zip1982b/my_home/img/2025-02-13_19-43-22.png

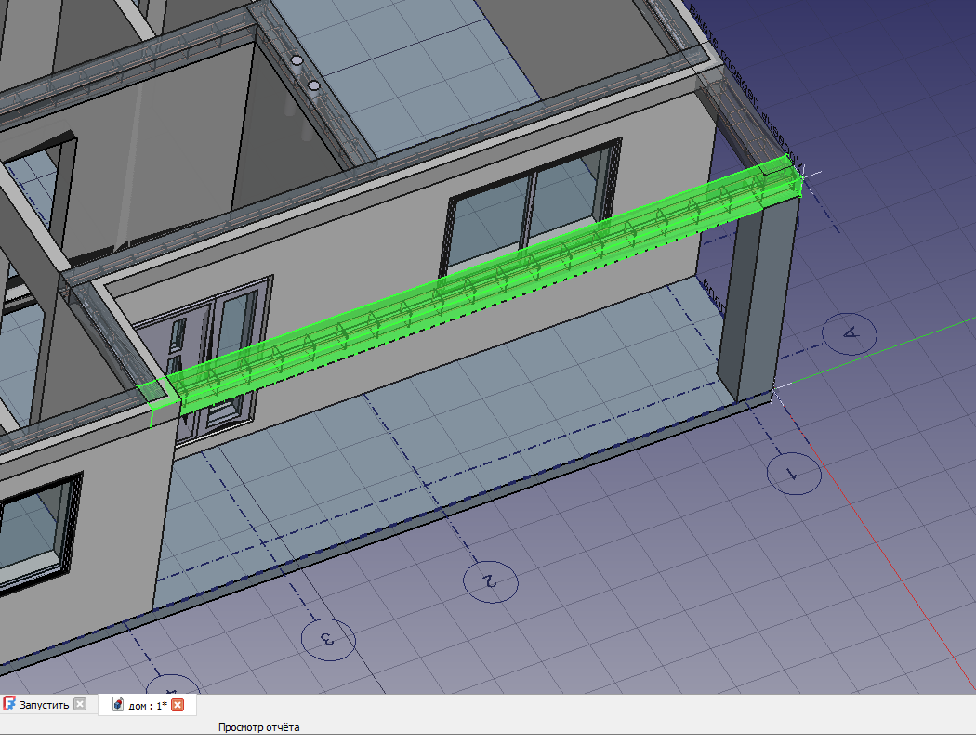
img/2025-02-13_19-43-22.png
