zip1982b/my_home/img/4-1000x1000.jpg

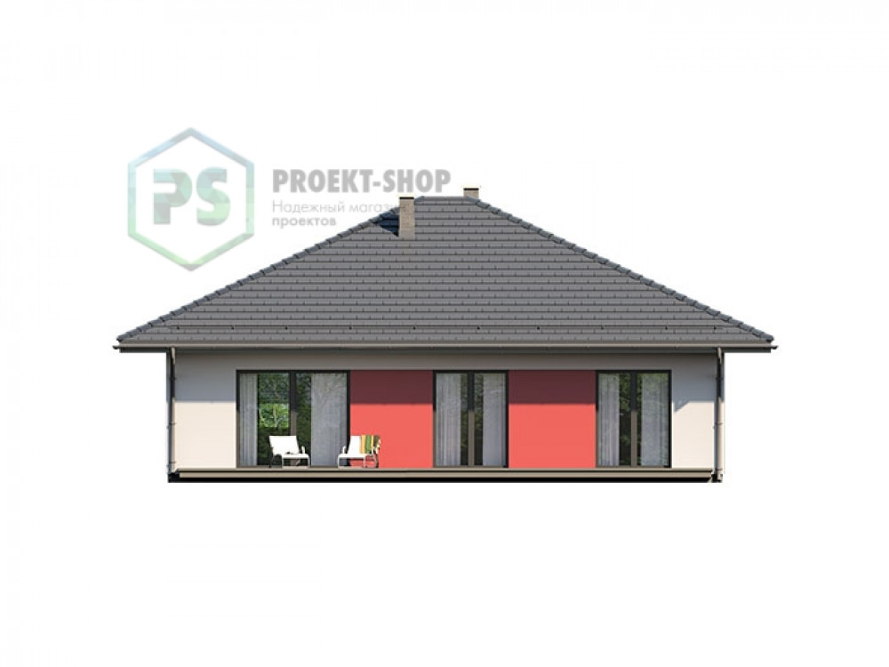
img/4-1000x1000.jpg
