zip1982b/my_home/отопление.docx

с чего начать проектирование системы отопления для одноэтажного дома площадью 139,2 м2 и газовым двухконтурным котлом мощностью 24 КВт? Планируется использовать батарейное отопление в количестве 9 шт по схеме лучевой и теплый пол. Так же в качестве труб для батарейного отопления планируется использовать металопластик. Для теплого пола турба PERT. Дом из газобетона D500 шириной 300 мм. Утеплён пеноплистеролом толщиной 100 мм по системе мокрый фасад.

Проектирование системы отопления всегда начинается с расчета теплопотерь дома. Без этого шага невозможно правильно подобрать длину петель теплого пола и количество секций (или размеры) радиаторов.

Ваш котел мощностью 24 кВт выбран с большим запасом (для дома 139,2 м² с хорошим утеплением обычно достаточно 12–14 кВт), но для двухконтурного котла это стандарт, так как избыточная мощность нужна для быстрого нагрева горячей воды (ГВС).

Ниже представлен пошаговый план, с чего начать и как правильно организовать проектирование.

1. Расчет теплопотерь здания

Хотя стены из газобетона D500 (300 мм) с утеплением пенополистиролом (100 мм) хорошо удерживают тепло, нужно посчитать точные потери через:

- Стены, окна и входные двери.
- Пол (фундамент) и потолок (чердачное перекрытие).
- Вентиляцию (инфильтрацию воздуха).

Результат шага: Вы узнаете, сколько Ватт тепла теряет каждая конкретная комната в самую холодную пятидневку зимы.

2. Проектирование теплого пола и радиаторов

Зная теплопотери каждой комнаты, распределяем нагрузку между теплым полом (ТП) и радиаторами:

- Теплый пол (труба PERT): Рассчитайте шаг укладки (обычно 150 мм, в рантовых зонах у окон — 100 мм). Учтите, что по санитарным нормам температура поверхности пола в жилых зонах не должна превышать 26–29°C. Если тепла от пола не хватает для покрытия теплопотерь комнаты, остаток «добирают» радиаторами.
- Радиаторы (9 шт, металлопластик): Подберите размер каждого радиатора так, чтобы он покрывал дефицит тепла в своей зоне. При лучевой схеме к каждой батарее идет своя независимая пара труб (подача и обратка).

3. Гидравлический расчет и подбор оборудования

Так как у вас комбинированная система (радиаторы + ТП), они работают на разных температурных режимах:

- Радиаторам нужно, например, 60–70°C.
- В теплый пол нельзя подавать больше 40–45°C.

Вам обязательно понадобятся:

- Коллекторный узел для радиаторов: Сюда сойдутся все 9 лучей из металлопластика.
- Коллекторный узел для теплого пола с насосно-смесительным узлом (трехходовым клапаном): Он будет подмешивать остывшую воду из обратки теплого пола в подачу, чтобы снизить температуру до безопасной для стяжки.
- Гидрострелка или балансировочный коллектор: Встроенный насос котла 24 кВт может не справиться с протоком и радиаторов, и контуров теплого пола одновременно. Смесительный узел ТП потребует своего отдельного насоса. Чтобы насосы не конфликтовали, их контуры разделяют.

4. Трассировка и создание схемы

- Нанесите на план дома места установки котла (котельной) и коллекторных шкафов (желательно расположить их по центру дома, чтобы длины лучей были примерно одинаковыми).
- Наметьте трассы раскладки труб ТП (длина одной петли PERT 16 мм не должна превышать 80–100 метров, иначе насосу будет тяжело продавить теплоноситель).
- Наметьте трассы металлопластиковых труб к 9 радиаторам (избегайте стыков в полу — лучевая схема хороша тем, что цельная труба идет от коллектора до самой батареи).

Если вы хотите углубиться в детали, подскажите:

- В каком регионе находится дом (чтобы учесть зимнюю температуру)?
- Какая планируется высота потолков и площадь остекления?
- Вы хотите, чтобы теплый пол был основным отоплением, а радиаторы включались только в сильные морозы, или они должны работать 50/50?

Дом находится в Калининградской области. Высота потолков составляет 275 см. Окон 10 шт. 9 окон 2 камерных. одно окно однокамерное в котельной. По площадям: 6 окон размерами 180см на 150см , 2 окна 90 см на 150 см, одно окно 235 см на 180 см, одно окно 235 на 20 см. Работа должна быть 50/50 теплый пол и радиаторы.

Отличные вводные данные, они позволяют сделать предварительный теплотехнический расчет. Для Калининградской области расчетная температура самой холодной пятидневки составляет всего -16°C (по СНиП «Строительная климатология»). Из-за мягкого морского климата теплопотери вашего дома будут сравнительно небольшими.

Ваш пирог стены (газобетон D500 300 мм + 100 мм ППС) имеет отличный коэффициент сопротивления теплопередаче (\(R \approx 3.7 \, м²\cdot°C/Вт\)), что существенно выше нормативного требования для Калининграда (\(\approx 2.4–2.6\)). Дом получится очень теплым.

1. Ориентировочный расчет теплопотерь

При высоте потолков 2,75 м объем воздуха в доме составляет порядка 383 м³. Суммарная площадь остекления внушительная — 23,6 м² (особенно выделяется панорамное окно \(235 \times 180\) см).

При температуре на улице -16°C и внутри +22°C (дельта 38°C) примерные теплопотери составят:

- Стены, кровля и пол: ~4.5–5 кВт.
- Окна (учитывая, что 9 из них двухкамерные): ~1.8–2 кВт.
- Вентиляция (инфильтрация воздуха): ~2 кВт.
- Итого максимальные теплопотери: около 8.5–9 кВт в самый пик морозов.

Вывод по котлу: Ваш котел на 24 кВт перекрывает пиковые теплопотери дома почти в 3 раза. На отопление он будет работать в режиме глубокой модуляции (на минимальной мощности), что для него абсолютно комфортно, а вся остальная мощность будет мгновенно уходить на приготовление горячей воды.

2. Распределение нагрузки 50 / 50

Так как общие потери составляют около 9 кВт, при схеме 50/50:

- Теплый пол должен отдавать около 4,5 кВт.
- Радиаторы (9 шт) должны суммарно отдавать около 4,5 кВт (в среднем по 500 Вт на один радиатор).

Для теплого пола площадью около 120 м² (за вычетом мебели и котельной) отдать 4,5 кВт — это легкая задача. Потребуется теплоотдача всего 37–40 Вт/м². При такой нагрузке пол никогда не будет «горячим», его температура составит комфортные 23–24°C, что идеально для здоровья и деревянных/ламинатных покрытий.

3. Технические рекомендации по вашей схеме

Радиаторы (9 шт, лучевая схема, металлопластик)

1. Диаметр труб: Для лучевой схемы от коллектора к каждому радиатору используйте металлопластиковую трубу диаметром 16 мм (стенка 2.0). Вести 20-ю трубу к отдельному радиатору мощностью 0.5–1.5 кВт нет никакого гидравлического смысла.
2. Коллектор: Вам нужен радиаторный коллектор на 9 выходов с евроконусами под 16-ю трубу. Выбирайте коллектор со встроенными регулировочными вентилями (чтобы можно было отбалансировать ветки по длине).
3. Подключение окон: Самое большое окно (\(235 \times 180\) см) обязательно потребует под собой мощный радиатор или внутрипольный конвектор, чтобы отсекать холодный фронт воздуха и предотвратить запотевание. Для узкого окна (\(235 \times 20\) см), если оно вертикальное, радиатор ставится рядом.

Теплый пол (труба PERT)

1. Контуры: Разбейте площадь дома на петли длиной не более 70–80 метров каждая (используя трубу PERT 16x2.0). При площади ~130 м² у вас получится ориентировочно 7–8 контуров.
2. Шаг укладки: Вдоль наружных стен и под большими окнами (рантовая зона шириной 1 метр) делайте шаг 100 мм. В основной зоне комнат — 150 мм. В санузлах можно сделать шаг 100 мм по всей площади, чтобы там было теплее (+24...25°C).

Сердце системы (Котельная)

Так как котел двухконтурный и настенный, в нем уже есть свой циркуляционный насос и расширительный бак. Но напрямую подключить к нему ТП и радиаторы нельзя.

- Насосно-смесительный узел (НСУ): Для теплого пола обязателен отдельный узел с трехходовым клапаном и своим насосом. Он будет снижать температуру воды с котловых 60°C до безопасных для пола 35–40°C.
- Гидравлический разделитель (гидрострелка): Настоятельно рекомендуется установить небольшую гидрострелку (или балансировочный коллектор). Насос котла будет качать воду в гидрострелку, а насос радиаторов и насос ТП будут забирать из нее столько тепла, сколько нужно. Без гидрострелки встроенный насос котла и насос смесительного узла ТП будут «давить» друг друга, из-за чего часть комнат может плохо прогреваться.

Чтобы завершить трассировку и составить точную спецификацию оборудования, скажите:

- Где территориально в плане дома будет находиться котельная (в углу дома или ближе к центру)?
- Какое финишное покрытие планируется на полу (плитка, ламинат или кварцвинил)? От этого зависит теплоотдача труб PERT.
- Требуется ли вам помощь в расчете количества секций радиаторов для конкретных комнат?

котельная будет на западной стороне дома, примерно посередине длины дома. В кухне-гостиной покрытие будет плитка керамогранитная скорее всего. В 3 спальнях кварцвинил. В коридоре и котельной тоже плитка. В кухне-гостиной 3 окна 180х150 и 1 окно 235х180. В 3 спальнях по одному окну 180х150. В санузле 1 окно 90х150. В котельной 1 окно 90х150 с одной камерой. рассчитай пожалуйста количество секций радиаторов.

Расположение котельной на западной стороне посередине дома — идеальный вариант. Это позволит разместить коллекторные шкафы централизованно, минимизировать длину транзитных труб и сделать контуры теплого пола примерно одинаковыми по длине.

Для расчета секций радиаторов мы принимаем стандартные биметаллические или алюминиевые секции с межосевым расстоянием 500 мм (высота радиатора ~56-57 см). При работе в комбинированной системе отопления 50/50 теплоноситель в радиаторы подается не в экстремальном режиме (например, 65°C на подаче), поэтому реальная теплоотдача одной секции составит порядка 110–120 Вт.

Ниже приведен расчет распределения 9 радиаторов по вашим помещениям с учетом финишного покрытия и площади окон.

Расчет секций радиаторов по комнатам

Помещение | Окна и особенности | Покрытие пола | Кол-во радиаторов | Секций на 1 радиатор | Всего секций на комнату
Кухня-гостиная | 3 окна 180×150 см 1 панорамное 235×180 см | Керамогранит (отличная теплоотдача ТП) | 4 шт | Под 180×150: 10 секций (3 шт) Под 235×180: 14 секций (1 шт) | 44 секции
Спальня 1 | 1 окно 180×150 см | Кварцвинил (теплоотдача ТП ниже) | 1 шт | 12 секций | 12 секций
Спальня 2 | 1 окно 180×150 см | Кварцвинил | 1 шт | 12 секций | 12 секций
Спальня 3 | 1 окно 180×150 см | Кварцвинил | 1 шт | 12 секций | 12 секций
Санузел | 1 окно 90×150 см | Керамогранит | 1 шт | 6 секций | 6 секций
Котельная | 1 окно 90×150 см (1-камерное) | Керамогранит | 1 шт | 8 секций | 8 секций
Итого по дому | 10 окон | | 9 шт | | 94 секции

Важные нюансы по комнатам:

1. Кухня-гостиная (44 секции): Керамогранит идеально прогревается теплым полом и будет отдавать максимум тепла. Однако суммарная площадь остекления в этой зоне огромная (12.3 м²). Под каждое стандартное окно ставим по 10 секций (длина радиатора ~80 см) для перекрытия холодного потока. Под панорамное окно ставим низкий, но длинный радиатор на 14 секций (или аналогичный по мощности стальной панельный радиатор 22 типа), чтобы окно не «плакало».
2. Спальни (по 12 секций): Кварцвинил обладает повышенным тепловым сопротивлением (пропускает тепло хуже плитки). Поэтому нагрузку на радиаторы в спальнях мы намеренно немного увеличили (12 секций вместо 10). Это гарантирует, что в спальнях будет тепло, а теплый пол можно будет держать в комфортном, слегка прогретом режиме.
3. Санузел (6 секций): Здесь радиатор на 6 секций выполняет вспомогательную роль. Основное тепло даст теплый пол (уложенный с шагом 100 мм) и полотенцесушитель.
4. Котельная (8 секций): Однокамерное окно будет давать повышенные теплопотери. Тёплый пол в котельной обычно укладывается скудно (из-за оборудования на полу). Поэтому радиатор на 8 секций обязателен для компенсации холода от окна.

Альтернатива: Стальные панельные радиаторы

Если вы еще не купили секционные батареи, рассмотрите стальные панельные радиаторы (Тип 22). Для лучевой схемы они подходят лучше секционных:

- Их подбирают точно по ширине оконного проема (для окна шириной 180 см идеально встает радиатор длиной 120–140 см). Они перекрывают не менее 70-75% ширины окна, что исключает появление сквозняков по бокам от подоконника.
- Под стандартные окна 180×150 см подойдут стальные радиаторы типа 22 высотой 500 мм и длиной 1200 мм.
- Под панорамное окно 235×180 см отлично подойдет низкий радиатор типа 22 или 33 высотой 300 мм и длиной 1600–1800 мм.

Подскажите, вы планируете покупать секционные радиаторы (алюминий/биметалл) или рассматриваете стальные панельные? Я могу помочь пересчитать этот же объем в точные типоразмеры стальных панелей, если необходимо.
