zip1982b/my_home/электрика.docx

### Выбор вводного автомата: 3P или 4P?

Для вашей схемы с трехфазным вводом (3 фазы, N, PE) и однофазными потребителями, я рекомендую установить в доме четырехполюсный (4P) вводной автомат на 25А.

Вот почему это важно:

- Безопасность при обслуживании: 4P автомат разрывает не только все три фазы, но и рабочий ноль (N). Это гарантирует, что при отключении вводного автомата для ремонта, вы полностью обесточиваете внутреннюю сеть дома. В вашей системе TN-C-S (с разделенными N и PE) это правильное и безопасное решение.
- Селективность: Так как в уличном щите у вас стоит автомат C25, в доме должен стоять точно такой же (или меньший номинал, но 25А — оптимально). Это обеспечит селективность: при перегрузке или КЗ в доме отключится сначала внутренний автомат, а уличный останется включенным, не обесточивая весь дом.

### ⚙️ Рекомендации по реле контроля напряжения (РКН)

Для каждой из трех фаз вам понадобится однофазное РКН, так как все потребители у вас однофазные. Оно будет контролировать напряжение на каждой фазе и при выходе за пределы нормы отключать именно эту фазу, не затрагивая другие.

Вот несколько надежных марок, которые можно рассмотреть:

- WELROK: Серия D6-x (например, D6-40) — популярное решение для частных домов, хорошо зарекомендовавшее себя на рынке.
- MEANDR (Меандр): Один из ведущих российских производителей. Модели РКН-1-x-15 — надежны и имеют все необходимые настройки.
- Novatek (Новатек): Еще один известный российский бренд, выпускающий широкий ассортимент модульной автоматики для дома.

Обратите внимание, что РКН обычно занимает 1 модуль на DIN-рейке и не требует дополнительного питания.

### 📐 Вариант компоновки щита (3 DIN-рейки)

Ниже представлена логическая схема размещения. Она предполагает, что слева на рейке у вас будет располагаться ввод, а все групповые автоматы — справа. Ширина одного модуля — 17.5 мм.

DIN-рейка | Позиция (слева направо) | Устройство | Кол-во модулей | Примечание
Верхняя | 1 | Вводной автомат 4P C25 | 4 | Самый левый, как главный выключатель
| 5 | Реле напряжения (РКН) на L1 | 1 | Контролирует 1 фазу.
| 6 | Реле напряжения (РКН) на L2 | 1 | Контролирует 2 фазу.
| 7 | Реле напряжения (РКН) на L3 | 1 | Контролирует 3 фазу.
Средняя
Нижняя
