zip1982b/my_home/двери окна.docx

Окна и двери.

Наименование | Высота (см.) | Ширина (см.) | Количество (шт.) | Примечание
Проём под окно | 150 | 180 | 6 | Окна двухкамерные, двухстворчатые, открывающиеся. Цвет с улицы: Антрацит или RAL7024(Графитовый серый).
Проём под входную дверь | 210 | 160 | 1 | Дверь левая, с боковым окном.
Проём для малых окон | 150 | 90 | 2 | Окна одностворчатые. Цвет с улицы: Антрацит или RAL7024.
| | | | Тех. помещение (для газовой службы – вышибное окно). | Ванная комната окно двухкамерное, открывающееся.
Проём для окна-двери на террасу. | 235 | 180 | 1 | Окно-дверь двухстворчатое, двухкамерное, откр. Цвет с улицы: Антрацит или RAL7024(Графитовый серый).
