zip1982b/my_home/pdf/теплотехнический расчёт утепления ппс-16ф 100мм.pdf

https://https://calcstroy.ru/teplotekhnika/teplotekhnicheskij-raschet

## РАСЧЕТ УТЕПЛЕНИЯ ПОМЕЩЕНИЙ

ИСХОДНЫЕ ДАННЫЕ

Страна | Россия
Область | Калининградск
ая область

Населенный
пункт

Калининград

Тип помещений | Жилые,
гостиницы и
общежития
Тип конструкции | Наружные
стены

Влажность
внутри, %

55

Температура
внутри, °С

20

КЛИМАТИЧЕСКИЕ ПАРАМЕТРЫ

Кол-во градусо-суток
отопительного
периода (ГСОП),
°С·сут

3515.6

Температура
холодной
пятидневки с
обеспеченностью
0.92

-18

Продолжительно
сть
отопительного
периода

188

Средняя
температура
воздуха
отопительного

1.3

Месяц | t, °C | E, (гПа)
Январь | -2.3 | 4.9
Февраль | -1.5 | 4.9
Март | 1.9 | 5.6
Апрель | 7 | 7.2
Май | 12.4 | 10.2
Июнь | 15.7 | 12.9
Июль | 17.9 | 15.4
Август | 17.4 | 15.1
Сентябрь | 13.1 | 12.2

периода

Относительная
влажность
воздуха
наиболее
холодного
месяца

86

a | 0.00035
b | 1.4
Коэффициент теплоотдачи наружной поверхности α(ext) | 23

Коэффициент
теплоотдачи
внутренней
поверхности
α(int)

8.7

Нормируемый
температурный
перепад -Δt(n)

4

Условия
эксплуатации
помещения

А

Октябрь | 8.3 | 9.4
Ноябрь | 3.6 | 7.1
Декабрь | -0.1 | 5.7
Год | 7.8 | 9.2

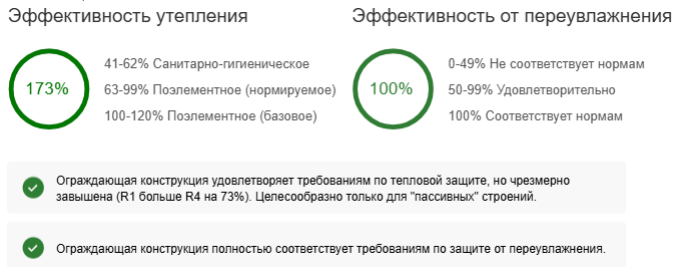
[picture p7: figure]

РЕЗУЛЬТАТ РАСЧЕТА

Термическое сопротивление | (м²•˚С)/Вт
Базовое значение поэлементных требований [R4] | 2.63
Сопротивление теплопередаче ограждающей конструкции [R1] | 5
Санитарно-гигиенические требования [R2] | 1.09
Нормируемое значение поэлементных требований [R3] | 1.66
Сопротивление паропроницанию | (м²*ч*Па)/мг
Сопротивление паропроницанию от внутренней поверхности конструкции до плоскости максимального увлажнения [Rп] | 3.8
Недопустимость влагонакопления в ограждающей конструкции за год эксплуатации [Rп1] | 0.06
Ограничение влаги в ограждающей конструкции за период с отрицательными среднемесячными температурами наружного воздуха [Rп2] | 0.98

888

Теплопотери | Вт•ч
Потери тепла через 1 м² за 1 час при температуре самой холодной пятидневки кВт/ч | 7.6
Потери тепла через 1 м² за отопительный сезон кВт/ч | 16874.88

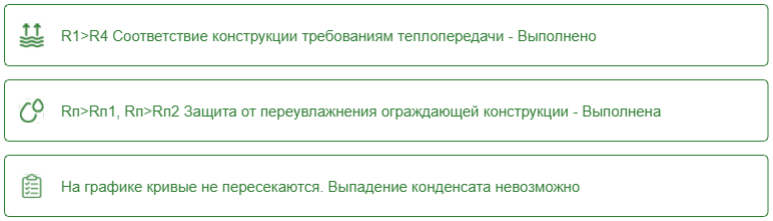
[picture p8: figure]

Powered by TCPDF (www.tcpdf.org)

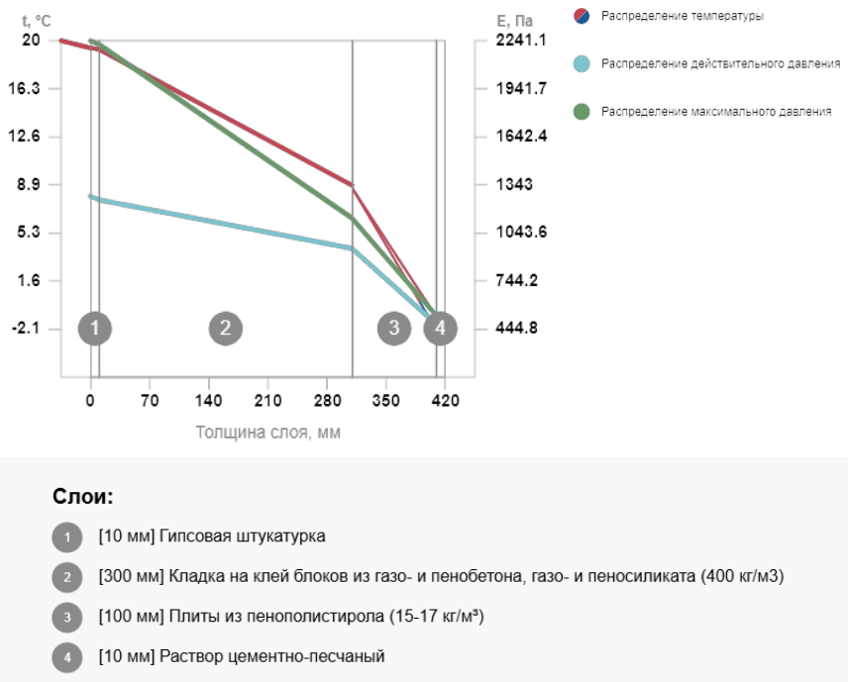
[picture p9: figure]
