zip1982b/my_home/img/2026-04-06_001.pdf

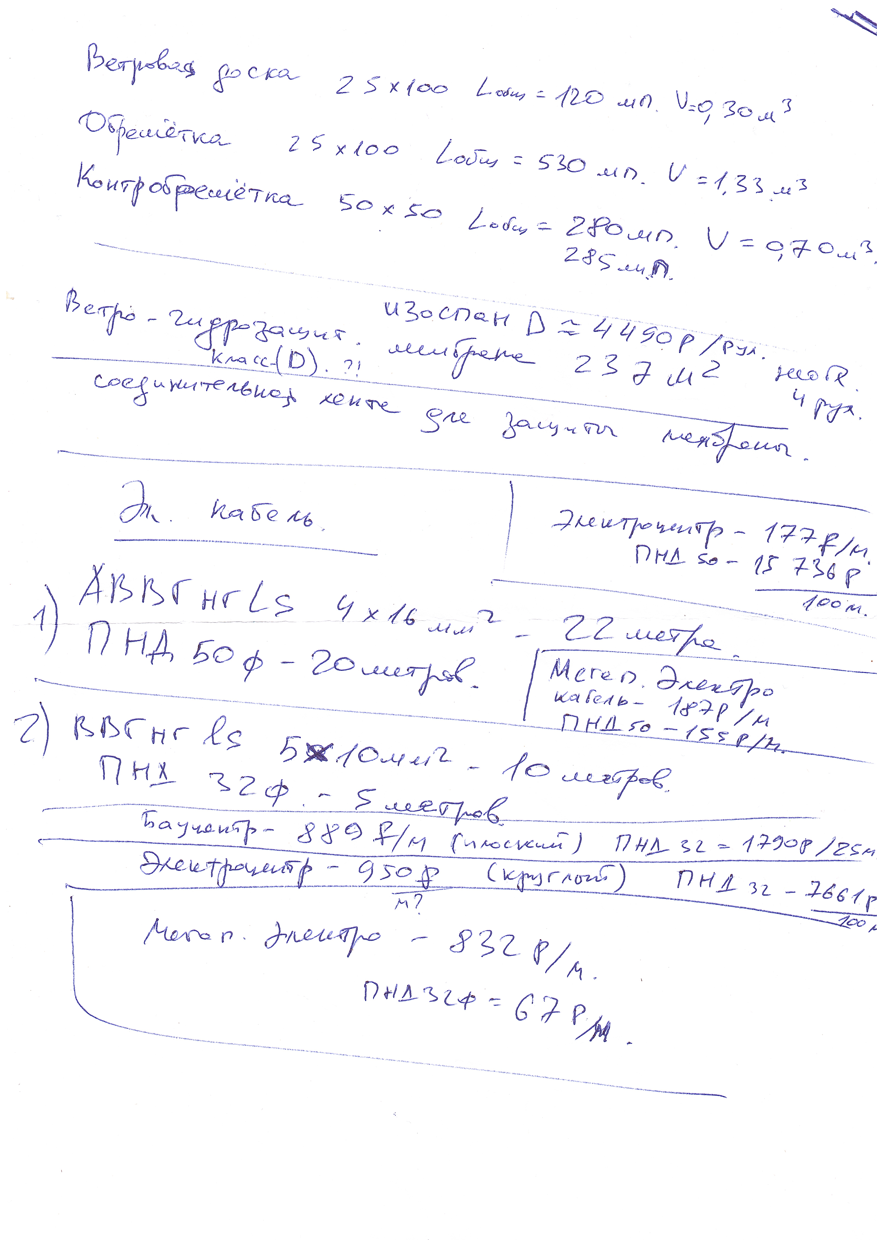
[picture p10: page 1]
