zip1982b/my_home/pdf/план свай и ямы.pdf

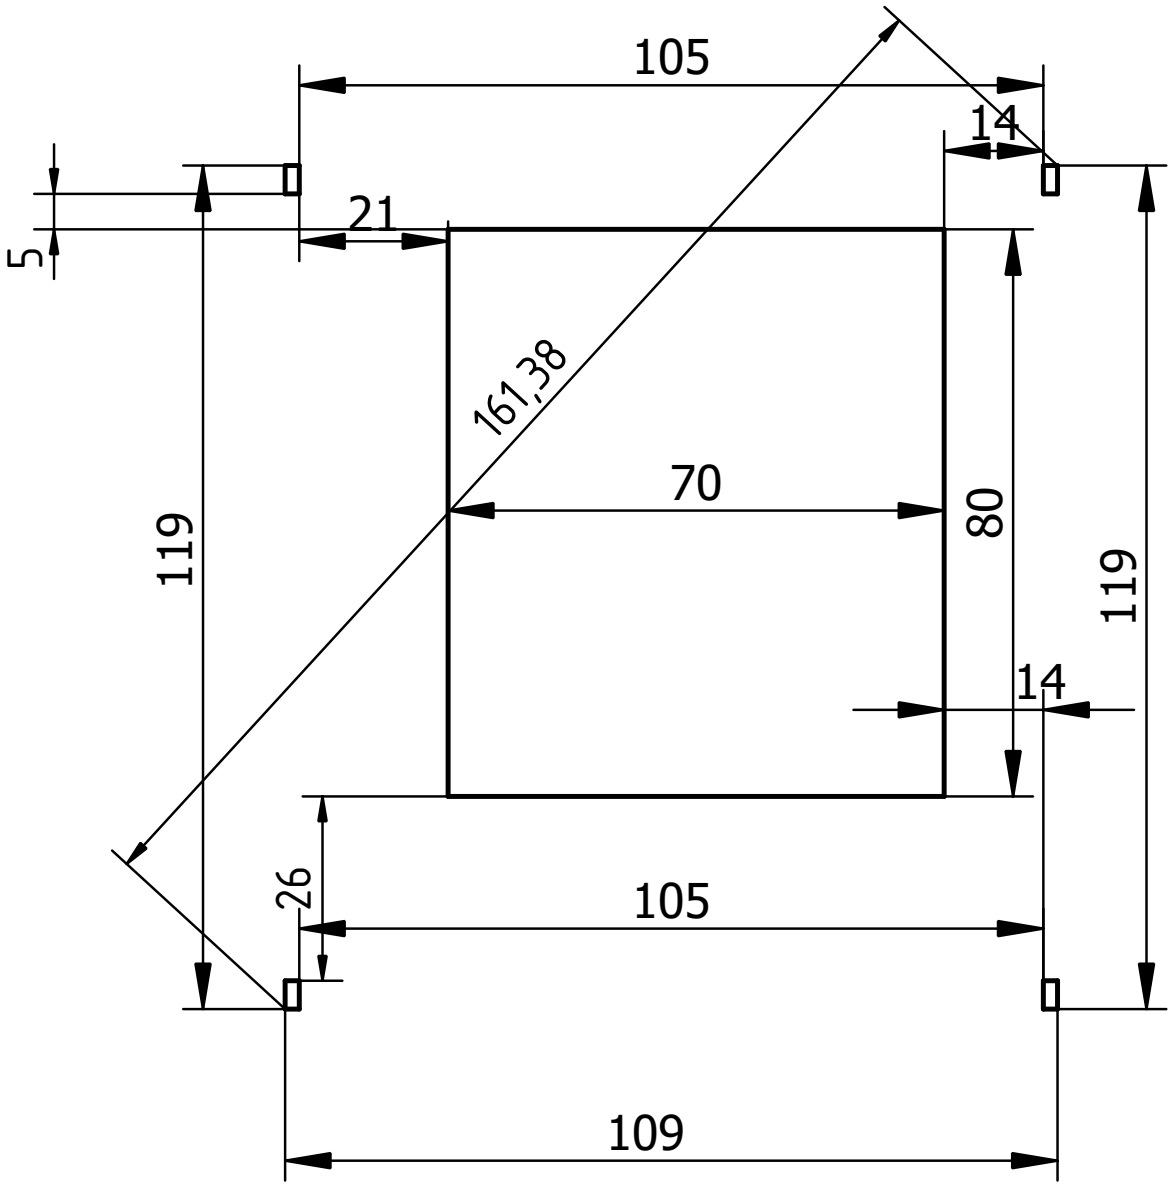
[picture p11: figure]
