zip1982b/my_home/pdf/План туалета.pdf

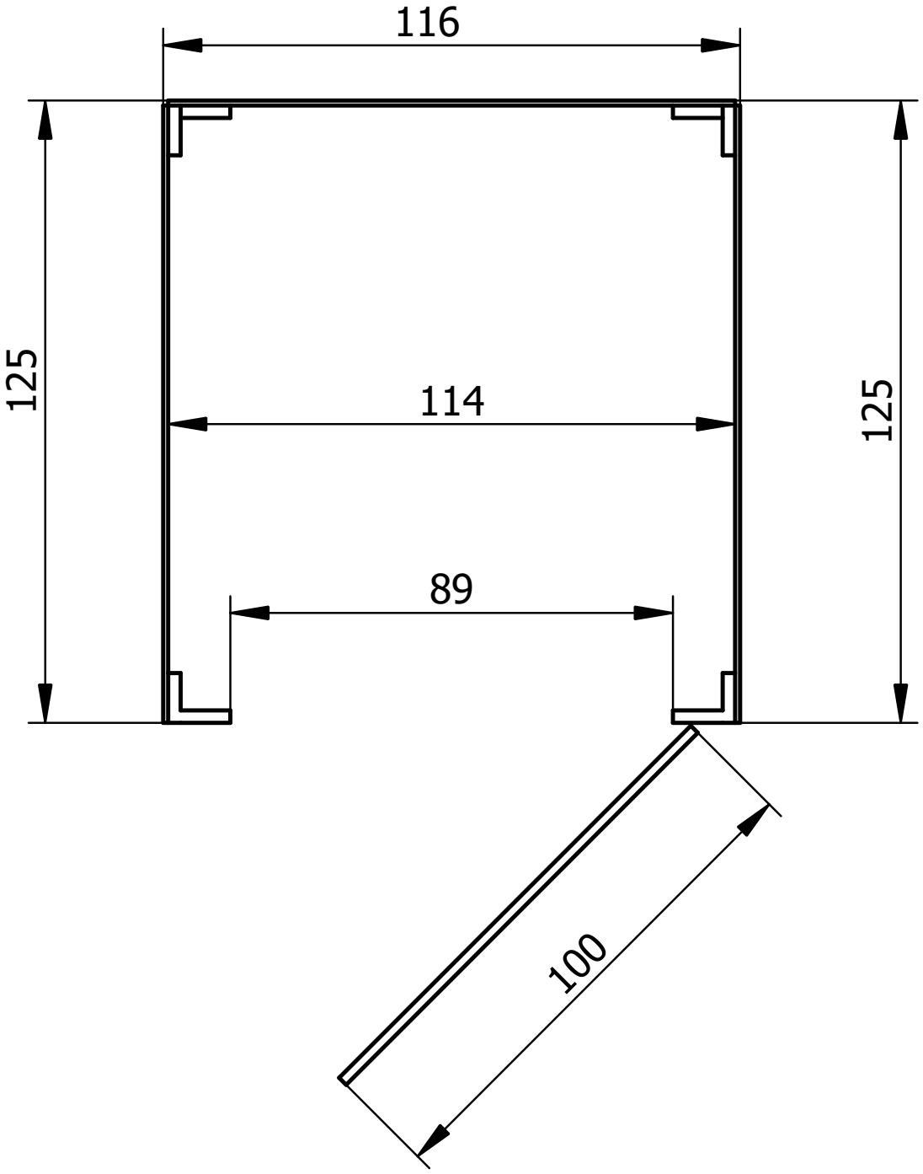
[picture p12: figure]
