zip1982b/my_home/img/1-1000x1000.jpg

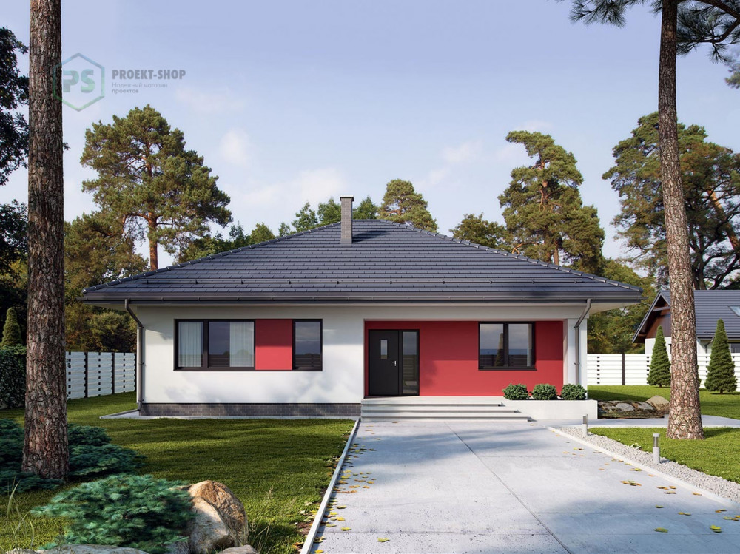
img/1-1000x1000.jpg
