zip1982b/my_home/img/3-1000x1000.jpg

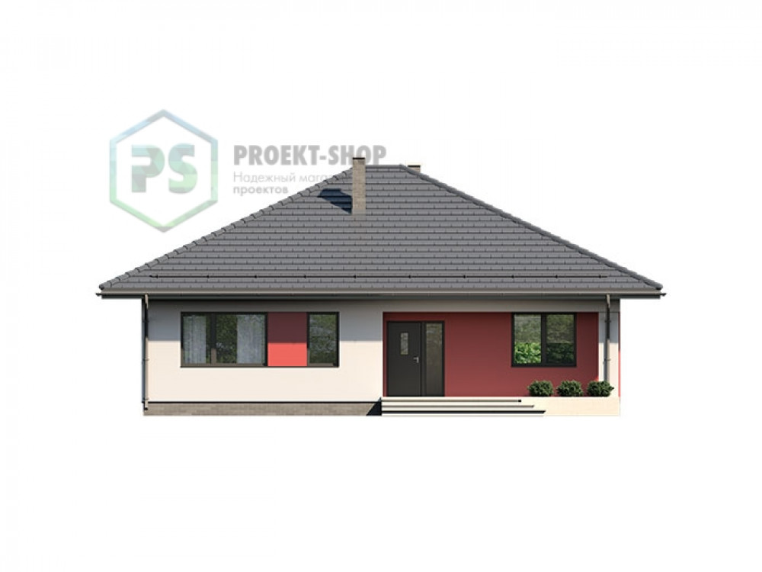
img/3-1000x1000.jpg
