zip1982b/my_home/img/6-1000x1000.jpg

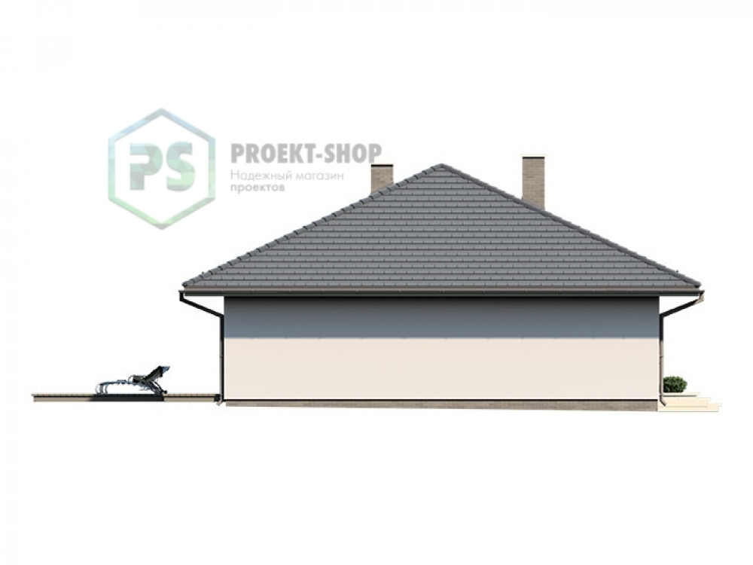
img/6-1000x1000.jpg
