zip1982b/my_home/img/2026-07-23_002.jpg

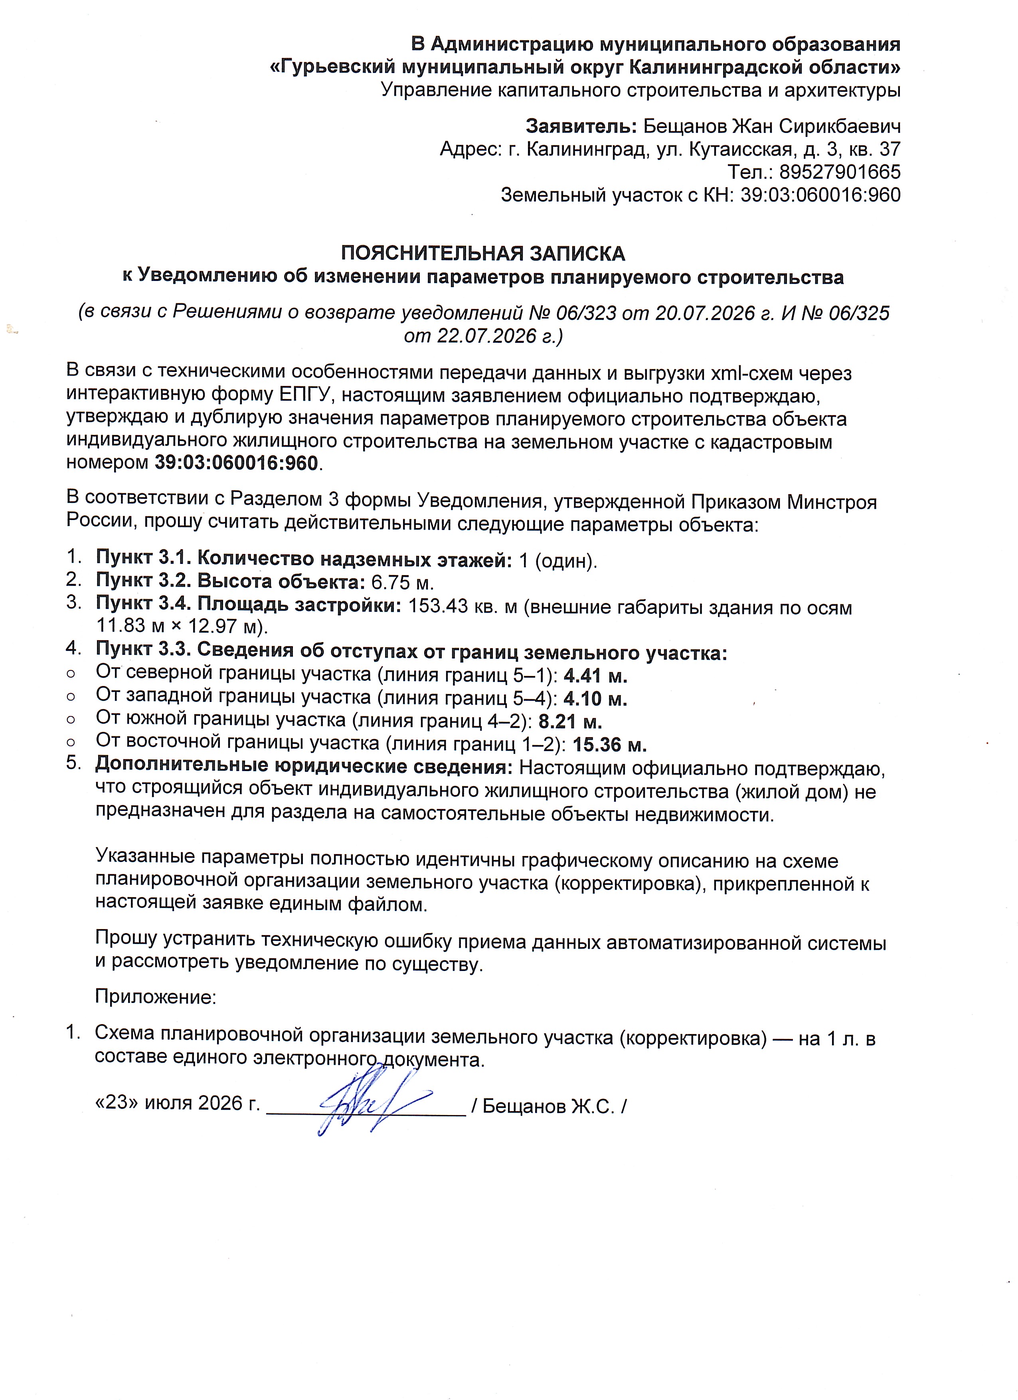
img/2026-07-23_002.jpg
