zip1982b/my_home/img/plan.jpg

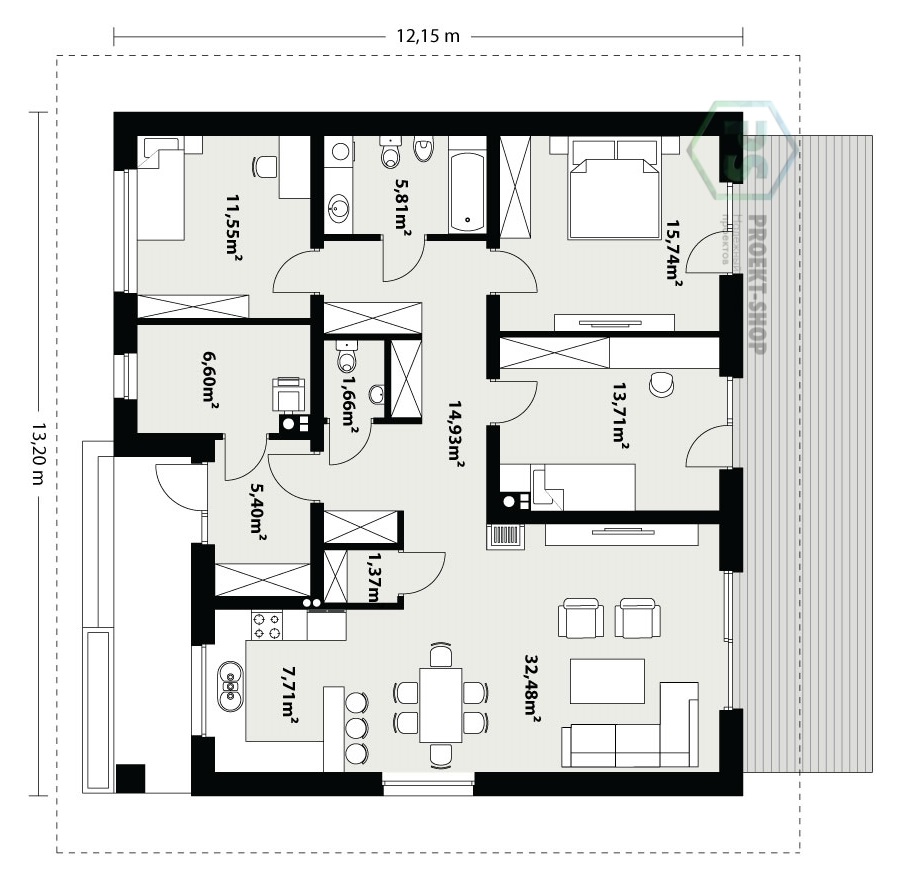
img/plan.jpg
