zip1982b/my_home/img/ВРУ улица.jpg

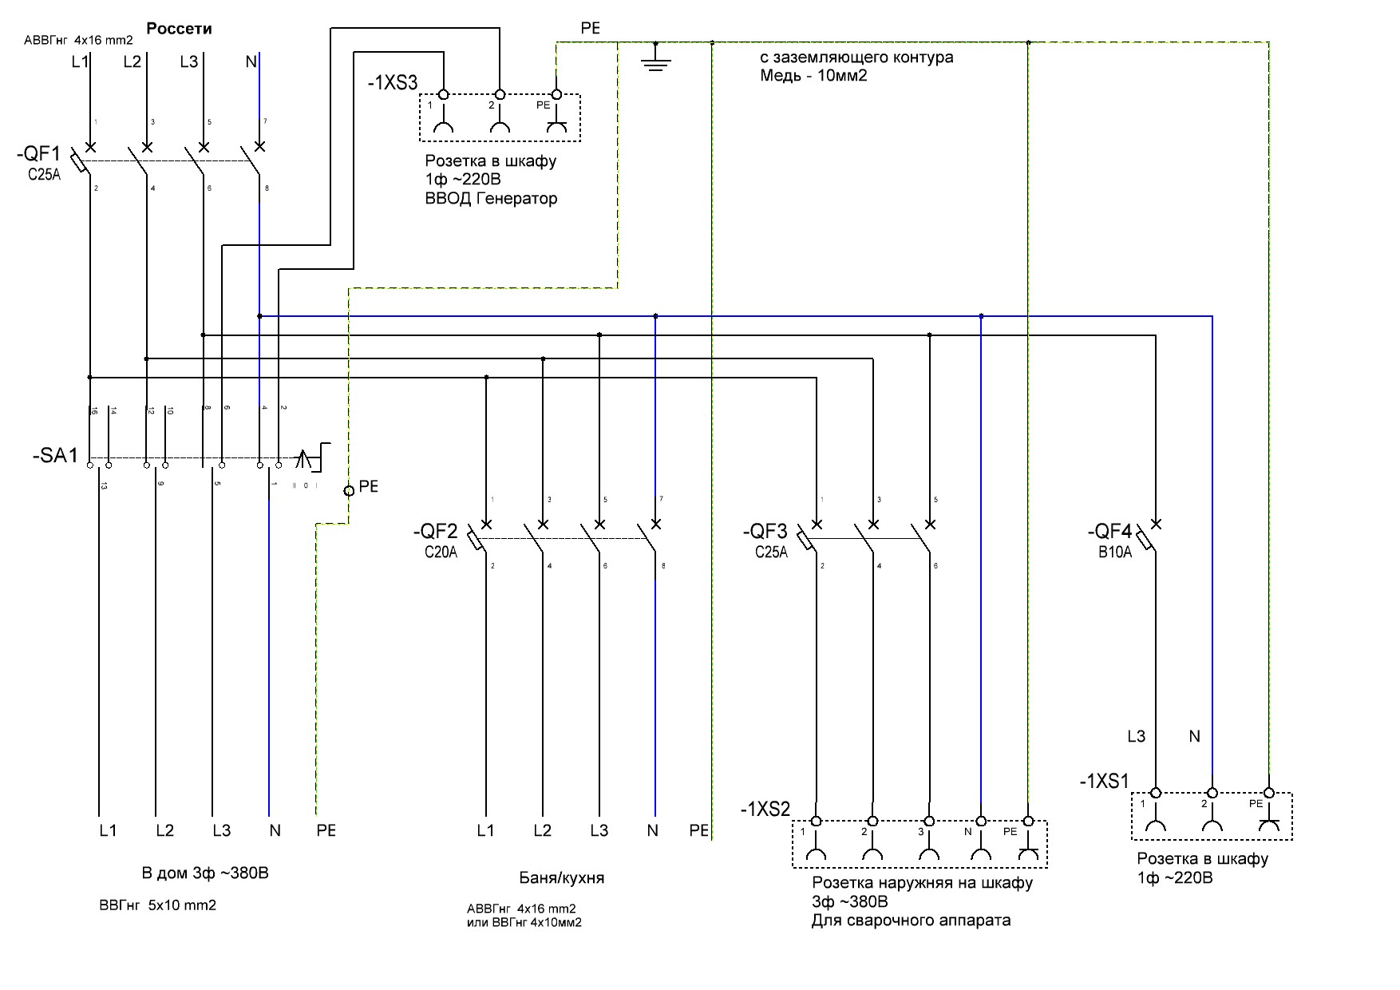
img/ВРУ улица.jpg
