zip1982b/my_home/img/высоты фундамента.jpg

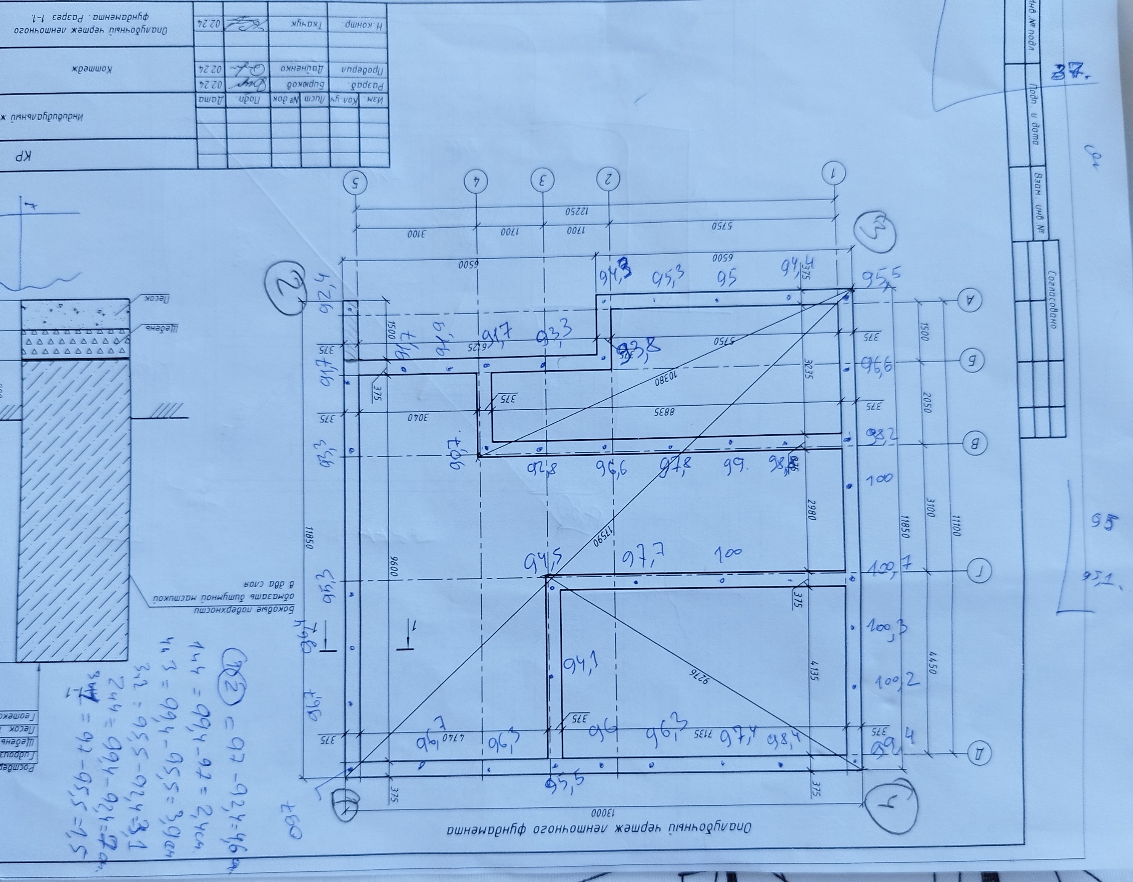
img/высоты фундамента.jpg
