zip1982b/my_home/img/высоты.jpg

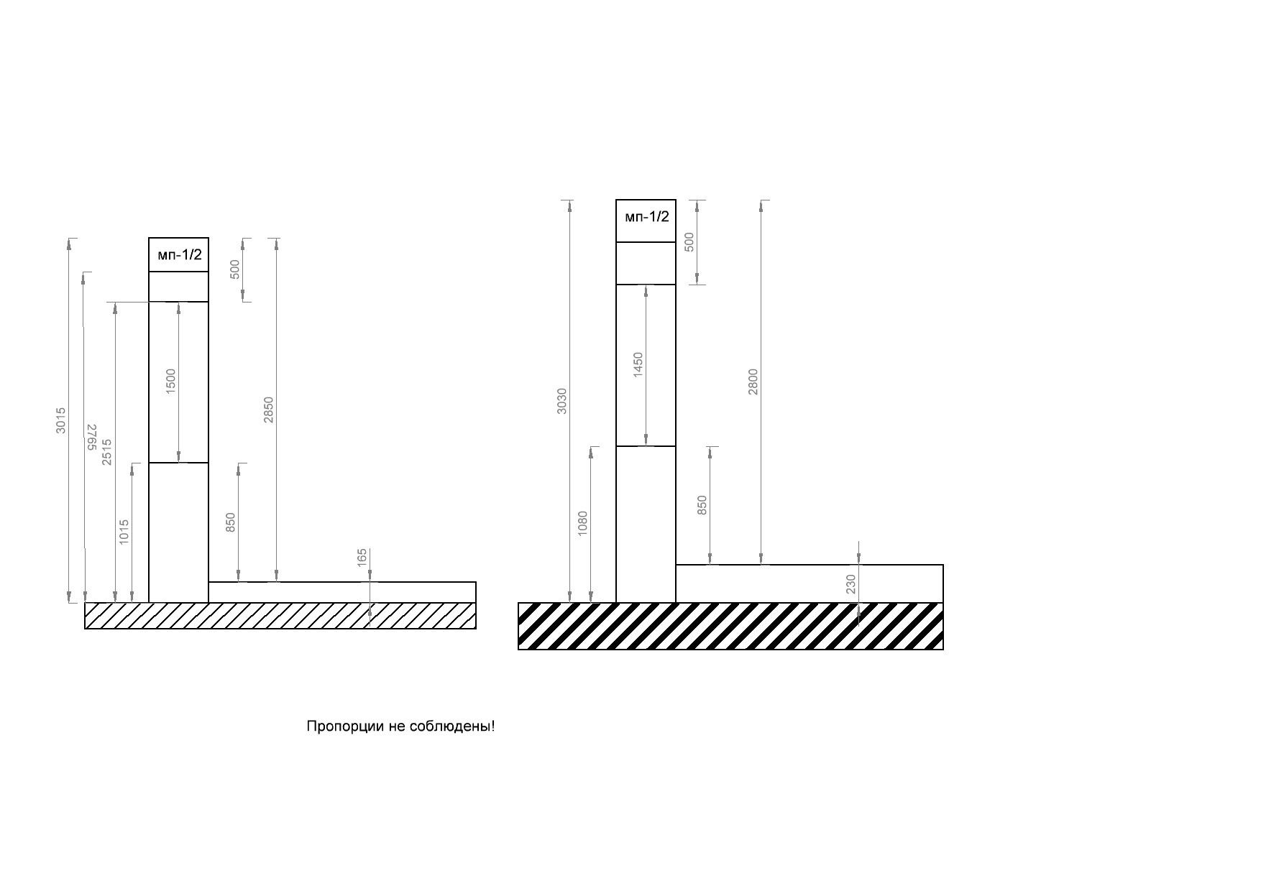
img/высоты.jpg
