zip1982b/my_home/img/окна и двери .jpg

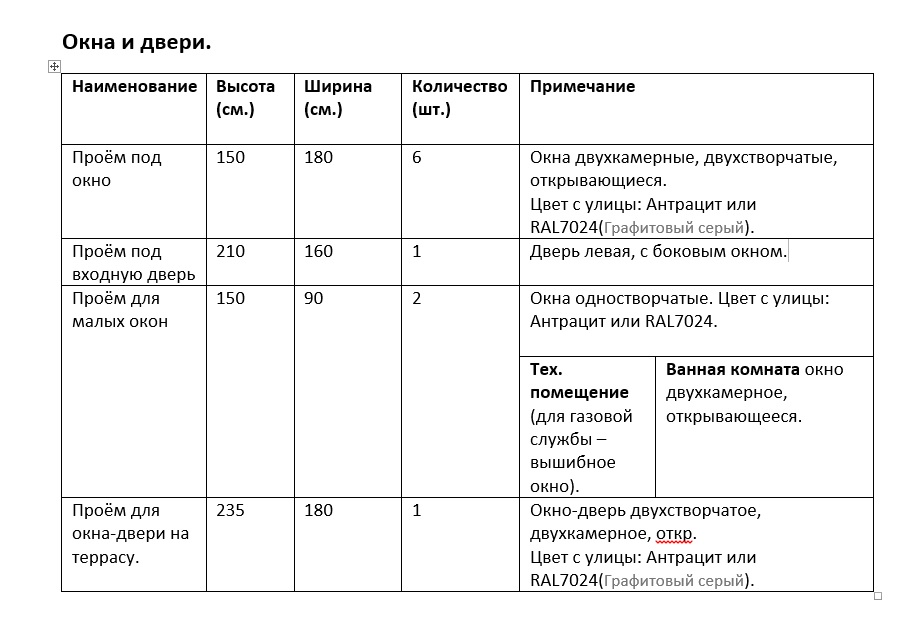
img/окна и двери .jpg
