zip1982b/my_home/img/электричество L1.jpg

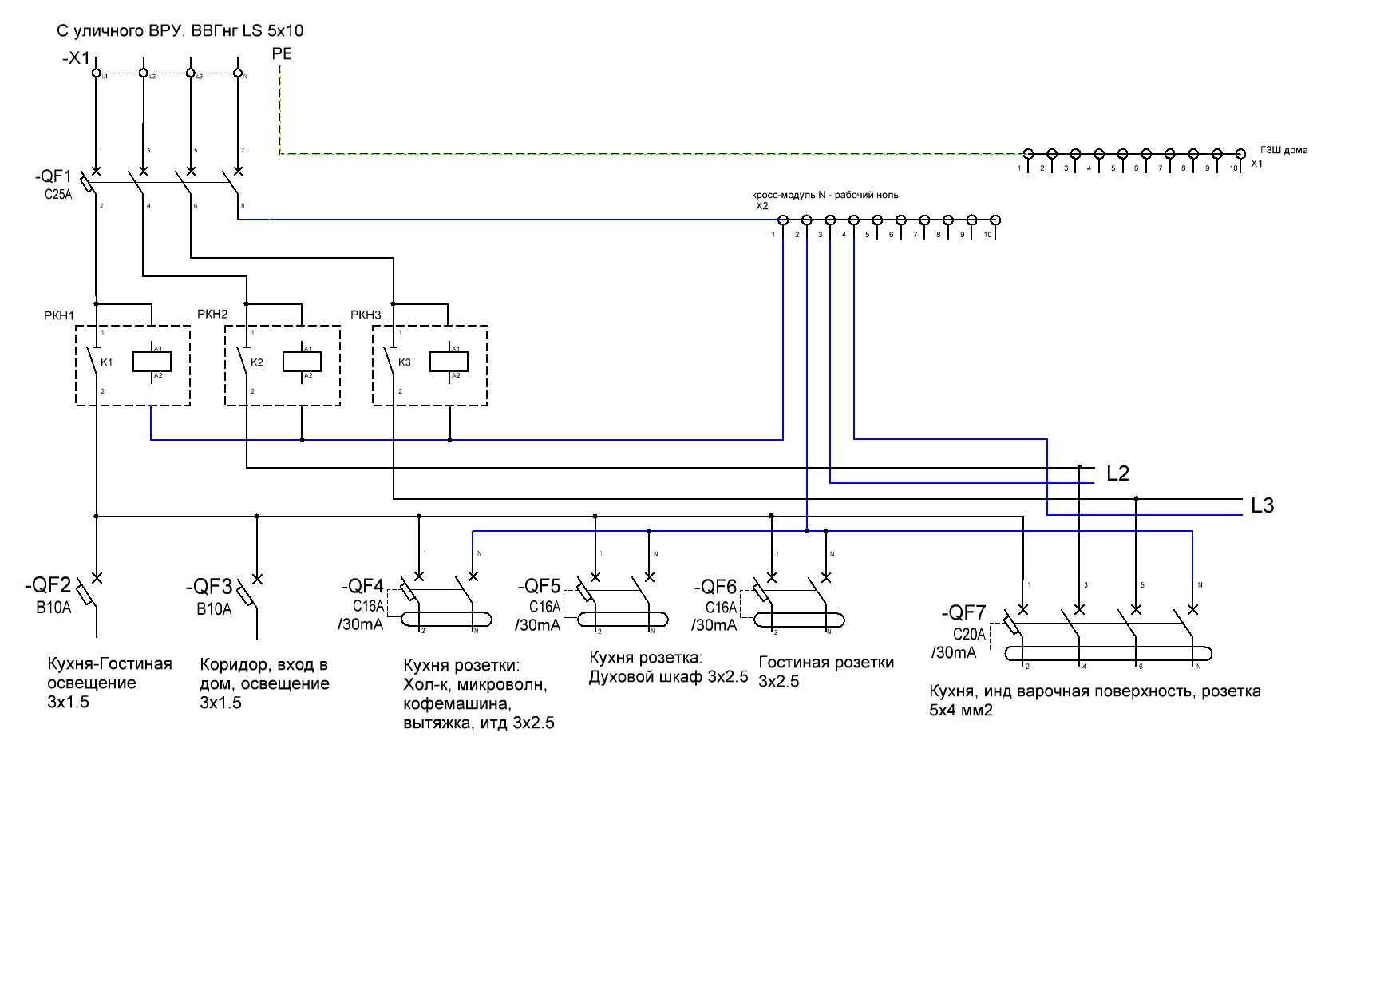
img/электричество L1.jpg
