zip1982b/my_home/img/электричество L2.jpg

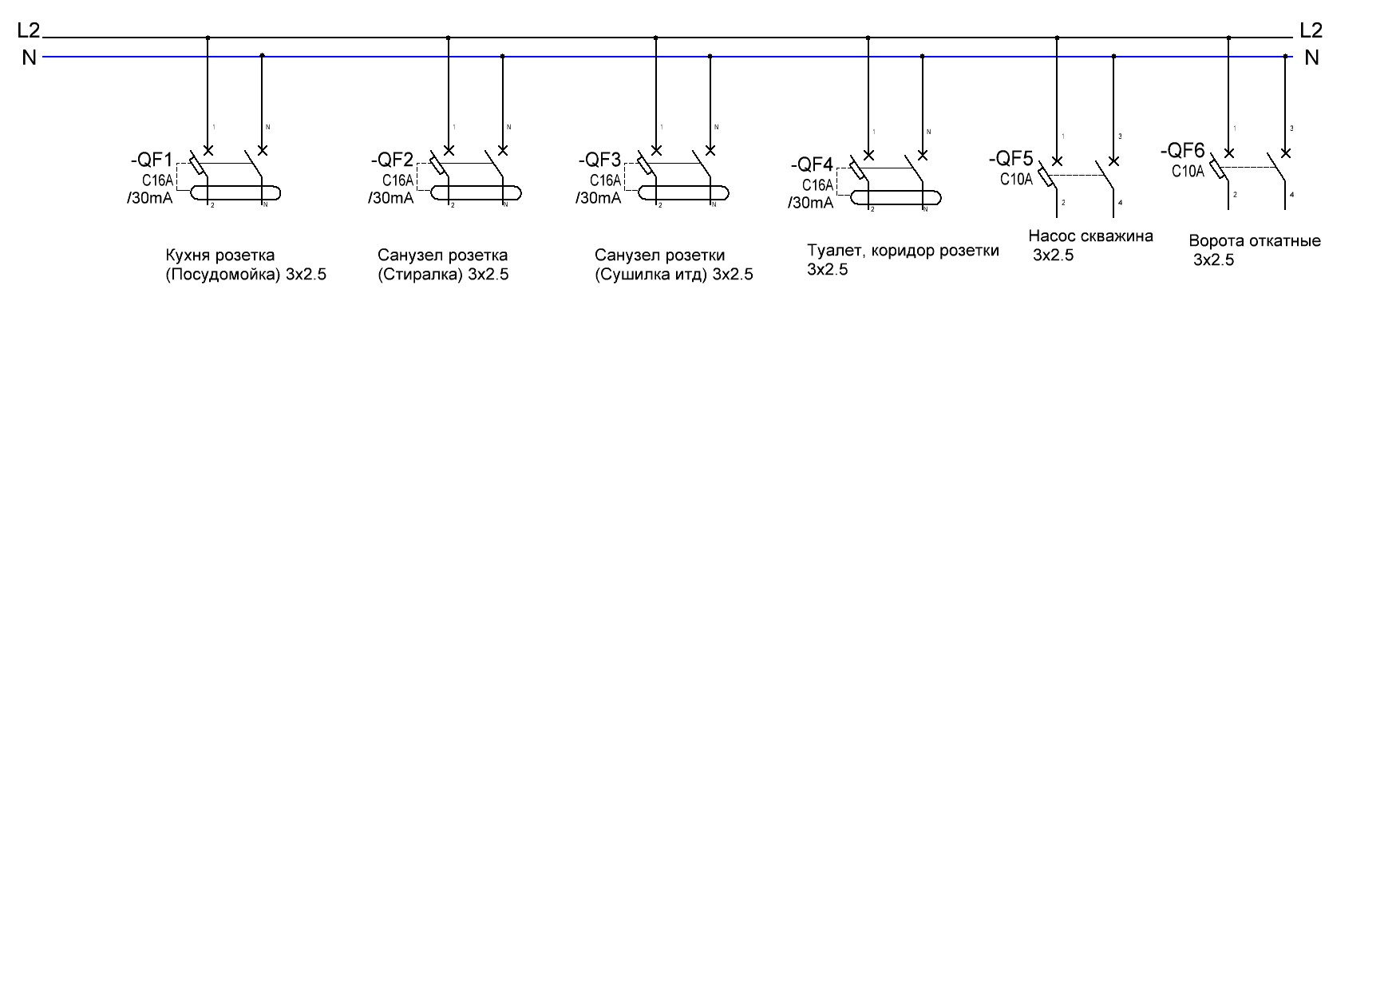
img/электричество L2.jpg
