zip1982b/my_home/img/электричество L3.jpg

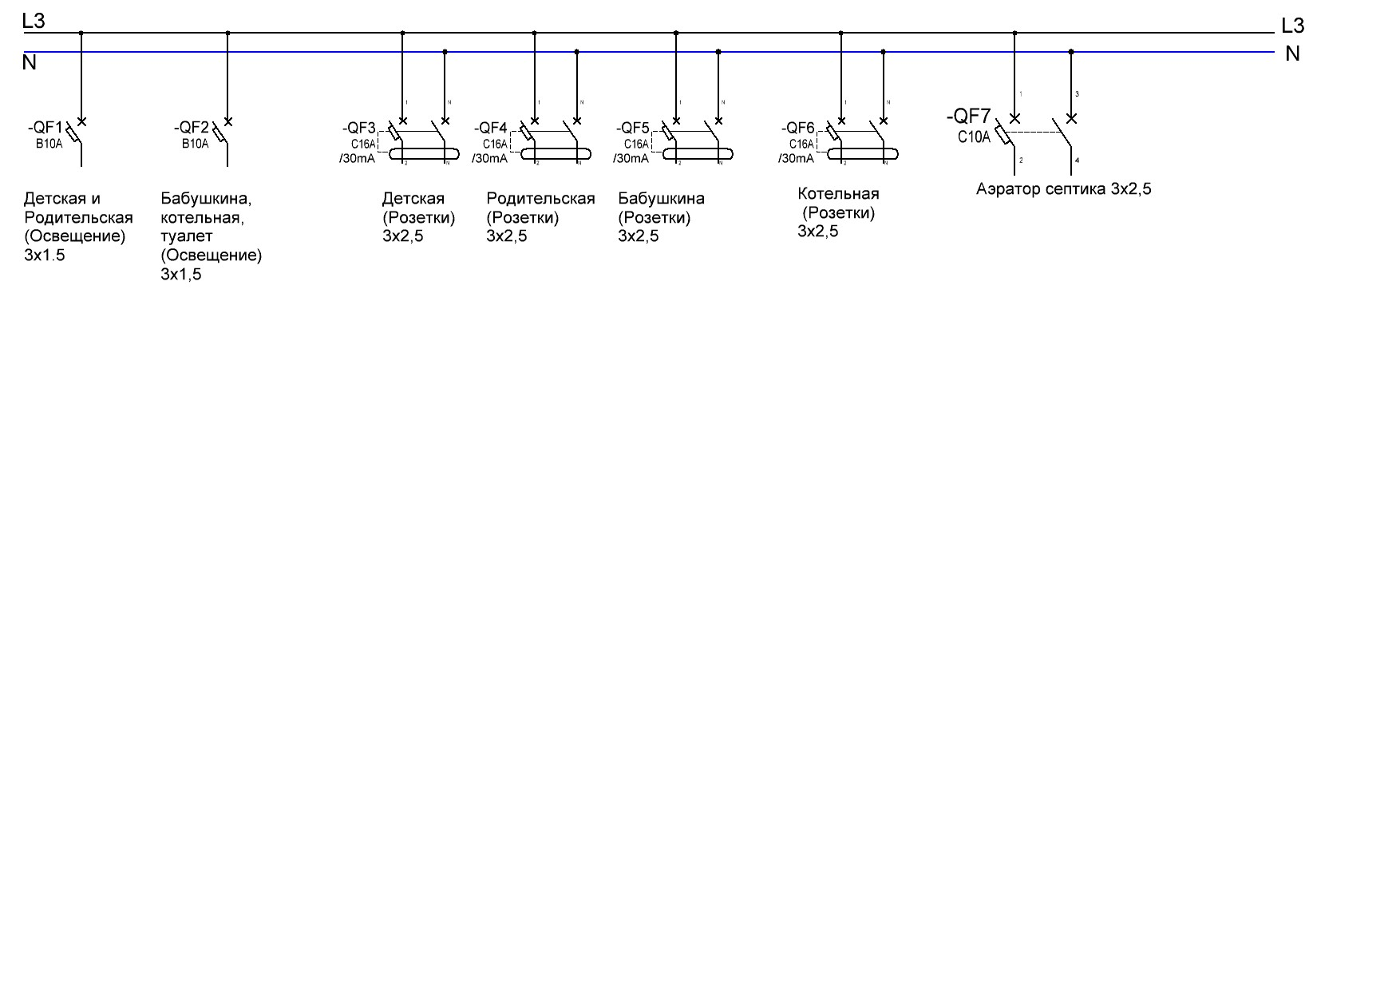
img/электричество L3.jpg
