zip1982b/my_home/pdf/участок-дом.jpg

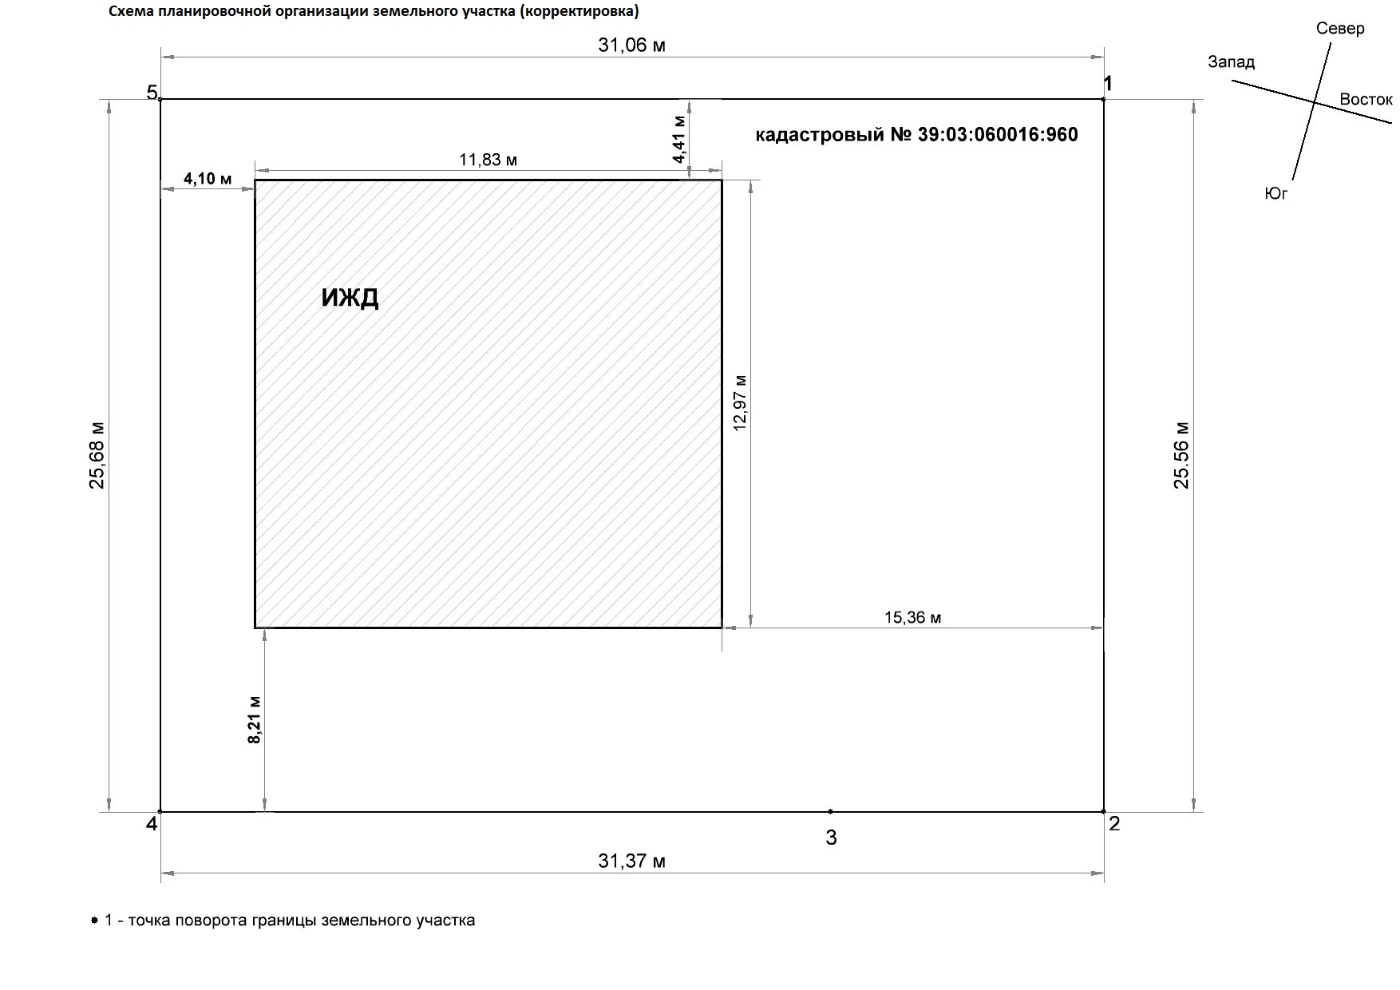
pdf/участок-дом.jpg
