zip1982b/my_home/6-131.xlsx

Sheet: Расчёт колличества бетона
 | Южная сторона (м) | Северная сторона (м) | Восточная сторона (м) | Западная сторона (м) | внутр. Западная (м) | внутр. Восточная (м) | Итого (м3)
длина | 11.85 | 11.85 | 13 | 14.5 | 11.6 | 11.9
ширина | 0.4 | 0.4 | 0.4 | 0.4 | 0.35 | 0.35
высота | 1.05 | 1.05 | 1.05 | 1.05 | 1.05 | 1.05
Объём (м3) | 4.977 | 4.977 | 5.46 | 6.09 | 4.263 | 4.37325 | 30.14025

Sheet: Покупки для дома
 | Стройка дома
№ п/п | Наименование | Цена (руб) | Примечание | дата
1 | Земельный участок | 1040000.00 р. | 8 соток | 2023-12-27
2 | Арматура 12 мм | 2000.00 р. | на колья разметки периметра земельного участка и петна застройки дома
3 | Вынос границ земельного участка | 4000.00 р. | есть акт проведённых работ
4 | Проект одноэтажного дома | 41000.00 р. | 6-131
5 | Грузовик песка | 10000.00 р. | 25-28 тонн
6 | оформление покупки земельного участка у нотариуса | 15000.00 р.
7 | Грабли | 300.00 р. | 1 шт
8 | Договор с Росссети Янтарь на технологическое подключение | 139448.70 р. | ДОГОВОР № 1740/02/24
9 | Невилир с треногой и линейкой | 12000.00 р. | б/у на Авито
10 | Лазерный невилир | 3348.00 р. | АлиЭкспресс
11 | Арматура стеклопластиковая 8 мм - 3 шт | 216.96 р. | Для кольев (разметка фумента) | 2024-03-10
12 | Фиксатор арматуры | 1112.52 р. | Звёздочка 35 мм (6 упаковок - 300 шт) | 2024-03-10
13 | шнур полиамидный кручённый | 280.58 р. | 100 метров - для разметки фундамента | 2024-03-10
14 | Перчатки рабочие | 155.98 р. | 10 пар | 2024-03-10
15 | Ёмкость ПЭТ 215 литров - 1 шт | 250.00 р. | бочка пластиковая, выписал на работе. | 2024-03-15
16 | Трубы прямоугольного сечения - 8 шт | 2000.00 р. | купил на 3 площадке | 2024-03-15
17 | Лазерный дальномер | 978.00 р. | Лазерный дальномер MILESEEY, S2, 60 м | 2024-03-23
18 | Песок | 7500.00 р. | 10 тонн | 2024-04-06
19 | Гравий 20/40 | 18500.00 р. | 10 тонн | 2024-04-06
20 | Бочка пластиковая 200 литров | 500.00 р. | выписал на работе | 2024-04-04
21 | труба металическая 40х40 мм | 1620.00 р. | 1,5м - 6 штук | 2024-04-02
22 | Геотекстиль 200г/м² 3х10 м | 1866.00 р. | 1 шт. Бауентр | 2024-04-07
23 | Геотекстиль 200г/м² 3х20 м | 3741.00 р. | 1 шт. Бауентр | 2024-04-07
24 | Доска 25х100х6000 - 24 500 р/м3 | 49245.00 р. |  | 2024-04-13
25 | Гвозди строительные 3х80 - 1 кг - 145 р | 290.00 р. | 2 кг | 2024-04-12
26 | Гвозди строительные 4х100 - 1 кг - 117 р | 234.00 р. | 2 кг | 2024-04-12
27 | шурупы 3,5х41 | 178.75 р. |  | 2024-04-12
28 | шурупы 3,5х41 | 148.00 р. |  | 2024-04-12
29 | шурупы 4,2х65 | 415.91 р. | вес | 2024-04-12
30 | ведро, шурупы, плёнка | 680.00 р. | 2 шт | 2024-04-12
31 | доставка досок | 2500.00 р. | грузовое авто | 2024-04-13
32 | Гвозди 4 кг + 2 сверла | 820.00 р. | Строитель | 2024-04-15
33 | ОСБ 12 мм и 9 мм + доставка | 21380.00 р. | 9мм - 690 р, 12мм - 940 р доставка 1500р с Поддубного | 2024-04-18
34 | садовая тачка + геотекстиль | 3600.00 р. |  | 2024-04-19
35 | петли для ворот + замок накидной | 675.00 р. |  | 2024-04-20
36 | арматура 12мм + 8 мм | 69505.00 р. | 51 шт + 31 шт (12 метров) Гленар | 2024-04-23
37 | Фиксаторы арматуры + проволока | 4070.00 р. | Гленар | 2024-04-23
38 | услуги резки арматуры газом | 450.00 р. | Гленар | 2024-04-23
39 | доставка арматуры | 2501.00 р. | Алексей | 2024-04-24
40 | набор косаря | 1390.00 р. | мерлен | 2024-04-30
41 | веник | 371.00 р. | мерлен | 2024-04-30
42 | петли | 120.00 р. | 2 шт | 2024-04-30
43 | крюк для завязки арматуры | 260.00 р. | 1 шт - Бауцентр | 2024-04-30
44 | диски для болгарки | 273.00 р. | 7 шт (бауцентр) - 39р/шт | 2024-04-30
45 | гвозди | 959.90 р. | 5 кг - 3.0х80мм | 2024-05-02
47 | саморез по дереву | 1059.00 р. | 2 пачки по 500 шт / 529.90 р/пачка (тд строитель) | 2024-05-02
48 | рукомойник | 399.90 р. | (тд строитель) | 2024-05-02
49 | Доска 25х100х6000 - 24 500 р/м3 | 61740.00 р. | 2,52 м3 (ИП Лыков) | 2024-05-06
50 | брус 50х150х6000 - 24500 р/м3 | 13230.00 р. | 0,54 м3 (ИП Лыков) | 2024-05-06
51 | доставка досок | 2500.00 р. | Александр от Алексея | 2024-05-06
52 | бензин Аи95 | 500.00 р. | 10 литров (Сургут) - для безогенератора | 2024-05-06
53 | ОСБ 9 мм + доставка (12 шт) | 9030.00 р. | 670 р/1 осб, 1000 р доставка (Авито - Поддубное) | 2024-05-08
54 | шурупы 3,5х41 (1,74 кг) | 316.39 р. | 181 р/кг (Мерлен) | 2024-05-08
55 | Перчатки ХБ 10 пар | 196.00 р. | Мерлен | 2024-05-08
56 | Доска 25х100х6000 - 23 500 р/м3 | 23617.50 р. | 1 куб (67 шт) ИП Лыков | 2024-05-11
57 | саморез по дереву 4,2х65 мм | 729.00 р. | 3 кг (ок 990 шт) - Бауцентр | 2024-05-11
58 | Гвозди оцинк. 4х120 мм | 567.00 р. | 3 кг (3 упаковки) - Бауцентр | 2024-05-11
59 | доставка досок | 2500.00 р. | Александр от Алексея | 2024-05-11
60 | закладные металлические гильзы в ленточный фундамент | 3940.00 р. | п. Люблино труба d=160 мм - 2 метра и труба 50х50 | 2024-05-16
61 | Шуруповёрт ОАЗИС | 5600.00 р. | Мерлен | 2024-05-23
62 | угольник алюминевый | 328.00 р. | Мерлен | 2024-05-23
63 | лом-гвоздедёр | 480.00 р. | Мерлен | 2024-05-23
64 | шнур разметочный -100 м | 225.00 р. | Мерлен | 2024-05-23
65 | маркеры -2 шт | 157.00 р. | Мерлен | 2024-05-23
66 | Гвозди |  | Строитель
67 | скобы для сеплера | 892.00 р. | бауцентр | 2024-05-27
68 | скобы для сеплера | 531.00 р. | бауцентр | 2024-05-26
69 | скотч | 43.80 р. | бауцентр | 2024-06-01
70 | плёнка полиэтиленовая тип150 (3х10) | 279.00 р. | бауцентр | 2024-06-01
71 | плёнка полиэтиленовая тип150 (2х20) | 266.52 р. | бауцентр | 2024-06-01
72 | лезвия для ножа концелярского - 18мм 10 шт | 21.53 р. | бауцентр | 2024-06-01
73 | Бензиновый генератор 3 квт + масло моторное 1 литр | 20419.00 р. | бауцентр | 2024-06-02
74 | труба канализационная 110 - 1000 мм -1 шт | 259.00 р. | бауцентр (закладные в ленточный фундамент) | 2024-06-08
75 | труба канализационная 110 - 500 мм -1 шт | 103.00 р. | бауцентр (закладные в ленточный фундамент) | 2024-06-08
76 | заглушка канализационная 110 - 2 шт (1 шт - 66 р) | 132.00 р. | бауцентр (закладные в ленточный фундамент) | 2024-06-08
77 | Шпильки 8 + гайки + шайбы | 2363.00 р. | Мерлен (13 шт 2 метра шпильки, 65 шайб, 65 гаек) | 2024-06-09
78 | заглушка канализационная 110 - 2 шт (1 шт - 30,83 р) | 61.66 р. | Бауцентр | 2024-06-16
79 | муфта канализационная 110 | 48.35 р. | Бауцентр | 2024-06-16
80 | Щиток защитный лицевой | 279.57 р. | Бауцентр, маска для работы с болгаркой | 2024-06-16
81 | диск отрезной 115х1 мм (27,33 р /шт) - 2 шт | 54.66 р. | Бауцентр | 2024-06-16
82 | труба канализационная 110х500 мм 2 шт | 144.34 р. | Бауцентр, закладные в ленточный фундамент | 2024-06-16
83 | Шпилька м8 х 1000 мм (55.36 р/шт) - 6 шт | 332.12 р. | Бауцентр, крепление опалубки | 2024-06-16
84 | удлининтель на катушке 50 м 3500Вт | 3977.00 р. | Бауцентр | 2024-06-21
85 | аренда вибратора для бетона | 800.00 р. | Бауцентр | 2024-06-21
86 | Шпилька м8 х 1000 мм (55.32 р/шт) - 3 шт | 165.90 р. | Бауцентр | 2024-06-19
87 | Саморез по дереву 3,5х41 мм (200шт - упаковка) | 139.35 р. | Бауцентр | 2024-06-19
88 | Плёнка полиэтиленовая тип 150 (2х20м) | 251.38 р. | Бауцентр | 2024-06-19
89 | Гайка м8 (10 шт) | 55.32 р. | Бауцентр | 2024-06-19
90 | Песок 10 т - 3 машины | 24000.00 р. | Евгений | 2024-06-19
91 | Уголок монтажный 90х90х40х1.8 мм | 22.45 р. | Бауцентр | 2024-06-24
92 | пластина анкерная 180х65х1,8 мм | 34.37 р. | Бауцентр | 2024-06-24
93 | Шпилька м8х1000 мм | 55.41 р. | Бауцентр | 2024-06-24
94 | аренда вибратора для бетона | 1000.00 р. | Бауцентр 25.06 вечер - 26.06 обед | 2024-06-26
95 | удлинитель 50 метров | 3977.00 р. | Бауцентр | 2024-06-21
96 | Бетон м300w6f100 | 252000.00 р. | ВИК Бетон - доставка 2 миксера + насос с миксером | 2024-06-26
97 | Дима | 5000.00 р. | Помощь в заливке бетона | 2024-06-26
98 | Ондулин лист красный 1,95х0,76м 14 шт. x 727.00 | 10178.00 р. | Мерлен | 2024-07-03
99 | Труба наружная SN4 110х3000 мм 3 шт. x 948.00 | 2844.00 р. | Мерлен | 2024-07-03
100 | Труба ПНД 32х2 мм (25 метров бухта) 1 шт. x 2413.00 | 2413.00 р. | Мерлен | 2024-07-03
101 | Труба наружная SN4 110х2000 мм 2 шт. x 626.00 | 1252.00 р. | Мерлен | 2024-07-03
102 | Труба наружная SN4 110х1000 мм 3 шт. x 368.00 | 1104.00 р. | Мерлен | 2024-07-03
103 | Отвод наружный 45град 110мм 7 шт. x 72.00 | 504.00 р. | Мерлен | 2024-07-03
104 | Тройник наружный 45град 110х110мм 2 шт. x 154.00 | 308.00 р. | Мерлен | 2024-07-03
105 | Гвозди Ондулин 75 мм Коричневые 1 шт. x 308.00 | 308.00 р. | 100 шт Мерлен | 2024-07-03
106 | Заглушка d110 5 шт. x 42.00 | 210.00 р. | Мерлен | 2024-07-03
107 | ХОМУТ ПП D110ММ 5 шт. x 34.00 | 170.00 р. | Мерлен | 2024-07-03
108 | Доставка транспортной компанией | 455.00 р. | Мерлен | 2024-07-03
109 | Труба гладкая ПНД 50с (2.9) 100м промрукав | 3875.00 р. | Мегаполис | 2024-07-04
110 | Доставка промрукава ПНД 50с из мегаполиса | 800.00 р. | Мегаполис | 2024-07-04
111 | Ондулин лист красный 1,95х0,76м 3 шт. x 727.00 | 2181.00 р. | Мерлен | 2024-07-07
112 | Гвозди Ондулин 75 мм Коричневые 1 шт. x 308.00 | 308.00 р. | 100 шт Мерлен | 2024-07-07
113 | Держатель для бит Декстер 54 мм | 135.00 р. | Мерлен | 2024-07-07
114 | Биты PZ2 2 шт | 55.00 р. | Мерлен | 2024-07-07
115 | Биты PH2 2 шт | 50.00 р. | Мерлен | 2024-07-07
116 | кирпич М250 керамин 2400 шт (8 паллет) + доставка манипулятором | 92000.00 р. | авито | 2024-07-26
117 | Бетоносмеситель Kronwerk 120 л 500 Вт (https://service.leroymerlin.ru/ru/go2_link_tracker?uid=NDgwNjQyMQ~~&ucs=c5d8bd1db3da790fa3adb41e3628e8d1) | 12211.00 р. | Мерлен | 2024-07-23
118 | 2 ведра мастики Гидроизоляция полимерная Боларс HydroFlex 6 кг | 4042.00 р. | Мерлен | 2024-07-23
119 | 20 мешков цемента м500 (1 меш\25 кг) | 8400.00 р. | Мерлен | 2024-07-23
120 | Сетка кладочная Штрек 15x1.25x0.4x90 мм 20 м (https://service.leroymerlin.ru/ru/go2_link_tracker?uid=NDgwNjQyMQ~~&ucs=958ddce0e82982951dafeb5fa6a5d099) | 1090.00 р. | Мерлен | 2024-07-23
121 | Геотекстиль иглопробивной Axton 1x50 м 150 г/м² (https://service.leroymerlin.ru/ru/go2_link_tracker?uid=NDgwNjQyMQ~~&ucs=4026f772799a55da24015fb4f546aa8a) | 8388.00 р. | Мерлен | 2024-07-23
122 | Шпилька м8х1000 мм 72*4шт | 288.00 р. | Мерлен | 2024-08-02
123 | Фибра в бетон и раствор 150 гр 176*2шт | 352.00 р. | Мерлен | 2024-08-02
124 | кладочная сетка 15х1,25х0,4х300 | 1541.00 р. | Мерлен | 2024-08-02
125 | кельма трапеция 180мм | 318.00 р. | Мерлен | 2024-08-02
126 | гравий 3-20 5 тонн | 15000.00 р. | Про карьер | 2024-08-05
127 | битум 21 кг(ведро) | 2300.00 р. | Озон | 2024-08-14
128 | Цемент I 42,5 H М500 Д0 25 кг (http://baucenter.ru/product/tsement-i-42-5-h-m500-d0-25-kg-ctg-29116-29171-29172-511001507/) | 5256.20 р. | 10 шт * 529 Бауцентр | 2024-08-20
129 | Отсечная гидроизоляция 0,4х20 м (http://baucenter.ru/product/otsechnaya-gidroizolyatsiya-0-4kh20-m-ctg-29116-30768-30780-528000348/) | 5957.68 р. | 4 шт * 499 Технониколь Бауцентр | 2024-08-20
130 | Труба Вест Пласт ПНД d32х2 мм 25 м (http://baucenter.ru/product/truba-vest-plast-pnd-d32kh2-mm-25-m-ctg-29189-30544-30556-440000544/) | 1778.56 р. | 1 бухта Бауцентр | 2024-08-20
131 | Макловица Korvus 150х70 мм (http://baucenter.ru/product/maklovitsa-korvus-150kh70-mm-ctg-29290-30646-30652-700000213/) | 68.56 р. | бауцентр | 2024-08-20
132 | доставка с бауцентра | 590.00 р. | бауцентр | 2024-08-20
133 | Известь сухогашённая (1.5 кг) 89р х 5 шт | 445.00 р. | бауцентр | 2024-08-25
134 | Диск алмазный 125 мм кронс | 259.00 р. | бауцентр | 2024-08-25
135 | перчатки рабочие хб | 159.00 р. | бауцентр | 2024-08-25
136 | карта бонусная на блистере | 100.00 р. | бауцентр | 2024-08-25
137 | Цемент м500 10 мешков + доставка | 5580.00 р. | бауцентр | 2024-09-11
138 | тройники, уголки, трубы канализационные 110 50 мм, крепления, скотч | 2110.00 р. | бауцентр | 2024-09-21
139 | песок 4 камаза по 14-15 тонн | 54000.00 р. | Евгений песок | 2024-09-21
140 | аренда трактора (2500 р доставка, 2500/час) | 15000.00 р. | Герман | 2024-09-28
141 | аренда трамбовки вибро на день 90 кг + доставка | 1900.00 р. | михаил | 2024-09-28
142 | песок 4 камаза по 14-15 тонн | 54000.00 р. | Евгений песок | 2024-10-01
143 | аренда трактора (2500 р доставка, 2500/час) | 10000.00 р. | Герман | 2024-10-05
144 | аренда трамбовки вибро на день 90 кг + доставка | 1900.00 р. | михаил | 2024-10-06
145 | плёнка 2 рулона | 3900.00 р. | Бауцентр | 2024-10-08
146 | арматура | 106400.00 р. |  | 2024-10-08
147 | доставка манипулятором | 13000.00 р. |  | 2024-10-08
148 | Плёнка полиэтиленовая тип 150 (2х50м) - 2 рулона | 1723.22 р. | Бауцентр | 2024-10-17
149 | Изоляция для труб - 1шт | 267.39 р. | Бауцентр. d114.9 2 метра | 2024-10-17
150 | перчатки рабочие хб | 152.00 р. | Бауцентр. 10 пар | 2024-10-17
151 | Бетон для плиты + доставка + насос | 254000.00 р. | ВИК Бетон - М300f100w4 - 25 м3 | 2024-10-19
152 | Мастика + кисточка + 2 валика | 2900.00 р. | Бауцентр - 4 ведра + 2 валика + кисточка | 2024-10-19
153 | Мастика | 2396.00 р. | Бауцентр - 4 ведра | 2024-11-03
154 | Газобетонные блоки 240 мм и 300 мм | 482016.00 р. | Аэроблок | 2024-12-26
155 | Киянка 910г, Мягкий ПВХ боек не оставляет следов, фиберглассовая рукоя | 564.75 р. | Бауцентр | 2025-01-18
156 | Кельма-ковш для газобетона 300мм СИБИН | 1216.25 р. | Бауцентр | 2025-01-18
157 | Лента геодезическая стальная, 3х скорость смотки, 30мх13мм Armero | 1890.00 р. | Бауцентр | 2025-01-05
158 | Ножовка по газобетону | 1098.00 р. |  | 2025-01-10
159 | Тёрка для газобетона | 1075.00 р. |  | 2025-01-10
160 | Газобетонные блоки 150 мм и 100 мм | 146000.00 р. | 2 палетты 100, 5 палет 150 блок (Аэроблок) | 2025-02-08
161 | Металлические трубы 40х20х1.5 - 6 метров + 30 р один рез | 900.00 р. | Промметал () | 2025-03-08
162 | пилка электролобзика по дереву 135 мм dorn - 2шт | 109.00 р. | Бауцентр | 2025-03-09
163 | сверло по металлу удлинёное 8 - 165 мм - 1 шт | 279.00 р. | Бауцентр | 2025-03-09
164 | мастика каучукобитумная 10 л | 599.00 р. | Бауцентр | 2025-03-09
165 | канистра 10 л для гсм | 599.00 р. | Бауцентр | 2025-03-09
166 | Уголок монтажный усиленный 70х70х55x1,8мм | 112.00 р. | 4 шт - Бауцентр | 2025-03-15
167 | Петля накладная 40х110 цинк | 98.00 р. | 2 шт - Бауцентр | 2025-03-15
168 | Масло для 4Т двигателей (полусинтет.) SAE 10W-40 API SJ/CF 1л DORN | 499.00 р. | Бауцентр | 2025-03-15
169 | Ондулин - 1 лист | 889.00 р. | Бауцентр | 2025-03-16
170 | Петля накладная 45х200 | 109.00 р. | Бауцентр | 2025-03-16
171 | Замок | 169.00 р. | Бауцентр | 2025-03-16
172 | Перчатки ХБ 10 пар | 159.00 р. | Бауцентр | 2025-03-16
173 | Ручка скоба | 69.00 р. | Бауцентр | 2025-03-16
174 | Крючок накидной | 59.00 р. | Бауцентр | 2025-03-16
175 | Проушина угловая 2 шт | 69.00 р. | Бауцентр | 2025-03-16
176 | Песок 0-4 | 12000.00 р. | Бауцентр | 2025-03-22
177 | Клей для блока Kleister ZM-22 | 3791.30 р. | 10 мешков 25 кг. Бауцентр | 2025-03-22
178 | Шланг для полива 1/2 | 3445.74 р. | 50 метров. Бауцентр | 2025-03-22
179 | Отсечная гидроизоляция 0,4х20 м Технониколь | 5919.96 р. | 4 рулона. Бауцентр | 2025-03-22
180 | Доставка с бауцентра | 690.00 р. | Бауцентр | 2025-03-22
181 | Сетка оцинкованная 2х2 мм (2м х 50 см) | 600.00 р. | Озон | 2025-03-23
182 | Уровень 80см магнитный с ручками, точность 0,5мм/м, 3 глазка, DORN PRO | 1055.44 р. | Бауцентр | 2025-03-28
183 | Шнур для разметки 50м на катушке Dorn - 2 шт | 246.55 р. | Бауцентр | 2025-03-28
184 | Мастика каучукобитумная 10л | 599.00 р. | Бауцентр | 2025-03-29
185 | Кельма плиточника треугольная 200мм BIHUI | 482.14 р. | Бауцентр | 2025-03-30
186 | Ковш штукатурный, круглое дно, Сибин | 299.86 р. | Бауцентр | 2025-03-30
187 | Цемент 25 кг - 15 мешков м500 + доставка до Солнечного | 9475.00 р. | Леманапро | 2025-04-04
188 | арматура диаметр = 12 мм 10 шт х 6 м | 3000.00 р. | У узбеков | 2025-04-05
189 | Шпатель зубчатый 250мм 8х8 нержавеющая сталь, Дельта | 98.97 р. | Бауцентр | 2025-04-05
190 | Шнур полипропиленовый для запуска двигателя 2,7 мм х 2 м | 44.49 р. | Бауцентр | 2025-04-05
191 | Угольник Свенсона | 1000.00 р. | ОЗОН | 2025-03-30
192 | Ткань наждачная лист 280*230 P40 DORN | 57.54 р. | Бауцентр | 2025-04-22
193 | Муфта канализационная соединительная d110мм РТП | 67.29 р. | Бауцентр | 2025-04-22
194 | Перчатки нейлон с нитриловым обливом, 9/L, сер, Экстра | 67.29 р. | Бауцентр | 2025-04-22
195 | Колено канализационное d110мм угол 45° | 86.79 р. | Бауцентр | 2025-04-22
196 | Колено канализационное d110мм угол 67° РТП | 193.10 р. | 2 шт - Бауцентр | 2025-04-22
197 | Колесо для тачки + перфолента | 1064.00 р. | Бауцентр | 2025-04-26
198 | Наколенники | 445.00 р. | Мерлен | 2025-05-02
199 | Рубанок для газобетона 400х110мм СИБИН | 1590.00 р. | Бауцентр | 2025-05-02
200 | Проволока вязальная ф 1.2 мм 5 кг | 1078.00 р. | Леманапро | 2025-05-05
201 | карандаш строительный - 30 р.шт - 3 шт | 90.00 р. | Леманапро | 2025-05-05
202 | 16 мешков клея для газобетона kleister + доставка | 6941.00 р. | Бауцентр | 2025-05-11
203 | Доставка гоазоблоков 300 - 8 паллет | 7300.00 р. | Аэроблок | 2025-05-14
204 | Пила циркулярная дисковая Makita 5008mg | 20000.00 р. | Леманапро | 2025-05-19
205 | Триммер аккумуляторный greenworks 40в g409ltk2 | 14154.00 р. | Леманапро | 2025-05-31
206 | Шпатель малярный Сибртех 60 мм нержавеющая сталь | 57.20 р. | Бауцентр | 2025-06-15
207 | Рулетка с автостопом DORN 3 м х 16 мм нейлоновое покрытие | 222.02 р. | Бауцентр | 2025-06-15
208 | Отрезной диск по металлу ШУМ 125x1,2x22,2 мм | 78.54 р. | 3 шт Бауцентр | 2025-06-15
209 | Кепка рабочая зеленая | 377.14 р. | Бауцентр | 2025-06-15
210 | Топорище 41 см | 192.93 р. | Бауцентр | 2025-06-15
211 | 10 мешков клея для газобетона kleister zm22 + доставка | 4551.00 р. | Бауцентр | 2025-06-21
212 | Шпилька рез. М8х1000мм. | 49.77 р. | Бауцентр | 2025-06-28
213 | Гайка DIN934 шестигранная оцинк. М8 Кл. проч.8.0 20шт | 55.88 р. | Бауцентр | 2025-06-28
214 | Петля карточная 110х40мм цинк 2 шт | 103.04 р. | Бауцентр | 2025-06-28
215 | Шайба DIN9021 кузовная оцинк. М8 20шт | 64.61 р. | Бауцентр | 2025-06-28
216 | Карандаш каменщика 250мм, Dorn - 3 шт | 132.73 р. | Бауцентр | 2025-06-28
217 | Ткань наждачная лист 280*230 P40 DORN | 51.52 р. | Бауцентр | 2025-06-28
218 | Рукоятка буковая для молотка 1кг, 36см Сибртех | 130.10 р. | Бауцентр | 2025-06-28
219 | помост малярный ПМ-200 + доставка | 15789.00 р. | Бауцентр | 2025-06-29
220 | Бейсболка (тёмно-синяя) | 389.00 р. | Бауцентр | 2025-07-10
221 | Ткань наждачная лист 280*230 P40 DORN | 59.00 р. | Бауцентр | 2025-07-10
222 | Полукомбинезон рабочий, 245 г/м2, серый, р-р 104-108/176-182, Basic Se | 2590.00 р. | Бауцентр | 2025-07-10
223 | Куртка рабочая, 245 г/м2, серый, 104-108/176-182, Basic Series NEO [ | 2590.00 р. | Бауцентр | 2025-07-10
224 | Полуботинки 4216Т МП, кожа, иск. кожа, ПУ/ПУ, МБС, черный (42) [М] | 1490.00 р. | Бауцентр | 2025-07-10
225 | Доставка блоков | 8000.00 р. | Аэроблок | 2025-07-11
226 | Доставка блоков | 7000.00 р. | Аэроблок | 2025-07-14
227 | Электричество + вода | 500.00 р. | Соседи | 2025-07-06
228 | Цемент ЦЕМ I 42,5Н Цемрос 50кг | 6675.00 р. | 8 мешков Бауцентр
229 | ведро оцинк - 2 шт | 605.00 р. | Бауцентр
230 | Пенополистирол экструдированный ПЕНОПЛЭКС Комфорт 1185х585х20мм | 1148.00 р. | Бауцентр
231 | Перчатки х/б с ПВХ точкой, к.в.7, Эконом - 10 пар | 153.61 р. | Бауцентр
232 | Канал круглый 100 мм х 1 м 10ВП1 ERA | 373.45 р. | Бауцентр
233 | Коронка по бетону SDS-Plus 100мм с хвостовиком DORN | 1143.00 р. | Бауцентр
234 | Клей для блока Klester ZM 22 (25кг) | 1843.00 р. | Бауцентр
235 | Услуга доставки товара из интернет магазина | 1140.00 р. | Бауцентр
236 | Рубанок металлический классик №3 210x55мм (лезвие 50мм), ЗУБР | 2089.80 р. | Бауцентр | 2025-08-11
237 | Маркер разметочный 3мм синий | 37.22 р. | Бауцентр | 2025-08-11
238 | Маркер-краска MunHwa белая, 2мм | 208.98 р. | Бауцентр | 2025-08-11
239 | Бур по бетону SDS-plus 12x350 Quatro Dorn | 289.00 р. | Бауцентр | 2025-08-13
240 | Перчатки х/б с ПВХ точкой, 10пар в уп., к.в.7,5, Эконом | 169.00 р. | Бауцентр | 2025-08-13
241 | Электроды сварочные 2,0 мм 1,0 кг OK 46.00 ESAB | 849.00 р. | Бауцентр | 2025-08-13
242 | Саморез д/г/пл. по дер. 3,5/3,8х45мм 500шт FIXBERG | 339.00 р. | Бауцентр | 2025-08-13
243 | пескобетон м300 25 кг | 881.91 р. | Бауцентр - 3 мешка | 2025-08-10
244 | Химический анкер Tech-KREP EASF EPOXY | 1464.94 р. | Бауцентр | 2025-08-10
245 | Клей цемент технониколь | 785.56 р. | 1 тюбик - 700 мл Бауцентр | 2025-08-10
246 | Профиль стоечный 100х50х3000 0.4 мм | 1451.16 р. | 2 профиля Бауцентр | 2025-08-10
247 | Саморез д/г/пл. по дер. 4,2x65мм 250шт FIXBERG | 515.94 р. | 2 коробки Бауцентр | 2025-08-17
248 | Гвозди оцинк. 3,0х80мм 1кг | 197.58 р. | Бауцентр | 2025-08-17
249 | Саморез д/г/пл. по дер. 3,5/3,8х45мм 500шт FIXBERG | 292.48 р. | Бауцентр | 2025-08-17
250 | Бетон м300 5м3 + доставка+ насос | 58000.00 р. | Вик бетон | 2025-09-13
251 | Брус 100х200х6000 (септир) кол-во = 7,08 м3 | 194700.00 р. | ИП Лыков | 2025-09-15
252 | Доставка бруса 100-200-6000 мм до пос Солнечное манипулятор | 7000.00 р. | ИП Лыков | 2025-09-15
253 | Гвозди строительные 6х200мм 5кг | 829.00 р. | Бауцентр | 2025-09-16
254 | Диск отрезной 115x1,0 мм диск по металлу Dorn | 117.00 р. | Бауцентр | 2025-09-16
255 | Гвозди строительные 5,0x150мм 1кг | 179.00 р. | Бауцентр | 2025-09-16
256 | Перчатки х/б с ПВХ точкой, 10пар в уп., к.в.7,5, Эконом | 169.00 р. | Бауцентр | 2025-09-16
257 | Рубероид РКП 350 15м2 ГОСТ (1,6 кг/м2) | 1269.00 р. | Бауцентр | 2025-09-16
258 | Грунт котлованный 4 машины | 4000.00 р. | база сыпучих материалов. Солнечное | 2025-09-16
259 | Масло для смазки цепи 0,95л SAE 30 OASIS | 262.34 р. |  | 2025-09-17
260 | Саморез с п/шайбой со сверлом 4,2х25мм 25 шт. Bullit | 56.15 р. |  | 2025-09-17
261 | Опора бруса раскрытая OBR R 100х140х1,8мм 5 шт | 697.50 р. | 139,50 р шт | 2025-09-17
262 | Трактор jcb 2500р - доставка, 2700р час. | 13300.00 р. | василий, выравниване грунта - глина. 4 часа работы | 2025-09-17
263 | Масло для смазки цепи 0,95л SAE 30 OASIS | 299.00 р. | Бауцентр | 2025-09-19
264 | Скобы оцинкованные тип 53, 6мм, 1000шт, РемоКолор | 124.00 р. | 2 упак Бауцентр | 2025-09-19
265 | Карандаш каменщика 250мм, Dorn | 59.00 р. | Бауцентр | 2025-09-19
266 | Карандаш столяра 250мм, Dorn | 32.00 р. | Бауцентр | 2025-09-19
267 | Маркер перманентный Luxor черный, 3мм | 69.00 р. | Бауцентр | 2025-09-19
268 | Шуруп с шестигранной головкой 10х180мм DIN571 | 195.00 р. | 5шт х 39р Бауцентр | 2025-09-19
269 | Шайба DIN9021 кузовная оцинк. М16 6шт | 99.84 р. | Бауцентр | 2025-09-20
270 | Чашка алмазная зачистная 125 мм Turbo MATRIX | 585.32 р. | Бауцентр | 2025-09-20
271 | Сверло по металлу удлиненное 5,0 х 132мм HSS-G DORN | 99.84 р. | Бауцентр | 2025-09-20
272 | Гвозди строительные 6х200мм 5кг | 829.00 р. | Бауцентр | 2025-09-21
273 | Гвозди строительные 6х200мм 5кг | 829.00 р. | Бауцентр | 2025-09-21
274 | Гвозди строительные 6х200мм 5кг | 731.00 р. | Бауцентр | 2025-09-23
275 | Рубероид РКП 350 15м2 ГОСТ (1,6 кг/м2) | 1269.00 р. | Бауцентр | 2025-09-29
276 | Клей для блока Klester ZM 22 (25кг) | 375.00 р. | Бауцентр | 2025-09-29
277 | Клей для блока Klester ZM 22 (25кг) | 375.00 р. | Бауцентр | 2025-10-03
278 | Арматура 12 мм (по 6 метров). 26 штук | 11300.00 р. | Марк Авито - Доставка 3000р | 2025-10-16
279 | Шпилька усиленная м16х2000 13 шт - 594рх13 = 7722 | 7722.00 р. | Лемана про | 2025-10-17
280 | Гайка шестигранная м16 (84р упак4шт) 84х21 пачку = 1764 | 1764.00 р. | Лемана про | 2025-10-17
281 | перчатки облив латекс 68рх2шт | 136.00 р. | Лемана про | 2025-10-17
282 | Проволока вязальная ф 1.2 мм 5 кг | 717.00 р. | Лемана про | 2025-10-17
283 | гайка м16 2 упак по 26 шт | 716.00 р. | Бауцентр | 2025-10-19
284 | Шайбы М16 2 упак по 20 шт | 604.00 р. | Бауцентр | 2025-10-19
285 | Перчатки х/б с ПВХ точкой, 10пар в уп., к.в.7,5, Эконом | 139.35 р. | Бауцентр | 2025-10-22
286 | Лента упаковочная 48мм х 120м прозрачная | 131.11 р. | Бауцентр | 2025-10-22
287 | Саморез д/г.пл. по дер. 3,5х41мм 200шт FIXBERG | 246.54 р. | Бауцентр | 2025-10-22
288 | ОСБ 15 мм - 25 шт | 44500.00 р. | 1700р.шт + 2000р доставка - АВИТО - Камская | 2025-10-23
289 | Бетон м300 - 3.5м3 | 44050.00 р. | 8300р/м3 + 15000р доставка ВИК бетон | 2025-10-24
290 | Аренда вибратора для бетона | 500.00 р. | Авито дмитрий снт | 2025-10-24
291 | брус 150х150 (не септир) - 9 шт, брус 100х200(септ) - 7шт, 50х200(септ) - 54шт. | 136080.00 р. | ИП Лыков | 2025-11-07
292 | Доставка манипулятором 7000р + подъём 100х200 14 шт и 150х150 9шт. 1500р | 8500.00 р. | ИП Лыков | 2025-11-07
293 | Септик для дерева 5 л не смываемый | 3290.00 р. | Бауцентр | 2025-11-06
294 | Рубероид РКП 350 15м2 ГОСТ (1,6 кг/м2) -2рул, 3 диска отрезных для болгарки, рулетка на 5 м, кисточка для покраски | 2893.00 р. | Бауцентр | 2025-11-11
295 | сверло по дереву 20 мм | 569.90 р. | ТД Строитель | 2025-11-13
296 | Стамеска, прорезиненная ручка, металический боек, CRV сталь, 40мм, DORN | 265.61 р. | Бауцентр | 2025-11-18
297 | Перчатки утепленные, х/б с латексным обливом, 10/XL, корич, GRIZZLY Bradas | 76.39 р. | Бауцентр | 2025-11-18
298 | Шайба DIN9021 кузовная оцинк. М16 12шт | 153.00 р. | Бауцентр | 2025-11-23
299 | гвозди строительные 3.5х90мм 1 кг | 154.12 р. | Бауцентр | 2025-12-04
300 | гвозди строительные 4х100мм 1 кг | 154.12 р. | Бауцентр | 2025-12-04
301 | Уголок монтажный усиленный 90х90х65x1,8мм - 4 шт | 168.76 р. | Бауцентр | 2025-12-04
302 | Перчатки х/б с латексным обливом, 9/L, сер, к.в.10, PRIMO Bradas | 59.00 р. | Бауцентр | 2025-12-10
303 | Сверло по дереву 14 мм хвостовик Hex-E 1/4 DORN | 209.00 р. | Бауцентр | 2025-12-10
304 | Сверло по металлу 18мм HSS-G DORN | 989.00 р. | Бауцентр | 2025-12-10
305 | Шуруп с шестигранной головкой 10х140мм DIN571 8 шт | 256.00 р. | Бауцентр | 2025-12-10
306 | Диск отрезной 125x1,0x22,2мм по металлу и нержавеющей стали ШУМ 2 шт | 50.00 р. | Бауцентр | 2025-12-10
307 | Шайба DIN9021 кузовная оцинк. М10 10шт | 69.00 р. | Бауцентр | 2025-12-10
308 | Полоса 40х4х6000 мм | 2100.00 р. | 3 шт ООО КСМ | 2025-12-10
309 | Полоса 20х4х6000 мм | 380.00 р. | 1 шт ООО КСМ | 2025-12-10
310 | Резка полос | 220.00 р. | ООО КСМ | 2025-12-10
311 | Саморез с п/шайбой по дереву 3,8х45мм 50шт. | 158.31 р. | Бауцентр | 2025-12-23
312 | Уголок монтажный усиленный 90х90х65х1,8мм | 367.20 р. | Бауцентр | 2025-12-23
313 | Гвозди строительные 4,0x100мм 1кг | 167.68 р. | Бауцентр | 2025-12-23
314 | Шуруп конструкционный, для дерева, потай, TORX 30 6,0x200мм. | 550.81 р. | 12 шт Бауцентр | 2025-12-23
315 | шина нулевая "стойка" 6x9 мм 12 групп на din рейку ekf - 1шт. | 125.00 р. | Бауцентр | 2026-02-20
316 | шина нулевая 6x9 мм 14 групп на din рейку ekf - 1шт. | 209.00 р. | Бауцентр | 2026-02-20
317 | din рейка 30 см оцинкованная 2 шт | 138.00 р. | Бауцентр | 2026-02-20
318 | шина соединительная 3 полюса 63А 12 мод ekf - 1шт | 539.00 р. | Бауцентр | 2026-02-20
319 | держатель для коронок bi-metal 32-152мм dorn pro | 479.00 р. | Бауцентр | 2026-02-22
320 | коронка bi-metal 8% по металлу/дереву 73мм dorn pro | 839.00 р. | Бауцентр | 2026-02-22
321 | вибратор для бетона deko 1500 Вт с булавой 1.5 м | 2471.00 р. | wildberries | 2026-02-18
322 | Электрон 34 ящик ЩМП 05 ip54 металлический | 3700.00 р. | wildberries | 2026-02-18
323 | Розетка EKF трёхфазная пятипроводная 32A 380В | 473.00 р. | wildberries | 2026-02-18
324 | автоматический выключатель dekraft c20a 4 полюсный | 2040.00 р. | wildberries | 2026-02-17
325 | Розетка на din рейку iek 16A 250В | 348.00 р. | wildberries | 2026-02-17
326 | Фен строительный DEKO 2000 Вт | 988.00 р. | wildberries | 2026-03-03
327 | Доставка блоков 150 аэроблок - 5 паллет | 8000.00 р. | Аэроблок | 2026-03-17
328 | Кримпер для обжима наконечников | 1215.00 р. | wildberries | 2026-03-04
329 | Выключатель нагрузки IEK | 3275.00 р. | wildberries | 2026-03-04
330 | автоматический выключатель IEK c25 3 полюсный | 677.00 р. | wildberries | 2026-02-27
331 | автоматический выключатель 4 полюса 25а | 1123.00 р. | wildberries | 2026-02-26
332 | Кабель твёрдый круглый негорючий низкотоксичный ВВГ-нг LSLTx 3x2,5 ГОС - 1 метр | 127.78 р. | Бауцентр | 2026-03-18
333 | Уголок монтажный усиленный 90х90х65х1,8мм - 10 шт (1 шт - 45р) | 450.00 р. | Бауцентр | 2026-03-18
334 | Перчатки полиэстер с полиуретановым обливом, 10/XL, черн, Sado Plus - 2 пары | 182.00 р. | Бауцентр | 2026-03-18
335 | Гвозди оцинк. 4,0х120мм 1кг | 228.89 р. | Бауцентр | 2026-03-18
336 | Гвозди оцинк. 5,0х150мм 1кг | 228.89 р. | Бауцентр | 2026-03-18
337 | Шпилька рез. М8х1000мм. - 2 шт | 102.00 р. | Бауцентр | 2026-03-20
338 | Шайба DIN9021 кузовная оцинк. М12 10шт | 116.15 р. | Бауцентр | 2026-03-20
339 | Сверло по дереву балочное 8х460, 6-гранный хвостовик | 224.20 р. | Бауцентр | 2026-03-20
340 | 40х20х1.5х6000 мм труб прямоуг + резка | 845.00 р. | ООО СИТ - покупка метал труб прямоуг сечения | 2026-03-24
341 | уголки+шурупы | 898.00 р. | бауцентр | 2026-03-24
342 | уголки + шурупы | 444.00 р. | Бауцентр | 2026-03-25
343 | саморез с шайбой по дереву 3,8х45мм 50 шт | 179.00 р. | Бауцентр | 2026-03-26
344 | уголок монтажный усиленный 90х90х65х1.8 мм 2 шт | 98.00 р. | Бауцентр | 2026-03-26
345 | уголок монтажный усиленный 60х60х45х1.8 мм 17 шт | 374.00 р. | Бауцентр | 2026-03-26
346 | шпилька м8 1 метр + конструк саморезы 140 мм | 271.00 р. | Бауцентр | 2026-03-29
347 | шпилька м8 1000мм 1 шт | 57.00 р. | Бауцентр | 2026-04-01
348 | уголок монтажный усиленный 60х60х45х1.8 мм 50 шт | 1100.00 р. | Бауцентр | 2026-04-01
349 | гвозди строительные 4х120 мм 4 кг | 756.00 р. | Бауцентр | 2026-04-01
350 | саморез с пресшайбой по дереву 3.8 х 45 50 шт 2 упак | 358.00 р. | Бауцентр | 2026-04-01
351 | Гайка м8 (10 шт) | 79.00 р. | Бауцентр | 2026-04-01
352 | Вынос границ земельного участка | 4000.00 р. | ООО «Региональная кадастровая компания» +7 963 350-70-61 info@rkk39.ru www.rkk39.ru 236022, г. Калининград, ул. Г. Димитрова, д. 3, пом. 2 | 2026-04-01
353 | Кабель круглый бронированный АПвБШп 4х16 - 22 м x 279 ₽ | 6138.00 р. | База стройматериалов «БСМ» -бауцентр | 2026-04-07
354 | Кабель круглый негорючий малодымный ВВГнг(А)-LS 5х10 ГОСТ - 10 м x 889 ₽ | 8890.00 р. | База стройматериалов «БСМ» -бауцентр | 2026-04-07
355 | Пленка паро-гидроизоляционная Изоспан D усиленная 90 г/м2 70 м2 - 4 рул x 4 490 ₽ | 17960.00 р. | База стройматериалов «БСМ» -бауцентр | 2026-04-07
356 | Цемент ЦЕМ II/В-Ш 42,5Н Heidelberg 25 кг - 1 шт x 529 ₽ | 529.00 р. | База стройматериалов «БСМ» -бауцентр | 2026-04-07
357 | трубка термоусадочная клеевая сттк 55\16 1м-546,11р 2 шт | 1092.22 р. | Мегаполис-балтика | 2026-04-11
358 | трубка термоусадочная тту 10\5 1м 16,49р | 16.49 р. | Мегаполис-балтика | 2026-04-11
359 | труба гофрированная двухслойная электрокор флекс 61 х 3м | 183.00 р. | Мегаполис-балтика | 2026-04-11
360 | электрический провод ПуГВнг(а)-LS 1x10 на отрез 246х3м | 792.00 р. | Лемана про | 2026-04-12
361 | наконечник гильза ншви2 6-14 | 136.00 р. | Лемана про | 2026-04-12
362 | шпагат пп 100м | 101.00 р. | Лемана про | 2026-04-12
363 | респиратор ffp1 форм с клапаном юлия | 72.00 р. | Лемана про | 2026-04-12
364 | ншви2 10мм2 | 164.00 р. | Лемана про | 2026-04-15
365 | сигнальная лента | 162.00 р. | Лемана про | 2026-04-15
366 | доска 25х100х6000 - 109 шт - 26000 р\м3 | 42510.00 р. | ИП Лыков | 2026-04-20
367 | доска 50х200х6000 - 25 шт - 26000 р\м3 | 39000.00 р. | ИП Лыков | 2026-04-20
368 | доска 50х150х6000 - 3 шт - 26000 р\м3 | 3510.00 р. | ИП Лыков | 2026-04-20
369 | брус 50х50х3000 - 104 шт - 26000 р\м3 | 20280.00 р. | ИП Лыков | 2026-04-20
370 | доставка досок манипулятором jac n90 | 6000.00 р. | Сергей с авито | 2026-04-20
371 | ПНД 32 гладкая 64.99 р х 4 метра | 259.96 р. | Мегаполис | 2026-04-26
372 | труба 50 гофрированная двухслойная электрокор флекс 61 х 3м | 183.00 р. | Мегаполис | 2026-04-26
373 | лента прямая (стальная перфорированная) lp 20x0,70-0,80мм 5 метров | 251.23 р. | Мегаполис | 2026-04-26
374 | труба термоусаживаемая клеевая сттк (3-4:1) 55\16мм 1м -546,11р 2 метра | 1092.22 р. | Мегаполис | 2026-04-26
375 | Перчатки полиэстер с полиуретановым обливом, 10/XL, черн, Sado Plus - 2 пары | 182.22 р. | Бауцентр | 2026-04-26
376 | Диск отрезной 125x1,0x22,2мм по металлу и нержавеющей стали ШУМ 2 шт | 46.02 р. | Бауцентр | 2026-04-26
377 | диск отрезной 125х1,6мм диск по металлу DORN 2 шт | 108.60 р. | Бауцентр | 2026-04-26
378 | уголок монтажный усиленный 60х60х45х1.8мм - 16 шт | 323.96 р. | Бауцентр | 2026-04-26
379 | провод ПуГВнг(А)LS 1x10 чёрный 1 метр | 175.00 р. | Электроцентр, ИП Савельев | 2026-04-27
380 | провод ПуГВнг(А)LS 1x6 красный 1 метр | 109.00 р. | Электроцентр, ИП Савельев | 2026-04-27
381 | наконечник НШВИ 10-12 (20шт\упак) IEK | 171.00 р. | Электроцентр, ИП Савельев | 2026-04-27
382 | наконечник НШВИ 6-12 (20шт\упак) IEK | 196.00 р. | Электроцентр, ИП Савельев | 2026-04-27
383 | Гвозди оцинк 3х80 1кг 2 упак х 240р | 480.80 р. | Бауцентр | 2026-05-02
384 | гвозди строительные 4х120 мм 1 кг | 182.47 р. | Бауцентр | 2026-05-02
385 | Гвозди строительные 3,5х90мм 1 кг, 3 упак х 182.47р | 547.41 р. | Бауцентр | 2026-05-02
386 | доска 50х200х6000 - 19 шт - 26000 р\м3 | 29640.00 р. | объём - 1,14 м3 ИП Лыков | 2026-05-05
387 | 40х50х6000 - 5 шт - 26000р\м3 | 1560.00 р. | объём - 0,06 м3 ИП Лыков | 2026-05-05
388 | доставка досок | 3000.00 р. | Александр от Алексея | 2026-05-05
389 | уголок монтажный 60х80х80х2.5мм | 57.94 р. | Бауцентр | 2026-05-07
390 | Опора бруса раскрытая OBR R 51х105х1,8мм 1 шт | 98.67 р. | Бауцентр | 2026-05-07
391 | Шуруп конструкционный, для дерева, полусфера, TORX 30 6,0x100мм. 4 шт | 152.08 р. | Бауцентр | 2026-05-07
392 | Гвозди оцинк 4х100 1кг 1 упак х 207.31р | 207.31 р. | Бауцентр | 2026-05-07
393 | Гидроизоляция отсечная ТЕХНОНИКОЛЬ 0,2х20м | 899.00 р. | Бауцентр | 2026-05-22
394 | Пескобетон М 300 (25кг) 4 мешка | 1196.00 р. | Бауцентр | 2026-05-22
395 | Уголок монтажный 90х90х40х1,8мм 7х34р | 238.00 р. | Бауцентр | 2026-05-22
396 | Блок вентиляционный керамзитобетонный VB 20х20х40 U 2 CAN - 33 шт | 9164.33 р. | Бауцентр | 2026-05-22
397 | Блок вентиляционный керамзитобетонный VB 20х30х20 1 CAN | 8507.39 р. | Бауцентр | 2026-05-22
398 | Скобы каленые тип 53, 10мм, 1000шт, Miles 5х178.17 | 890.85 р. | Бауцентр | 2026-05-22
399 | Гвозди строительные 4х120мм 5кг 2 X 785.34 | 1570.68 р. | Бауцентр | 2026-05-22
400 | Клей для блока Klester ZM 22 (25кг) 7 мешков | 2780.06 р. | Бауцентр | 2026-05-22
401 | Гвозди строительные 4х100мм 5кг х2 | 1570.70 р. | Бауцентр | 2026-05-22
402 | Услуга доставки товара из интернет магазина | 2030.00 р. | Бауцентр | 2026-05-22
403 | 5 литров антисептик для обработки древесины | 1900.00 р. | Мурат | 2026-05-22
404 | Перчатки полиэстер с полиуретановым обливом, 10/XL, черн, Sado Plus 4x69р | 277.24 р. | Бауцентр | 2026-05-23
405 | Перчатки нейлон с нитриловым обливом, 10/XL, сер, Sado Plus 2пары | 110.62 р. | Бауцентр | 2026-05-23
406 | Брусок нестроганый 50x50x3000 мм хвоя ФГИС ЛК 22 шт х 377р | 7414.00 р. | ЛеманаПРО | 2026-05-23
407 | Шпатель зубчатый Интек 10108-150-010 150 мм, нержавеющая сталь, зуб 10x10 мм | 81.00 р. | ЛеманаПРО | 2026-05-23
408 | Доставка транспортной компанией | 670.00 р. | ЛеманаПРО | 2026-05-23
409 | Зонт для дымохода из нерж стали 0.6мм d=80 | 548.05 р. | Мегаполис | 2026-05-23
410 | сборник конденсата для дымохода из нерж стали d=80 | 703.25 р. | Мегаполис | 2026-05-23
411 | тройник для дымохода из нерж стали d=80мм | 960.30 р. | Мегаполис | 2026-05-23
412 | герметик для каминов силикатный titan professional черный 280мл | 348.23 р. | Мегаполис | 2026-05-23
413 | труба для дымохода из нерж стали 0.6мм d=80 L=1m 960,30р х 4шт | 3841.20 р. | Мегаполис | 2026-05-23
414 | хомут метал 75 (21/2*) с шурупом 96.03р х 2шт | 192.06 р. | Мегаполис | 2026-05-23
415 | уголок монтажный 90х90х40х1,8мм 43х27.99р | 1203.43 р. | Бауцентр | 2026-05-26
416 | Гвозди строительные 4х120мм 5 кг | 649.45 р. | Бауцентр | 2026-05-26
417 | саморез по дереву 4,2х65мм 250 шт | 246.12 р. | Бауцентр | 2026-05-26
418 | клей для блока KLESTER zm22 25 кг | 384.89 р. | Бауцентр | 2026-05-27
419 | ЦПС м150 25 кг | 257.56 р. | Бауцентр | 2026-05-27
420 | Канал круглый 100 мм х 1,5 м 10ВП1,5 ERA | 622.18 р. | Бауцентр | 2026-05-27
421 | Заглушка D100 PDP пластик ERA | 120.58 р. | Бауцентр | 2026-05-27
422 | соединитель круглых каналов D100vv 10СКП ERA 96,47x2шт | 192.94 р. | Бауцентр | 2026-05-27
423 | тройник D100мм 10 тп ERA | 336.65 р. | Бауцентр | 2026-05-27
424 | канал круглый 0.5м 100мм 188,10х2 | 376.20 р. | Бауцентр | 2026-05-27
425 | Герметик нейтральный силиконовый | 399.00 р. | Мегаполис | 2026-05-28
426 | вычистка для дымохода из нерж стали с заглушкой 0.6 D=80мм | 1250.00 р. | Мегаполис | 2026-05-28
427 | труба для дымохода из нерж стали 0.6мм d=80 L=0.25m | 500.00 р. | Мегаполис | 2026-05-28
428 | Пескобетон М 300 (25кг) 4 мешка | 1161.60 р. | Бауцентр | 2026-05-31
429 | Винт-шуруп (шпилька сантехническая) TORX 20 M10х100мм 4 шт | 112.68 р. | Бауцентр | 2026-05-31
430 | Хомут с рез. упл. 100мм 4шт | 423.48 р. | Бауцентр | 2026-05-31
431 | Саморез д/г/пл. по дер. 4,2x65мм 250шт FIXBERG | 290.40 р. | Бауцентр | 2026-05-31
432 | Уголок монтажный 40х80х80x1,8мм | 1083.76 р. | Бауцентр | 2026-05-31
433 | Счет на оплату № УТ-223 от 27 мая 2026 г. - металлочерепица и комплектующие Эбис | 441993.20 р. | ИП Лукьянов Никита Антонович, ИНН 391201802940, 238563, Калининградская область, г.о. Светлогорский, г Светлогорск, ул Яблоневая, Дом 3, кв. 3 | 2026-05-27
434 | Счет на оплату № УТ-678 от 27 мая 2026 г. Эбис | 47851.75 р. | Общество с ограниченной ответственностью "ЭБИС", ИНН 3905601123, КПП 390601001, 236010, Калининградская обл, Калининград г, Кутузова ул, дом 37, квартира 3, тел.: +7(4012) 99-40-4 | 2026-05-27
435 | Мурат строитель | 400000.00 р. | сборка крыши - плёнка, обрешётка, контр обрешётка, металлочерепица, вентгрибок, ливнестоки | 2026-05-31
436 | Доставка манипулятором металочерепицы и комплектующие | 6000.00 р. | Алексей грузоперевозки | 2026-06-01
437 | Перчатки полиэстер с полиуретановым обливом 10\xl черн. | 88.82 р. | Бауцентр | 2026-06-03
438 | клей для блока KLESTER zm22 25 кг - 2 мешка | 715.94 р. | Бауцентр | 2026-06-03
439 | пескобетон м300 25 кг | 268.25 р. | Бауцентр | 2026-06-03
440 | соединитель круглых каналов D100vv 10СКП ERA 2 шт | 191.02 р. | Бауцентр | 2026-06-03
441 | канал круглый 100мм 1 метр, 2 шт | 723.98 р. | Бауцентр | 2026-06-03
442 | Гвозди ершёные оцинков. 4,2х40мм. 0,25кг | 640.29 р. | Бауцентр | 2026-06-04
443 | Саморез с п/шайбой по дереву 3,8х45мм 50шт. 4 упак | 696.72 р. | Бауцентр | 2026-06-04
444 | Замена коротких крюков на длинные (водосточная система) | 6592.40 р. | ИП Лукьянов Никита Антонович, ИНН 391201802940, 238563, Калининградская область, г.о. Светлогорский, г Светлогорск, ул Яблоневая, Дом 3, кв. 3
445 | труба для дымохода из нерж. Стали 0.6мм d80 L=0.25м | 500.00 р. | ООО "Мегаполис-Балтика" | 2026-06-05
446 | вентиляционный выход ventos x metal f22 d=150mm | 6630.00 р. | Общество с ограниченной ответственностью "ЭБИС", ИНН 3905601123, КПП 390601001, 236010, Калининградская обл, Калининград г, Кутузова ул, дом 37, квартира 3, тел.: +7(4012) 99-40-4 | 2026-06-08
447 | Эмаль-спрей акриловая color art 520ml ral7024 | 279.00 р. | Бауцентр | 2026-06-09
448 | Рулетка 5м х 19мм, Бауцентр | 179.00 р. | Бауцентр | 2026-06-16
449 | Саморезы кровельные, графитово серые, RAL7024 4,8х35мм. 60шт. | 199.00 р. | Бауцентр | 2026-06-16
450 | Саморезы кровельные, графитово серые, RAL7024 4,8х19мм. 70шт. | 199.00 р. | Бауцентр | 2026-06-16
451 | Маркер разметочный 3мм синий | 39.00 р. | Бауцентр | 2026-06-16
452 | Маркер-краска MunHwa белая, 2мм | 219.00 р. | Бауцентр | 2026-06-16
453 | Ткань наждачная лист 280*230 P40 DORN | 59.00 р. | Бауцентр | 2026-06-16
454 | планка снегозадержания 250 мм Satin matt grand line 7024 - 3 шт | 2511.00 р. | ИП Лукьянов Никита Антонович, ИНН 391201802940, 238563, Калининградская область, г.о. Светлогорский, г Светлогорск, ул Яблоневая, Дом 3, кв. 3 | 2026-06-16
455 | Плита ОСП-3 Муром 12 мм 2500x1250 мм 3.125 м2 - 45 шт | 51210.00 р. | ЛеманаПРО | 2026-06-21
456 | Уголок металлический 50x50x5.0 мм 3м - 5шт | 5390.00 р. | ЛеманаПРО | 2026-06-21
457 | Доставка транспортной компанией | 2030.00 р. | ЛеманаПРО | 2026-06-21
458 | Дюбель нейлоновый D12x100mm 2 шт | 43.65 р. | Бауцентр | 2026-06-24
459 | комплект дюбель d12x60mm шуруп с шестигр головкой d8x60mm 3 шт | 65.92 р. | Бауцентр | 2026-06-24
460 | гвозди для пневмостеплера 1.4x30 mm 1000 шт | 257.43 р. | Бауцентр | 2026-06-24
461 | шурупы универсальные 4.5х35мм желт 200шт | 174.00 р. | Бауцентр | 2026-06-25
462 | трубка термоусаживаемая тут 6/3 набор (21шт 100 мм) | 45.00 р. | Бауцентр | 2026-07-05
463 | шурупы универсальные 4.5х30мм желт 260шт fixberg | 229.00 р. | Бауцентр | 2026-07-05
464 | шурупы универсальные 4х35 мм желт 230 шт | 209.00 р. | Бауцентр | 2026-07-05
465 | Саморез по дереву 3,5х35 мм (200шт - упаковка) | 249.00 р. | Бауцентр | 2026-07-05
466 | комплект дюбель d12x60mm шуруп с шестигр головкой d8x60mm 3 шт | 74.00 р. | Бауцентр | 2026-07-05
467 | анкер втулочный с болтом d12x70mm fsl fischer 2 шт | 180.00 р. | Бауцентр | 2026-07-05
468 | Шурупы универс. 3,5х40мм желт. 250шт FIXBERG | 218.52 р. | Бауцентр | 2026-07-07
469 | Гвозди строительные 4,0x120мм 1кг | 174.62 р. | Бауцентр | 2026-07-07
470 | Саморез д/г/пл.по мет. 4,8х100мм 30шт FIXBERG | 125.85 р. | Бауцентр | 2026-07-07
471 | Пластина анкерная 140x55х2,5мм 2 шт | 85.85 р. | Бауцентр | 2026-07-07
472 | Круги шлифовальные с отверстиями Р40,125мм, 5шт/уп., DORN | 106.33 р. | Бауцентр | 2026-07-07
473 | Круг лепестковый торцевой 125 Х 22 мм цирконий Р 80 плоский Dorn PRO | 174.62 р. | Бауцентр | 2026-07-07
474 | Ручка-скоба РС-120мм цинк | 77.07 р. | Бауцентр | 2026-07-07
475 | Задвижка плоская ЗД 100мм цинк | 291.69 р. | Бауцентр | 2026-07-07
476 | Петля накладная ПН1-110мм цинк левая | 377.55 р. | Бауцентр | 2026-07-07
477 | Сверло по металлу 3,5мм HSS-Co 5% DORN PRO | 135.60 р. | Бауцентр | 2026-07-07
478 | Сверло по металлу 3,5мм HSS-TiN DORN | 67.31 р. | Бауцентр | 2026-07-07
479 | Заказ №0050 от 23.06.2026 г. Окна в дом | 319865.36 р. | Индивидуальный предприниматель Плотников Игорь Владимирович Адрес: г. Калининград, Советскийпроспект, 286, с. 5.10 Телефон: 89937314527 | 2026-06-23
480 | Прожектор Диодный 70Вт 6000к онлайт | 298.48 р. | Бауцентр | 2026-07-11
481 | провод гибкий круглый пвс 3х1.5 10 м | 791.13 р. | Бауцентр | 2026-07-11
482 | Замок навесной чугунный вс14-060 extra 60х45мм алюр | 462.70 р. | Бауцентр | 2026-07-11
483 | ввилка с заземл угловая в16-002 | 76.31 р. | Бауцентр | 2026-07-11
484 | клема 3х проводная wago 3шт | 211.55 р. | Бауцентр | 2026-07-11
485 | вилка с заземл белая иэк | 91.77 р. | Бауцентр | 2026-07-11
486 | термоусадочная трубка набор №5 rexant | 100.46 р. | Бауцентр | 2026-07-11
487 | трубка термоусаживаемая тут 4/2 набор (21шт 100 мм) | 39.60 р. | Бауцентр | 2026-07-11 | ВНЕШНЕЕ УТЕПЛЕНИЕ ДОМА | 526302.87 р.
488 | Пенополистирол экструдированный ТЕХНОПЛЕКС 1180х580х50 мм - 48 шт для цоколя | 16176.00 р. | Бауцентр | 2026-07-14 | СТОИМОСТЬ РАБОТ | 210000.00 р.
489 | Клей для пенополистирола ZM 01 KLESTER (25кг) 5 мешков для цоколя | 2200.00 р. | Бауцентр | 2026-07-14 | СТОИМОСТЬ МАТЕРИАЛА | 316302.87 р.
490 | Клей для пенополистирола и сетки ZM 02 KLESTER (25кг) - 5 мешков для цоколя | 3050.00 р. | Бауцентр | 2026-07-14 | РАБОТЫ ОТ ВСЕЙ СТОИМОСТИ | 39.90097945%
491 | Сетка фасадная Крепикс 1800 1х50м (160г/м2) BauTex для цоколя | 2990.00 р. | Бауцентр | 2026-07-14
492 | Дюбель с термоголовкой д/пустотелых материалов D10x140мм 50 шт Koelner - 2 упак для цоколя | 1980.00 р. | Бауцентр | 2026-07-14
493 | Услуга доставки товара из интернет магазина | 1100.00 р. | Бауцентр | 2026-07-14
494 | кадастровые и геодезические работы - Регистрация дома | 17000.00 р. | ООО "Региональная кадастровая компания" | 2026-07-14
495 | утепление цоколя - работы | 25000.00 р. | Зафарбек | 2026-07-17
496 | Саморез д/г/пл.по дер.3,5х25мм 250шт FIXBERG | 249.00 р. | Бауцентр | 2026-07-18
497 | Воздуховод круглый пластиковый 125 мм х 0,5 м 12,5ВП ERA | 259.00 р. | Бауцентр | 2026-07-18
498 | Редуктор эксцентриковый D100/D150 мм 1015РЭП ERA | 205.00 р. | Бауцентр | 2026-07-18
499 | Пена для полистерола + эппс | 5000.00 р. | Зафарбек | 2026-07-16
500 | Дюбель с пластиковым стержнем D10х140мм 50 шт Koelner x 2 | 448.86 р. | Бауцентр | 2026-07-19
501 | Ручка-скоба РС-100-3 цинк | 48.33 р. | Бауцентр | 2026-07-19
502 | Клей для пенополистирола и сетки ZM 02 KLESTER (25кг) | 427.22 р. | Бауцентр | 2026-07-19
503 | Сетка фасадная Крепикс 1500 1х10м (145г/м2) BauTex | 573.60 р. | Бауцентр | 2026-07-19
504 | утепление цоколя - работы | 26000.00 р. | Зафарбек | 2026-07-19
505 | строительный пылесос ПС-1400-15 | 4833.00 р. | wildberries | 2026-07-22
506 | гидравлический ручной пресс для обжима наконечников кабеля | 1814.00 р. | wildberries | 2026-07-23
507 | комплект заземления grountok 3 метра | 3678.00 р. | wildberries | 2026-07-25
508 | паста кварцевазелиновая пкв защитная 20 мл | 216.00 р. | Озон | 2026-07-25
509 | Пароизоляционная пленка ТехноНИКОЛЬ МАСТЕР БАРЬЕР 4.0 = 2рулона | 16666.00 р. | Озон | 2026-08-09
510 | штыревые наконечники для СИП16 = 8 шт | 343.00 р. | Озон | 2026-07-22
511 | Шина для PE, алмазный диск-коронка, ручка-скоба рс-100-3 цинк | 1367.00 р. | Бауцентр | 2026-07-25
512 | Грунтовка для стен, наконечники НШАМ 16 | 608.00 р. | Бауцентр | 2026-07-27
513 | провод пугв PE 1х10 -4 метра, провод ПУгВ черный 1х10 -5метров | 1755.00 р. | Электроцентр, ИП Савельев | 2026-07-27
514 | Грунт котлованный 4 машины | 12000.00 р. | Данил | 2026-07-27
515 | Плита пеноп.ППС-16Ф (100мм) - 16.2 м3 | 74439.00 р. | Гурьевский пенополистерол | 2026-07-27
516 | Плита пеноп.ППС-25 (50мм) - 14,7 м3 | 117306.00 р. | Гурьевский пенополистерол | 2026-07-27
517 | Транспортные услуги | 2700.00 р. | Гурьевский пенополистерол | 2026-07-27
518 | Клей для пенополистирола ZM 01 KLESTER (25кг) - 30 мешков | 12814.61 р. | ООО "БАУЦЕНТР РУС" | 2026-07-31
519 | Клей для пенополистирола и сетки ZM 02 KLESTER (25кг) - 30 мешков | 17765.71 р. | ООО "БАУЦЕНТР РУС" | 2026-07-31
520 | Дюбель с пластиковым стержнем D10х180мм 50 шт Koelner - 18 | 6972.30 р. | ООО "БАУЦЕНТР РУС" | 2026-07-31
521 | Дюбель с пластиковым стержнем D10х180мм 50 шт Koelner - 2 | 774.72 р. | ООО "БАУЦЕНТР РУС" | 2026-07-31
522 | Сетка фасадная Крепикс 1800 1х50м (160г/м2) BauTex - 4 рулона | 11610.81 р. | ООО "БАУЦЕНТР РУС" | 2026-07-31
523 | Уголок штукатурный ПВХ с пластиковой сеткой Крепикс 1300 100х150х2500 BauTex - 5 рулонов | 451.40 р. | ООО "БАУЦЕНТР РУС" | 2026-07-31
524 | Клей-пена монтажная профессиональная 500 Professional 1000мл Технониколь - 2 | 1648.44 р. | ООО "БАУЦЕНТР РУС" | 2026-07-31
525 | Услуга доставки товара из интернет магазина | 2510.00 р. | ООО "БАУЦЕНТР РУС" | 2026-07-31
526 | плёнка защитная с лентой, для вн работ 1.1х33м x-glass - 2 рулона | 502.70 р. | ООО "БАУЦЕНТР РУС" | 2026-08-03
527 | лента малярная 48мм х 25м для наружных работ (синяя) Фрегат - 9шт | 1568.97 р. | ООО "БАУЦЕНТР РУС" | 2026-08-03
528 | наконечник штыревой втулочный изолированный 10 50шт ekf | 118.32 р. | ООО "БАУЦЕНТР РУС" | 2026-08-03
529 | Труба гофрированная ПВХ "легкая" 16мм с/з 10м Эра | 153.30 р. | ООО "БАУЦЕНТР РУС" | 2026-08-05
530 | Клеммный зажим на DIN-рейку ЗНИ-10 синий - 4шт | 221.20 р. | ООО "БАУЦЕНТР РУС" | 2026-08-05
531 | Профиль примыкающий оконный ПВХ с сеткой 9мм 2,4 м БауТекс - 20 шт | 2957.40 р. | ООО "БАУЦЕНТР РУС" | 2026-08-06
532 | Уголок штукатурный ПВХ с пластиковой сеткой Крепикс 1300 100х150х2500 BauTex - 24 шт | 1746.24 р. | ООО "БАУЦЕНТР РУС" | 2026-08-06
533 | Клей-пена монтажная профессиональная 500 Professional 1000мл Технониколь - 2шт | 1328.46 р. | ООО "БАУЦЕНТР РУС" | 2026-08-06
534 | ДОСТ-ИМ18 Услуга доставки товара из интернет магазина | 900.00 р. | ООО "БАУЦЕНТР РУС" | 2026-08-06
535 | Выключатель автоматический 2п 4,5кА 16А С EKF | 319.00 р. | ООО "БАУЦЕНТР РУС" | 2026-08-08
536 | Пенополистирол ППС 16Ф 1000x500x100мм - 8шт | 1984.00 р. | ООО "БАУЦЕНТР РУС" | 2026-08-08
537 | Провод гибкий круглый ПВС 3х2,5 5м ГОСТ | 809.00 р. | ООО "БАУЦЕНТР РУС" | 2026-08-08
538 | Щиток электрический встраиваемый ЩРВ-П-54 TEKFOR,54 модуля | 5352.00 р. | wildberries | 2026-08-01
539 | aideLife насадка штроборез | 1704.00 р. | wildberries | 2026-08-01
540 | соединительная одностороняя лента Технониколь альфабэнд 60 - 8шт | 10671.00 р. | ОЗОН | 2026-07-25
541 | Колцо гидрозатвора на вентиляцию 4 шт | 3380.00 р. | ОЗОН | 2026-07-25
542 | Бутил-каучуковая лента двухстороняя - 10 рулонов | 6080.00 р. | wildberries | 2026-08-09
543 | Заглушка из пенополистирола для фасадных дюбелей (упак. 500 шт.) - 2 упак | 3159.50 р. | ООО "БАУЦЕНТР РУС" | 2026-08-09
544 | Уголок штукатурный ПВХ с пластиковой сеткой Крепикс 1300 100х150х2500 - 37 штук | 3216.41 р. | ООО "БАУЦЕНТР РУС" | 2026-08-09
545 | 17 ведёр силиконовой фасадной штукатурки (барашек) 1.5 мм фракция. 2 ведра грунта. Доставка 4000р | 80160.00 р. | Тепло Авангард +7905 246 7672. +7962 253 26 41 Игорь Сергеевич П - Сбер | 2026-08-10
546 | утепление фасада | 120000.00 р. | Зафарбек | 2026-08-10
547 | саморез по дер 3,5х25мм 500 шт | 498.00 р. | ООО "БАУЦЕНТР РУС" | 2026-08-12
548 | Клей-пена DONEWELL Мощная хватка | 425.00 р. | ВИПЛАСТ Московский проспект 184 | 2026-08-12
549 | Водоотлив антрацит (0.5) 6 шт 181 см х 17,5 см, 91 см х 17,5 см -2 шт | 4678.92 р. | ВИПЛАСТ Московский проспект 184 | 2026-08-12
550 | Кисть для красок 50мм, Акор - 2 шт | 158.00 р. | ООО "БАУЦЕНТР РУС" | 2026-08-13
551 | Перчатки полиэстер с полиуретановым обливом, чер, 9/L, DORN - 5 пар | 395.00 р. | ООО "БАУЦЕНТР РУС" | 2026-08-13
552 | утепление фасада | 90000.00 р. | Зафарбек | 2026-08-21
553 | оплата по договору ТП-КЛГ-389.26-ДГ | 54019.55 р. | АО "Газпром Газораспределение" | 2026-09-02
554 | клей-пена монтажная профессиональная 500 1000 мл Технониколь | 796.68 р. | ООО "БАУЦЕНТР РУС" | 2026-09-02
 | паста герметизирующая технониколь альфа пэйст 1,34 кг | 1304.33 р. | ООО "БАУЦЕНТР РУС" | 2026-09-02
 | степлер тип 140 скобы 6-14мм miles | 1304.33 р. | ООО "БАУЦЕНТР РУС" | 2026-09-02
 | лента одностороняя ondutiss fix tape 50 мм 50 м | 1116.66 р. | ООО "БАУЦЕНТР РУС" | 2026-09-02
 | Кабель ВВГ-пнг(А)-LS 3*1,5 100 метров | 7290.00 р. | ИП Савельев Электроцентр | 2026-09-07
 | Кабель ВВГ-пнг(А)-LS 3*2,5 100 метров | 11190.00 р. | ИП Савельев Электроцентр | 2026-09-07
 | площадка под стяжку усиленная для прямого монтажа черная 50 шт, промрукав | 237.65 р. | ИП Савельев Электроцентр | 2026-09-07
 | коробка распред 85\85\42 серая 5 шт | 785.70 р. | ИП Савельев Электроцентр | 2026-09-07
 | коробка распред 80\80\40 черн 5 шт | 669.30 р. | ИП Савельев Электроцентр | 2026-09-07
 | хомут 4,0 * 150 черн нейлон морозостойкое упак 100шт | 110.58 р. | ИП Савельев Электроцентр | 2026-09-07
 | труба гофр ПВХ 20 мм серая с зондом IEK 100 метров | 2786.00 р. | ИП Савельев Электроцентр | 2026-09-09
 | труба металопластиковая pex-al-pex 16x2.0 valtec 200 метров -бухта | 25800.00 р. | ООО "БАУЦЕНТР РУС" | 2026-09-09
 | колодка клеммная 12 пар (2,5-6,0 мм2) 10А черная iek | 75.00 р. | ООО "БАУЦЕНТР РУС" | 2026-09-09
 | крепление для ппр труб 16 (10шт упак) 2 упак | 78.00 р. | ООО "БАУЦЕНТР РУС" | 2026-09-09
 | Регулятор напряжения и мощности, диммер 220V 4000 Вт (4 кВт) | 280.00 р. | ОЗОН | 2026-09-10
 | очиститель незатвердевшей монтажной пены 500 мл Технониколь | 160.42 р. | ООО "БАУЦЕНТР РУС" | 2026-09-17
 | клей пена монтажная профессионал 500 - 1000 мл Технониколь | 594.73 р. | ООО "БАУЦЕНТР РУС" | 2026-09-17
 | стажка кабельная 2,5 х 169мм черная 100 шт safeline | 105.08 р. | ООО "БАУЦЕНТР РУС" | 2026-09-17
 | дюбель хомут 10/5 плоский черный 50 шт ekf | 58.14 р. | ООО "БАУЦЕНТР РУС" | 2026-09-17
 | площадка под стяжку компакт 16х23 белая 100шт / упак dynel | 139.40 р. | ООО "БАУЦЕНТР РУС" | 2026-09-17
 | дюбель хомут 14/6 плоский черный 50 шт ekf | 72.85 р. | ООО "БАУЦЕНТР РУС" | 2026-09-17
 | скобы тип 140 12мм 1000шт dorn | 104.38 р. | ООО "БАУЦЕНТР РУС" | 2026-09-17
 | клей пена монтажная профессионал 500 - 1000 мл Технониколь | 594.49 р. | ООО "БАУЦЕНТР РУС" | 2026-09-22
 | Коронка по бетону SDS-Plus 80мм с хвостовиком DORN (для коробок расключения ) | 664.51 р. | ООО "БАУЦЕНТР РУС" | 2026-09-22
 | дюбель хомут; стяжки | 494.00 р. | ИП Зверев Электроцентр | 2026-09-22
 | кабель ввгп-нг ls 3x2,5 мм2 - 50 метров; гофра труба пвх 100 метров; | 12764.02 р. | ИП Савельев Электроцентр | 2026-09-22
 | Труба гофрированная ПВХ 25мм с/з 15м IEK | 669.30 р. | ИП Савельев Электроцентр | 2026-09-23
 | кабель ВВГ нг(А) ls 5x4 mm2 круглый 8 метров | 3492.00 р. | ИП Савельев Электроцентр | 2026-09-23
 | кабель ВВГ-пнг-ls 3х2,5 мм2 50 метров | 5995.00 р. | ИП Савельев Электроцентр | 2026-09-23
 | щётка смётка econova | 136.42 р. | ООО "БАУЦЕНТР РУС" | 2026-09-29
 | совок пластиковый | 54.02 р. | ООО "БАУЦЕНТР РУС" | 2026-09-29
 | кабель твёрдый плоский ввгп-нг-ls 3x2,5 мм2 50 метров ПРОМЭКО | 5392.60 р. | ООО "БАУЦЕНТР РУС" | 2026-09-29
 | Маркер разметочный 3мм чёрный 2 шт | 53.10 р. | ООО "БАУЦЕНТР РУС" | 2026-09-29
 | лезвия для ножа концелярского - 18мм 10 шт | 46.86 р. | ООО "БАУЦЕНТР РУС" | 2026-09-29
 | полумаска изолирующая исток -300/400 с фильтрами А1Р1 | 452.07 р. | ООО "БАУЦЕНТР РУС" | 2026-10-01
 | фильтр комбинированный к полумаске исток 300/400 а1р1 2 шт в упак | 363.43 р. | ООО "БАУЦЕНТР РУС" | 2026-10-01
 | кабель твёрдый плоский ввгп-нг-ls 3x2,5 мм2 20 метров ПРОМЭКО | 2550.87 р. | ООО "БАУЦЕНТР РУС" | 2026-10-01
 | Труба гофрированная ПВХ "легкая" 20мм с/з 25м Эра | 609.65 р. | ООО "БАУЦЕНТР РУС" | 2026-10-01
 | угловая шлифмашинка 150мм 1500 Вт регул оборотов HAG15150EC hanskonner | 10823.00 р. | ООО "БАУЦЕНТР РУС" | 2026-10-01
 | стальной лист 0.2х125х250 см + 2 полосы п 6 м. | 5665.00 р. | КСМ39, ООО СИТ лист ГК 2х1250х2500 мм - 4100Р; полоса 25х4х6000мм 2шт - 1040р | 2026-10-03
 | Воздуховод круглый пластиковый 100 мм х 1 м 10ВП1 ERA | 507.98 р. | ООО "БАУЦЕНТР РУС" | 2026-10-09
 | Воздуховод круглый пластиковый 100 мм х 1,5 м 10ВП1,5 ERA | 536.25 р. | ООО "БАУЦЕНТР РУС" | 2026-10-09
 | соединитель фасонных элементов (отрезок канала) fc d100 пластик ЭРА | 84.82 р. | ООО "БАУЦЕНТР РУС" | 2026-10-09
 | гильза медная лужённая гмл 6-4 10 шт | 206.40 р. | ООО "БАУЦЕНТР РУС" | 2026-10-09
 | гильза медная лужённая гмл 10-5 10 шт | 300.64 р. | ООО "БАУЦЕНТР РУС" | 2026-10-09
 | труба металопластиковая pex-al-pex 20x2.0 valtec 50 метров | 8057.91 р. | ООО "БАУЦЕНТР РУС" | 2026-10-09
 | котёл газовый двухконтурный Haier TechLine S 2.24 TW 3,4-23,9 кВт (закрытая камера сгорания) | 78142.00 р. | ООО "Контур Лидер" контуртерм | 2026-10-11
 | рулетка 5м х 25 мм Dorn + пружина для металлопласт 16 и 20 мм | 1039.00 р. | ООО "БАУЦЕНТР РУС" | 2026-10-12
 | вывоз мусора | 10000.00 р. | Авито Семён | 2026-10-12
 | прокат - аренда пресс клещей Valtec | 400.00 р. | ООО "БАУЦЕНТР РУС" | 2026-10-13
 | тройник-пресс D20 sempiter icma 5 шт | 3945.00 р. | ООО "БАУЦЕНТР РУС" | 2026-10-13
 | тройник канализационный D50/50 mm угол 45 ртп | 75.00 р. | ООО "БАУЦЕНТР РУС" | 2026-10-13
 | гильза медная лужённая гмл 10-5 10 шт.\упак DORI | 319.00 р. | ООО "БАУЦЕНТР РУС" | 2026-10-13
 | Колено канализационное d50мм угол 45° РТП | 44.00 р. | ООО "БАУЦЕНТР РУС" | 2026-10-13
 | труба канализационная 50 х 250 х 1,8 мм РТП | 69.00 р. | ООО "БАУЦЕНТР РУС" | 2026-10-13
 | крестовина канализационная одноплоскостная D110/50/50 mm угол 90, РТП | 419.00 р. | ООО "БАУЦЕНТР РУС" | 2026-10-13
 | труба канализационная 50х500х1,8 мм ртп | 186.00 р. | ООО "БАУЦЕНТР РУС" | 2026-10-13
 | труба металлопластиковая pex-al-pex 20x2 valtec 24 метра | 3869.52 р. | ООО "БАУЦЕНТР РУС" | 2026-10-16
 | калибр для металлопластиковой трубы 16-20-26 с ножами для снятия фаски Valtec | 205.54 р. | ООО "БАУЦЕНТР РУС" | 2026-10-16
 | Эмаль-спрей акриловая color art 520ml ral7024 - 2 шт | 510.46 р. | ООО "БАУЦЕНТР РУС" | 2026-10-19
 | шайба оцинк м8 - 20шт | 65.87 р. | ООО "БАУЦЕНТР РУС" | 2026-10-19
 | комплект дюбель d12x60mm шуруп с шестигр головкой d8x60mm 3 шт | 72.27 р. | ООО "БАУЦЕНТР РУС" | 2026-10-19
 | болт с шестигран головкой оцинк м8х50мм 8шт | 104.30 р. | ООО "БАУЦЕНТР РУС" | 2026-10-19
 | коронка bi-metal 8% по металлу/дереву 102мм dorn pro | 997.12 р. | ООО "БАУЦЕНТР РУС" | 2026-10-19
 | Гайка DIN934 шестигранная оцинк. М8 Кл. проч.8.0 80шт | 222.96 р. | ООО "БАУЦЕНТР РУС" | 2026-10-20
 | Анкер хим. д/средних нагрузок, полиэстер, 300мл TYTAN | 805.00 р. | ООО "БАУЦЕНТР РУС" | 2026-10-20
 | Шпилька рез. М8х1000мм. | 51.04 р. | ООО "БАУЦЕНТР РУС" | 2026-10-20
 | выравнивание участака - аренда трактора jcb | 16000.00 р. | Павел Бойнарович +7981 459 42 80 | 2026-10-20
 | диск отрезной по металлу и нержавеющей стали 3 шт | 267.00 р. | ООО "Мегаполис-Балтика" | 2026-10-23
 | труба для дымохода из нержавеющей стали 0,6мм D80 L=50 см | 590.00 р. | ООО "Мегаполис-Балтика" | 2026-10-23
 | труба канализационная D50 1m 3шт | 417.00 р. | ООО "БАУЦЕНТР РУС" | 2026-10-23
 | Колено канализационное d50мм угол 45° РТП - 8шт | 352.00 р. | ООО "БАУЦЕНТР РУС" | 2026-10-23
 | Муфта канализационная соединительная d110мм РТП - 2 шт | 258.00 р. | ООО "БАУЦЕНТР РУС" | 2026-10-23
 | пакет бауцентр большой | 9.00 р. | ООО "БАУЦЕНТР РУС" | 2026-10-23
 | редукция канализационная 110/50 низкая РТП - 2 шт | 198.00 р. | ООО "БАУЦЕНТР РУС" | 2026-10-23
 |  | 6593194.64 р.

Sheet: расчёт труб отопления
 |  |  |  |  |  | Бауцентр
Наименование | длинна (см) | длинна с обратным трубопроводом (см) | примечание |  | № | наименование | количество | цена
труба отоп_под_детская | 1160.52 | 2321.04 |  |  | 1 | Труба металлопластиковая VALTEC PEX-AL-PEX 16х2,0 мм | 200 м | 25800.00 ₽
труба_отоп_под_бабуш | 680 | 1360 |  |  | 2 | Кабель ВВГп-нг(A)-LS 3х1,5 мм2 100 м твердый плоский Конкорд | 100 м | 9490.00 ₽
труба_отоп_под_родит | 1187.5 | 2375 |  |  | 3 | Кабель ВВГп-нг(A)-LS 3х2,5 мм2 100 м твердый плоский Конкорд | 100 м | 13990.00 ₽
труба_отоп_под_сануз | 721.65 | 1443.3 |  |  | итого: |  |  | 49280.00 ₽
труба_отоп_под_тех | 383.66 | 767.32
труба_отоп_под_дверь_терр | 1368.97 | 2737.94 |  |  |  | Электроцентр
труба_отоп_под_кух_зап | 1311.86 | 2623.72 |  |  | № | наименование | количество | цена
труба_отоп_под_кух_юг | 1116.87 | 2233.74 |  |  | 1 | Кабель ВВГ-пнг(A)-LS 3* 1,5 (ГОСТ) (плоский) ноунейм | 100 м | 7290.00 ₽
труба_отоп_под_гост_юг | 1477.63 | 2955.26 |  |  |  | Кабель ВВГ-пнг(A)-LS 3* 1,5 (ГОСТ) (плоский) | 100 м | 7590.00 ₽
ИТОГО: |  | 18817.32 | в метрах -> | 188.1732 |  | Кабель ВВГ-пнг(A)-LS 3*2,5 (ГОСТ) (плоский) | 100 м | 11190.00 ₽
 |  |  |  |  |  | Кабель ВВГ-пнг(A)-LS 3*2,5 (ГОСТ) (плоский) (бухтами по 100м) -0,66 зелёный | 100 м | 11590.00 ₽
 |  |  |  |  |  | Лемана про
 |  |  |  |  | № | наименование | количество | цена
 |  |  |  |  |  | Кабель Партнер-Электро ВВГпнг(A)-LS 3x2.5 100 м ГОСТ цвет черный | 100 м | 11248.00 ₽
 |  |  |  |  |  | Кабель Партнер-Электро ВВГпнг(A)-LS 3x1.5 100 м ГОСТ цвет черный | 100 м | 7626.00 ₽

Sheet: расчёт площади утепления дома
сторона дома | ширина (м) | высота (м) | площадь проёмов (м2) | площадь утепления (м2) | примечание | высота окна (м) | ширина окна (м) | площадь (м2)
восток | 13 | 3.47 | 9.72 | 35.39 | из общей площади - площадь проёмов = площадь утепления | 1.51 | 1.8 | 2.718
запад | 13 | 3.47 | 10.155 | 34.955
север | 11.85 | 3.47 | 1.359 | 39.7605 | проём один - окно из с\у
юг | 11.85 | 3.47 | 5.436 | 35.6835 | два проёма | высота окна двери на терасу (м) | ширина (м) | площадь (м2)
Итого: |  |  |  | 145.789 | общая площадь утепления (с запасом думаю = 160м2 пенопласта) | 2.38 | 1.8 | 4.284
 |  |  |  |  |  | высота малого окна (м) | ширина окна (м) | площадь (м2)
 |  |  |  |  |  | 1.51 | 0.9 | 1.359
 |  |  |  |  |  | высота двери входной (м) | ширина (м) | площадь (м2)
 |  |  |  |  |  | 2.1 | 1.6 | 3.36

Sheet: расчёт объёма бетона для мп1
Наименование | м3
БМ1-1 | 0.47
БМ1-2 | 0.12
МП2 запад1 | 0.54
МП2 запад2 | 0.13
МП-2 Восток 1 | 0.45
МП-2 Восток 2 | 0.26
МП-1-1 | 0.57
МП-1-2 | 0.45
МП-1-3 | 0.3
МП-1-4 | 0.07
МП-1-5 | 0.27
МП-1-6 | 0.51
Итого: | 4.14 | м3
 | 5

Sheet: Расчёт балок перекрытия
Балки перекрытия | 200 х 100 х 6000 | мм |  | 11 |  | 120000000 | мм3 | 0.12 | м3
 |  |  |  | 12
 |  |  |  | 12
 |  |  |  | 9
 |  |  |  | 3
 |  |  |  | 4
 |  |  |  | 3
 |  |  | Итого | 54
 |  |  |  | 55 | 6.6 | м3
 |  |  |  | шт

Sheet: Материалы
 | Стоимость материалов (предварительная) на 26 февраля 2024 года.
№ п/п | Тип | Количество (М3/шт) | Цена (м3 или штук) | Сумма | Примечание
1 | Газобетонный блок 375 мм | 45 | 7000.00 ₽ | 315000.00 ₽ | Наружные стены. Данные взяты из проекта и сайта поставщика AeroBlock стеновой D500, 375х250х600
2 | Газобетонный блок 250 мм | 15.3 | 7000.00 ₽ | 107100.00 ₽ | Внутренние стены. AeroBlock стеновой D500, 240х250х600
3 | Газобетонный блок 150 мм | 8 | 8000.00 ₽ | 64000.00 ₽ | AeroBlock перегородочный D500, 150х250х600
4 | U - блоки 375 мм | 137 | 680.00 ₽ | 93160.00 ₽ | 137 штук.
5 | U - блоки 250 мм | 12 | 435.00 ₽ | 5220.00 ₽ | 12 штук. U-блок 240x250x600
6 | ЭППС 100мм | 5.4 |  | 0.00 ₽ | м3 в проекте. Пока не пойму где используется. Бауцентр - 966 р/шт. Леруа - 880 р/шт.
7 | Арматура 12-А 500 С |  |  | 0.00 ₽ | https://www.glenar.ru/page/stoimost-i-sposoby-dostavki
8 | Бетонная смесь В20-В25 |  |  | 0.00 ₽
9 | Брус 100х200 |  |  | 0.00 ₽
10 | Брус 150х150 |  |  | 0.00 ₽
11 | Доска 50х200 |  |  | 0.00 ₽
12 | Брус 50х150 |  |  | 0.00 ₽
13 | Брус 50х30 |  |  | 0.00 ₽
14 | Брус 50х50 |  |  | 0.00 ₽
15 | Доска 25х100 |  |  | 0.00 ₽
16 | Утеплитель 200 мм (перекрытие) - 27 м3 | 27 |  | 0.00 ₽
17 | Утеплитель 100 мм (стены) - 12.6 м3 | 12.6 |  | 0.00 ₽
18 | Металочерепица |  |  | 0.00 ₽
19 | Арматура 10 мм |  |  | 0.00 ₽
20 | Фиксатор арматуры |  |  | 0.00 ₽
21 | Геотекстиль |  |  | 0.00 ₽
 |  |  |  | 0.00 ₽
 |  |  |  | 0.00 ₽
Итого: |  |  |  | 584480.00 ₽

Sheet: Расчёт арматуры
Расчёт арматуры
Наименование | 8 мм | 12 мм
МП-3 (метры) | 138 | 194
МП-1 БМ (метры) | 133 | 226
МП-2 (метры) | 65 | 92
Армирование несущих стен (внеш) | 132
Армирование несущих стен (внутр) | 60
Сумма (метры) | 528 | 512
штук (делю на 6) | 88 | 85.33333333

Sheet: Оси
Наш проект |  |  | Покупной проект
 | Оси вертикальные |  |  | Оси вертикальные
Название оси | Расстояние (мм) | комментарии | Название оси | Расстояние (мм) | комментарии
Контур дома, стена | 300 | так как планируется использовать 300 мм газобетонный блок | Контур дома, стена | 375 | так как планируется использовать 375 мм газобетонный блок
A - B | 1500 | так как глубина крыльца такая же как и в покупном проекте | A - Б | 1500
B - C | 2125 | так как необходимо было оставить несущую стену (запад) на том же расстоянии. | Б - В | 2050
C - D | 3100 | расстояние между несущими стенами та же. | В - Г | 3100
D - E | 4525 | так как блок стал 300 мм, комнаты увеличились. 4450 + 75 = 4525 мм | Г - Д | 4450
Контур дома, стена | 300 |  | Контур дома стена | 375
Длина стены Север (Юг) | 11850 |  | Длина стены Север (Юг) | 11850
 |  | Блоки для внутренних несущих стен 240 мм |  |  | Блоки для внутренних несущих стен 250 мм
 | Оси горизонтальные |  |  | Оси горизонтальные
Название оси | Расстояние (мм) | комментарии | Название оси | Расстояние (мм) | комментарии
Контур дома, стена | 300 | так как планируется использовать 300 мм газобетонный блок | Контур дома, стена | 375 | так как планируется использовать 375 мм газобетонный блок
1 -2 | 3175 | 3100 + 75. Стена стала тоньше на 75 мм. | 5 -4 | 3100
2 - 3 | 1700 |  | 4 - 3 | 1700
3 - 4 | 1625 | 1700-75. Так как блок 300 мм. | 3 - 2 | 1700
4 - 5 | 5900 | 5750+75+75. Так как блоки уменьшились с двух сторон, на 75 мм. | 2 - 1 | 5750
Контур дома, стена | 300 | так как планируется использовать 300 мм газобетонный блок | Контур дома стена | 375
Длина стены Север (Юг) | 13000 |  | Длина стены Север (Юг) | 13000
 |  | Для лучшего понимания смотреть кладочный план покупного проекта!!!

Sheet: Высоты
 | Высоты
Мой проект |  |  |  | Проект покупной
Наименование | высота (мм) | примечание |  | Наименование | высота (мм) | примечание
ЖБ плита | 160 | 0 - отметка. Верхний уровень жб плиты | низ | ЖБ плита | 300
Утеплитель (пенопласт) | 100 | 100 мм (50 + 50 мм) |  | Утеплитель (пенопласт) | 150
арм. Цем песч стяжка | 65 | 50 мм |  | арм. Цем песч стяжка | 60
покрытие пола | 20 | клей + плитка |  | покрытие пола | 20 | 0 - отметка. Верхний уровень чистового пола
нижний край проёма окна | 1015 | от плиты до последнего ряда газобетона |  | Полная высота стены (газобетон) | 2780 | от плиты до последнего ряда газобетона (от проектного нуля 2550)
Стена + мп1/мп2 (от плиты до мп1/мп2) | 3020 |  |  | Стена + мп1/мп2 (от плиты до мп1/мп2) | 3030 | 2780+250 толщина мп1/мп2 (от проектного нуля 2550+250=2800)
 |  | высота от плиты до нижнего края проёма 101,5 см = 1015 мм |  | высота нижнего края проема окна от плиты | 1080 | 850+230=1080мм

Sheet: Розетки и освещение
Кухня и гостинная - 3, 4 (2 группы на освещение)
назначение | количество розеток (шт) | примечание
варочная поверхность | 1 | скорее всего 3 фазная розетка, сечение провода -
духовой шкаф | 1
Холодильник | 1
посудомоечная машина | 1
микроволновая печь/кофемашина | 2
электрочайник/миксер/мясорубка | 2
вытяжка | 1
телевизор и комуникационное оборудование | 3
робот пылесос | 1
диван | 3
ИТОГО: | 16
Детская комната - 5 (одна группа освещения)
назначение | количество (шт) | примечание
компьютер + принтер | 4 | сечение провода -
телевизор и комуникационное оборудование | 3
настольные светильники + зараядки | 2
ИТОГО: | 9
Родительская комната - 6 (одна группа освещения)
назначение | количество (шт) | примечание
компьютер + принтер | 4 | сечение провода -
телевизор и комуникационное оборудование | 3
настольные светильники + зараядки | 2
ИТОГО: | 9
Бабушкина комната - 9 (одна группа освещения)
назначение | количество (шт) | примечание
компьютер + принтер | 4 | сечение провода -
телевизор и комуникационное оборудование | 3
настольные светильники + зараядки | 2
ИТОГО: | 9
санузел - 7 (одна группа освещения)
назначение | количество (шт) | примечание
стиральная машина, сушильная машина | 2 | сечение провода - , влагозащищёное исполнение, УЗО.
бойлер | 1 | влагозащищёное исполнение, УЗО.
зеркало (подсветка), фен, электробритва. | 2 | влагозащищёное исполнение, УЗО.
ИТОГО: | 5
туалет - 8 (одна группа освещения)
назначение | количество (шт) | примечание
зеркало | 1 | сечение провода - , влагозащищёное исполнение, УЗО.
фен | 1 | влагозащищёное исполнение, УЗО.
ИТОГО: | 2
Техническое помещение - 10 (одна группа освещения)
назначение | количество (шт) | примечание
настенный газовый котёл | 2 | сечение провода -
циркуляционные насосы | 2
отчистка воды | 1
погружной насос для скважины | 1 | автоматический выключатель -вывод на восточную сторону
аэрационный насос для септика | 1 | автоматический выключатель -вывод на южную сторону
питание для кухни |  | автоматический выключатель (возможно буду подключать с уличного щитка)
 |  | автоматический выключатель - освещение чердачного помещения
холл - 2 (одна группа освещения)
назначение | количество (шт) | примечание
розетка 1 | 1 | сечение провода -
розетка 2 | 1
ИТОГО: | 2
Группа освещения улица ЮГ.
Группа освещения улица север.
Группа освещения улица восток.
Группа освещения улица запад.

Sheet: сравнение цен на 13_02_26
Бауцентр |  | Лемана ПРО
Комплектующие\Магазины | Цена в Бауцентр (руб) | Комплектующие\Магазины | Legrand | Dekraft | EKF | TDM electric | IEK | Спец 800вт | Столбец1
4-полюсный автомат С25А | 2790.00 р. | 4-полюсный автомат С25А | 2150.00 р. | 1780.00 р. | 1140.00 р. | 1213.00 р.
4 - полюсный автомат С20А | 2890.00 р. | 4 - полюсный автомат С20А |  | 1743.00 р. | 882.00 р.
3-полюсный автомат С16А | 1390.00 р. | 3-полюсный автомат С16А |  | 1338.00 р. |  |  | 706.00 р.
1-полюсный автомат С10А | 339.00 р. | 1-полюсный автомат С10А
Ящик электрический уличный | 5190.00 р. | Ящик электрический уличный
Розетка однофазная в шкаф на din рейку | 329.00 р. | Розетка однофазная в шкаф на din рейку |  | 357.00 р.
шинка РЕ |  | шинка РЕ
шинка N | 125.00 р. | шинка N
Розетка на 3 ф | 299.00 р. | Розетка на 3 ф
вибратор для бетона | 3190.00 р. | вибратор для бетона |  |  |  |  |  | 2472.00 р.
гибкий вал | 1790.00 р. | гибкий вал |  |  |  |  |  | 2063.00 р.
ламели для кровати (1шт) | 109.00 р. | ламели для кровати (1шт) |  |  |  |  |  |  | 181.00 р.
 |  | Электроцентр
 |  | Комплектующие\Магазины | Legrand | Dekraft | EKF | TDM electric | IEK | Спец 800вт | Etimat
 |  | 4-полюсный автомат С25А |  |  |  |  |  |  | 2524.00 р.
 |  | 4 - полюсный автомат С20А |  |  |  |  |  |  | 2524.00 р.
 |  | 3-полюсный автомат С16А |  |  |  |  | 840.00 р.
 |  | 1-полюсный автомат С10А
 |  | Ящик электрический уличный |  |  |  |  | 6256.00 р.
 |  | Розетка однофазная в шкаф на din рейку |  |  |  |  | 262.00 р.
 |  | шинка РЕ
 |  | шинка N |  |  |  |  | 263.00 р.
 |  | Розетка на 3 ф |  |  |  |  | 647.00 р.
 |  | вибратор для бетона |  |  |  |  | 5838.00 р.
 |  | гибкий вал
 |  | ламели для кровати (1шт)

Sheet: котельная и вентиляция
Для котла Fondital Victoria Compact CTFS 24 AF при объеме котельной 18 м³ рекомендуемый внутренний диаметр вентканала составляет 150 мм (или прямоугольное сечение эквивалентной площади 177 см²). | Для раздельной системы дымоудаления (раздельного дымохода) газового котла Fondital Victoria Compact CTFS 24 AF требуются две трубы диаметром 80 мм каждая — одна для дымоудаления, другая для забора воздуха. Это стандартное решение для турбированных моделей, обеспечивающее эффективный отвод продуктов сгорания.
 | www.allb.ru +1
Поскольку модель CTFS (аббревиатура Camera Turbo Forzata Stagna) оснащена закрытой камерой сгорания и принудительным дымоудалением, расчет вентиляции упрощается: вам не нужно закладывать дополнительный приток воздуха на горение газа в саму трубу вытяжки, так как котел берет его с улицы через коаксиальный дымоход. | Ключевые особенности:
 | Диаметр труб: 80/80 мм.
Обоснование расчета | Тип системы: Раздельная (воздуховод и дымоход идут отдельно).
Согласно нормативам (СП 402.1325800.2018), для газовых котельных обязателен трехкратный воздухообмен в час. | Тип котла: Закрытая камера сгорания (CTFS), турбированный.
АО «Газпром газораспределение Петрозаводск +1 | ТеплоВсем +2
Необходимый объем вытяжки: 18 м³ × 3 = 54 м³/час. | Использование труб диаметром 80 мм позволяет оптимизировать работу системы дымоудаления и обеспечить безопасную эксплуатацию котла.
Скорость воздуха: При естественной вентиляции расчетная скорость составляет ~1 м/с.
Требуемая площадь сечения: Для пропуска 54 м³/ч при такой скорости необходимо сечение около 150 см².
Подбор диаметра:
Труба Ø125 мм имеет площадь ~122 см² (этого может быть недостаточно при низком атмосферном давлении или малой высоте трубы).
Труба Ø150 мм имеет площадь ~176 см², что полностью перекрывает норматив и является стандартом для таких помещений.
xn--11-6kca3c6bt.xn--p1ai +1
Требования к исполнению
1. Материал: Канал должен быть выполнен из негорючих материалов (оцинкованная сталь, нержавейка). Использование пластика (ПВХ) запрещено.
2. Расположение: Вытяжное отверстие должно находиться в верхней зоне помещения (не ниже 30 см от потолка).
3. Приток: Для работы вытяжки необходим приток воздуха (например, подрез в нижней части двери площадью не менее 0,02 м² или приточный клапан).

Sheet: дерево заказ на 18 апр 2026
Сечение (мм) | количество (шт - м.п) | примечание
50х200х6000 | 25 | стропило не достающее
50х150х6000 | 3 | перемычки
50х50 | 310 м.п | контробрешётка 310/3 = 104 щт
25х100 | 530 м.п | обрешётка 530/6 = 89 шт
25х100 | 120 м.п | ветровая доска - 120/6 = 20 шт
размеры | количество | цена на м3 | объём | сумма (руб)
25х100х6000 | 109 | 26000 | 1.635 | 42510
50х200х6000 | 25 | 26000 | 1.5 | 39000
50х150х6000 | 3 | 26000 | 0.135 | 3510
50х50х3000 | 104 | 26000 | 0.78 | 20280
Итого: |  |  | 4.05 | 105300

Sheet: расчёт кол-ва профилей оконных
 | окно |  |  |  |  |  |  | см |  |  | м
 |  |  | длинна (см) | количество | см |  |  | 1185 | 20 | 1205
150 | 150 | 180 | 480 | 6 | 2880 |  |  | 1300 | 20 | 1320
 |  |  |  |  |  |  |  |  |  | 2525 | 25.25 | 10.1
 | окно малое
150 | 150 | 90 | 390 | 2 | 780
 | дверь-окно на террасу
235 | 235 | 180 | 650 | 1 | 650
 |  |  |  | ИТОГО: | 4310 | 43.1 | 17.95833333
310
