zip1982b/my_home/dxf/floor_plan.dxf

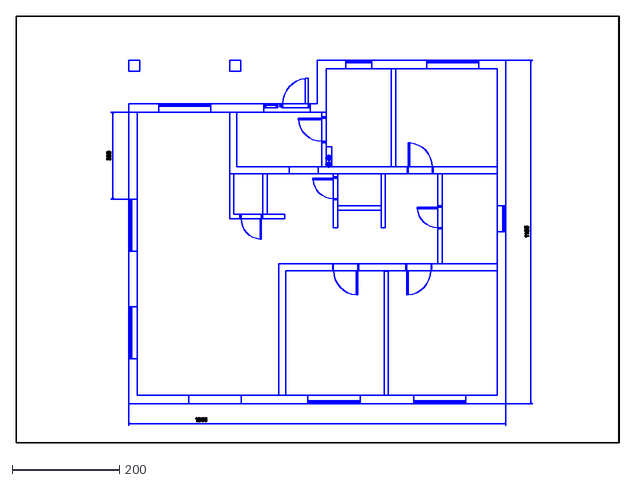
[picture p26: CAD file, 2026-09-24]
dxf/floor_plan.dxf
1122.5 x 793.7
