zip1982b/my_home/профиль.FCStd

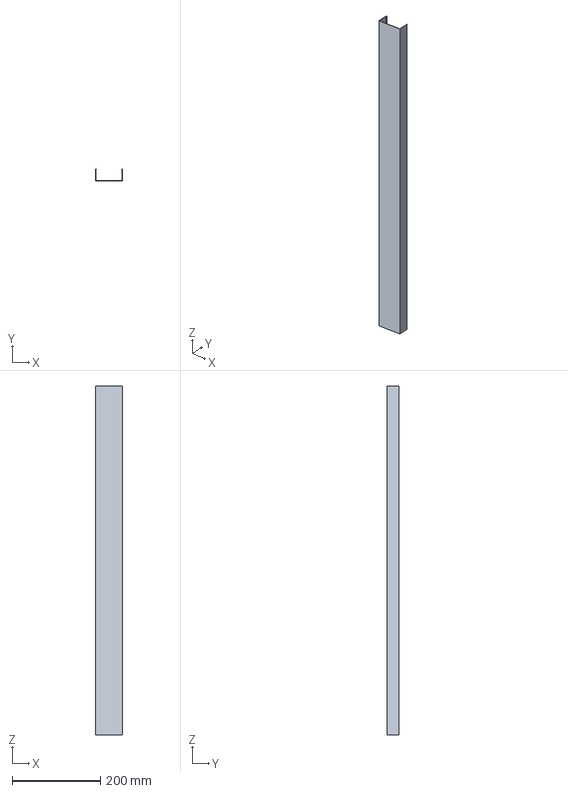
[picture p27: CAD file, 2026-10-23]
профиль.FCStd
60.0 x 27.0 x 790.0 mm
