zip1982b/my_home/дымник для тубы.FCStd

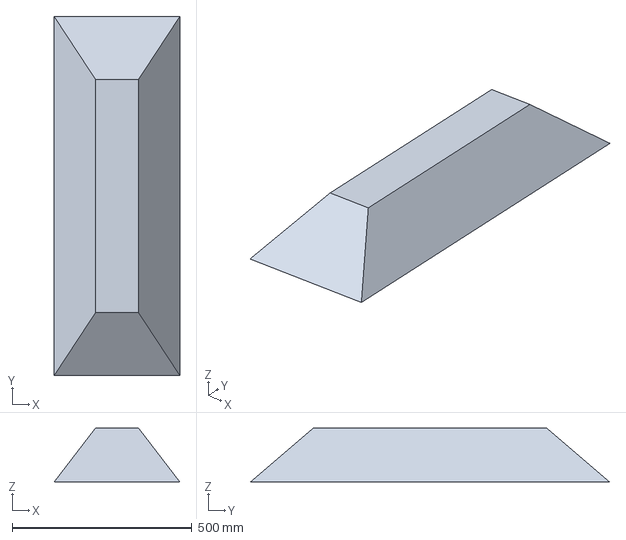
[picture p28: CAD file, 2026-10-17]
дымник для тубы.FCStd
350.0 x 1000.0 x 150.0 mm
