zip1982b/my_home/план2D_вариант вынны 3.FCStd

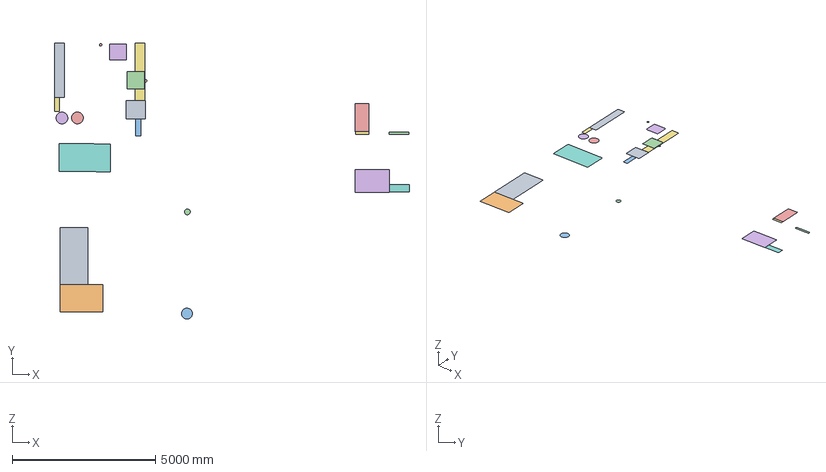
[picture p29: CAD file, 2026-10-13]
план2D_вариант вынны 3.FCStd
12399.4 x 9647.2 x 0 mm
холодильник
вытяжка
духовка
варочная поверхность
стул001
стул
верхние шкафы 35 см
стол 150*100
диван 200см
угол дивана или кресло
дерево
труба от печки
кран
посудомойка
полки для кружек
шкаф-полка для шампуней
подвесные полки
слив на кухне
шкаф под стеклом
Rectangle062
Rectangle063
Rectangle064
Rectangle065
