zip1982b/my_home/план2D_вариант кухни.FCStd

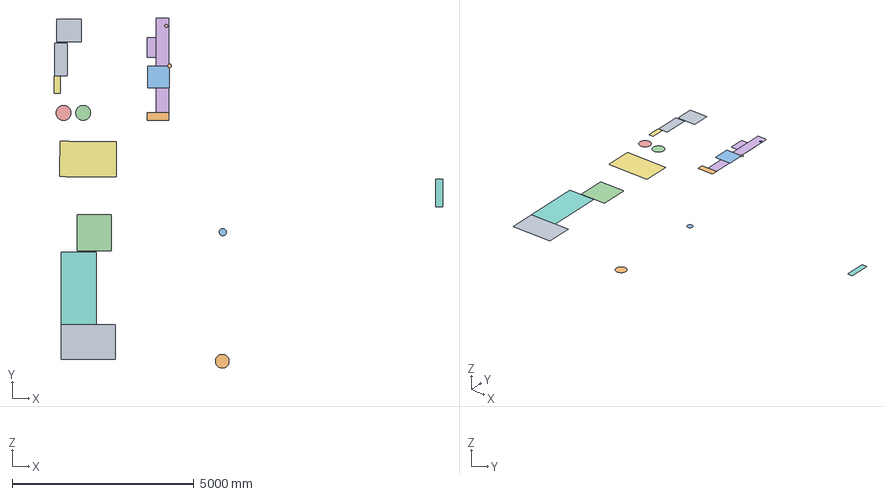
[picture p30: CAD file, 2026-10-11]
план2D_вариант кухни.FCStd
10703.0 x 9641.9 x 0 mm
холодильник
вытяжка
варочная поверхность
стул001
стул
верхние шкафы 35 см
стол 150*100
диван 200см
угол дивана или кресло
дерево
труба от печки
кресло
кран
посудомойка
полки для кружек
шкаф-полка для шампуней
подвесные полки
прозрачный шкаф для посуды
