zip1982b/my_home/план2D.FCStd

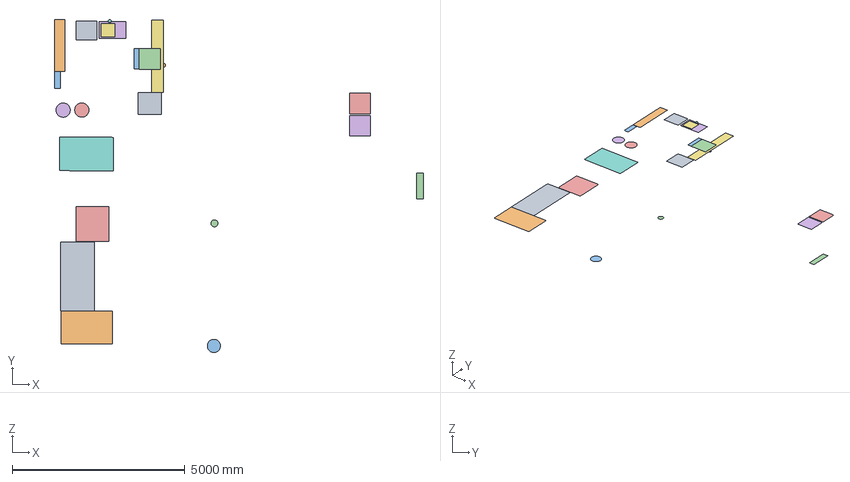
[picture p31: CAD file, 2026-10-11]
план2D.FCStd
10691.5 x 9651.1 x 0 mm
холодильник
вытяжка
духовка
варочная поверхность
стул001
стул
верхние шкафы 35 см
стол 150*100
диван 200см
угол дивана или кресло
дерево
труба от печки
кресло
раковина001
углубление в раковине
кран
посудомойка
шкафы 30см
полки для кружек
шкаф-полка для шампуней
стиралка001
сушилка001
