zip1982b/my_home/дом_стропильная_система.FCStd

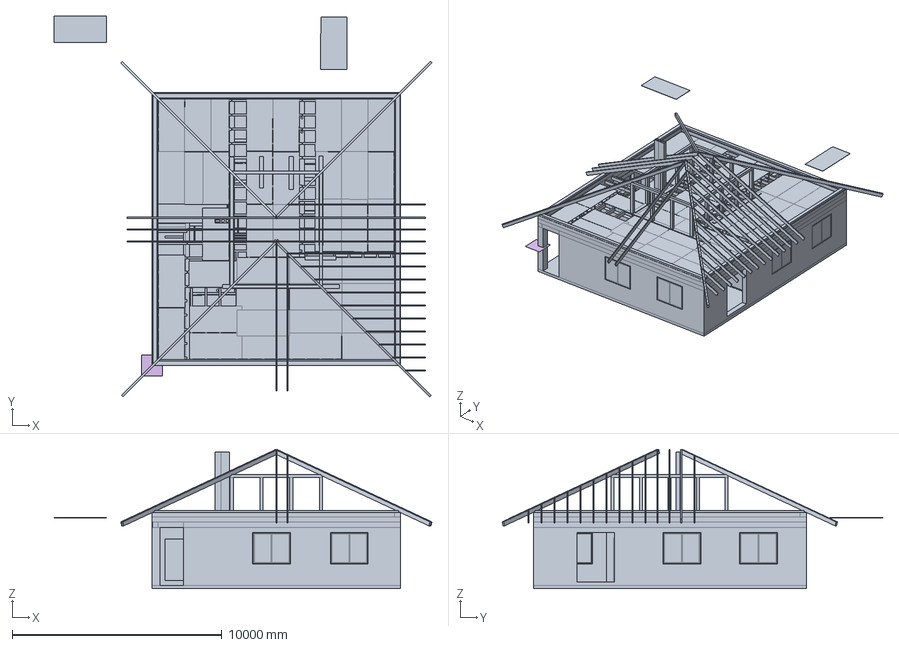
[picture p32: CAD file, 2026-10-09]
дом_стропильная_система.FCStd
18001.4 x 18131.9 x 6642.9 mm
Дом
BottomRebar
Stirrup001
TopRebar
StraightRebar
StraightRebar001
Stirrup002
StraightRebar002
StraightRebar003
Stirrup003
StraightRebar004
StraightRebar005
Stirrup004
StraightRebar006
StraightRebar007
Stirrup005
StraightRebar008
StraightRebar009
Stirrup006
StraightRebar010
StraightRebar011
Stirrup007
StraightRebar012
StraightRebar013
Stirrup008
StraightRebar014
StraightRebar015
Stirrup009
StraightRebar016
StraightRebar017
Stirrup010
StraightRebar018
StraightRebar019
Stirrup011
StraightRebar020
StraightRebar021
Stirrup
Разрез (Сечение)
левый L уголок
