zip1982b/my_home/каркас.FCStd

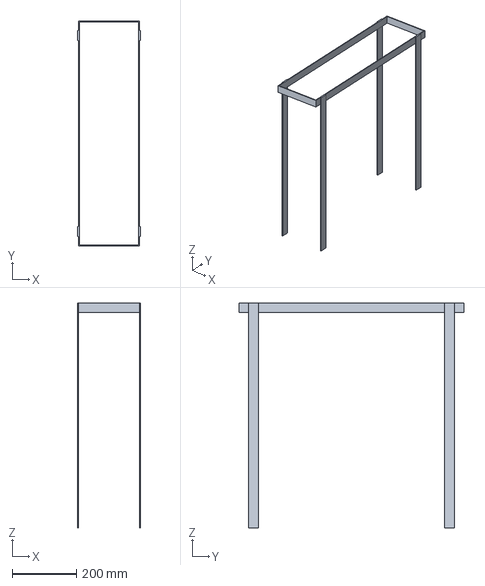
[picture p33: CAD file, 2026-10-03]
каркас.FCStd
196.0 x 700.0 x 700.0 mm
