zip1982b/my_home/труба_вентиляция.FCStd

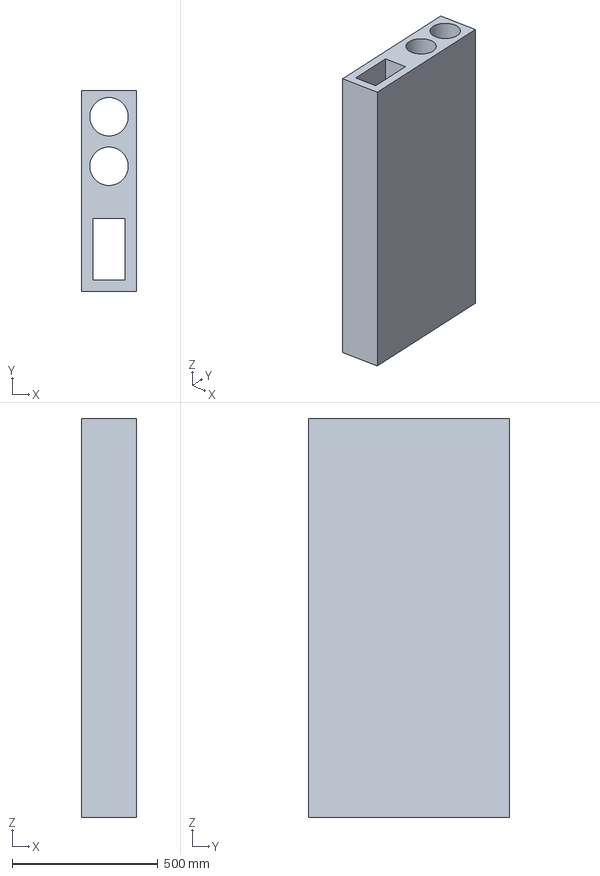
[picture p34: CAD file, 2026-09-02]
труба_вентиляция.FCStd
190.0 x 690.0 x 1370.0 mm
