zip1982b/my_home/утеплитель Технониколь Роклайт 50.FCStd

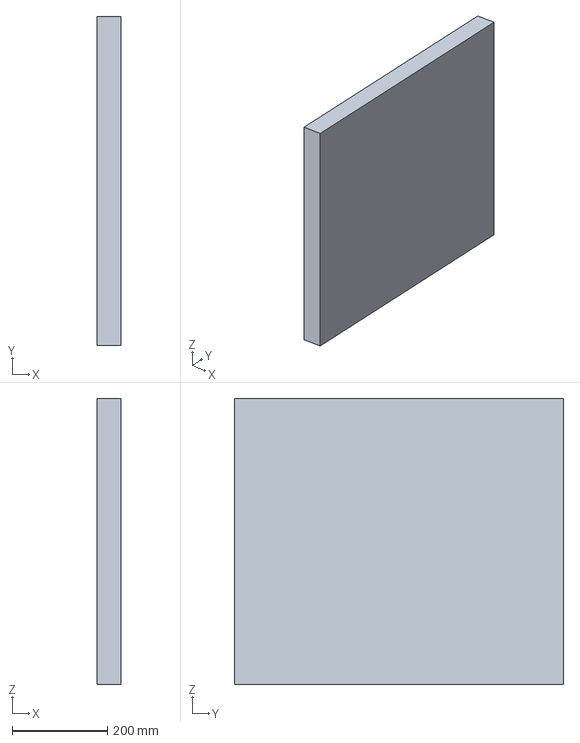
[picture p35: CAD file, 2026-09-02]
утеплитель Технониколь Роклайт 50.FCStd
50.0 x 690.0 x 600.0 mm
