zip1982b/my_home/Гильза Нерж.FCStd

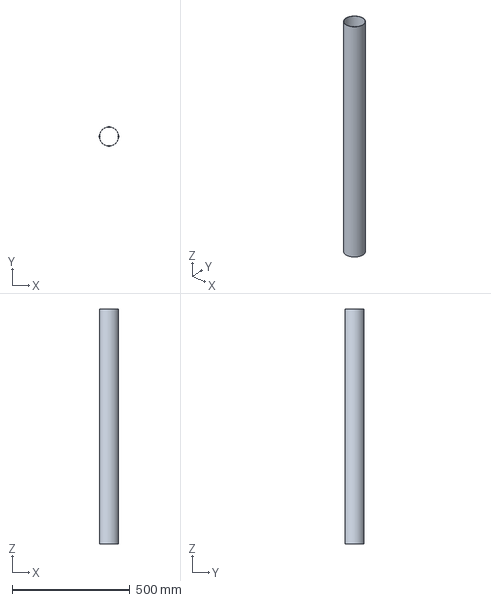
[picture p36: CAD file, 2026-09-02]
Гильза Нерж.FCStd
81.9 x 82.0 x 1000.0 mm
