zip1982b/my_home/утеплитель Технониколь Роклайт 50 фронтальная часть.FCStd

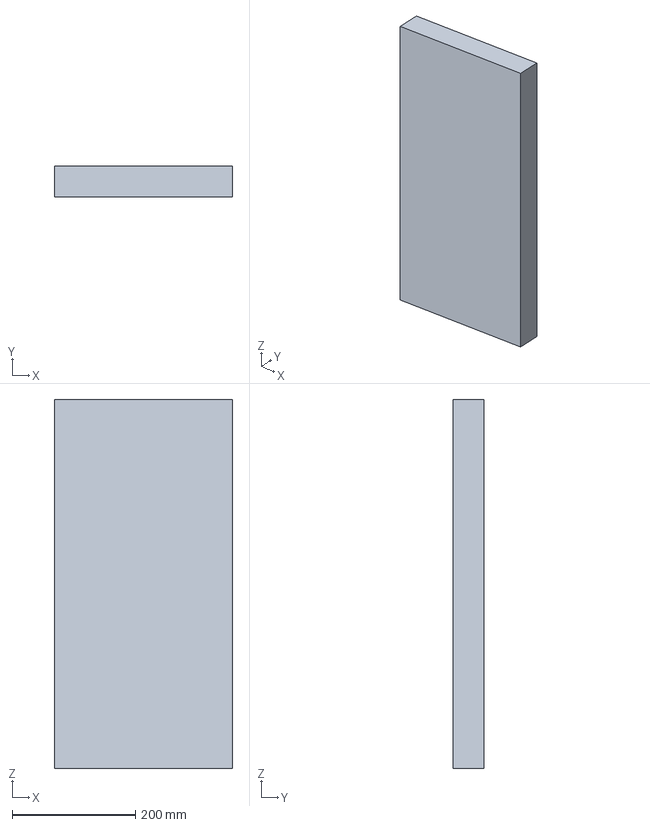
[picture p37: CAD file, 2026-09-02]
утеплитель Технониколь Роклайт 50 фронтальная часть.FCStd
290.0 x 50.0 x 600.0 mm
