zip1982b/my_home/утеплитель Технониколь Роклайт 50 фронтальная часть добор.FCStd

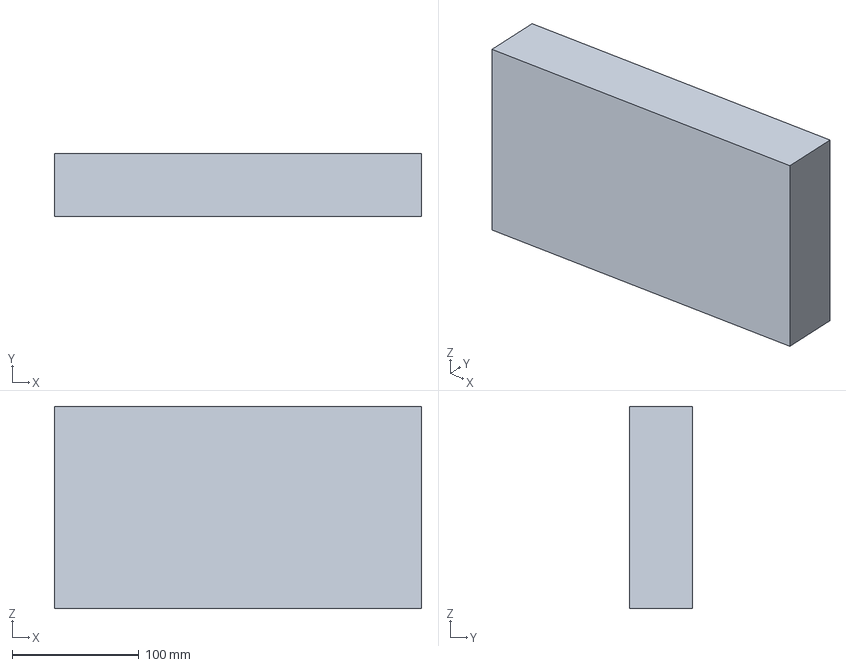
[picture p38: CAD file, 2026-09-02]
утеплитель Технониколь Роклайт 50 фронтальная часть добор.FCStd
290.0 x 50.0 x 160.0 mm
