zip1982b/my_home/утеплитель Технониколь Роклайт 50 боковая часть добор.FCStd

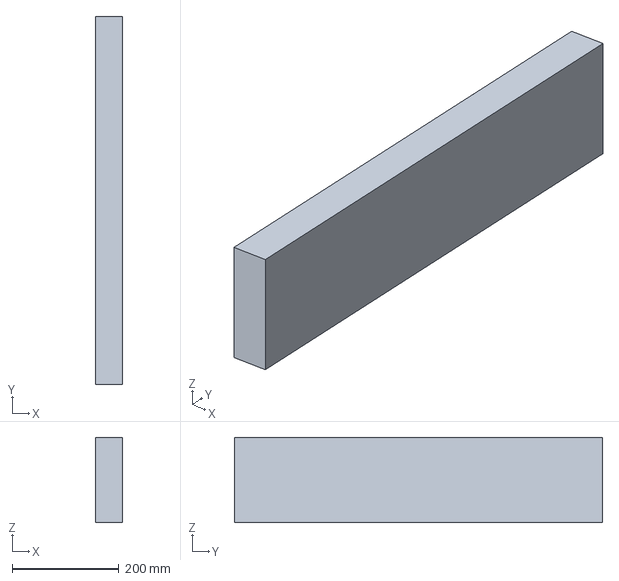
[picture p39: CAD file, 2026-09-02]
утеплитель Технониколь Роклайт 50 боковая часть добор.FCStd
50.0 x 690.0 x 160.0 mm
