zip1982b/my_home/стройка для дымника.FCStd

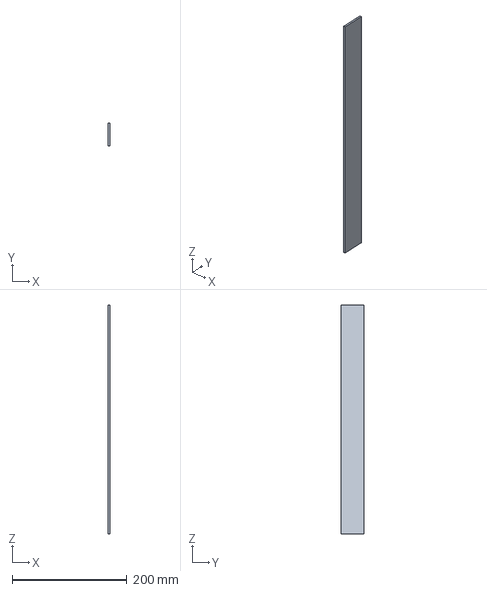
[picture p40: CAD file, 2026-09-02]
стройка для дымника.FCStd
3.00 x 40.0 x 400.0 mm
