zip1982b/my_home/car_port.FCStd

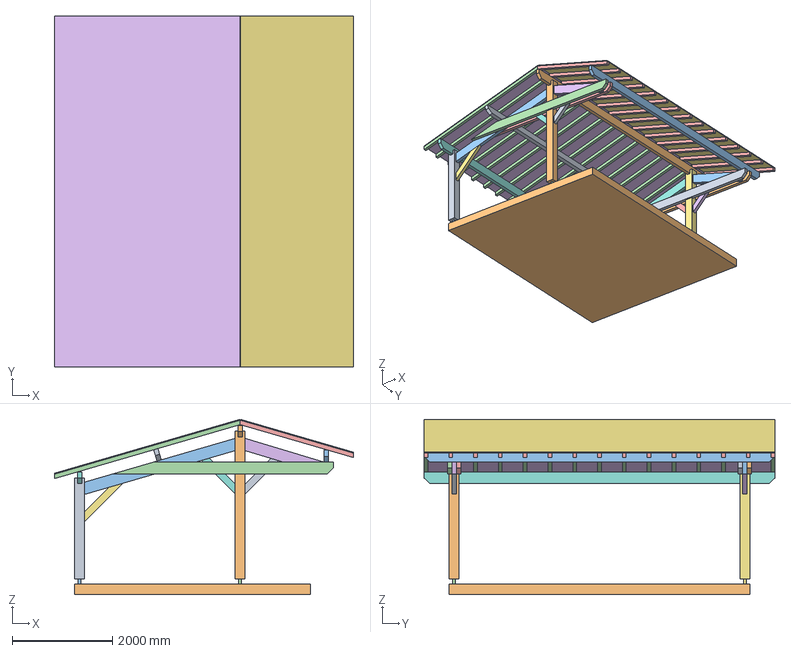
[picture p41: CAD file, 2026-02-21]
car_port.FCStd
5966.9 x 7000.0 x 3496.4 mm
Задняя_стойка
Передняя_стойка
Задняя_стропильная_балка
Правая_поперечная_балка
Левая_поперечная_балка
Передняя_стропильная_балка
Задняя_распорка
Средняя_распорка
Передняя_распорка
Плита
Задняя_стойка1
Передняя_стойка1
Балка_1
Балка_2
Балка_3
Балка_4
кровельные_обрешётки_задние
кровельные_обрешётки_передние
OSB_back
OSB_front
