zip1982b/my_home/дом.FCStd

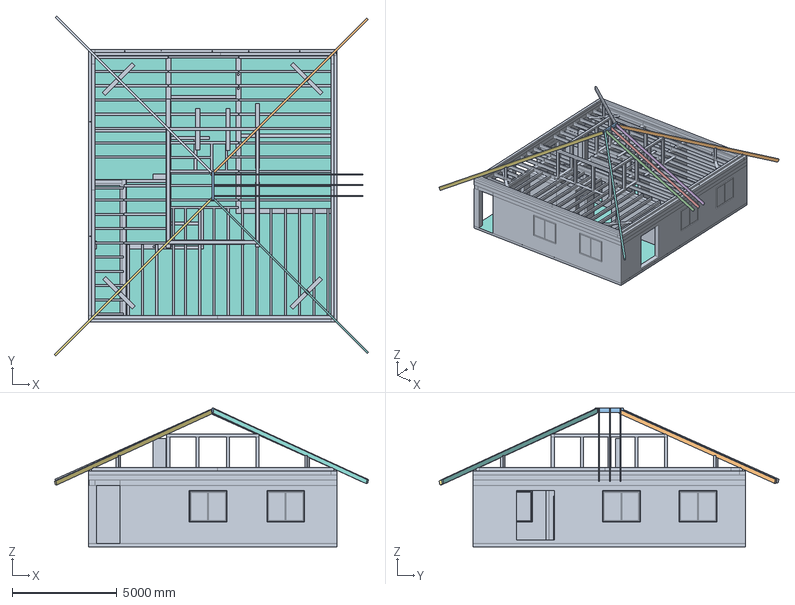
[picture p42: CAD file, 2025-10-12]
дом.FCStd
14976.4 x 16210.5 x 6610.0 mm
Дом
BottomRebar
Stirrup001
TopRebar
StraightRebar
StraightRebar001
Stirrup002
StraightRebar004
StraightRebar005
Stirrup004
StraightRebar006
StraightRebar007
Stirrup005
StraightRebar008
StraightRebar009
Stirrup006
StraightRebar010
StraightRebar011
Stirrup007
StraightRebar012
StraightRebar013
Stirrup008
StraightRebar014
StraightRebar015
Stirrup009
StraightRebar016
StraightRebar017
Stirrup010
StraightRebar018
StraightRebar019
Stirrup011
StraightRebar020
StraightRebar021
Stirrup
StraightRebar022
StraightRebar023
Stirrup012
StraightRebar024
StraightRebar025
Stirrup013
StraightRebar026
StraightRebar027
Stirrup014
StraightRebar028
StraightRebar029
Stirrup015
Диагональная нога 1
Диагональная нога 2
Диагональная нога 3
Диагональная нога 4
конёк
стропильная нога1
стропильная нога2
стропильная нога3
