zip1982b/my_home/шагающие леса.FCStd

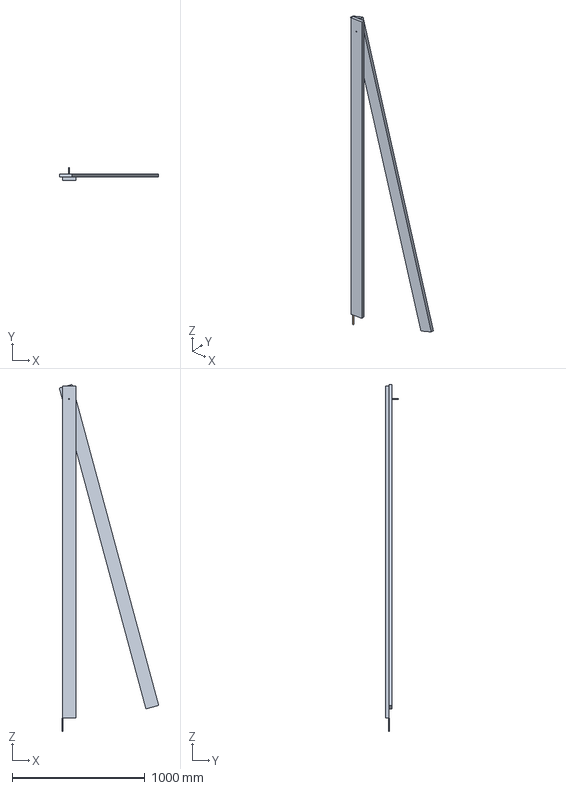
[picture p43: CAD file, 2025-06-22]
шагающие леса.FCStd
748.2 x 100.0 x 2609.6 mm
Тело x 3
M8x100-Шпилька x 2
