zip1982b/my_home/участок - забор.FCStd

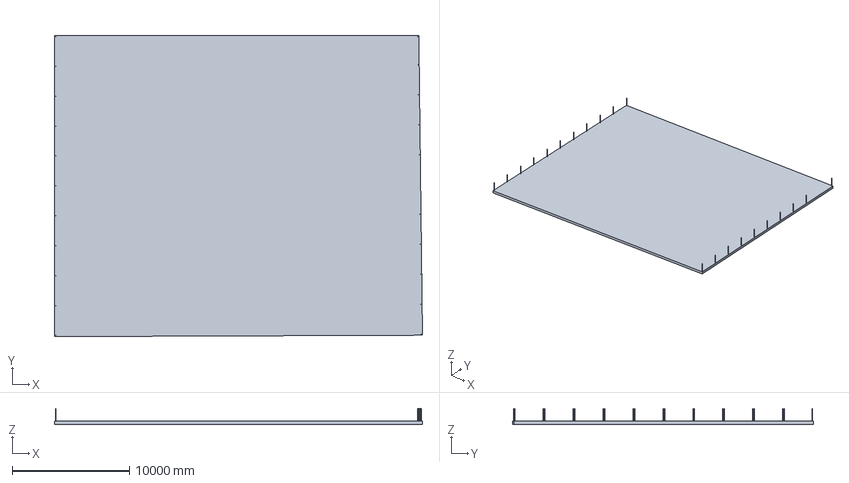
[picture p44: CAD file, 2025-03-14]
участок - забор.FCStd
31370.0 x 25680.0 x 1370.0 mm
участок
угловые столбы
