zip1982b/my_home/Туалет.FCStd

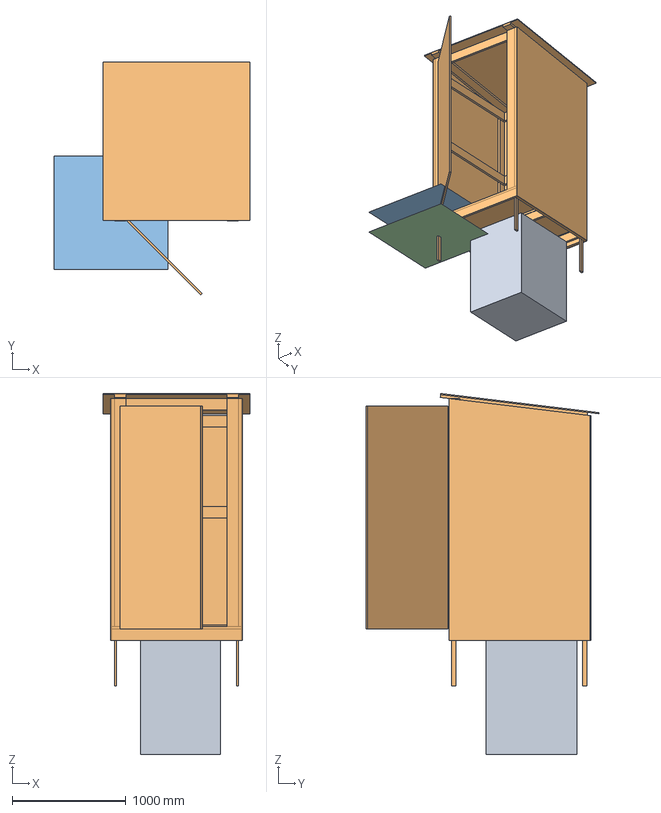
[picture p45: CAD file, 2025-03-10]
Туалет.FCStd
1720.0 x 2045.9 x 3168.8 mm
Уровень ямы
Уровень пола
Разрез (Сечение)
Разрез (Сечение)001
