zip1982b/my_home/вент блок.FCStd

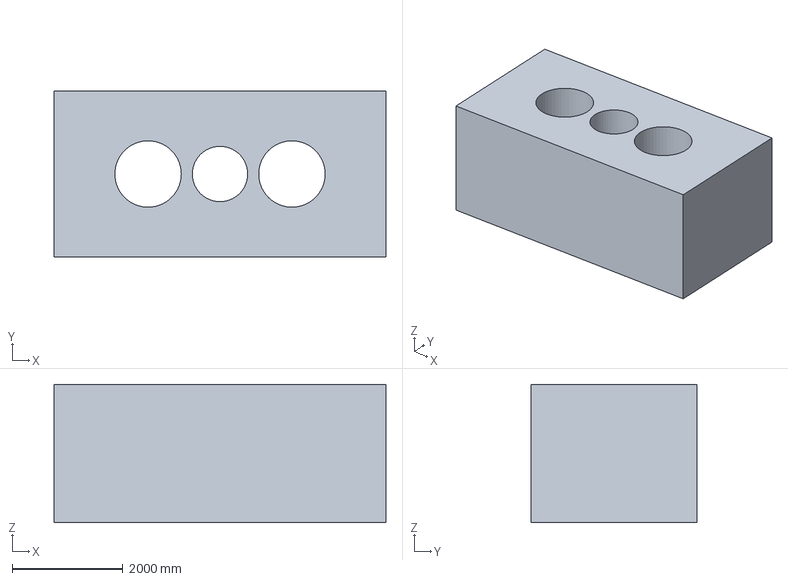
[picture p46: CAD file, 2025-02-02]
вент блок.FCStd
6000.0 x 3000.0 x 2500.0 mm
