zip1982b/my_home/плита.FCStd

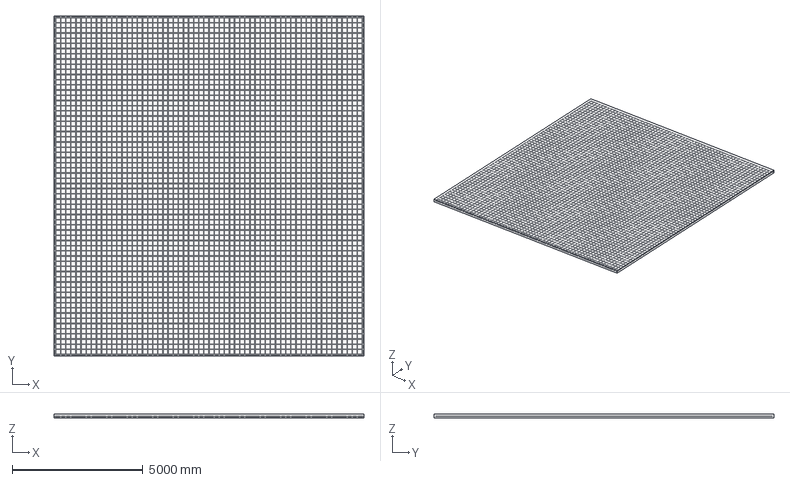
[picture p47: CAD file, 2024-10-17]
плита.FCStd
11850.0 x 13000.0 x 150.0 mm
StraightRebar
StraightRebar001
