zip1982b/my_home/арматура.FCStd

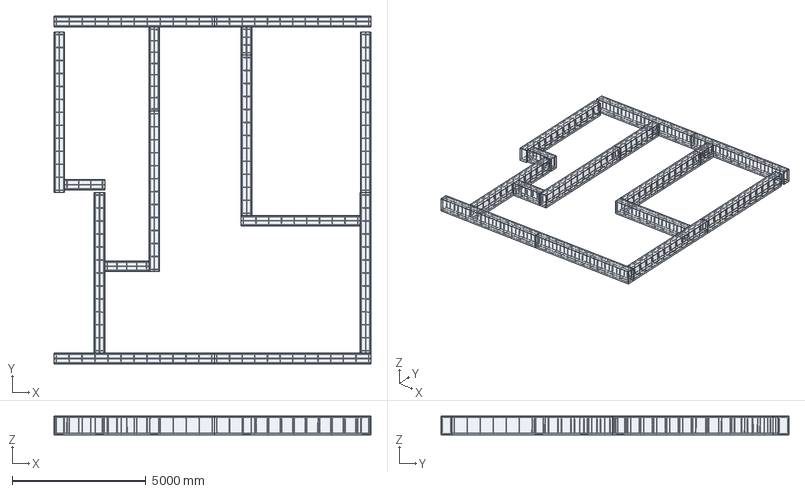
[picture p48: CAD file, 2024-04-22]
арматура.FCStd
11851.0 x 13000.0 x 700.0 mm
Структура
Нижняя_рабочая
Верхняя_рабочая
Хомуты
Структура001
Нижняя_рабочая001
Верхняя_рабочая001
Хомуты001
Структура003
Нижняя_рабочая003
Верхняя_рабочая003
Хомуты003
Структура004
Нижняя_рабочая004
Верхняя_рабочая004
Хомуты004
Структура005
Нижняя_рабочая005
Верхняя_рабочая005
Хомуты005
Структура006
Нижняя_рабочая006
Верхняя_рабочая006
Хомуты006
Структура007
Нижняя_рабочая007
Верхняя_рабочая007
Хомуты007
Структура008
Нижняя_рабочая008
Верхняя_рабочая008
Хомуты008
Структура009
Нижняя_рабочая009
Верхняя_рабочая009
Хомуты009
Структура010
Нижняя_рабочая010
Верхняя_рабочая010
Хомуты010
Структура011
Нижняя_рабочая011
Верхняя_рабочая011
Хомуты011
Структура012
Нижняя_рабочая012
Верхняя_рабочая012
Хомуты012
Структура013
Нижняя_рабочая013
Верхняя_рабочая013
Хомуты013
Структура014
Нижняя_рабочая014
Верхняя_рабочая014
Хомуты014
Структура015
Нижняя_рабочая015
Верхняя_рабочая015
Хомуты015
