zip1982b/my_home/(list of files, cad)

Other CAD files:
Утепление трубы дома.FCStd
план2D_вариант кухни2.FCStd
Безымянный.FCStd
