zip1982b/my_home/pdf/каркас_стойка для дымника вид сверху__.pdf

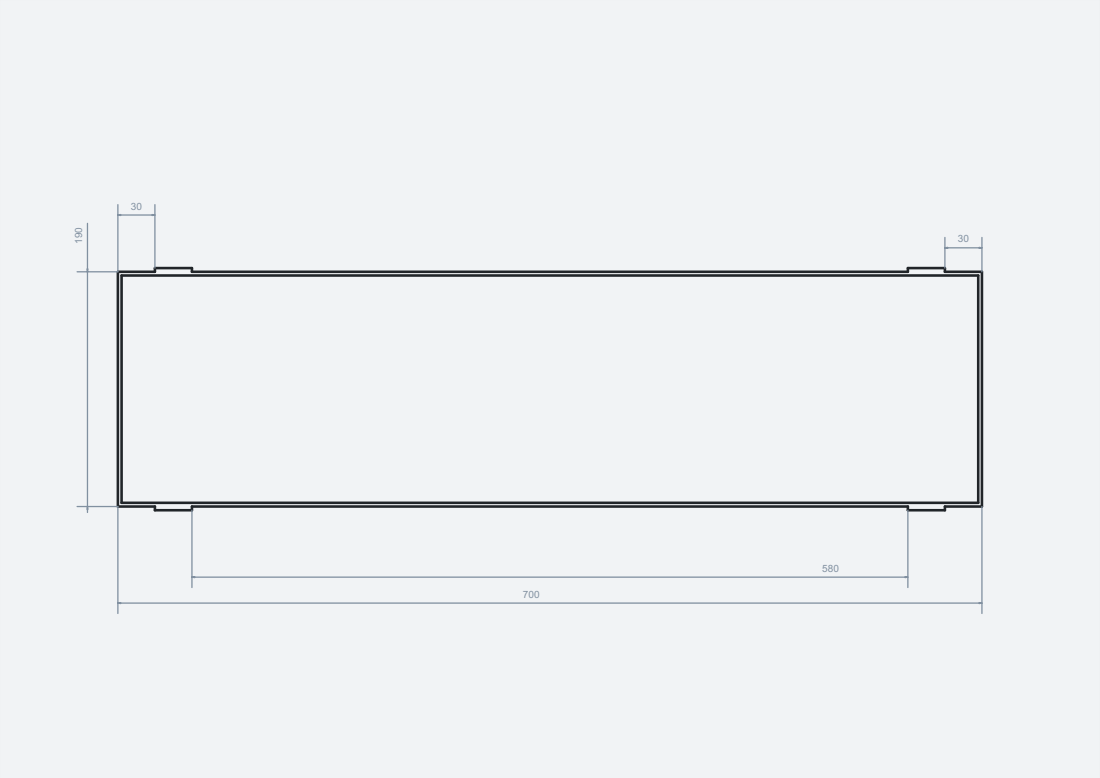
[picture p49: page 1]
