zip1982b/my_home/pdf/стойка для дымника.pdf

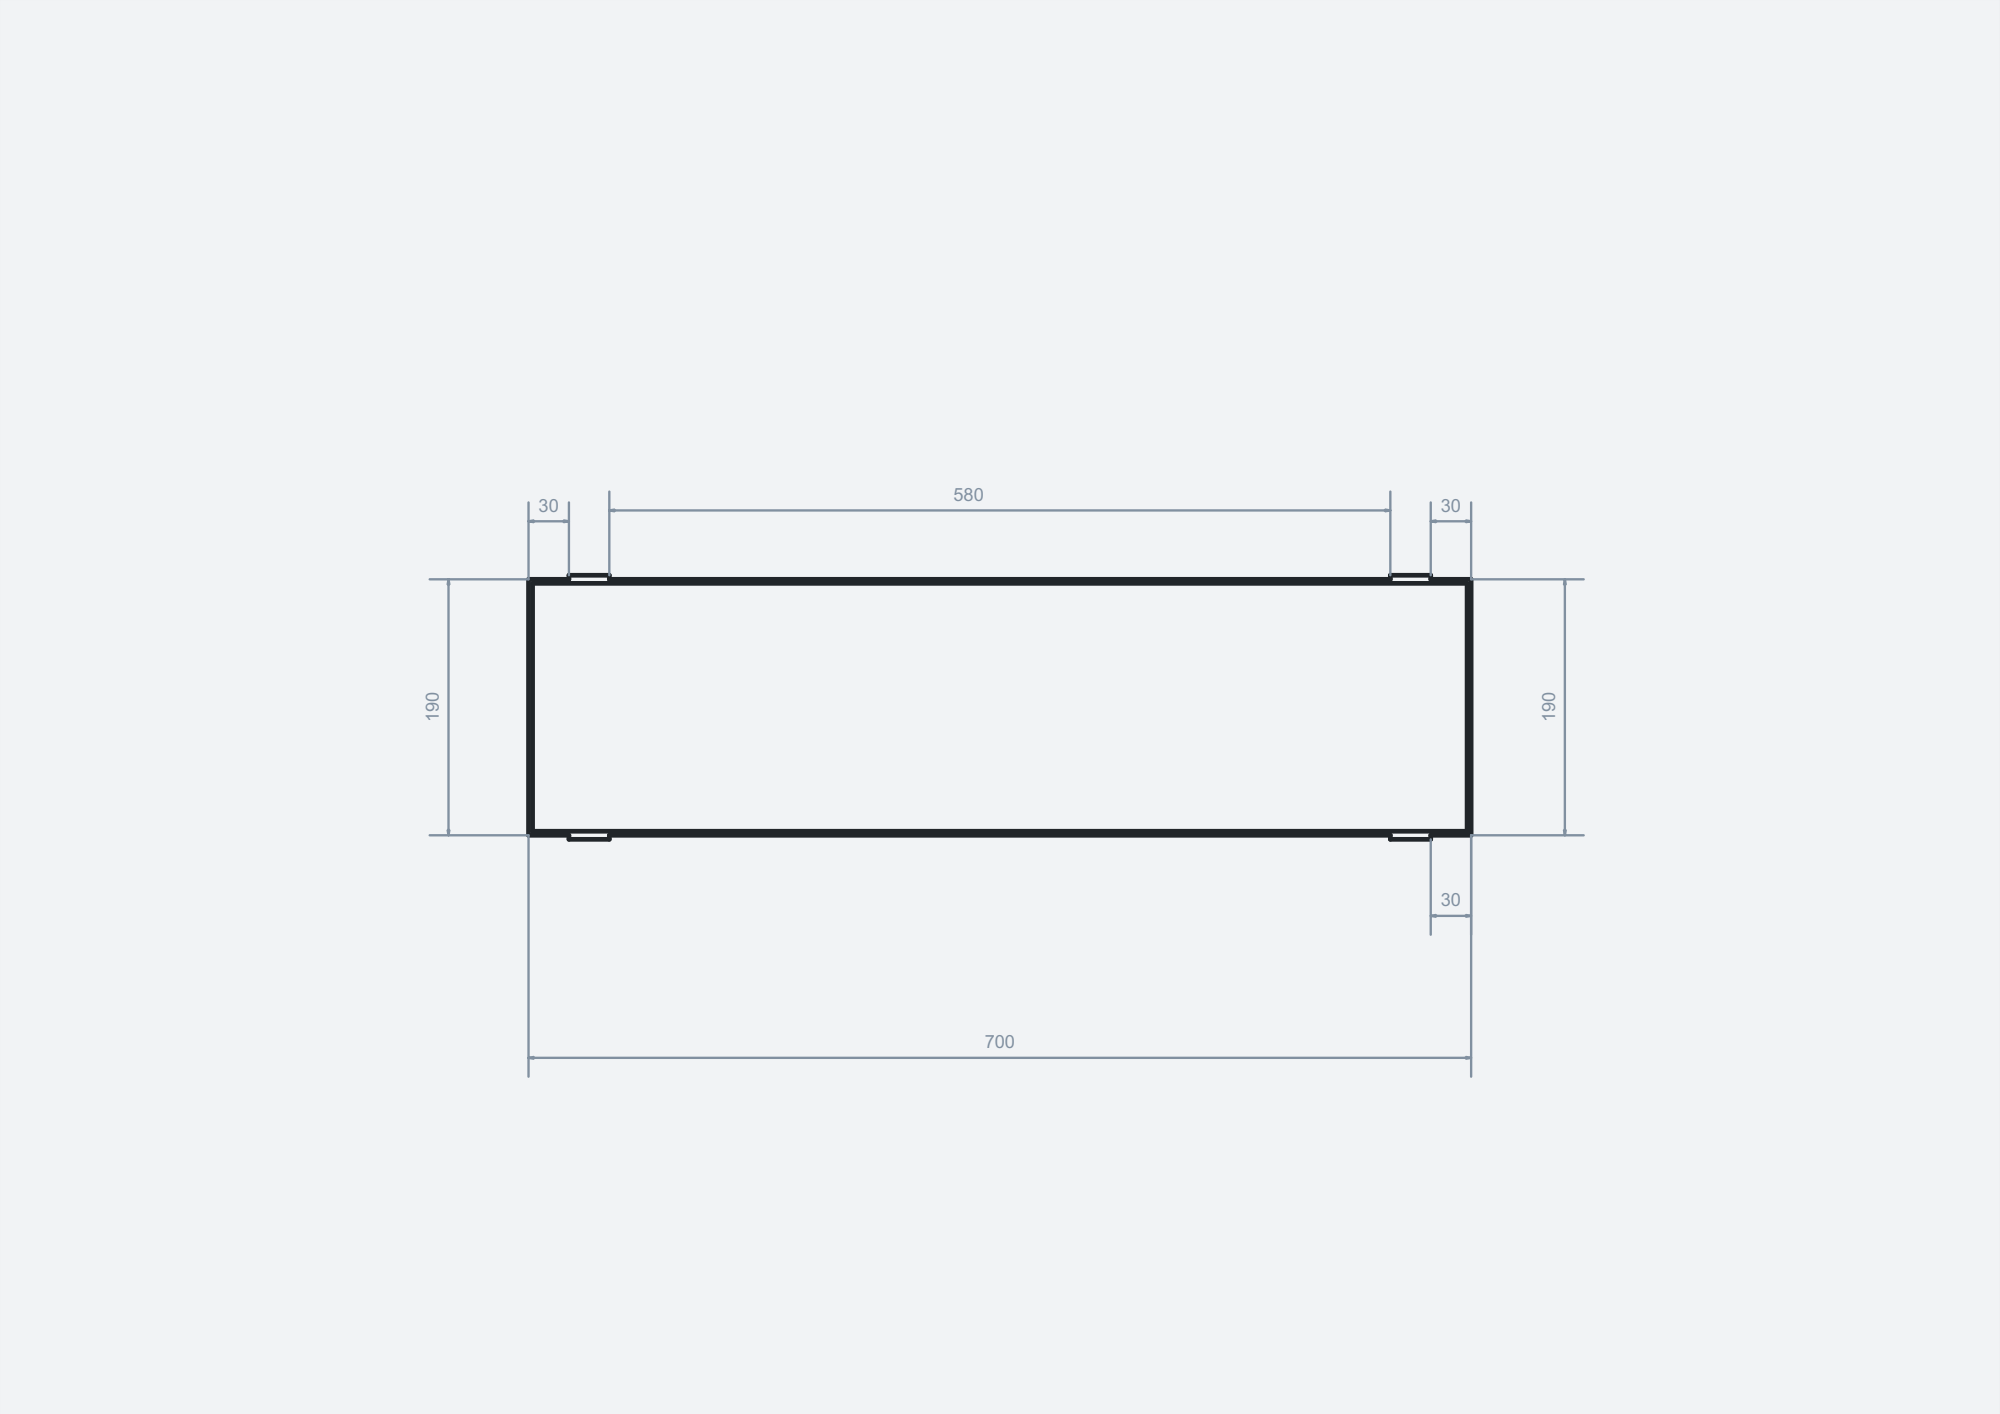
[picture p50: page 1]
