zip1982b/my_home/pdf/floor_plan.pdf

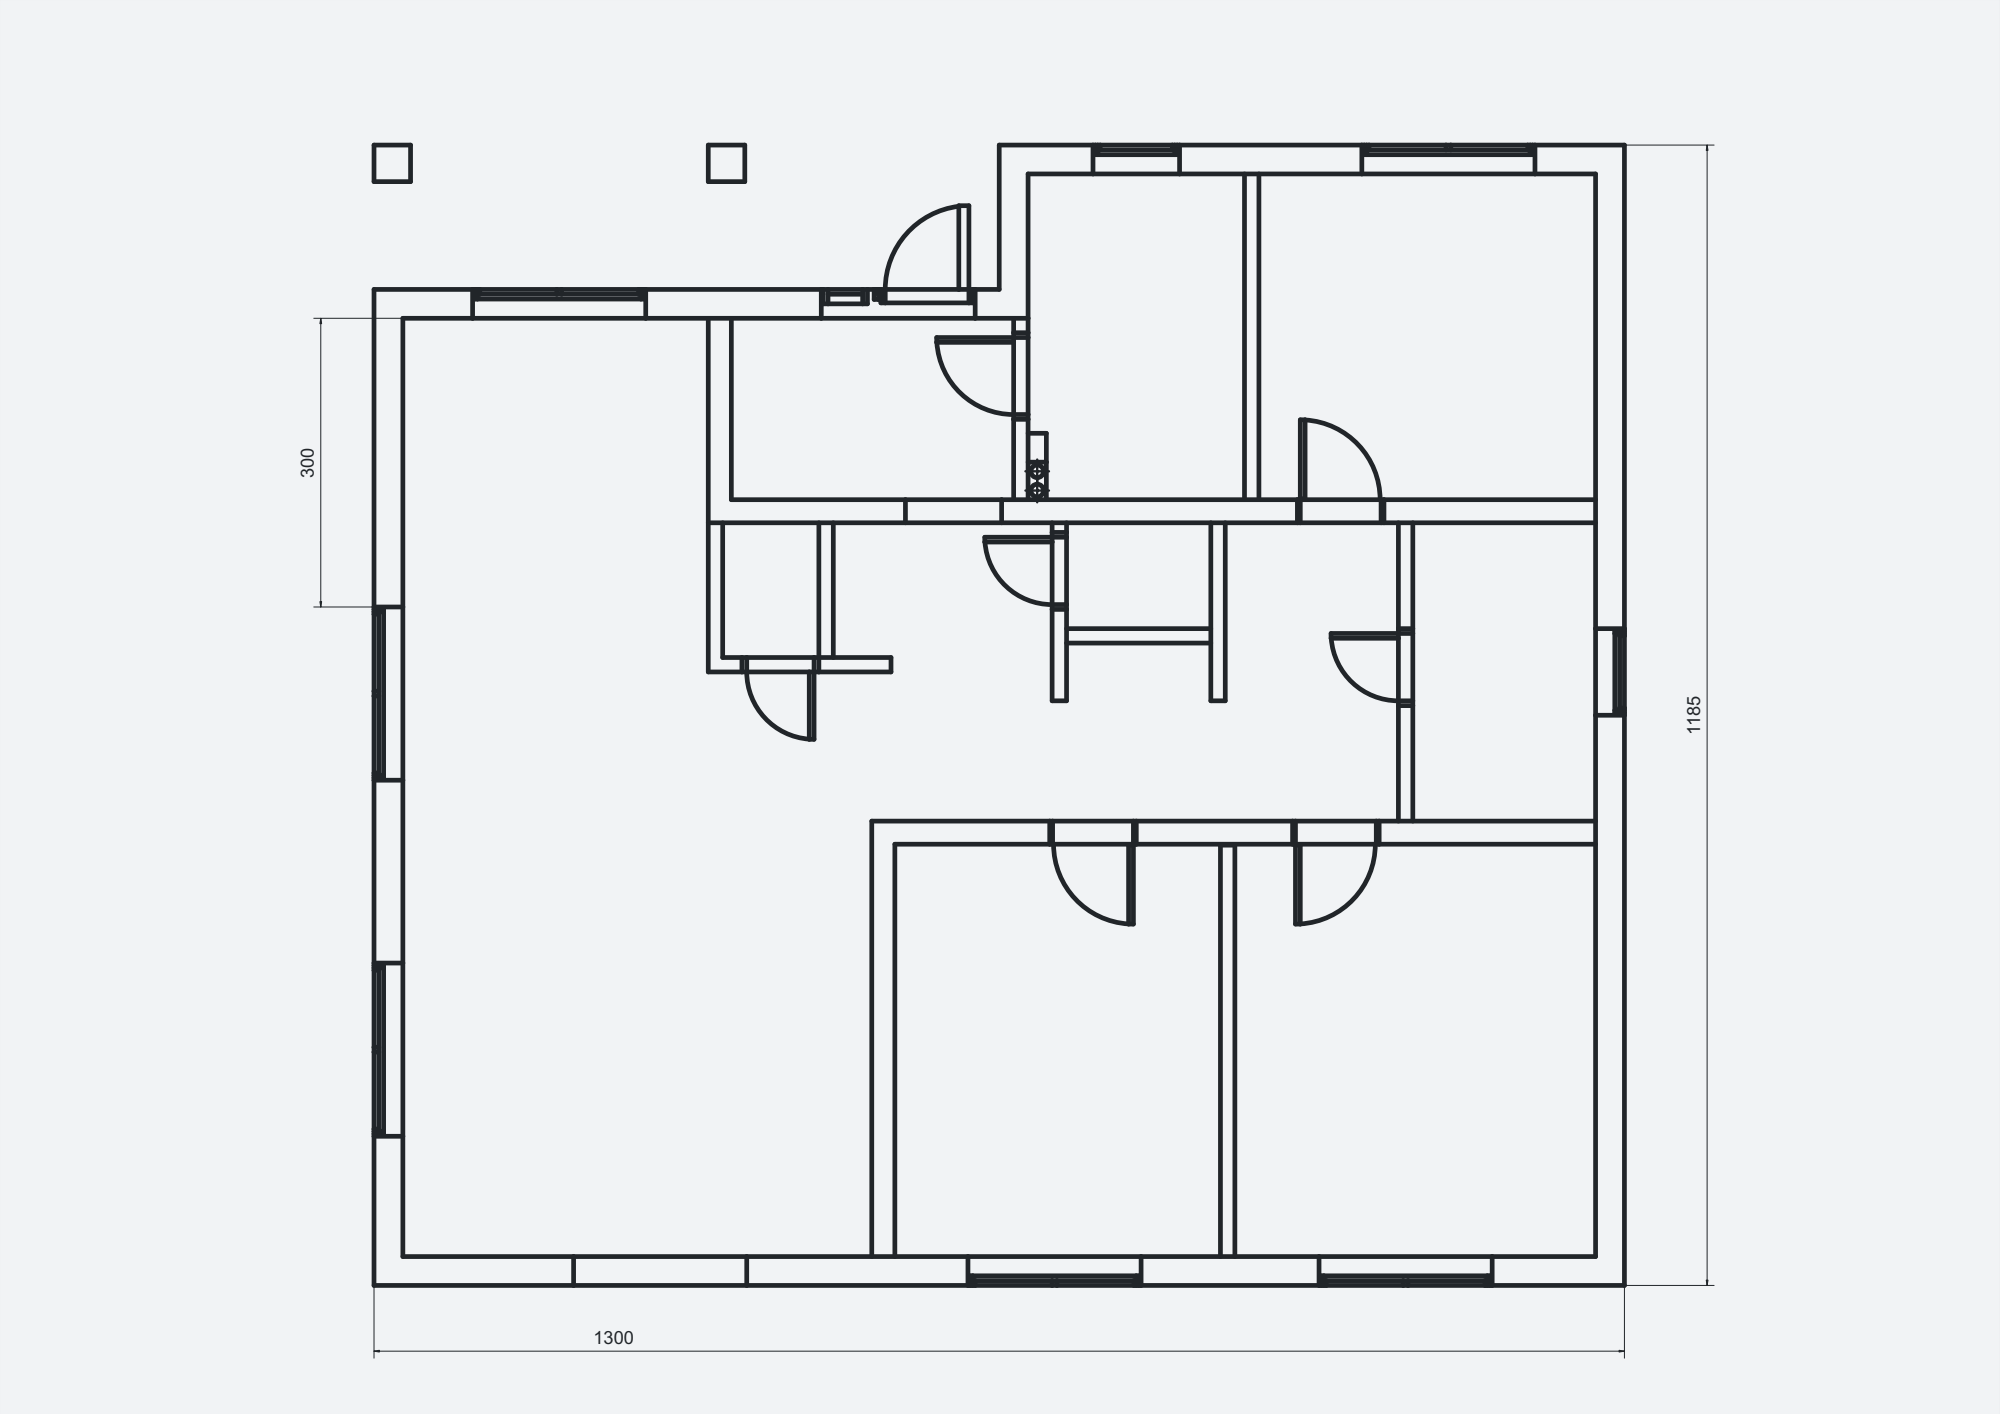
[picture p51: page 1]
