zip1982b/my_home/pdf/дом_стропильная_система_план этажа_внутрен_размеры.pdf

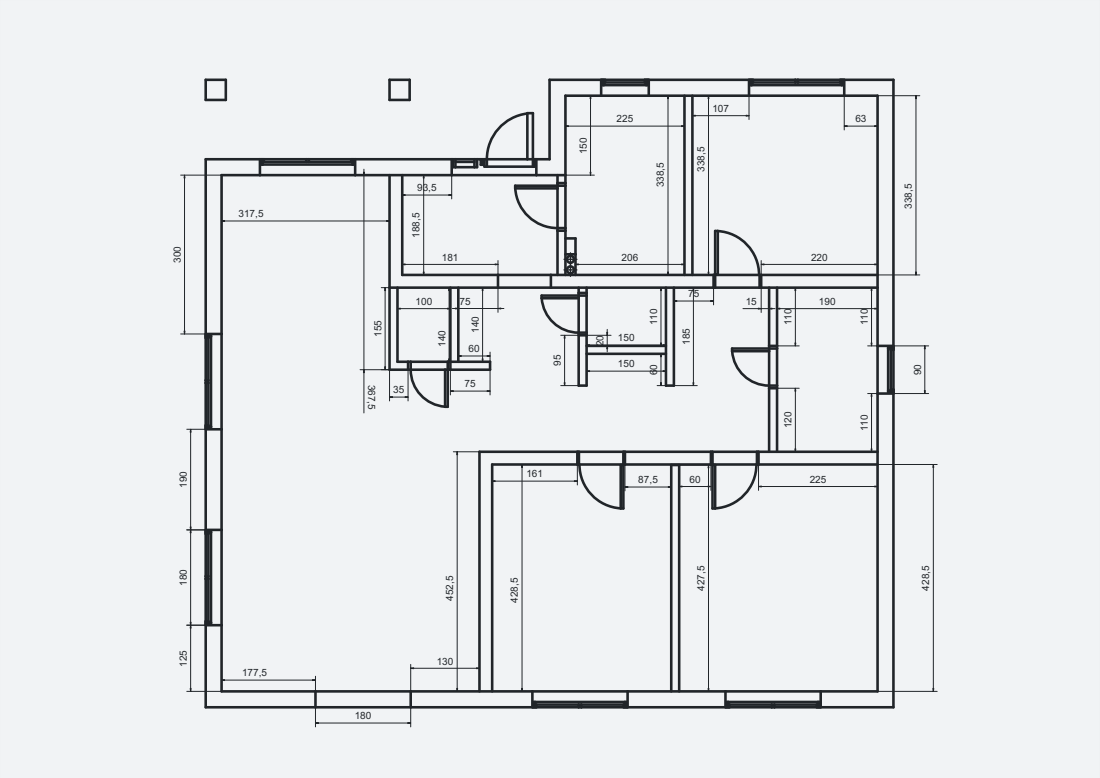
[picture p52: page 1]
