zip1982b/my_home/pdf/дом_стропильная_система_План_этажа__кухня.pdf

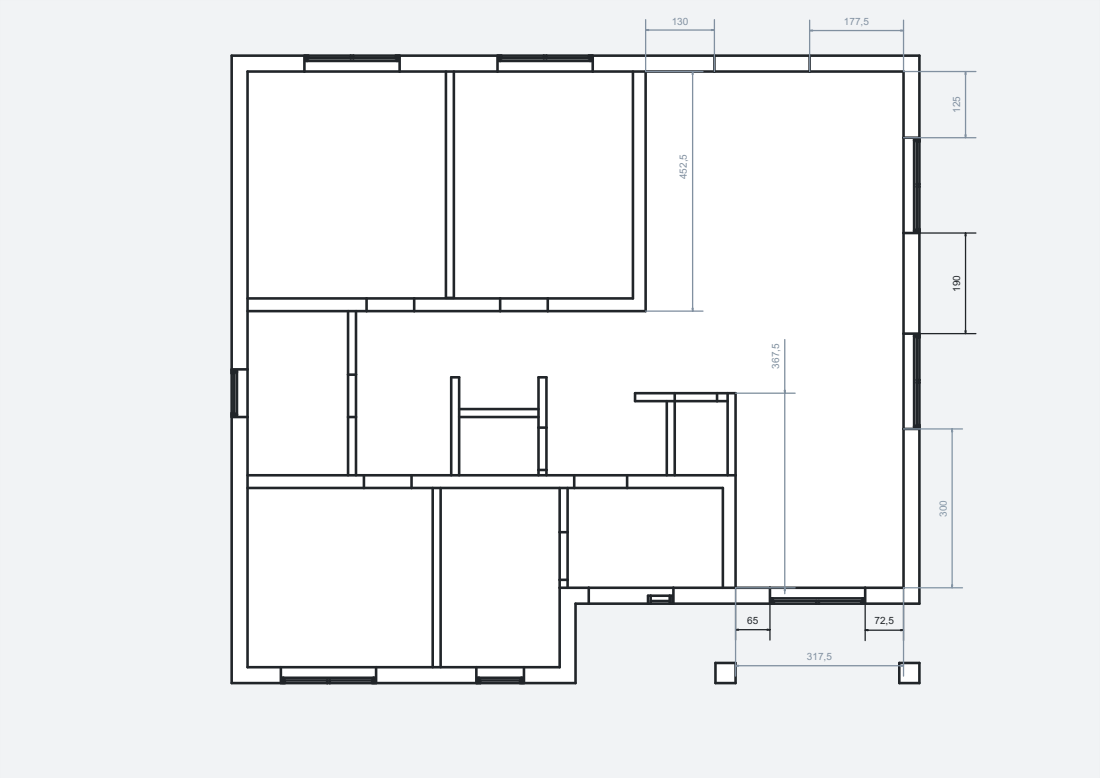
[picture p53: page 1]
