zip1982b/my_home/pdf/дом_стропильная_система_План_этажа__1.pdf

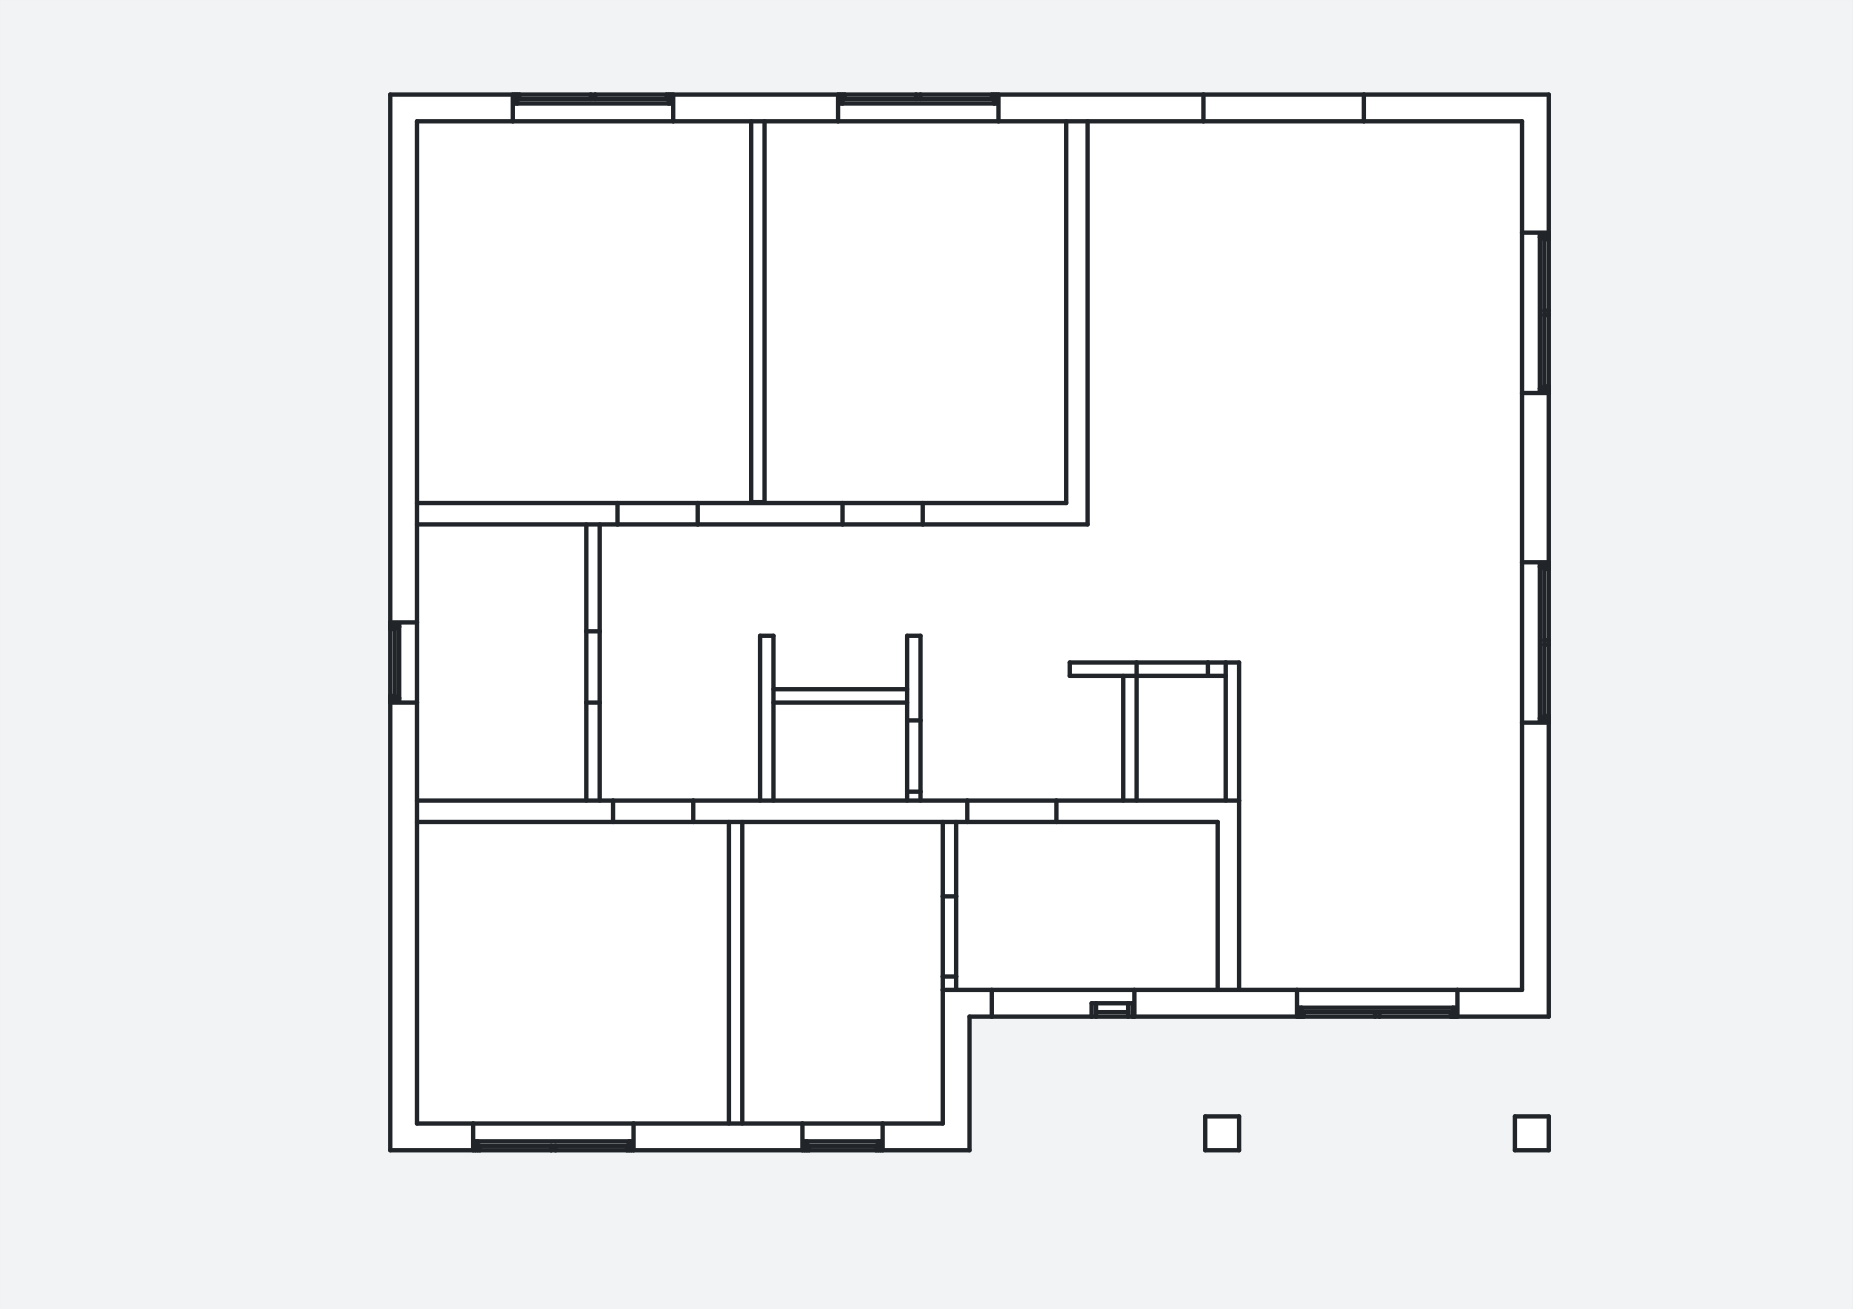
[picture p54: page 1]
