zip1982b/my_home/pdf/дом_стропильная_система_План_этажа__.pdf

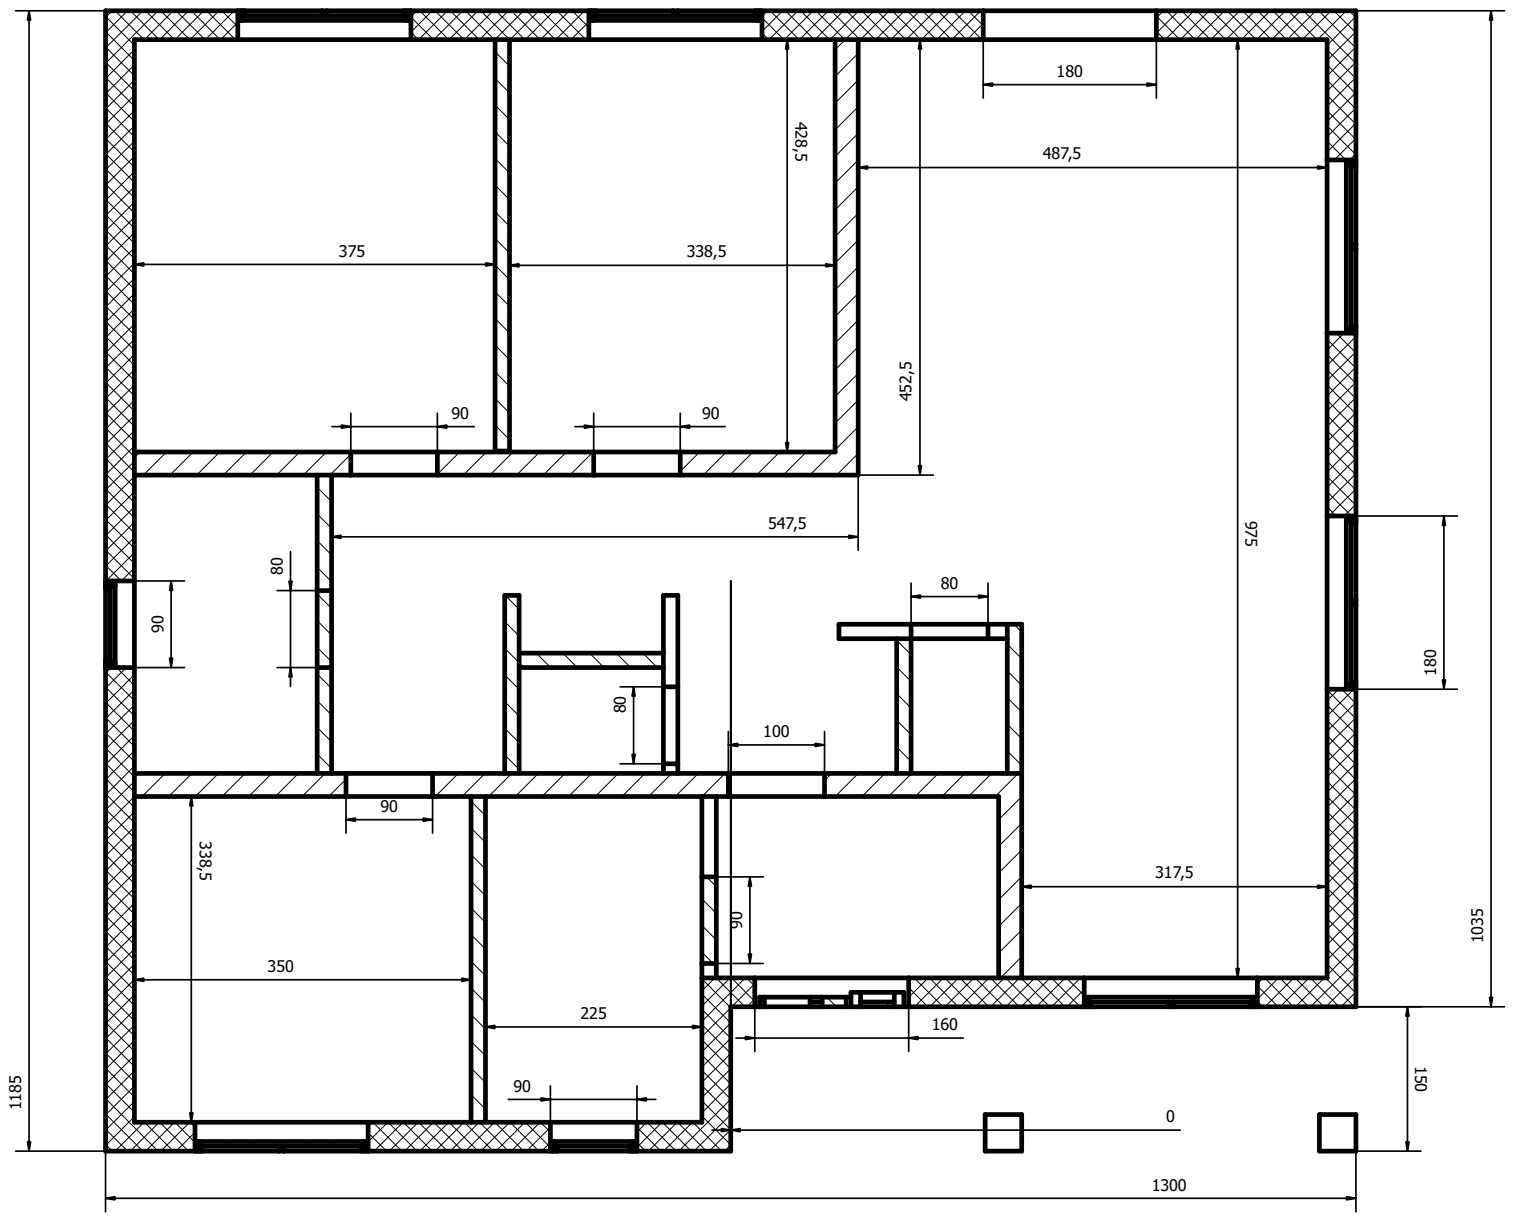
[picture p55: page 1]
