zip1982b/my_home/pdf/дом_стропильная_система_План_этажа__перегородки.pdf

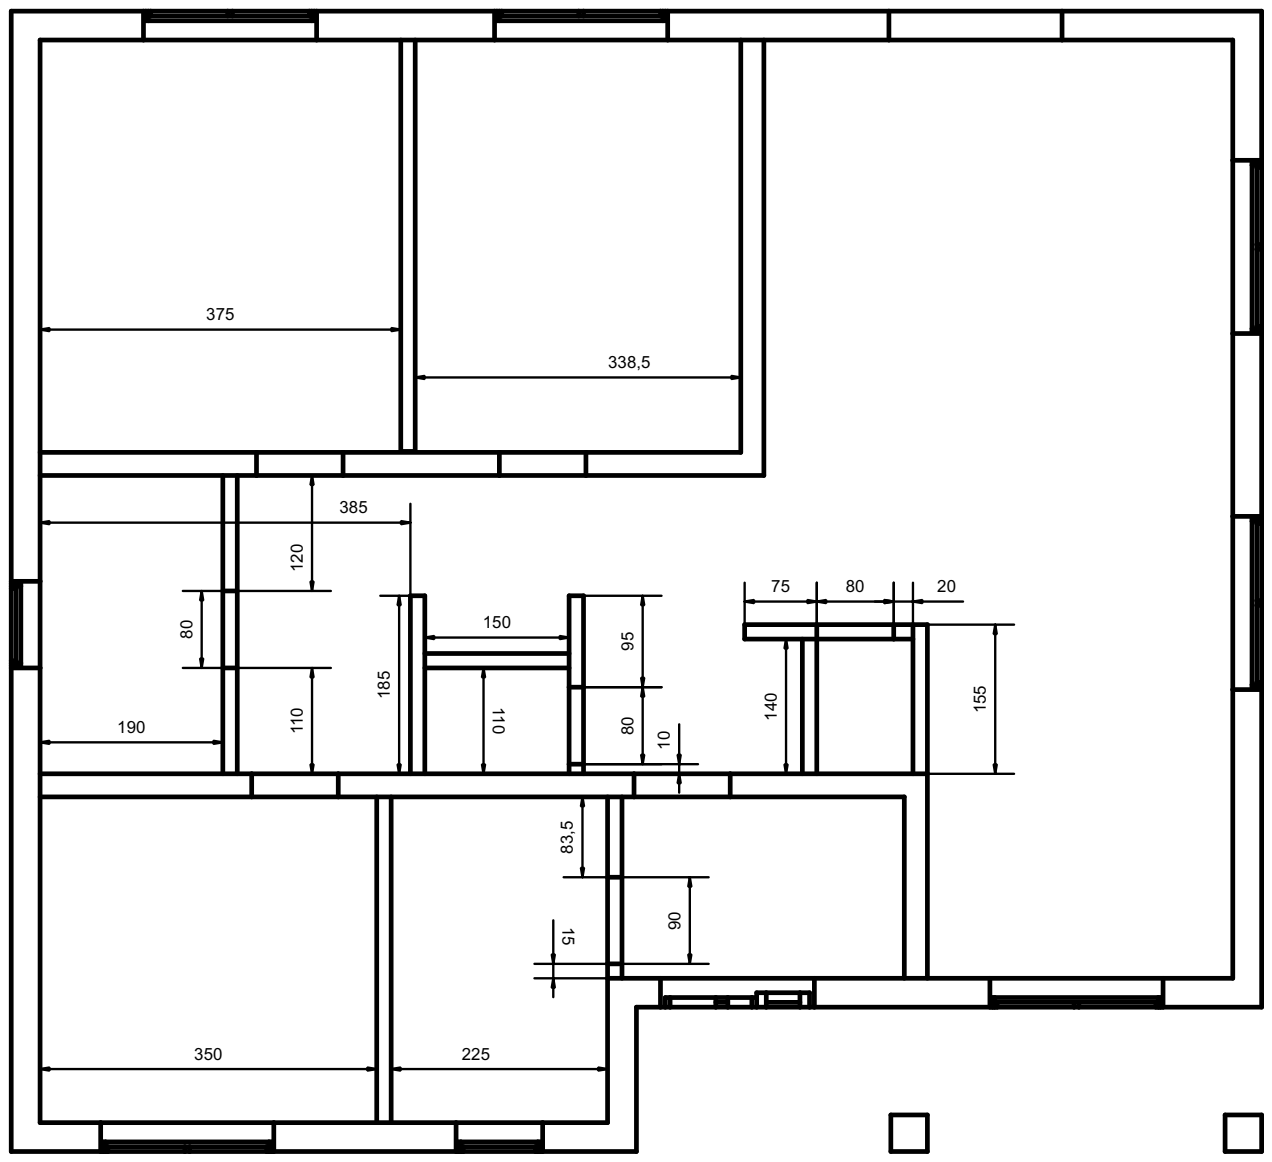
[picture p56: page 1]
