zip1982b/my_home/pdf/вид сверху стропила.pdf

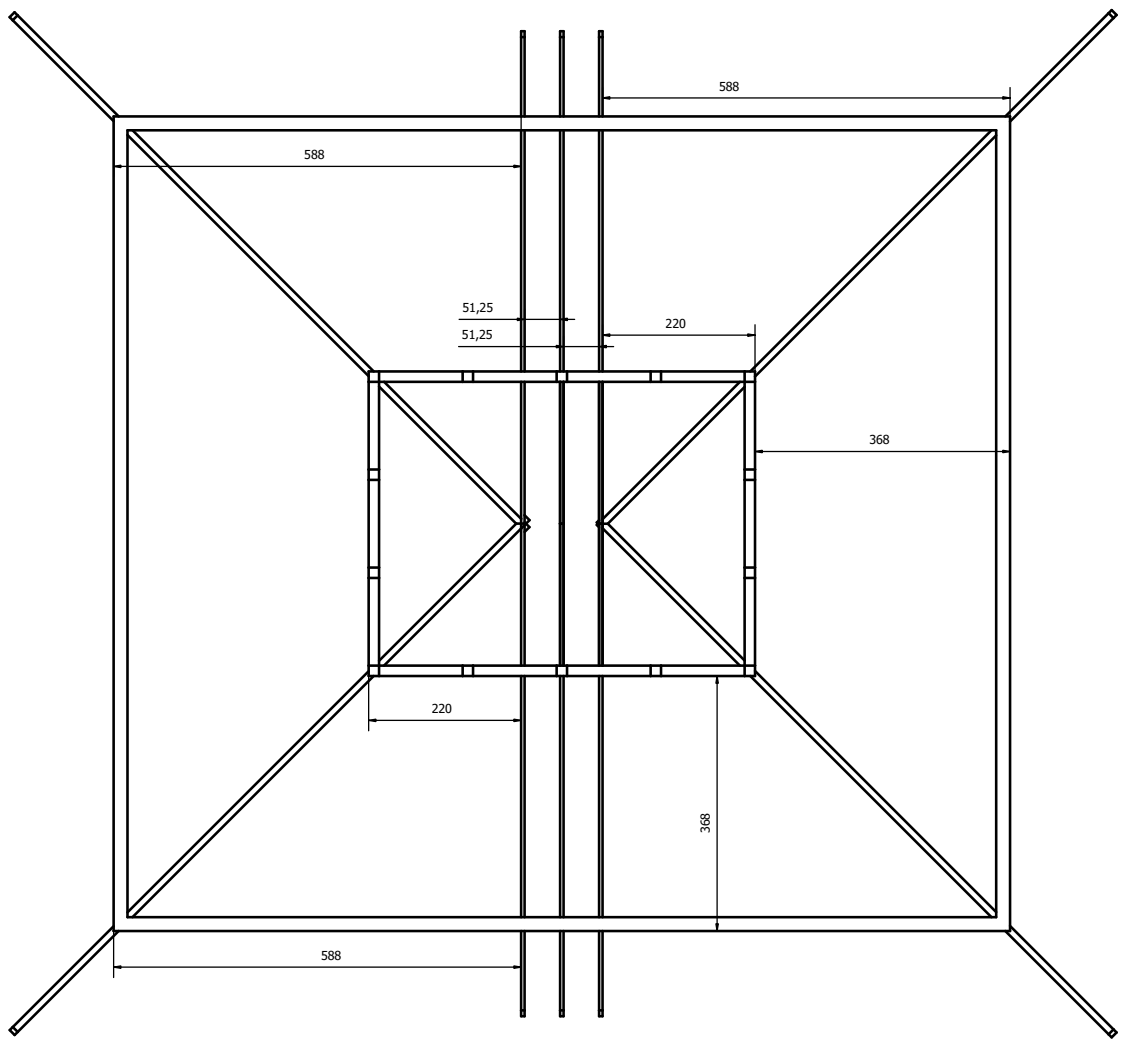
[picture p57: page 1]
