zip1982b/my_home/pdf/вид сверху без стропил.pdf

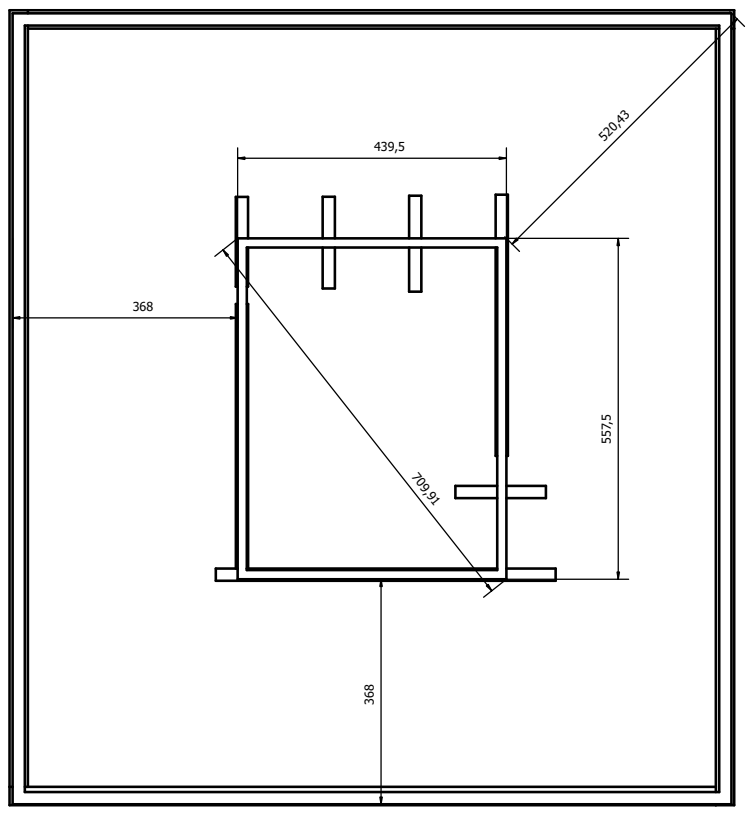
[picture p58: page 1]
