zip1982b/my_home/pdf/вид Восток.pdf

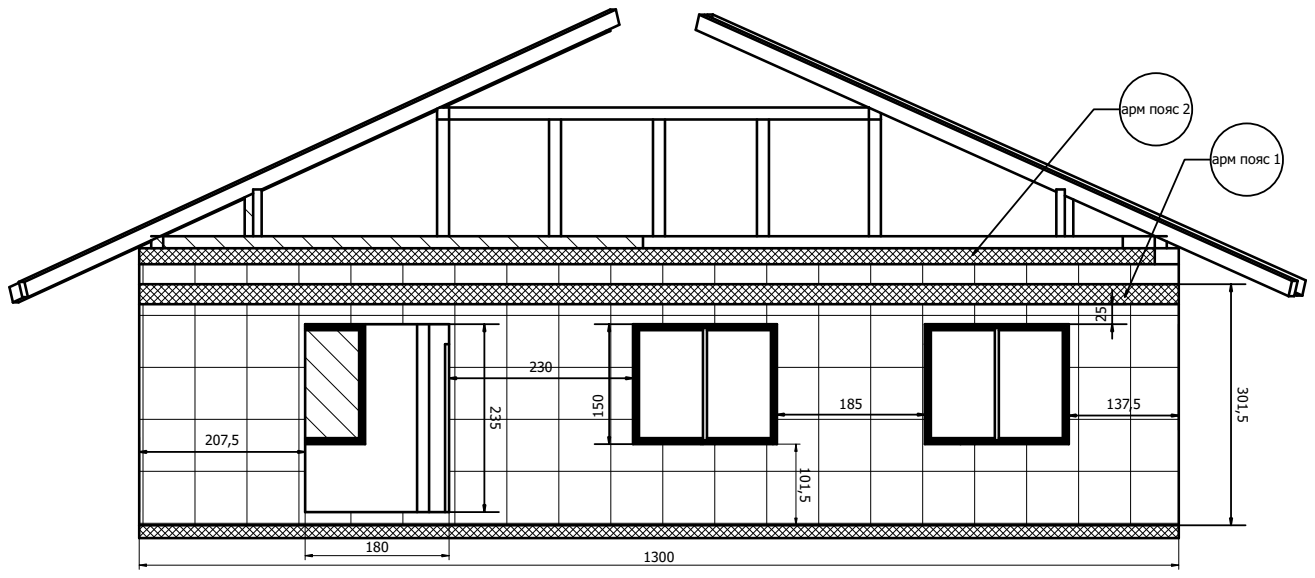
[picture p59: page 1]
