zip1982b/my_home/pdf/вид Запад.pdf

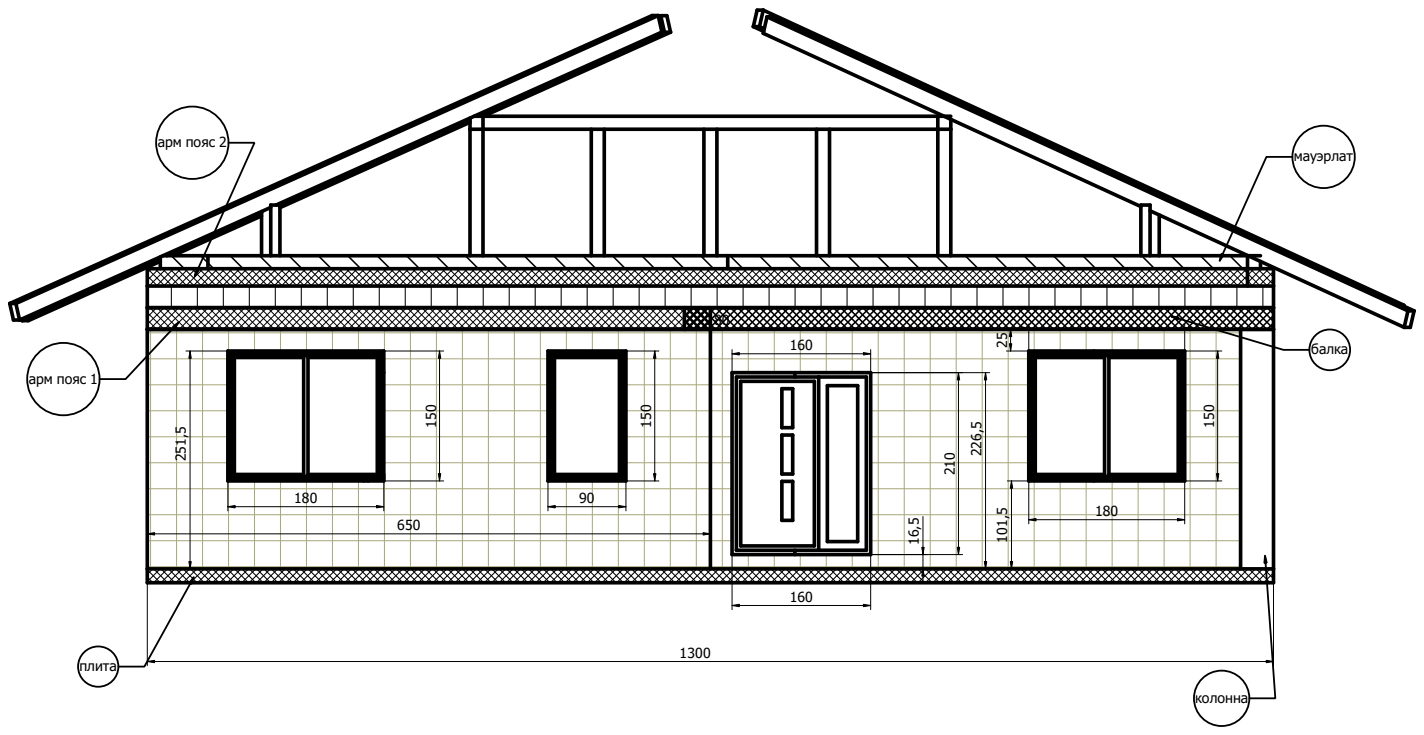
[picture p60: page 1]
