zip1982b/my_home/pdf/вид Север.pdf

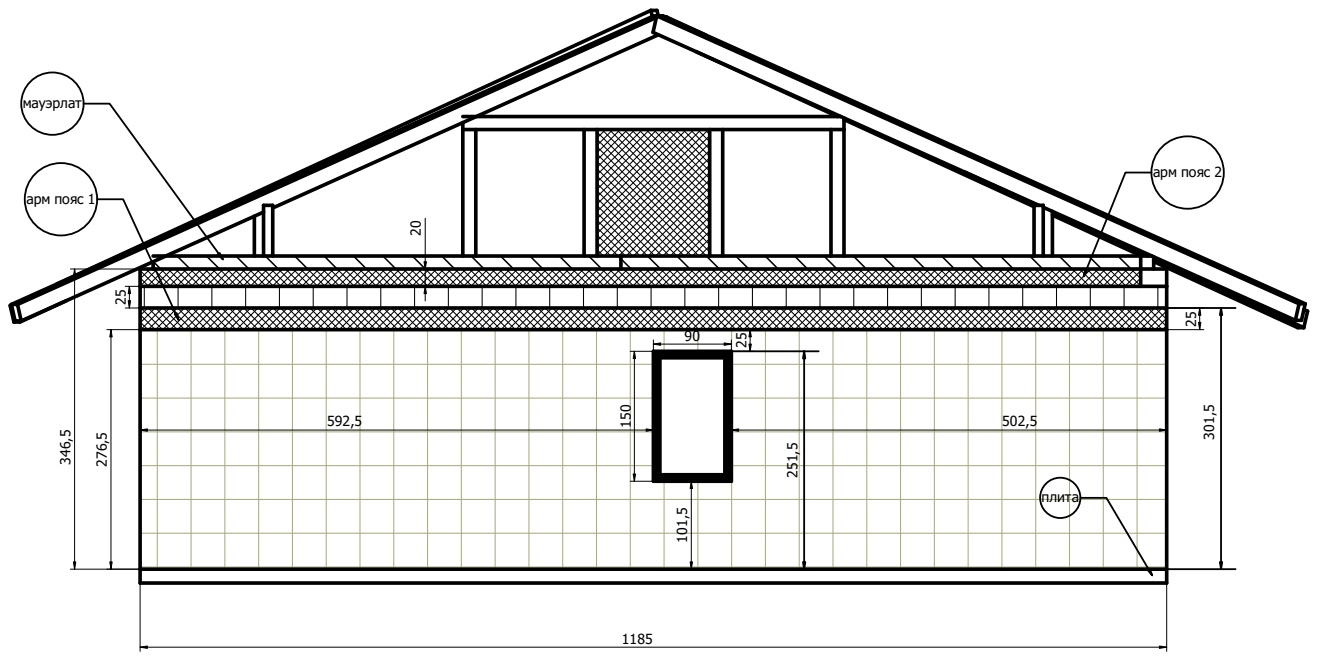
[picture p61: page 1]
