zip1982b/my_home/pdf/вид Юг.pdf

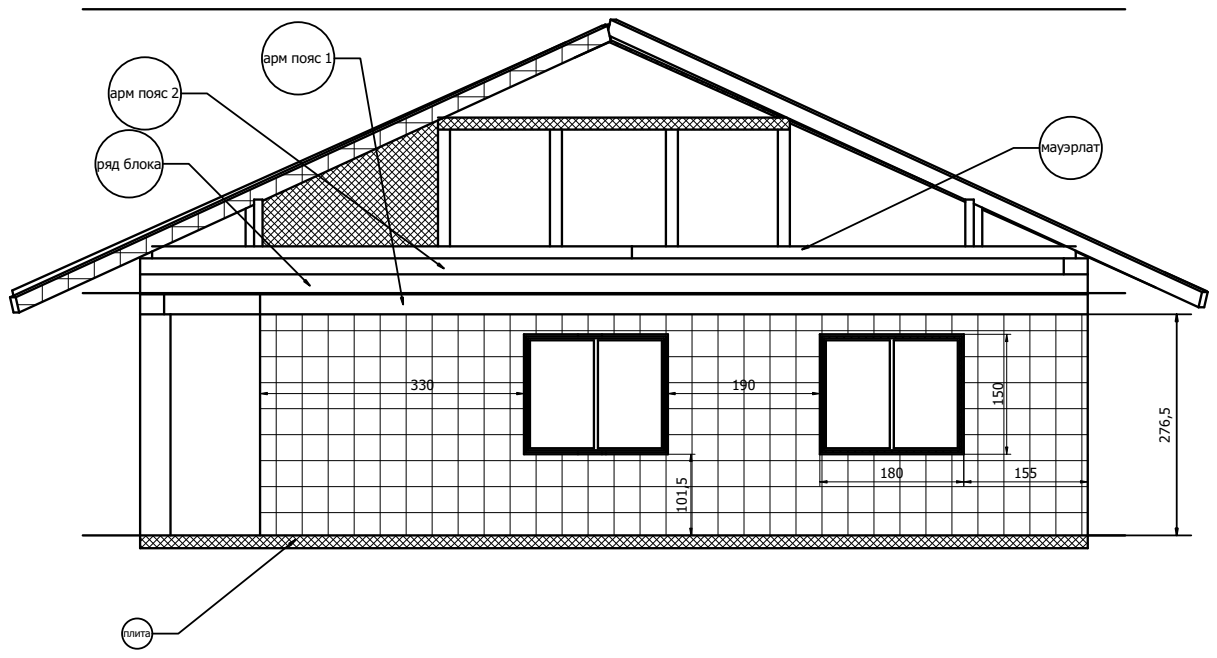
[picture p62: page 1]
плита; арм пояс 1; ряд блока; арм пояс 2; мауэрлат
