zip1982b/my_home/pdf/план первого этажа.pdf

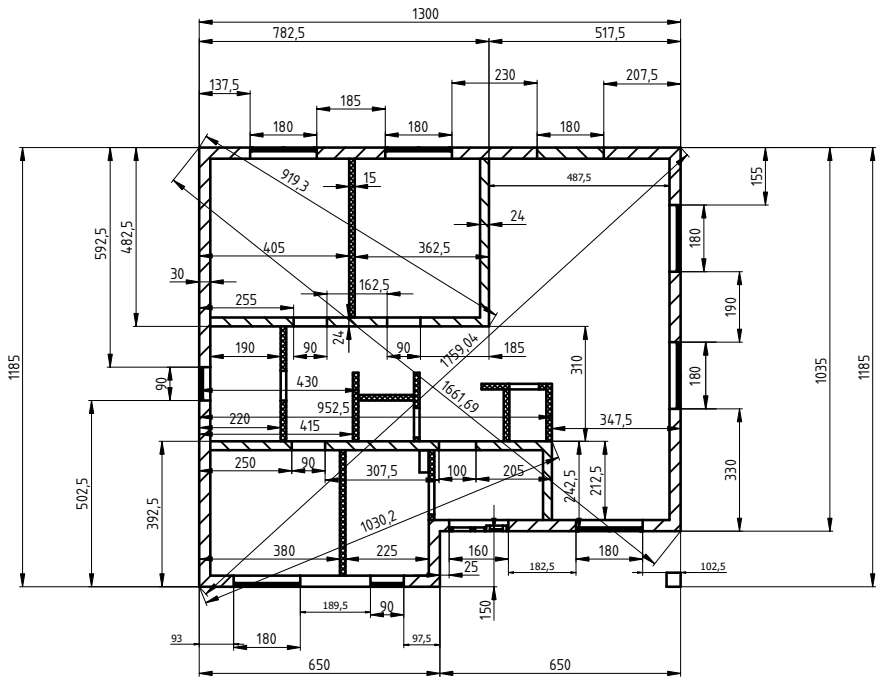
[picture p63: page 1]

160 | 182,5 | 180 | 102,5
25
