zip1982b/my_home/pdf/АС 6-131.pdf

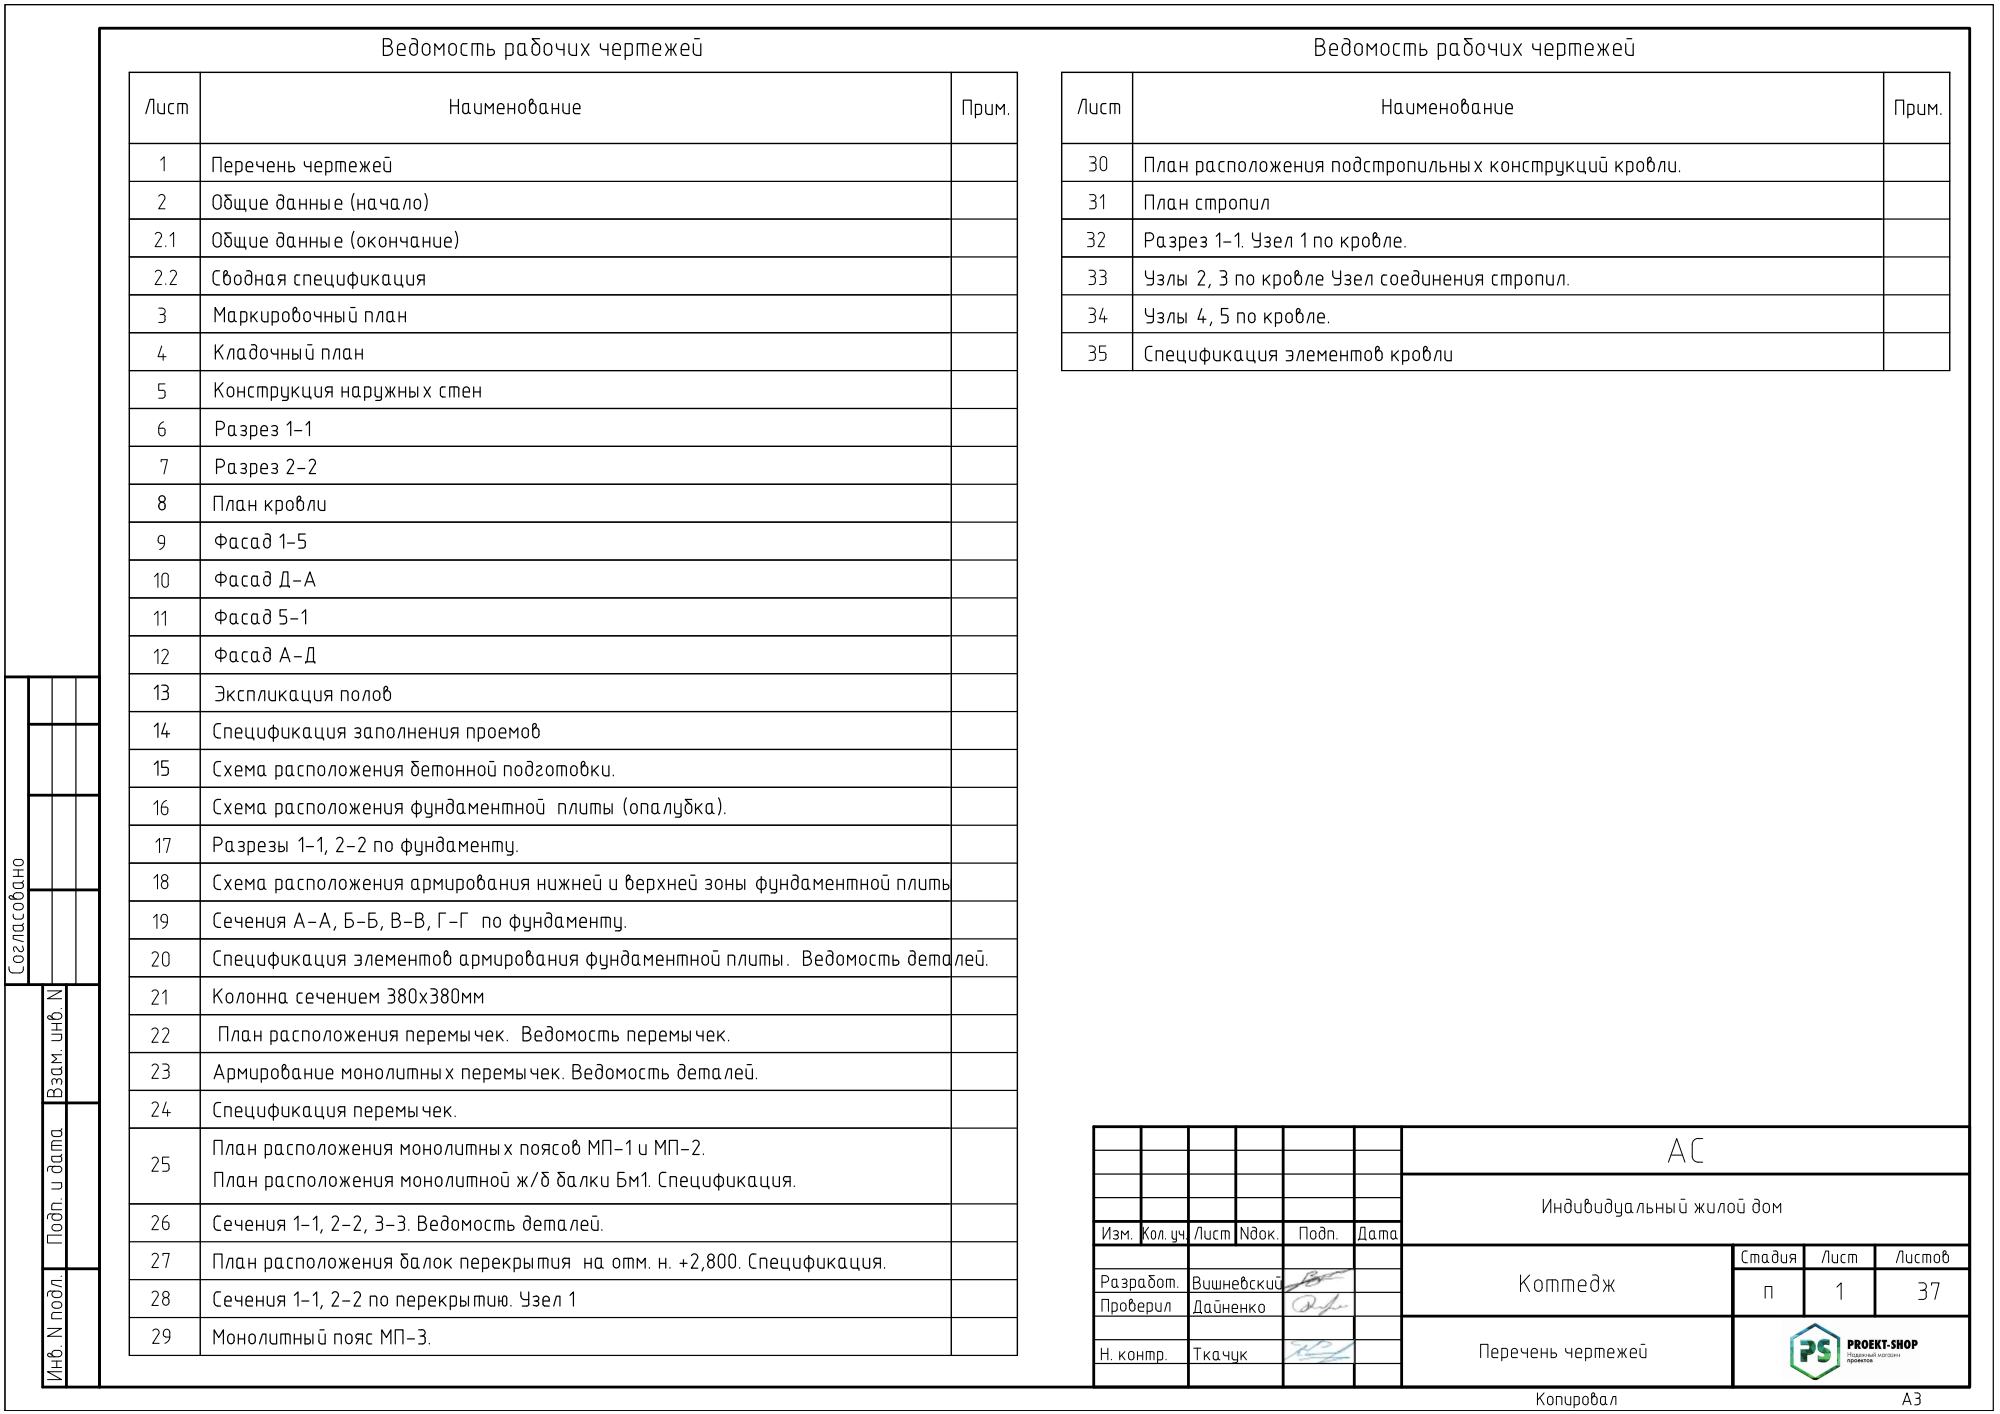
[picture p64: page 1]

## Ведомость ссылочных и прилагаемых документов

Обозначение | Наименование | Примечание

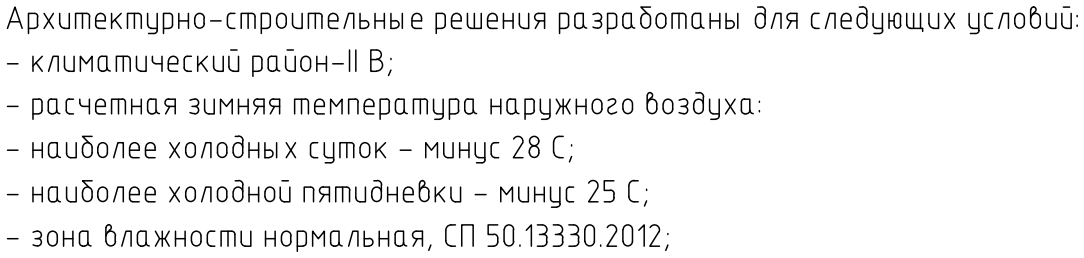
[picture p65: figure]

СП 15.13330.2012 | Каменные и армокаменные конструкции
СП 20.13330.2016 | Нагрузки и воздействия
СП 22.13330.2016 | Основания зданий и сооружений
СП 45.13330.2017 | Земляные сооружения, основания основания и фундаменты
СП 63.13330.2012 | Бетонные и железобетонные конструкции
СП 70.13330.2012 | Несущие и ограждающие конструкции
СТО НААГ 3.1–2013 | Конструкции с применением автоклавного газобетона в строительстве
ГОСТ Р 21.1101-2013 | Основные требования к проектной и рабочей документации
ГОСТ 31359-2007 | Бетоны ячеистые автоклавного твердения. Технические условия
СТО 36554501-012-2008 | Применение теплоизоляции из плит ЭППС при проектировании и устройстве
| малозаглубленных фундаментов на пучинистых грунтах
СТО НООСТРОЙ 2.9.136-2013 | Устройство конструкций с применением изделий и армированных элементов
| из ячеистых бетонов автоклавного твердения

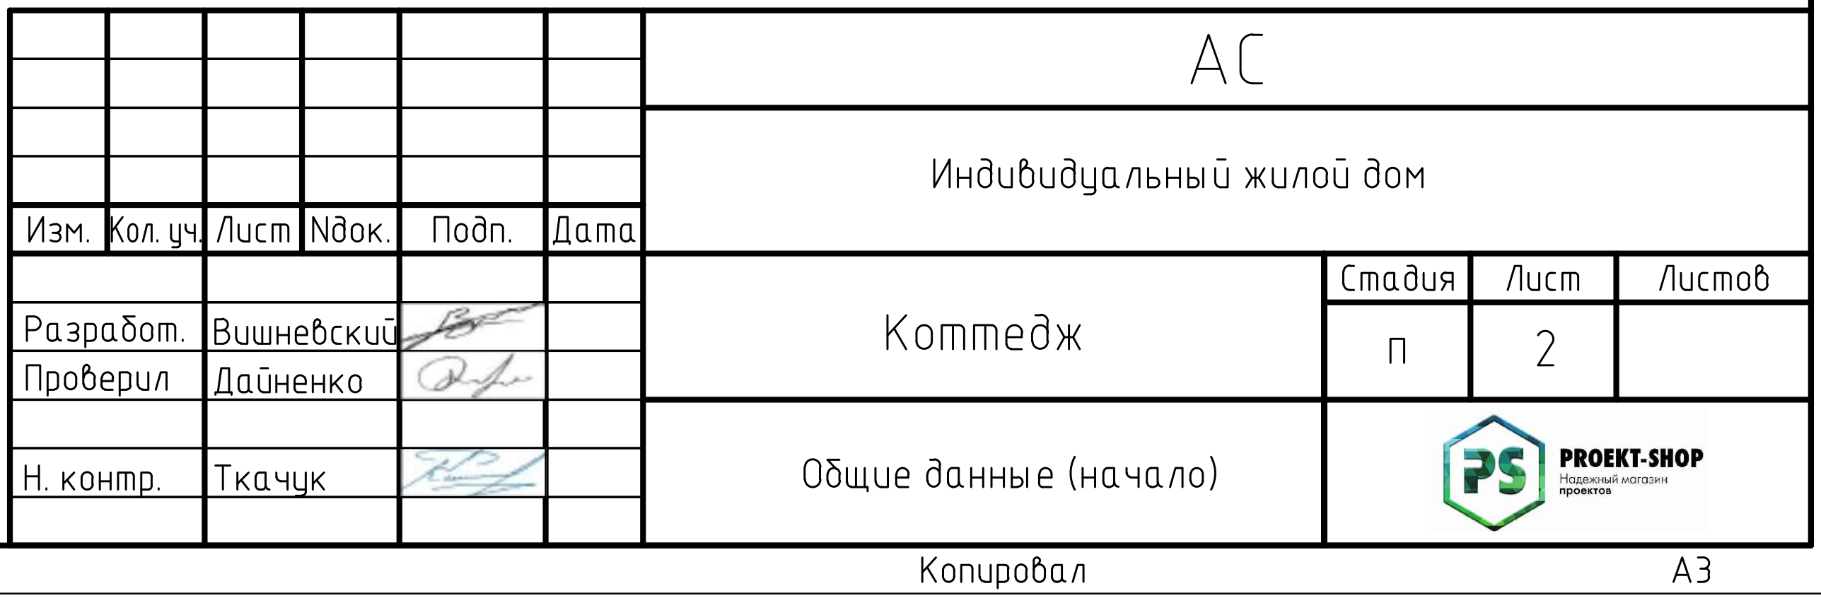
[picture p66: figure]
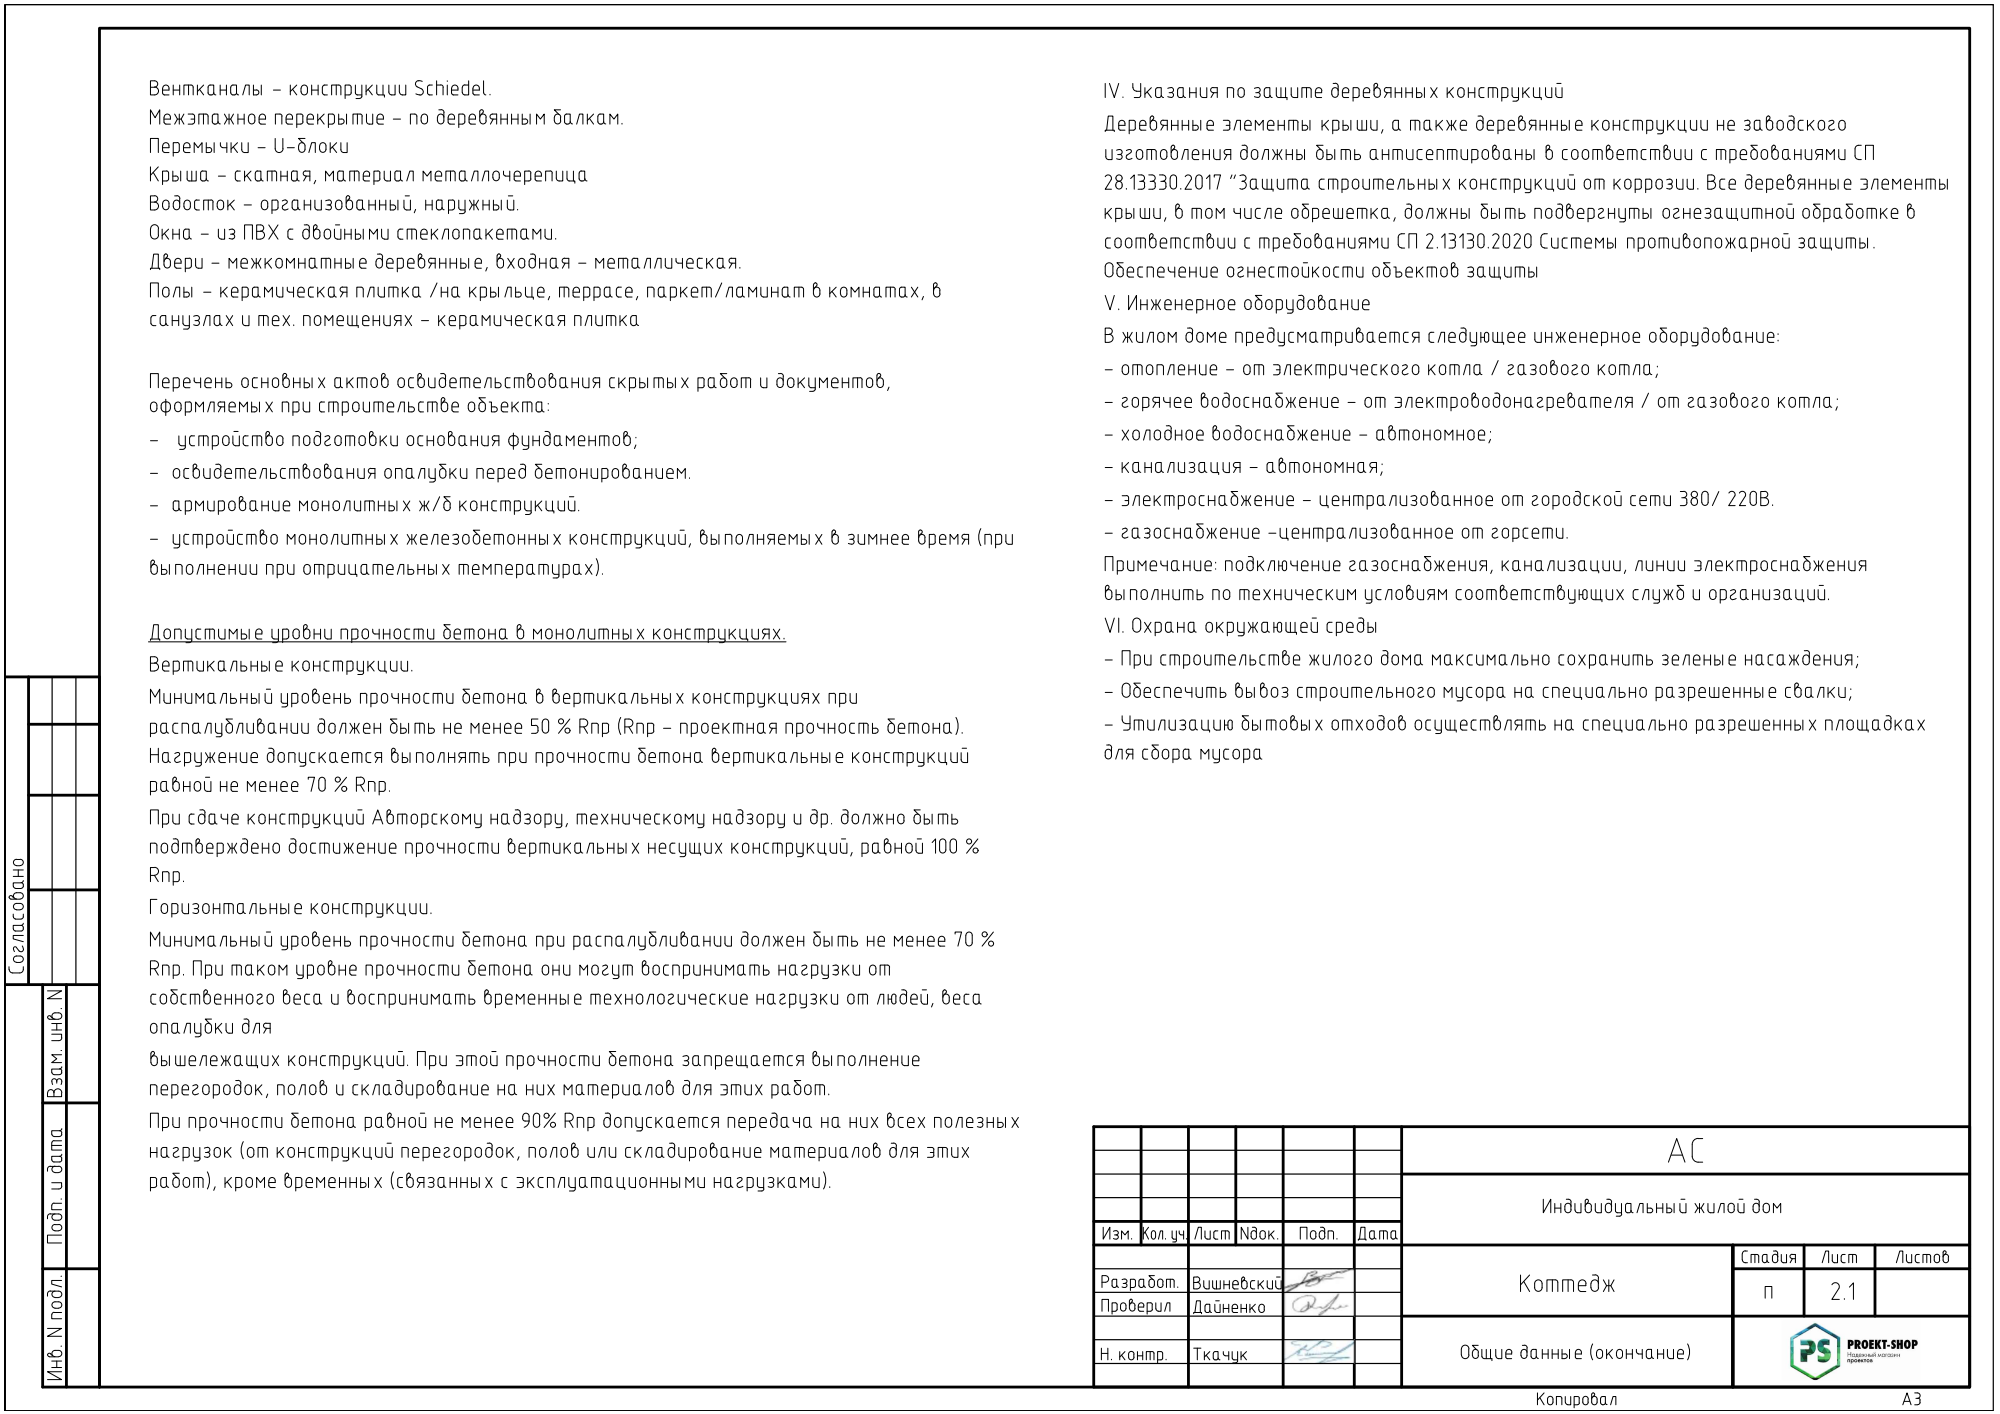
[picture p67: page 3]

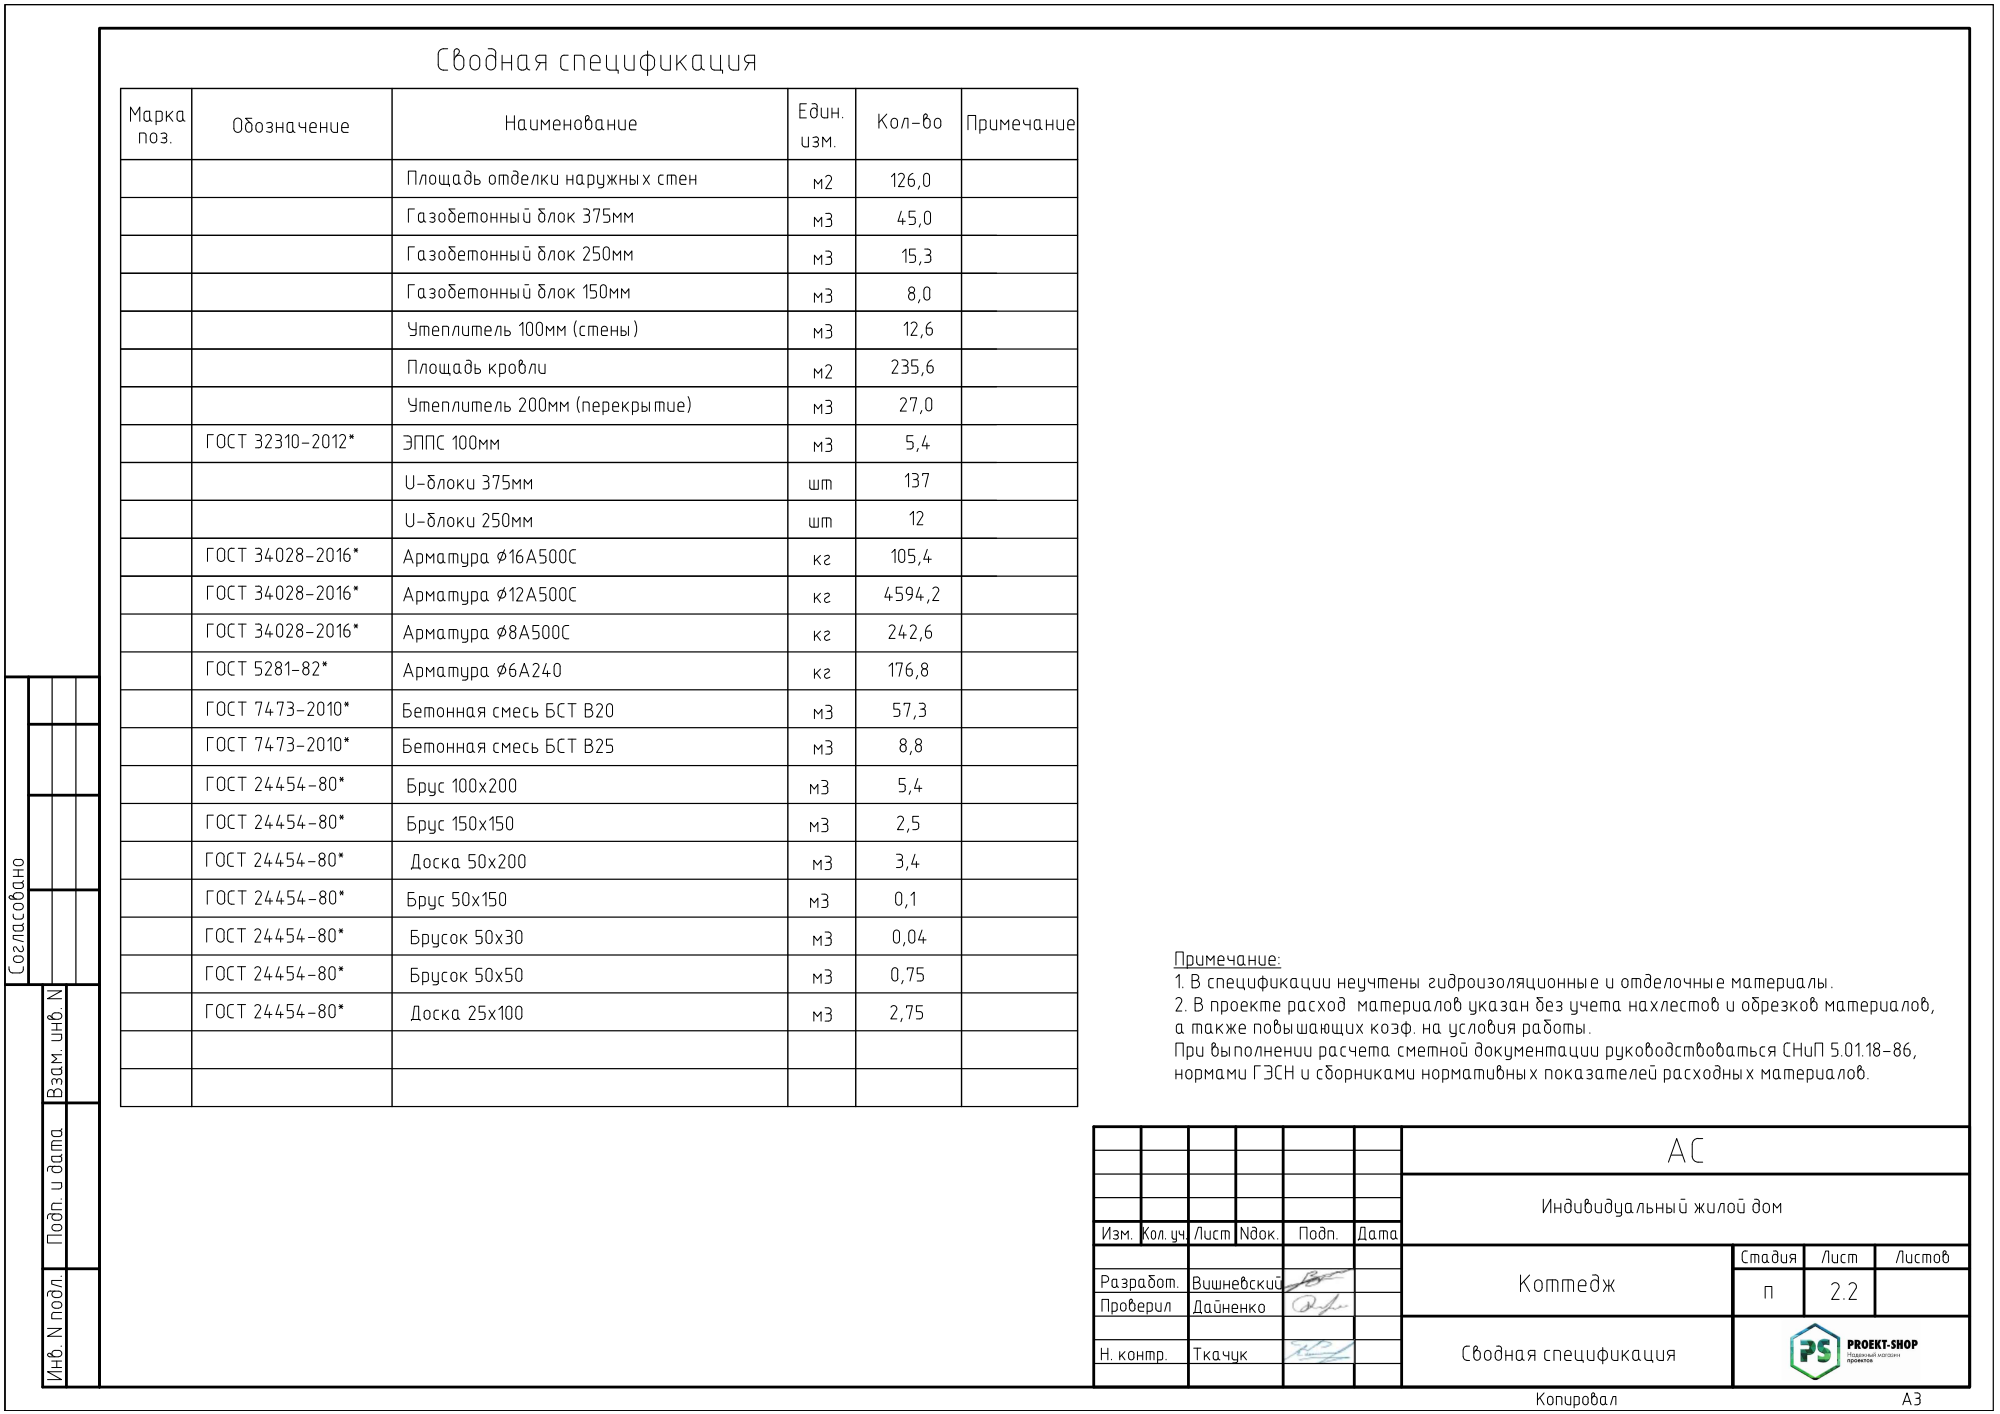
[picture p68: page 4]

13 1 | 2 | 3 | 4 | 5 АБВДГ

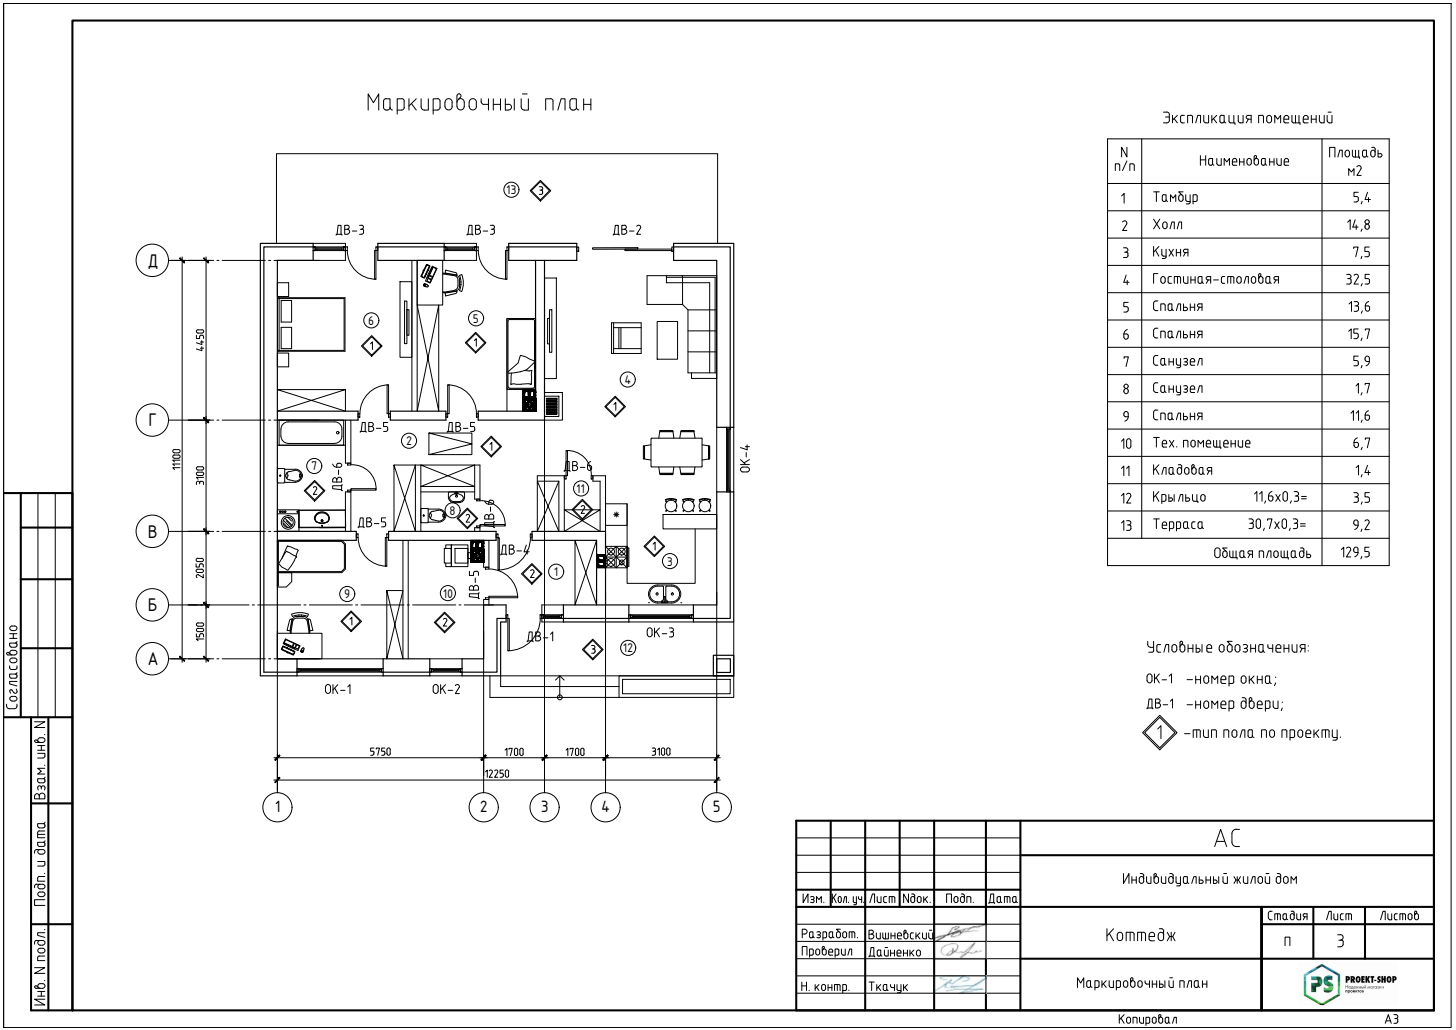
[picture p69: page 5]

1 | 2 | 3 | 4 | 5 АБВДГ | 11 2 | 2

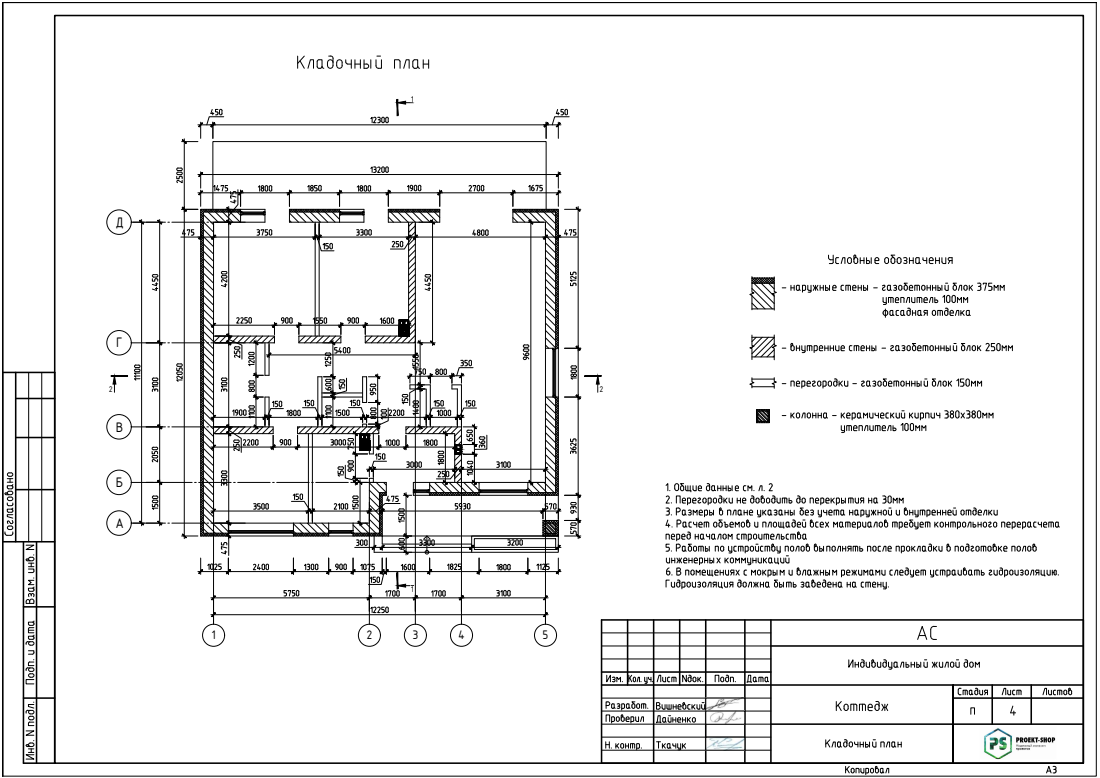
[picture p70: page 6]

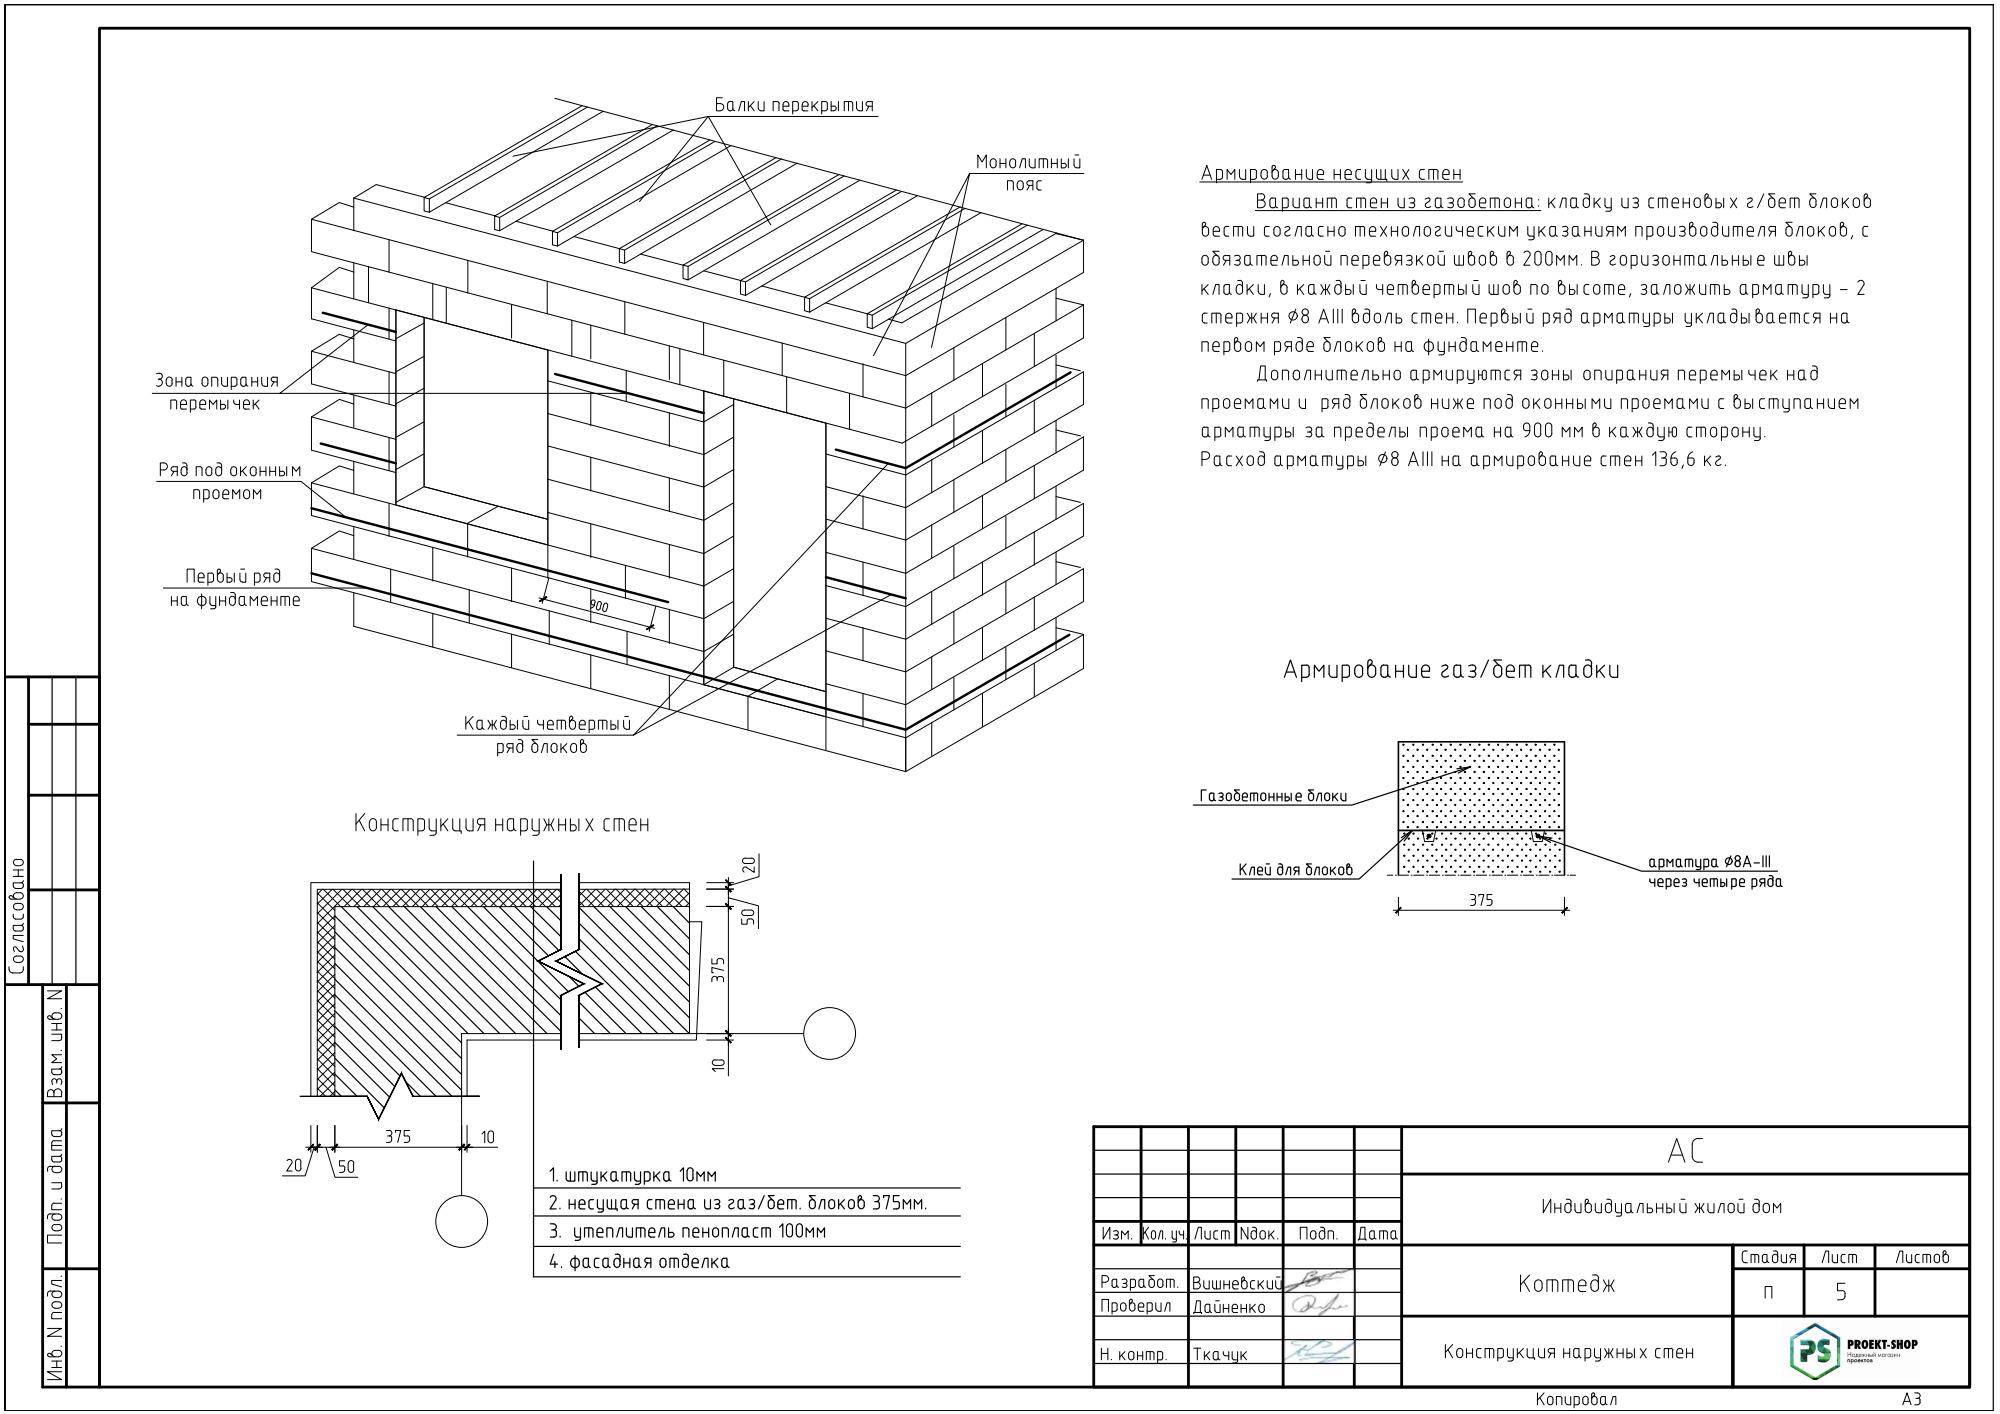
[picture p71: page 7]

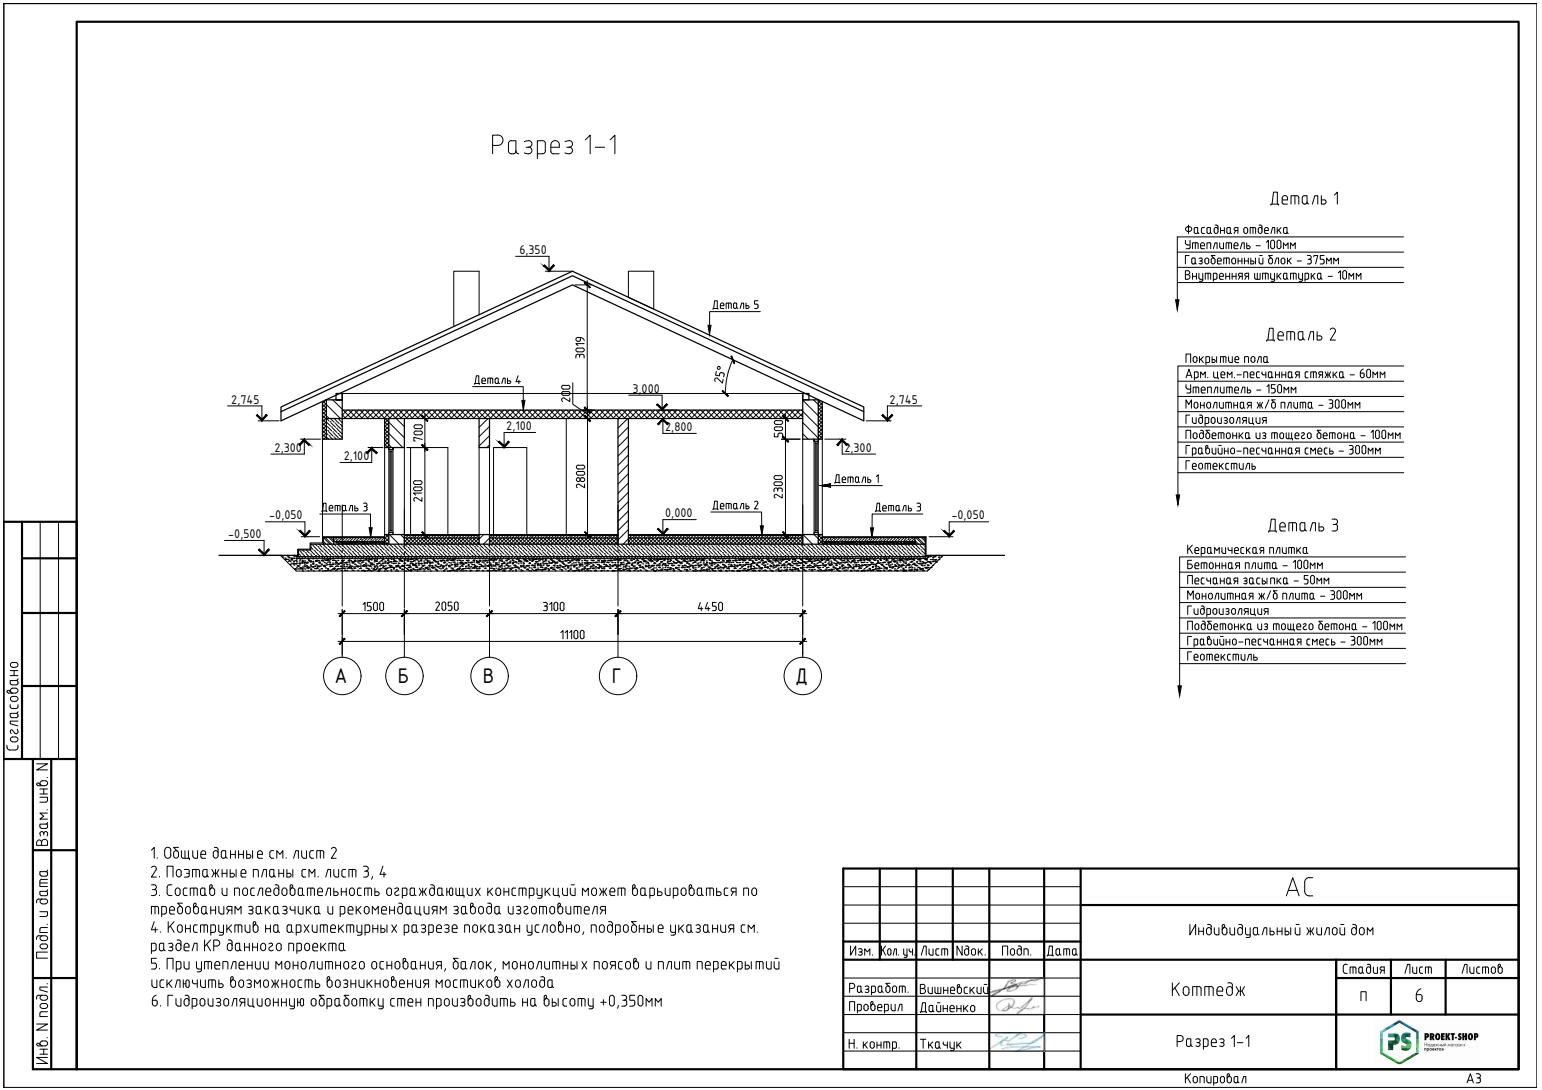
[picture p72: page 8]

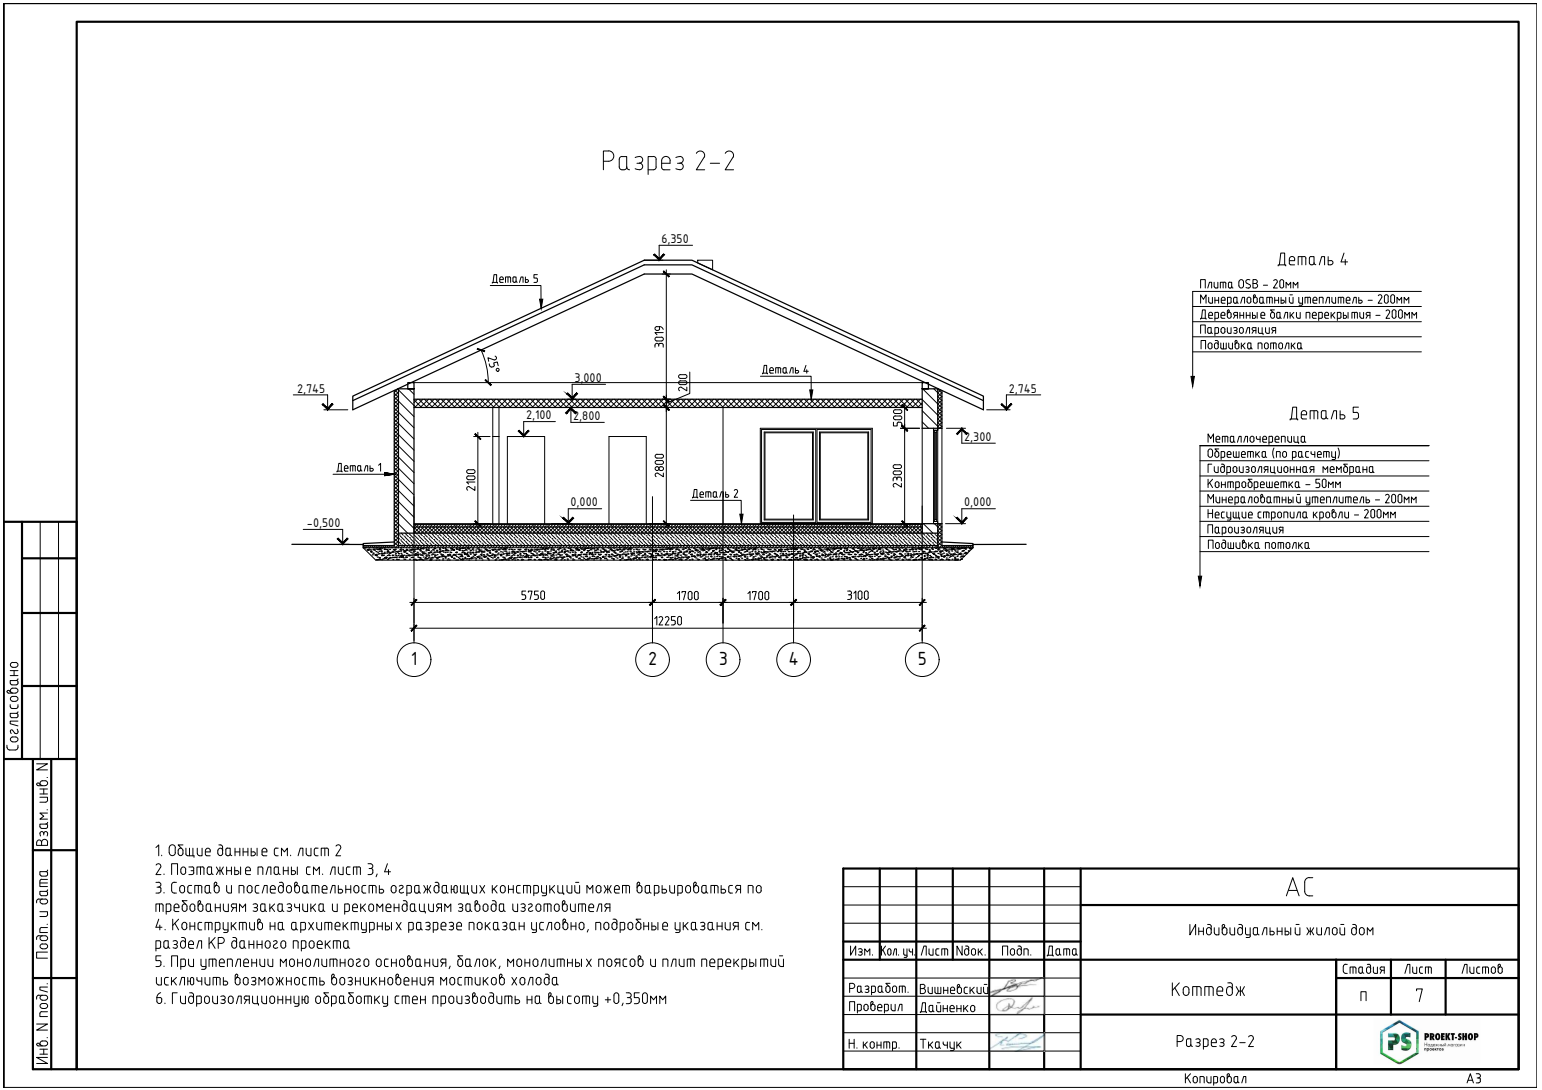
[picture p73: page 9]

1 | 2 | 3 | 4 | 5 АБВДГ

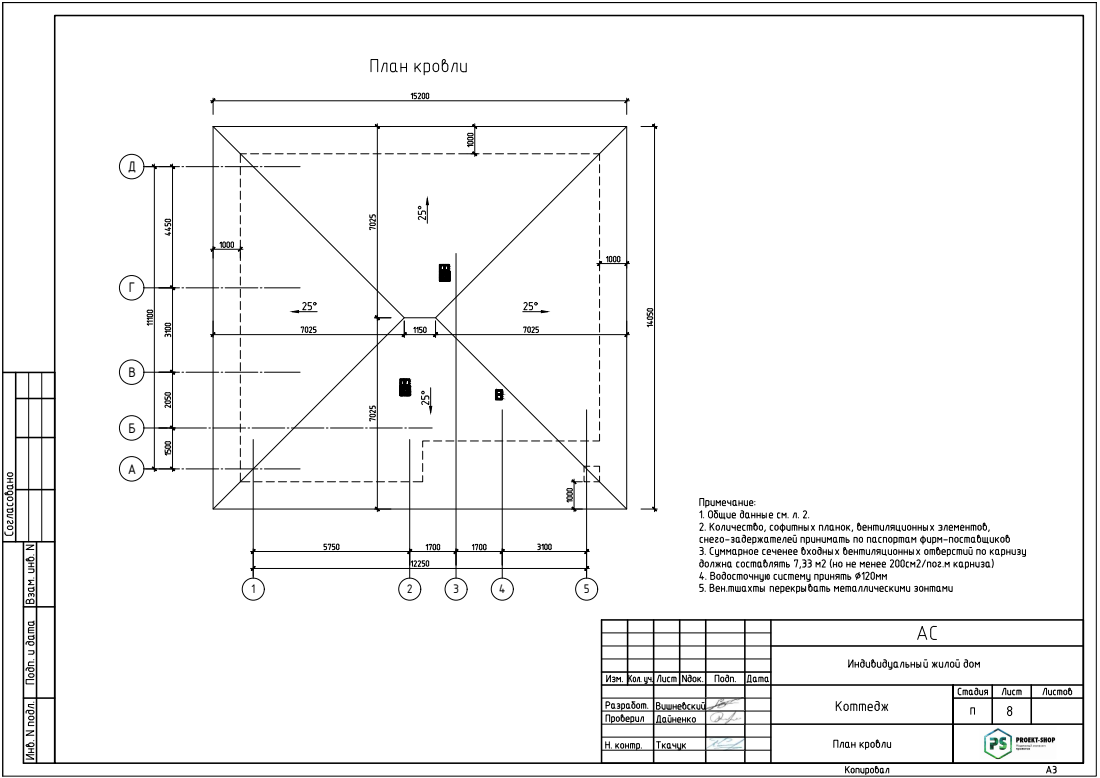
[picture p74: page 10]

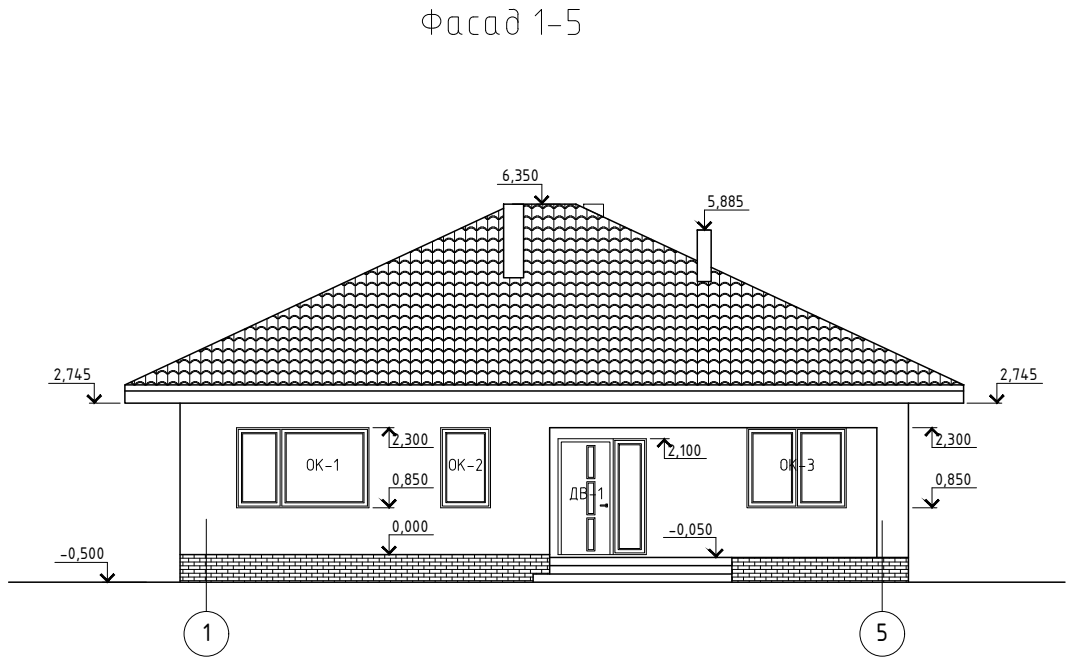
[picture p75: page 11]

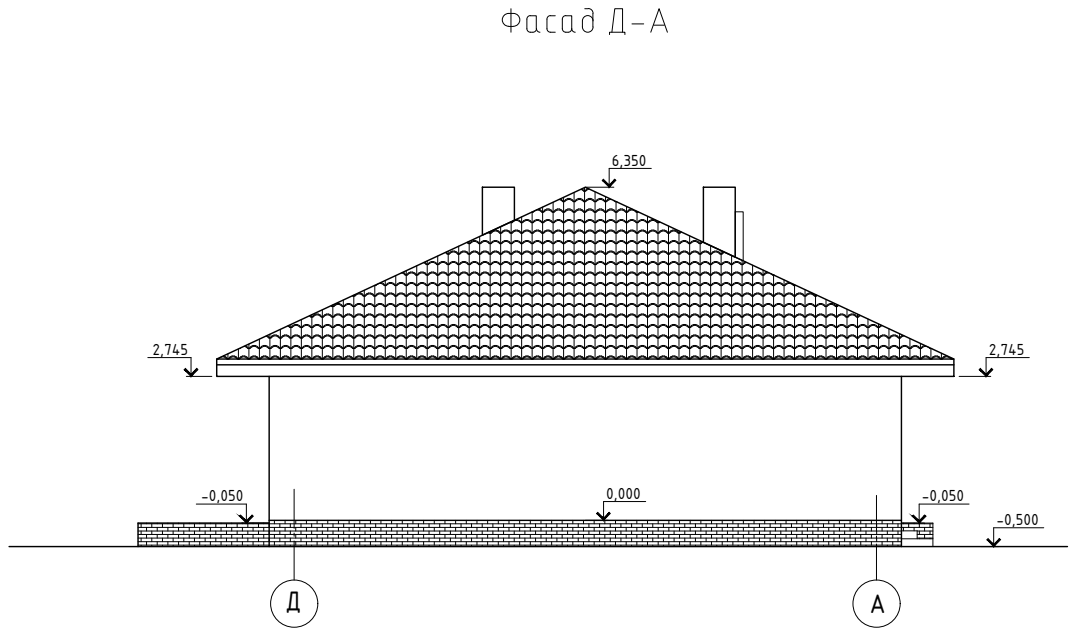
[picture p76: page 12]

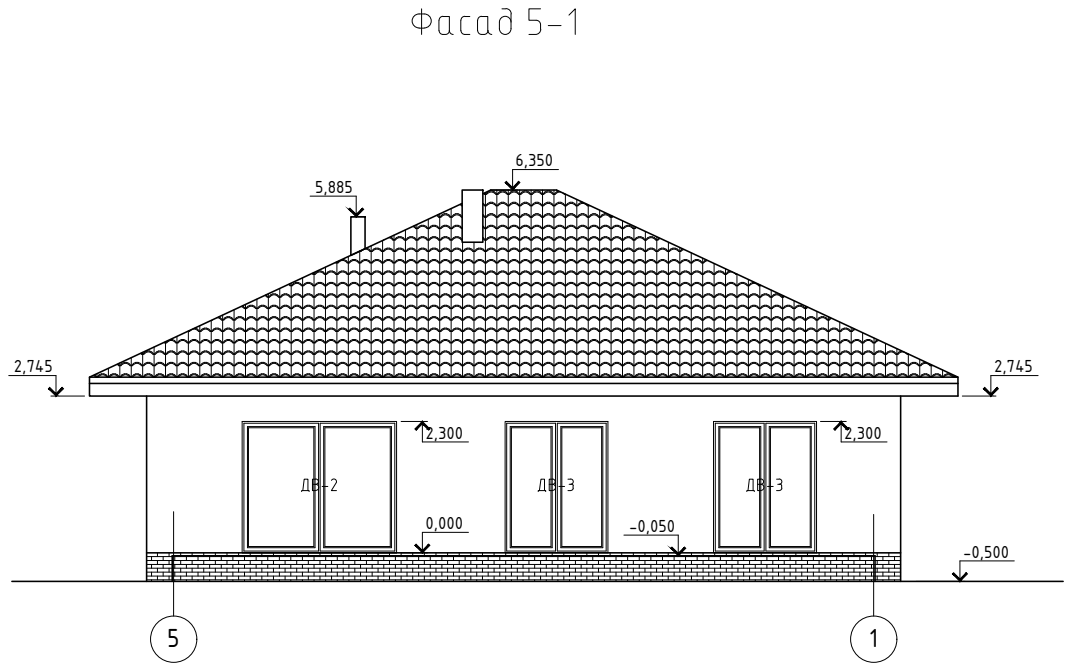
[picture p77: page 13]

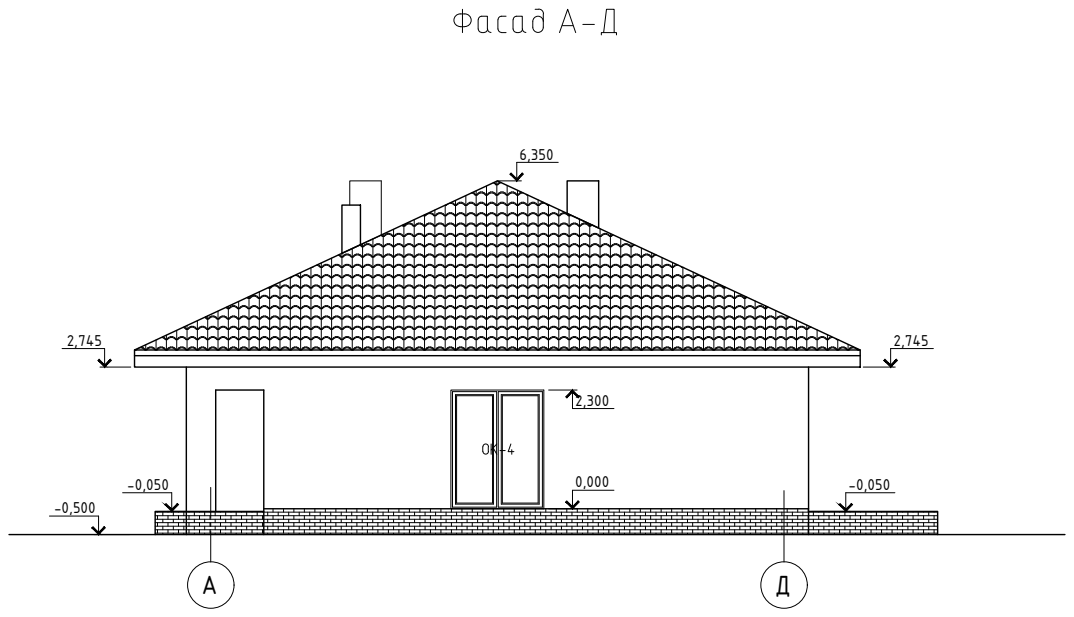
[picture p78: page 14]

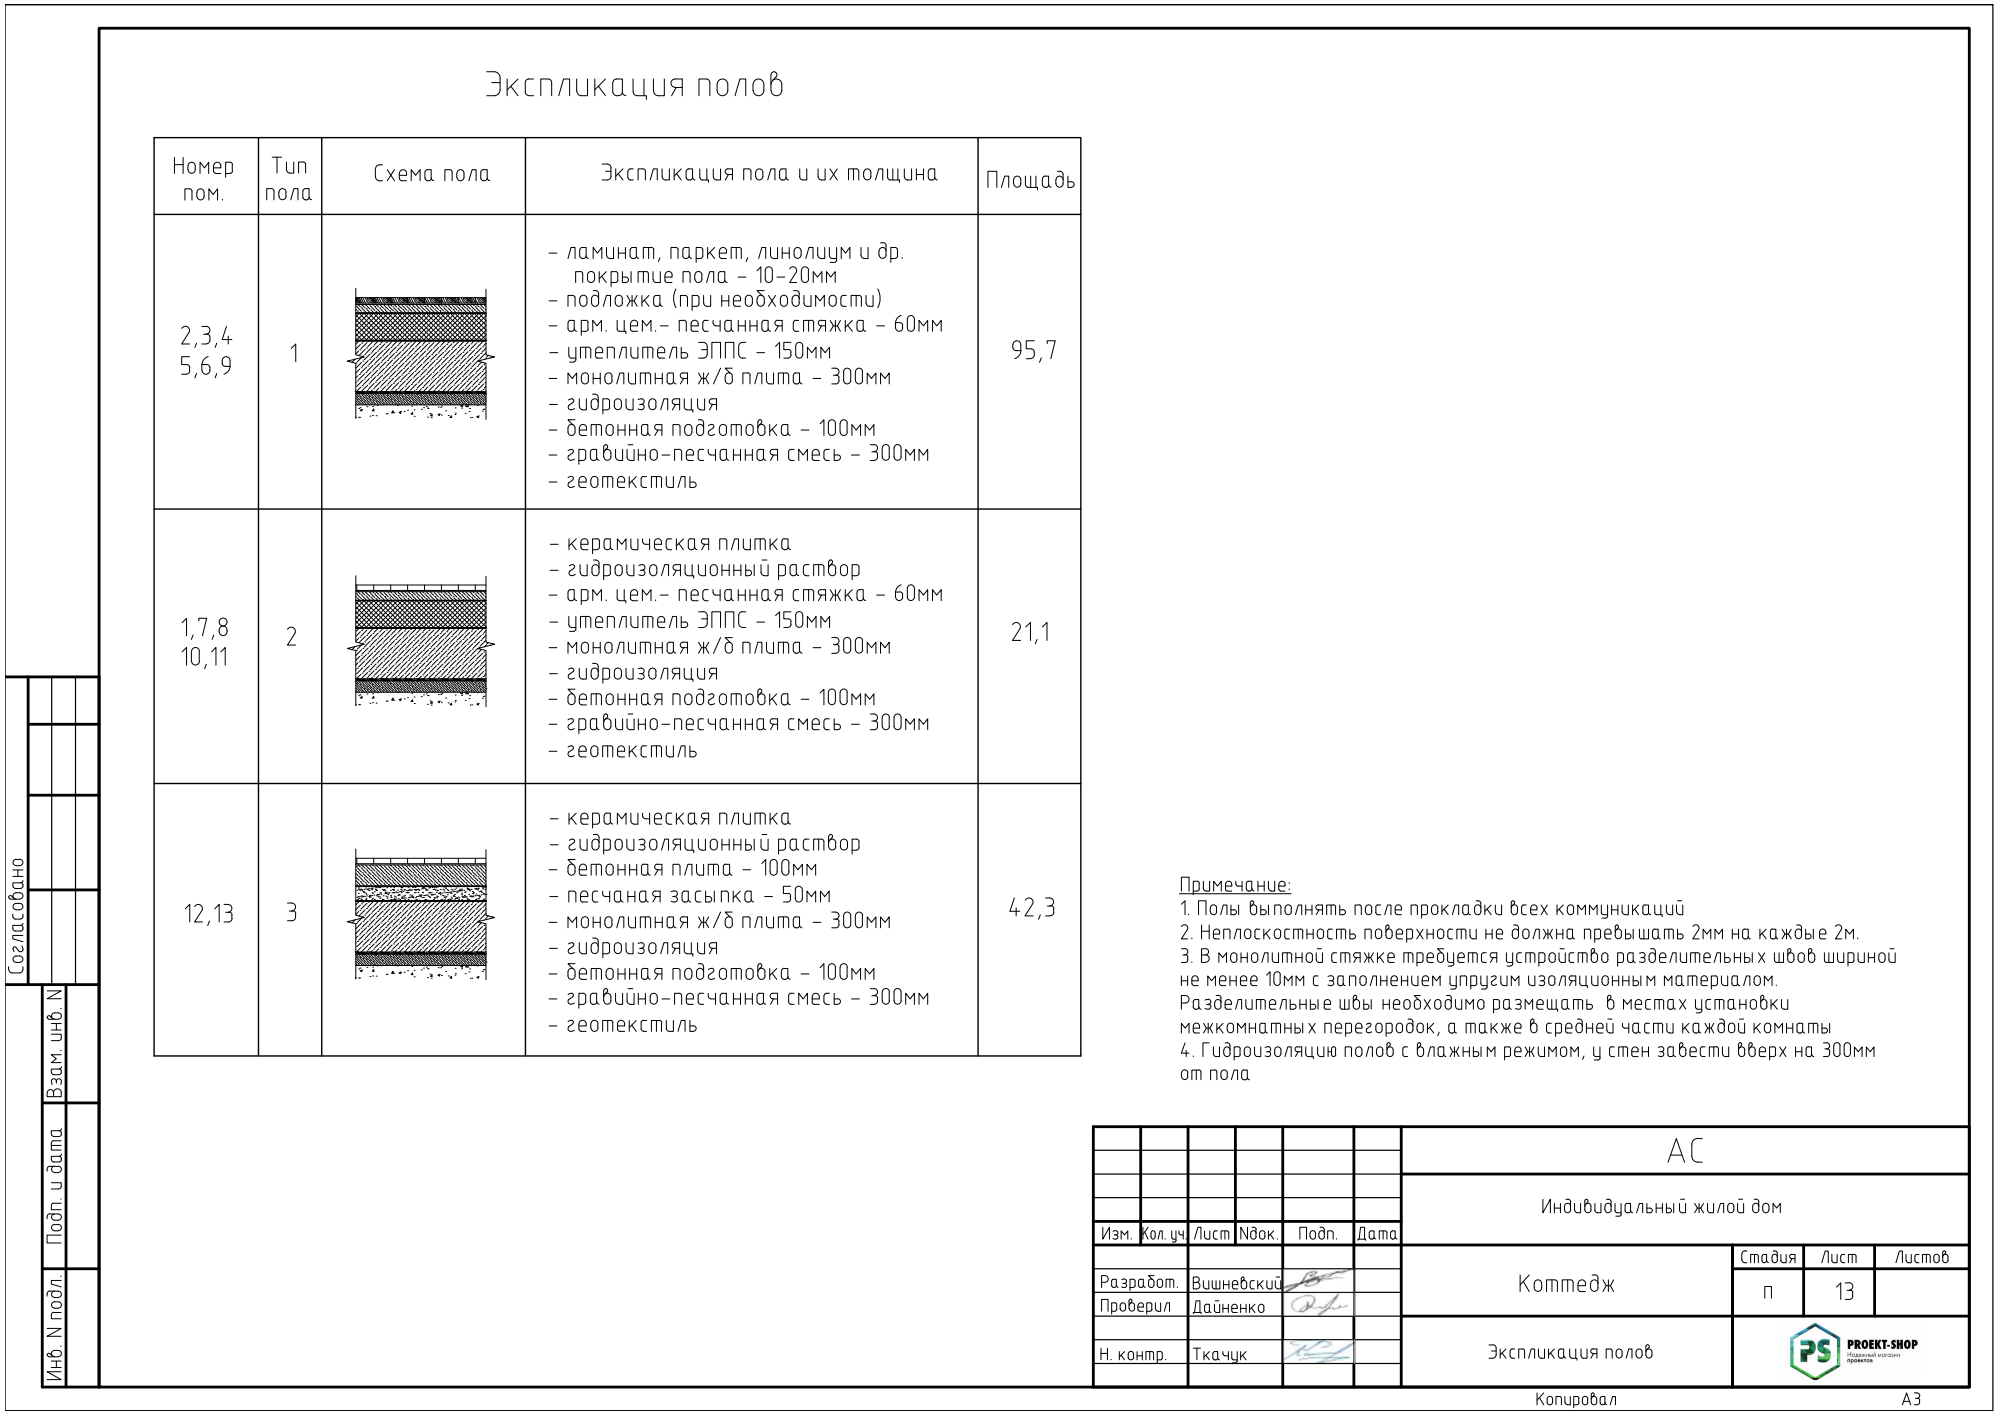
[picture p79: page 15]

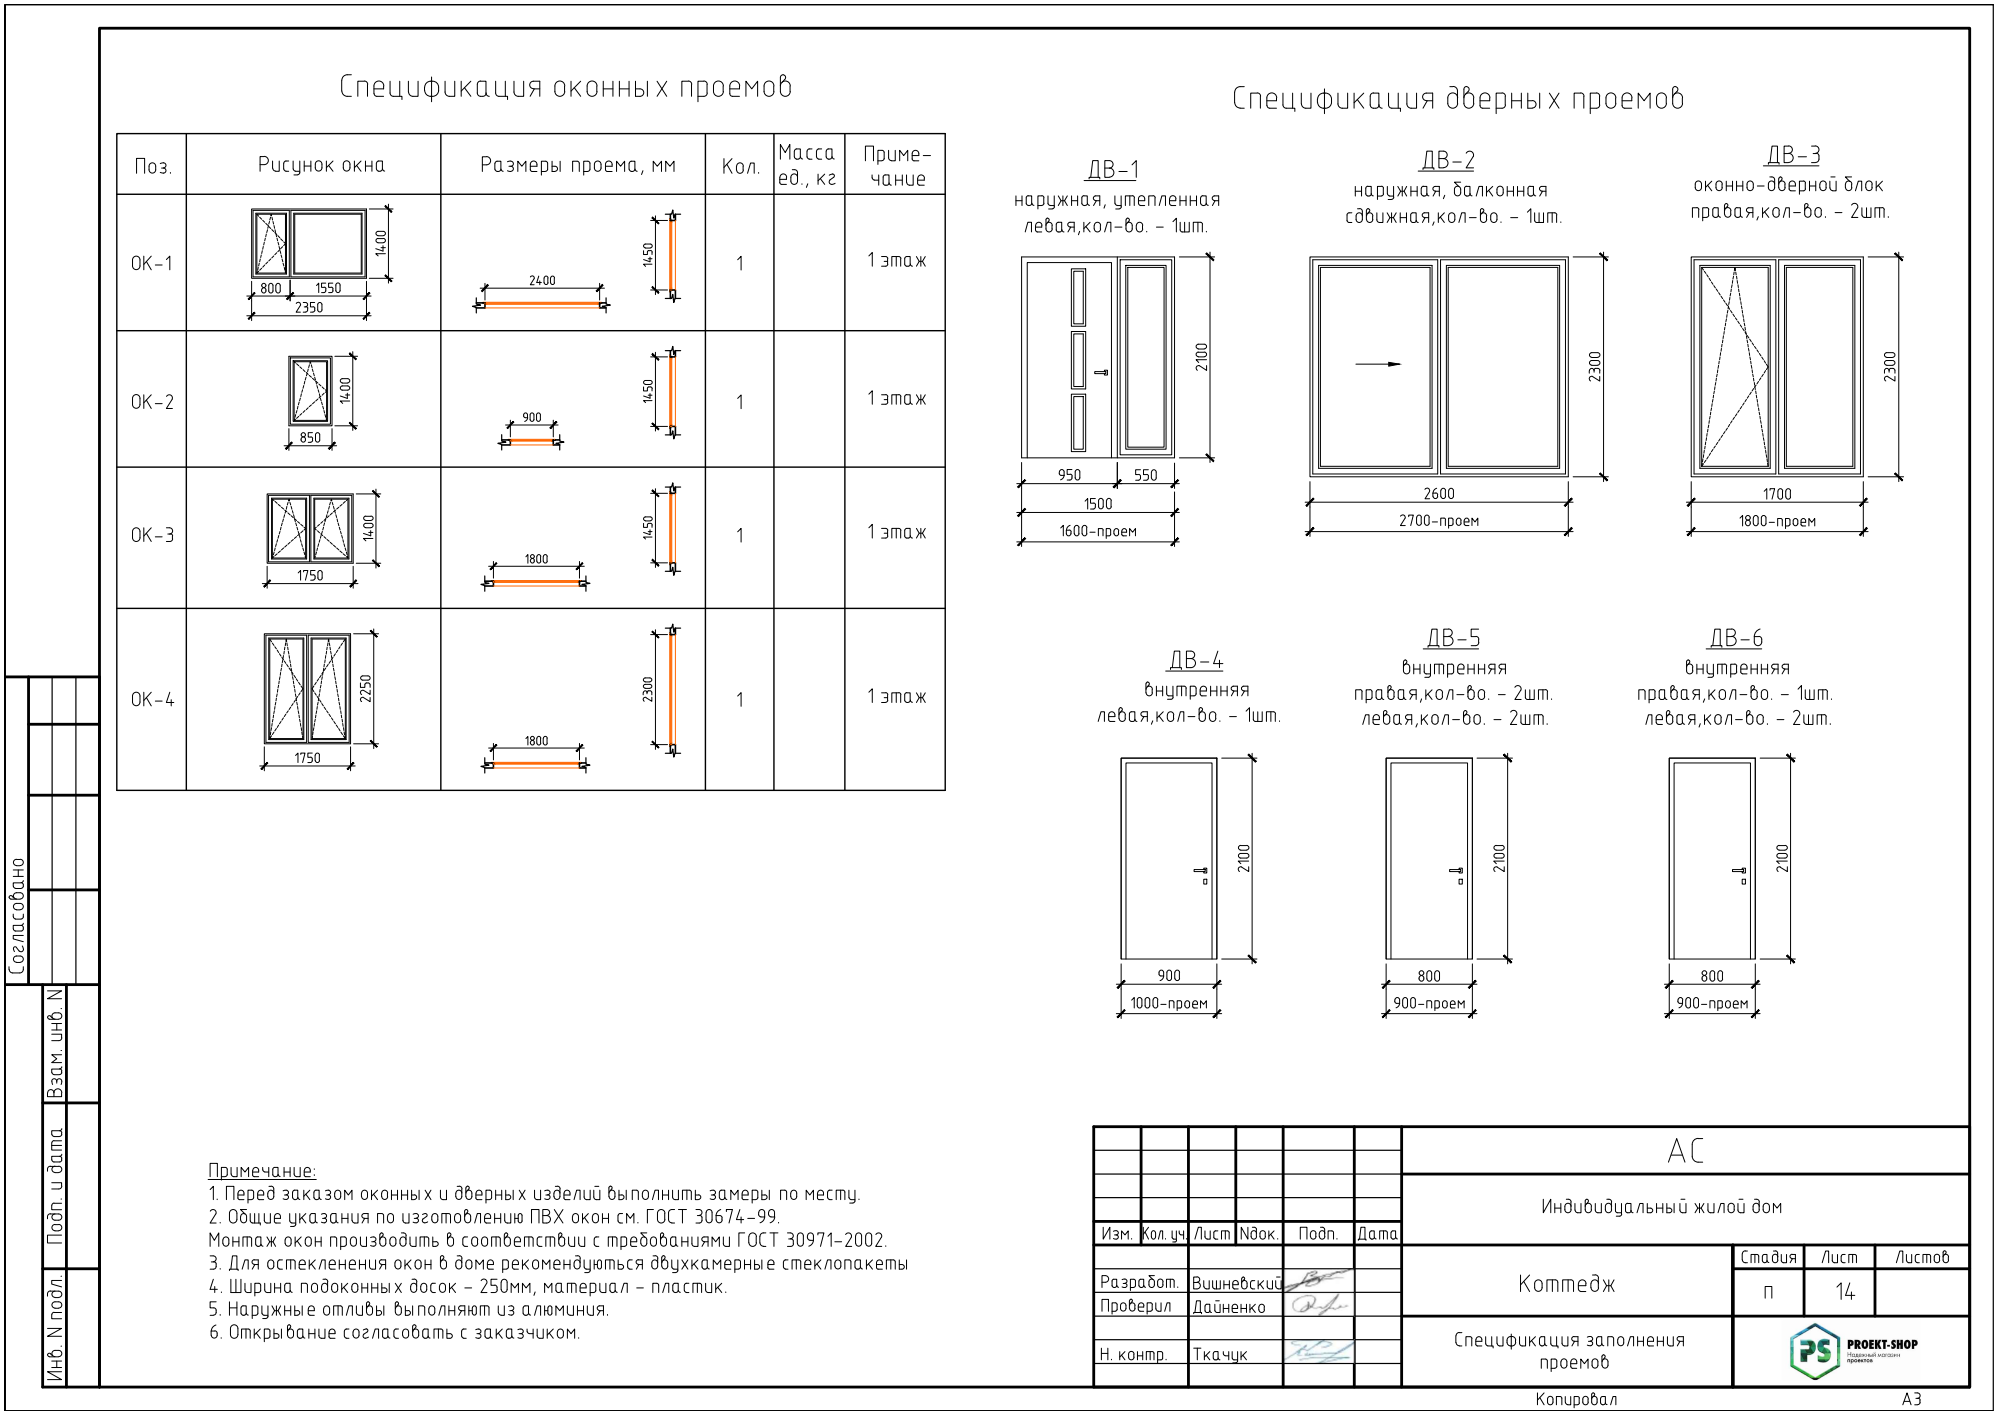
[picture p80: page 16]

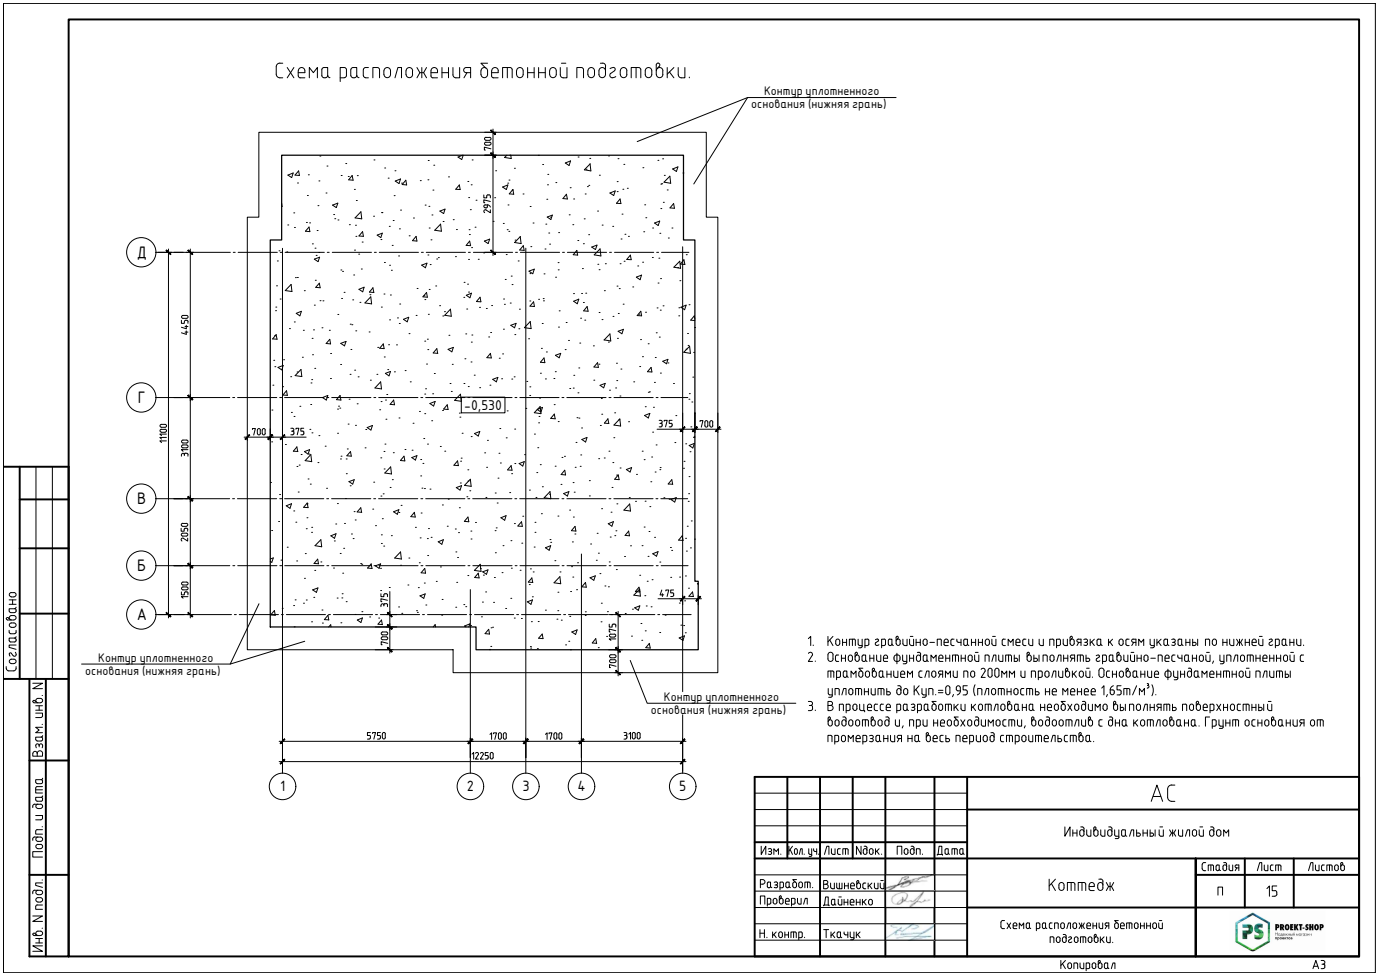
[picture p81: page 17]

Контур уплотненного
основания (нижняя грань)

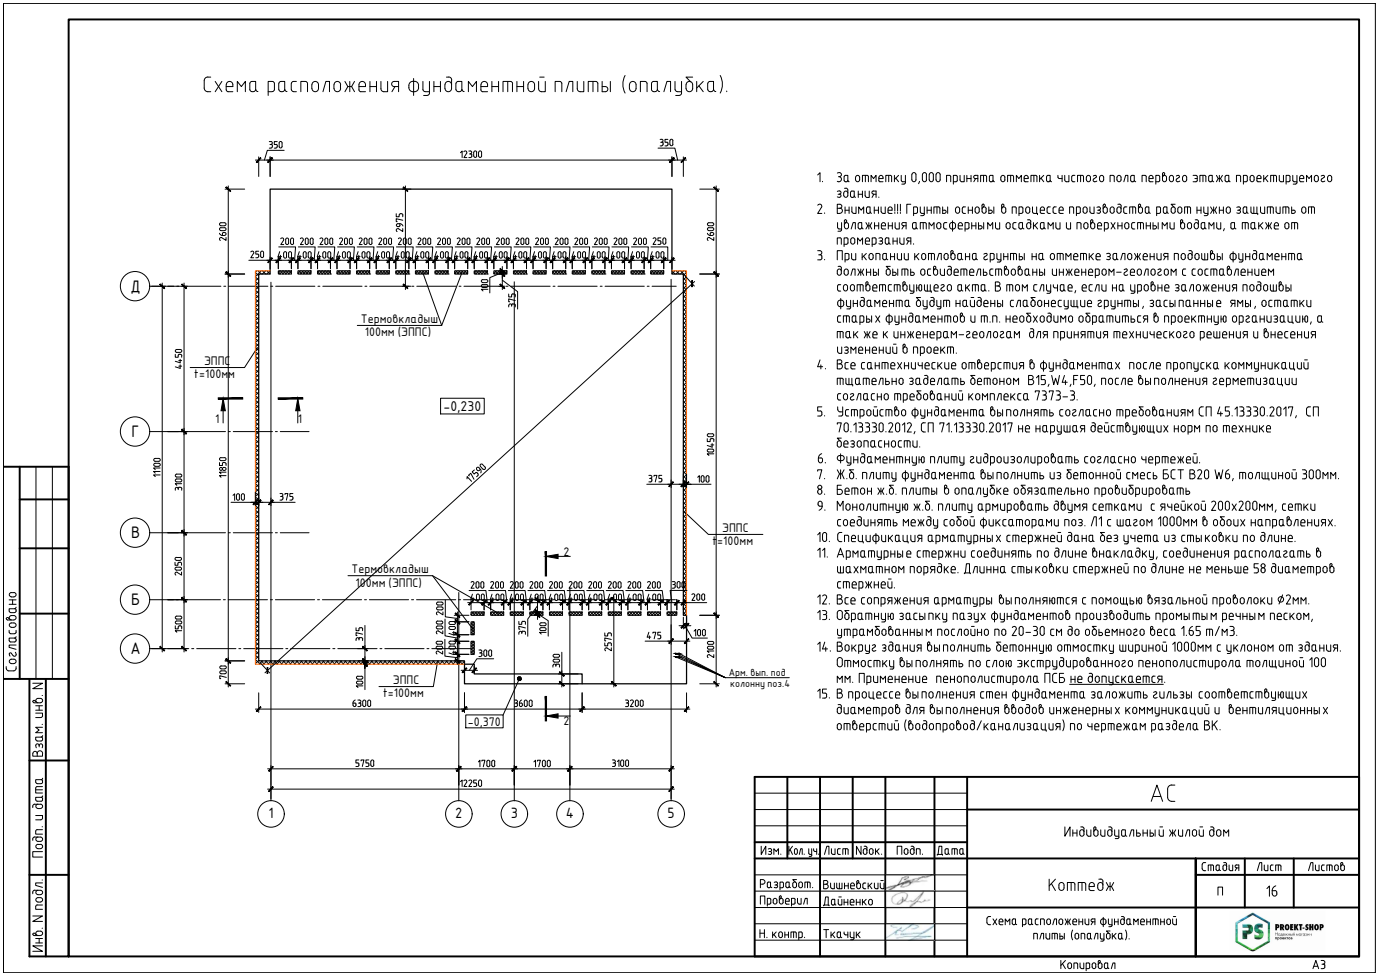
[picture p82: page 18]
ЭППС t=100мм; Термовкладыш 100мм (ЭППС)

Арм. вып. под
колонну поз.4

0,000

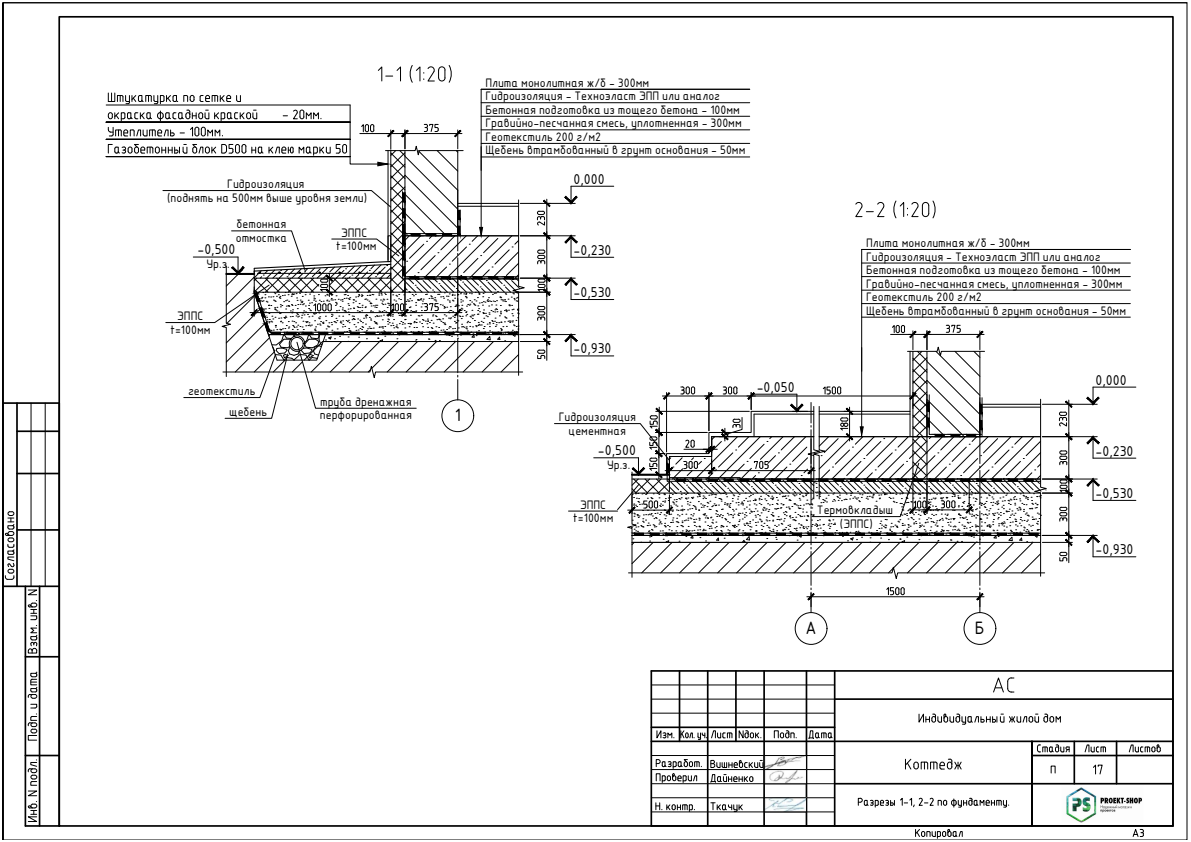
[picture p83: page 19]
ЭППС t=100мм; труба дренажная щебень; перфорированная; геотекстиль; бетонная отмостка; Гидроизоляция; Термовкладыш (ЭППС); Гидроизоляция цементная

Плита монолитная ж/б - 300мм
Гидроизоляция - Техноэласт ЭПП или аналог
Бетонная подготовка из тощего бетона - 100мм
Гравийно-песчанная смесь, уплотненная - 300мм
Геотекстиль 200 г/м2
Щебень втрамбованный в грунт основания - 50мм

(поднять на 500мм выше уровня земли)

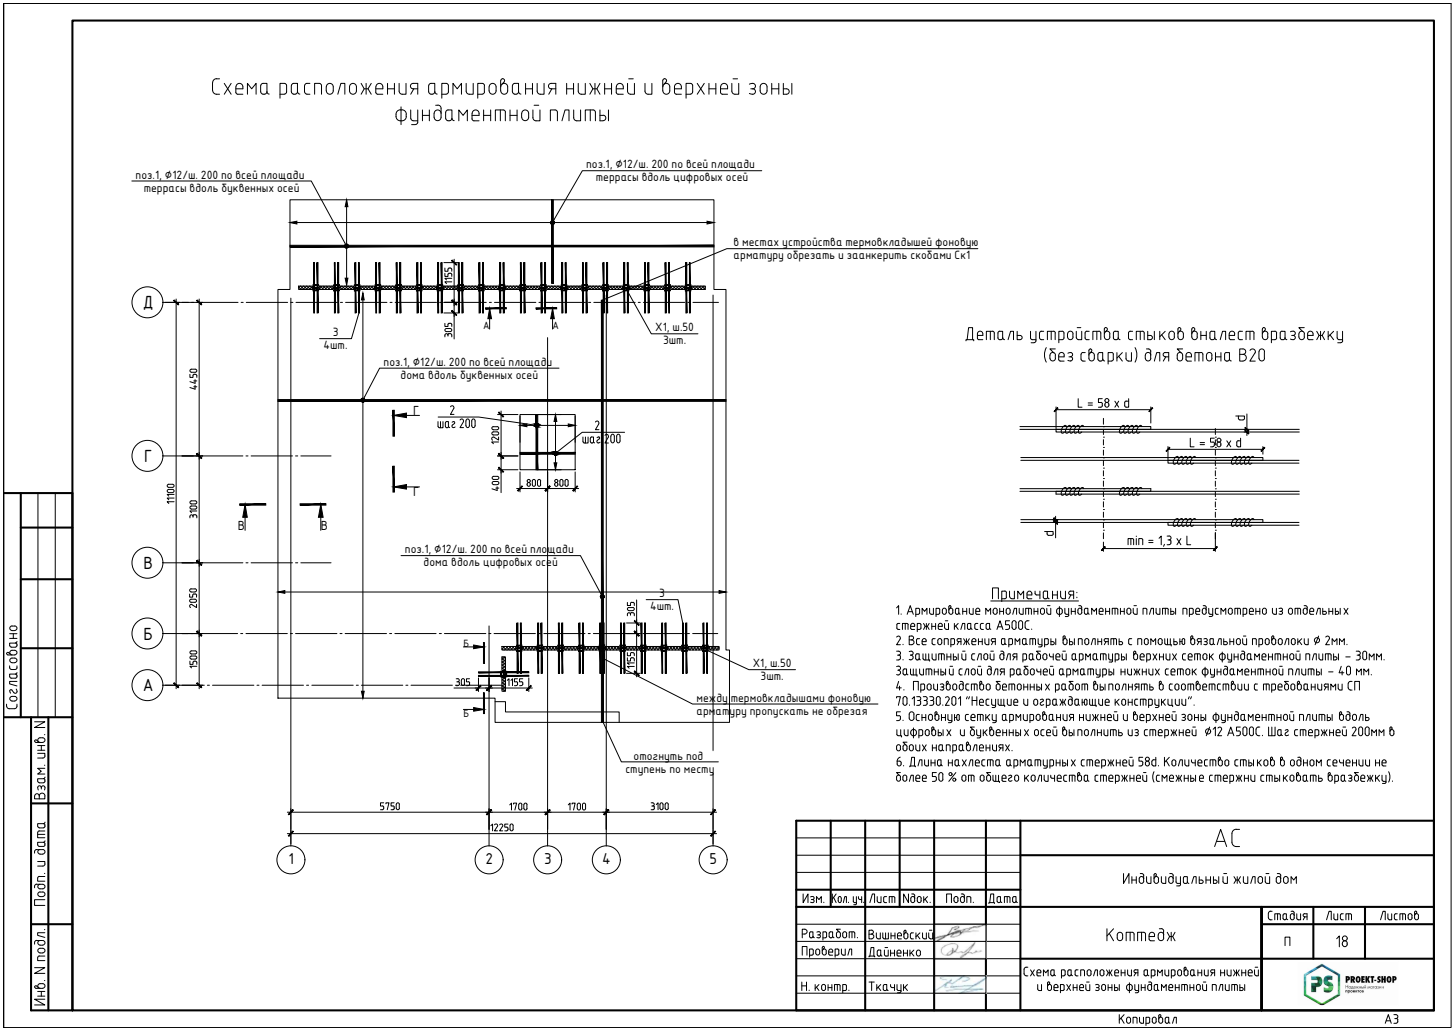
[picture p84: page 20]

поз.1, ∅12/ш. 200 по всей площади
террасы вдоль цифровых осей

террасы вдоль буквенных осей

в местах устройства термовкладышей фоновую
арматуру обрезать и заанкерить скобами Ск1

дома вдоль буквенных осей

Г Г поз.1, ∅12/ш. 200 по всей площади дома вдоль цифровых осей

между термовкладышами фоновую
арматуру пропускать не обрезая

отогнуть под
ступень по месту

-0,230

-0,530

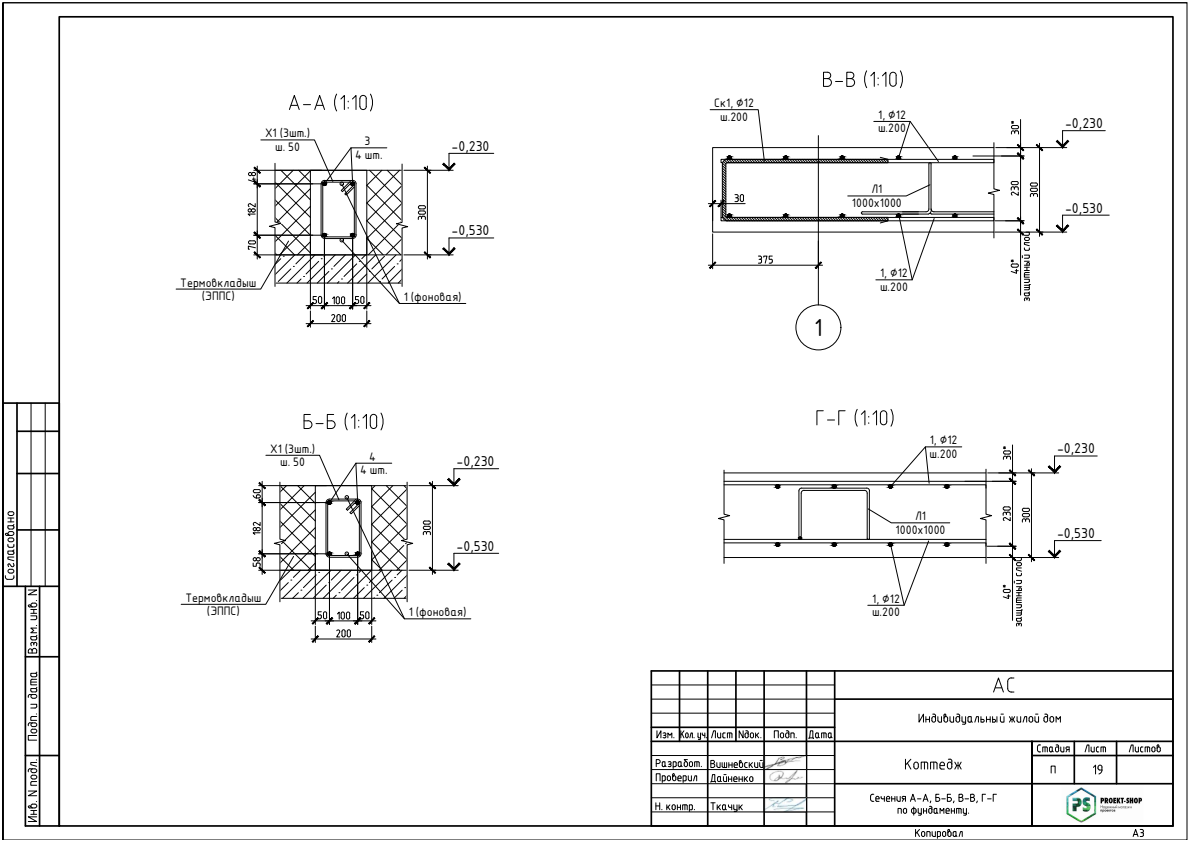
[picture p85: page 21]
Термовкладыш (ЭППС); 1 (фоновая)

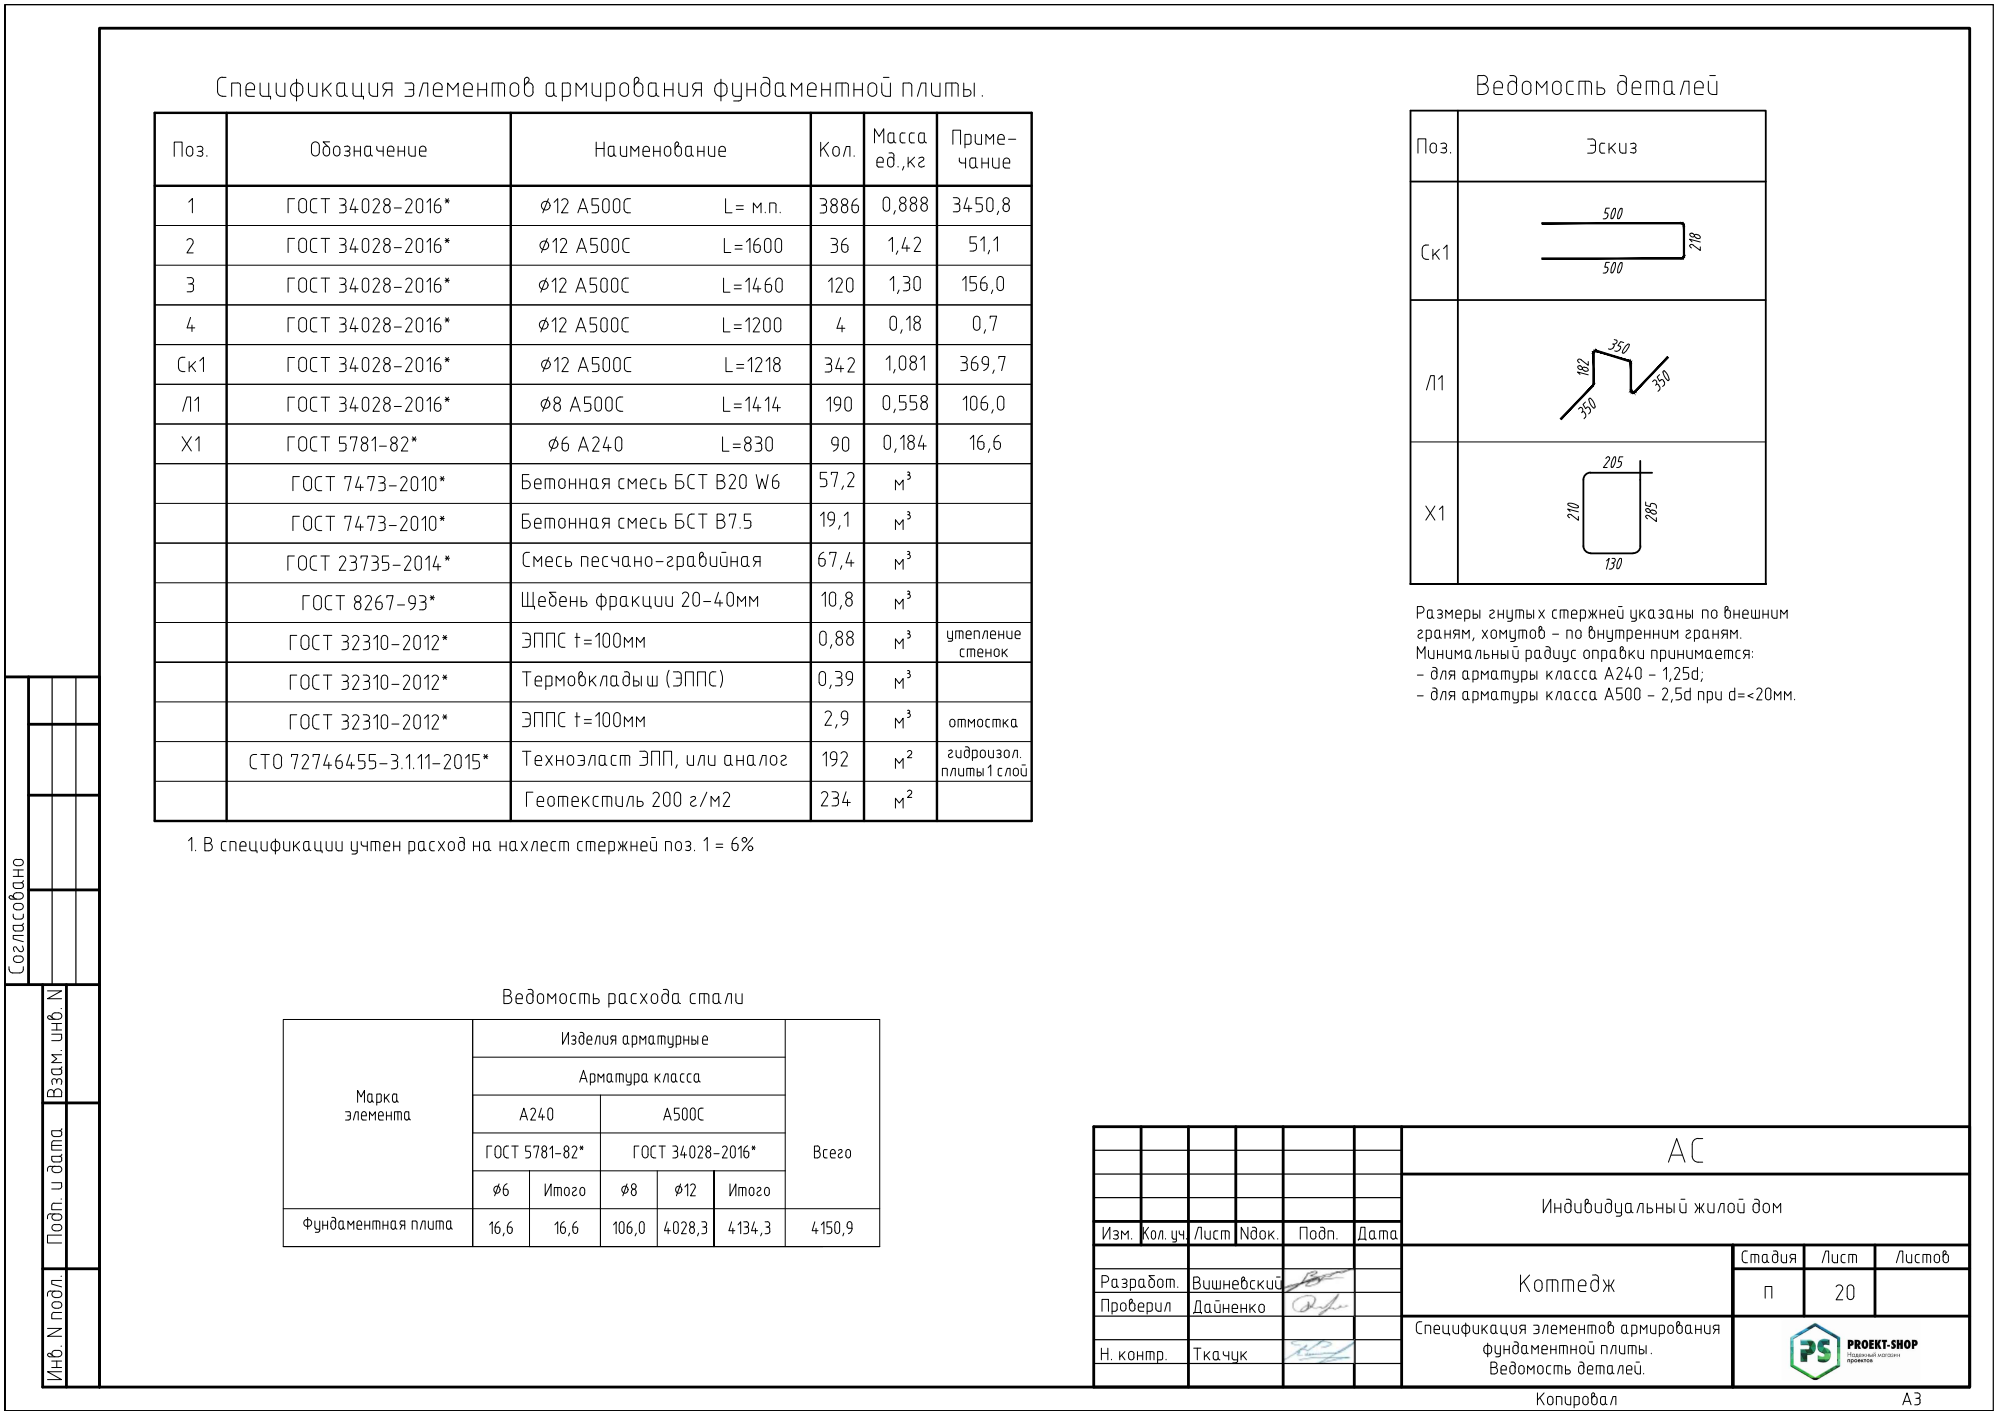
[picture p86: page 22]

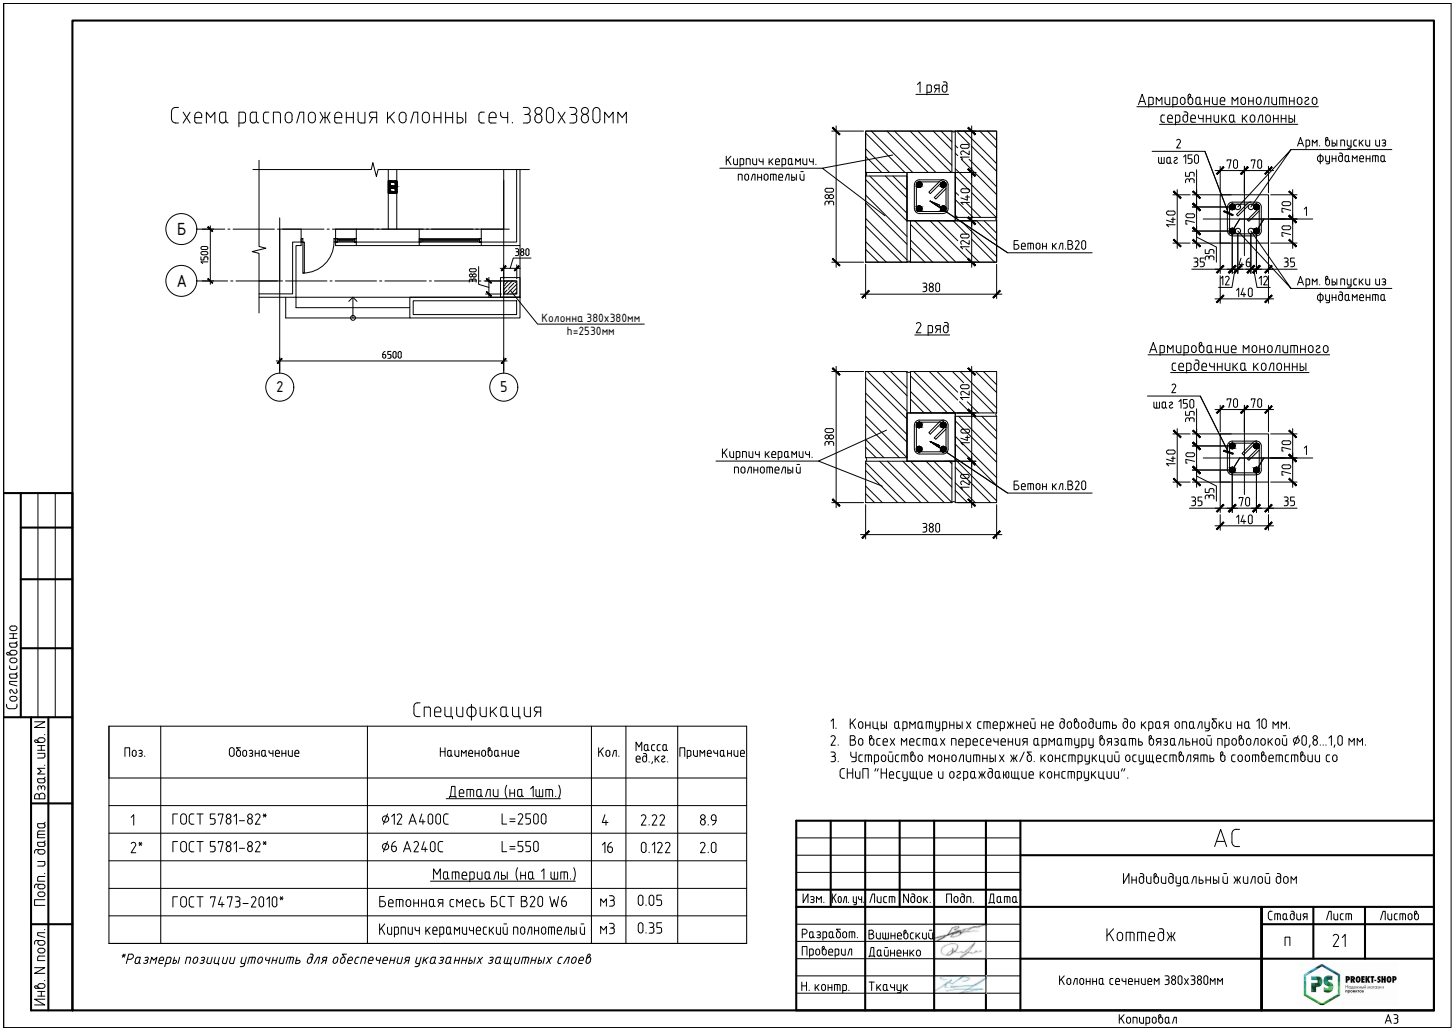
[picture p87: page 23]
Колонна 380х380мм h=2530мм

## БСТ В25 U-блок

375мм

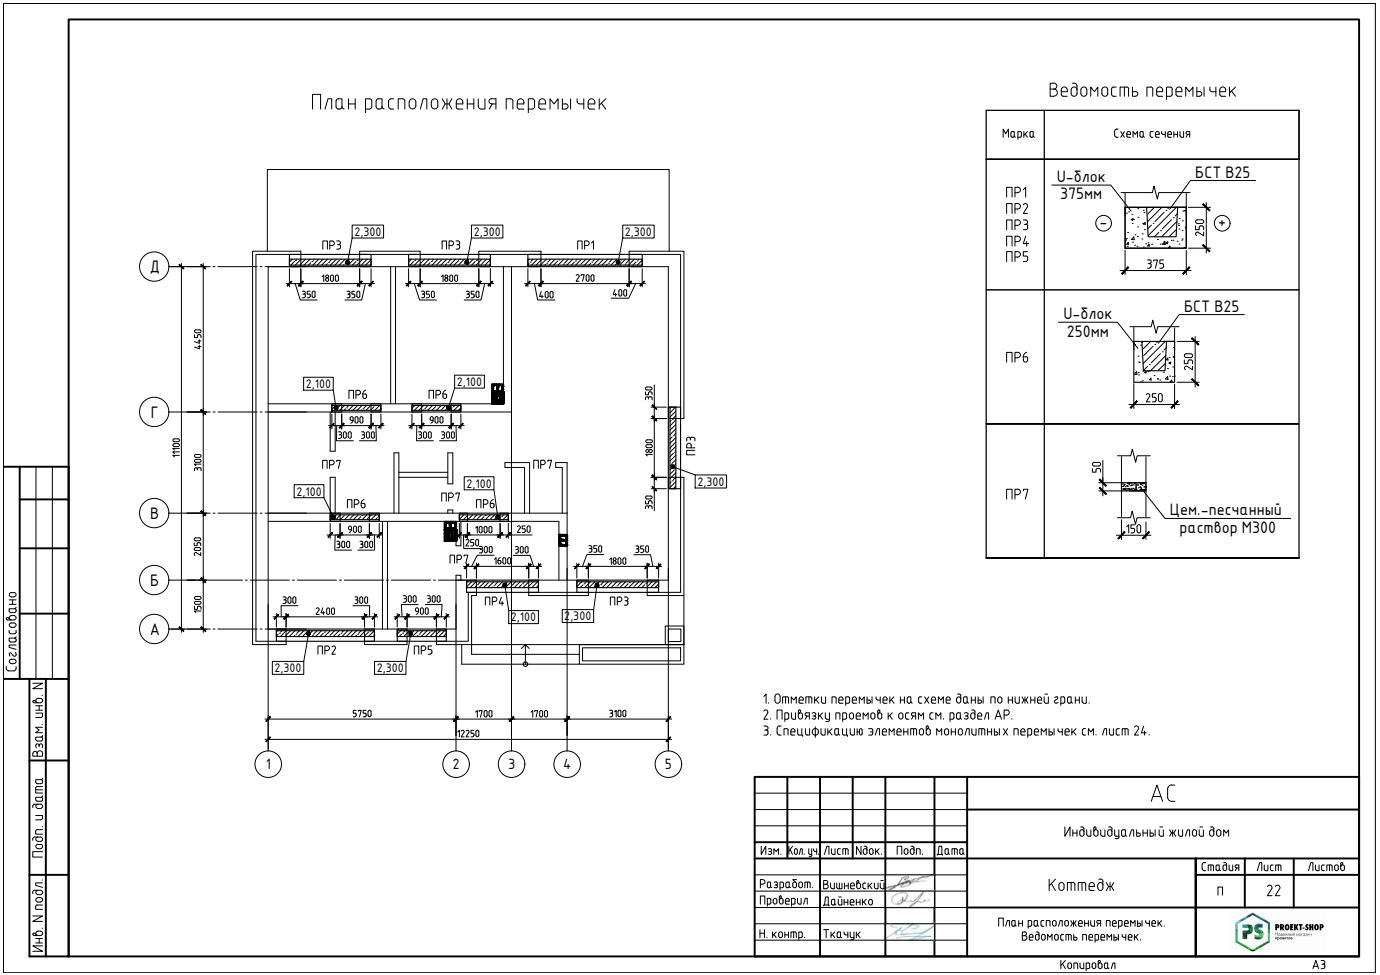
[picture p88: page 24]
Цем.-песчанный раствор М300; БСТ В25 U-блок

∅16 (А500С)
2 шт.

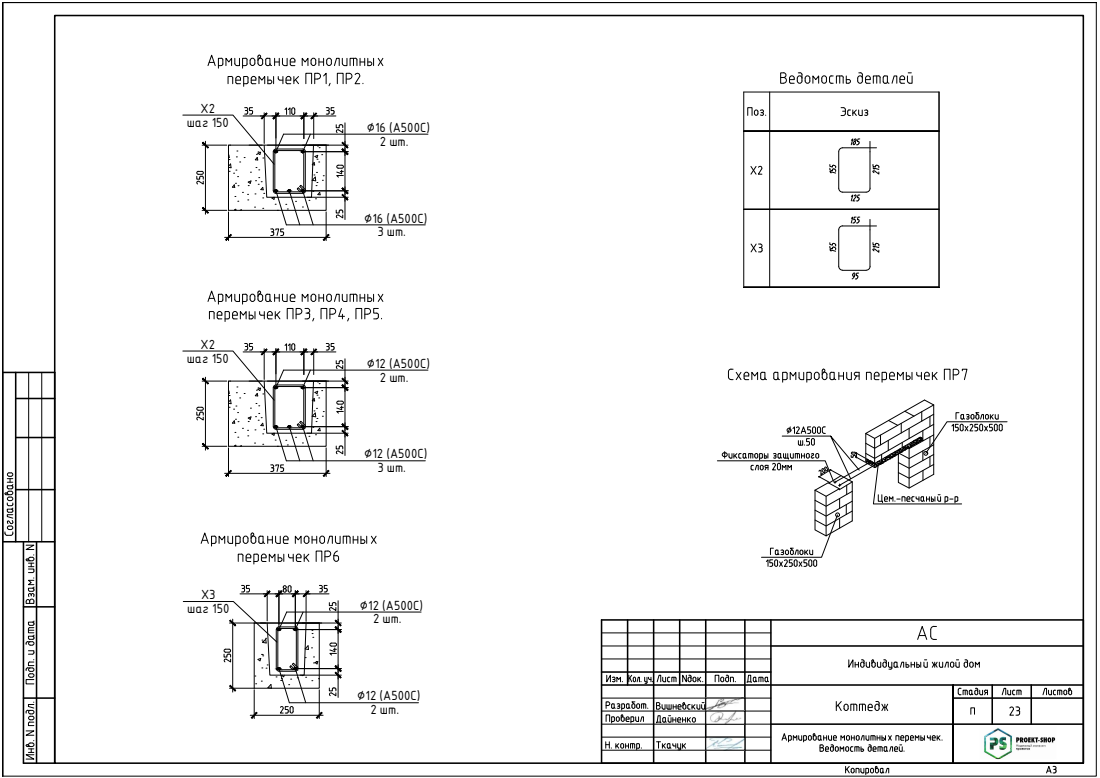
[picture p89: page 25]
Х2 шаг 150; Х3 шаг 150

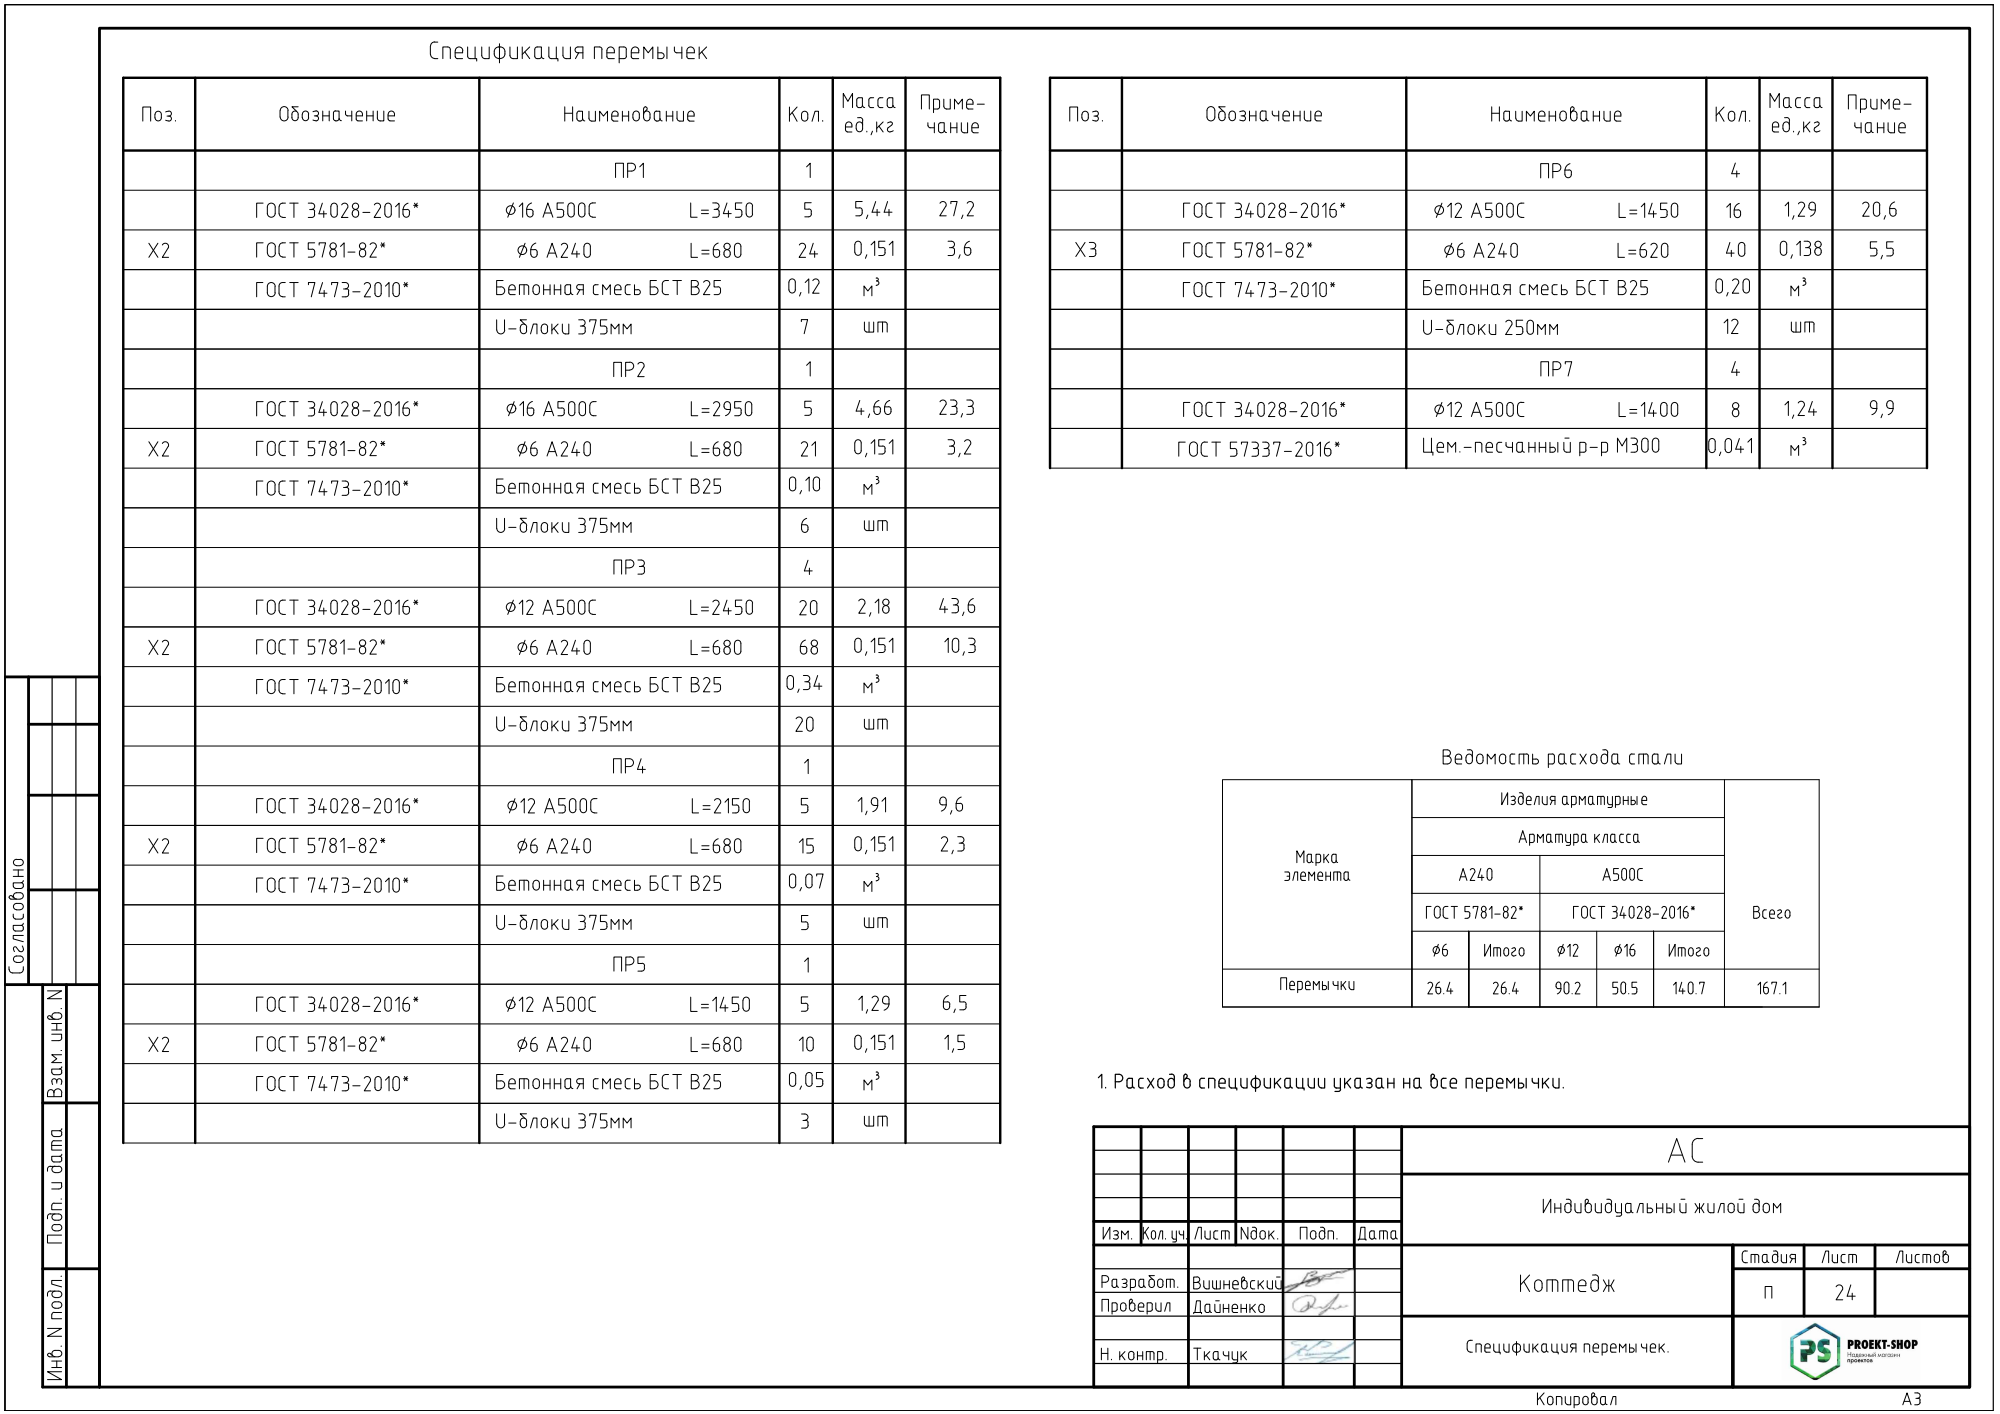
[picture p90: page 26]

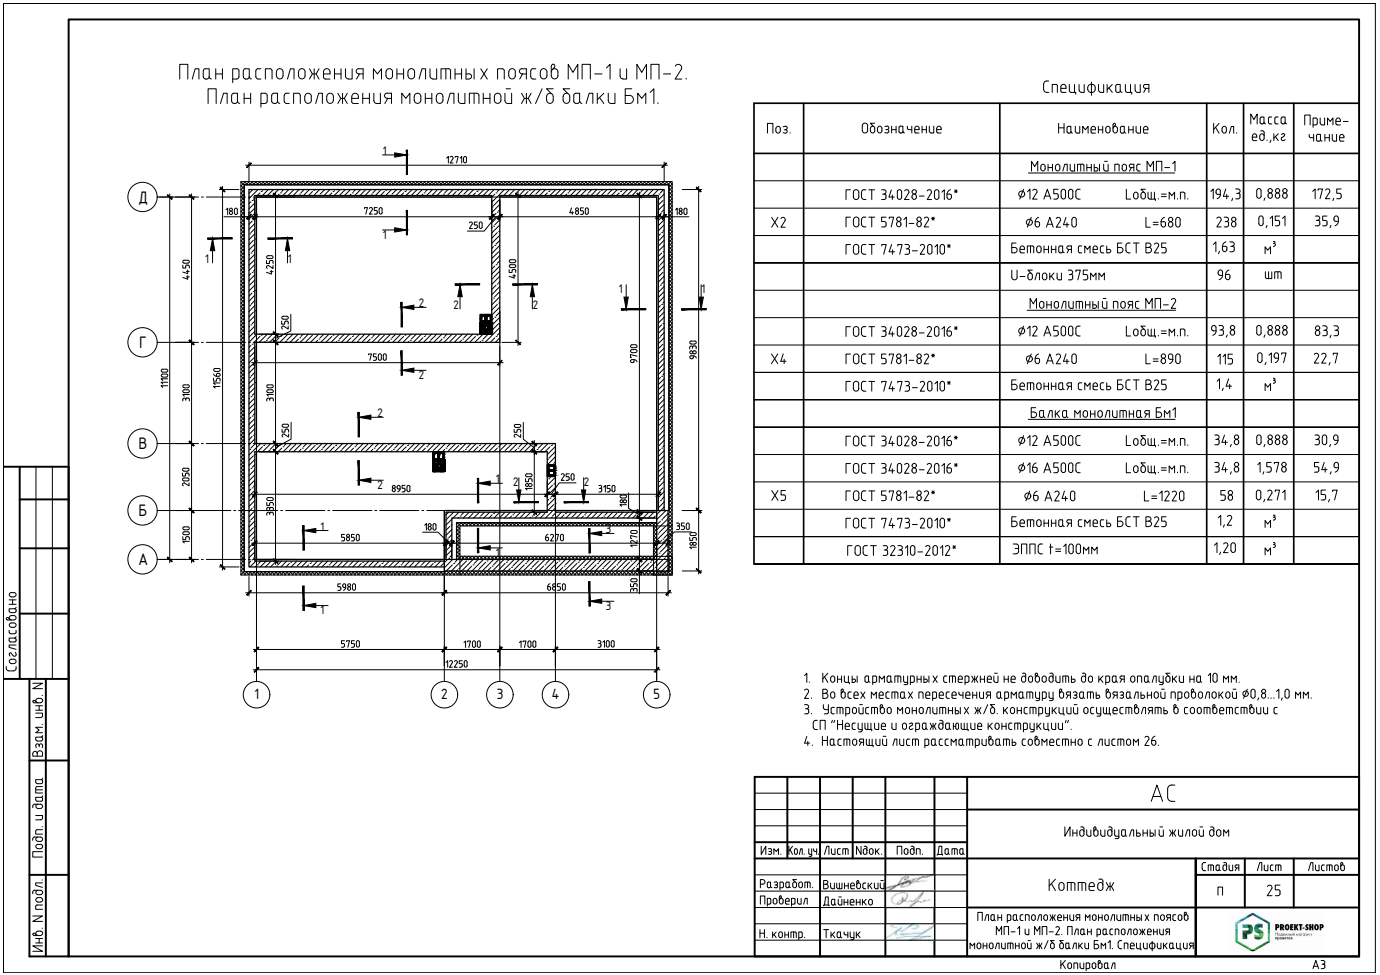
[picture p91: page 27]
5 АБВДГ

∅12 (А500)

∅12 (А500)

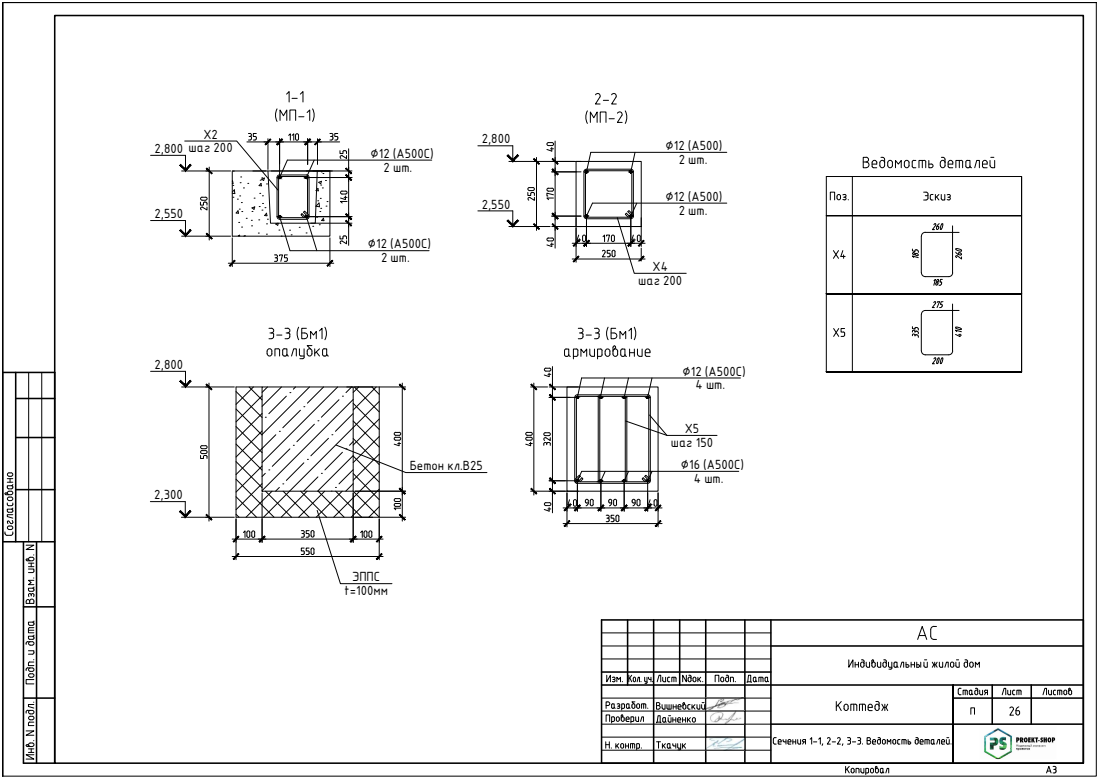
[picture p92: page 28]
Х4 шаг 200; Х2 шаг 200; Х5 шаг 150; Бетон кл.В25; ЭППС t=100мм

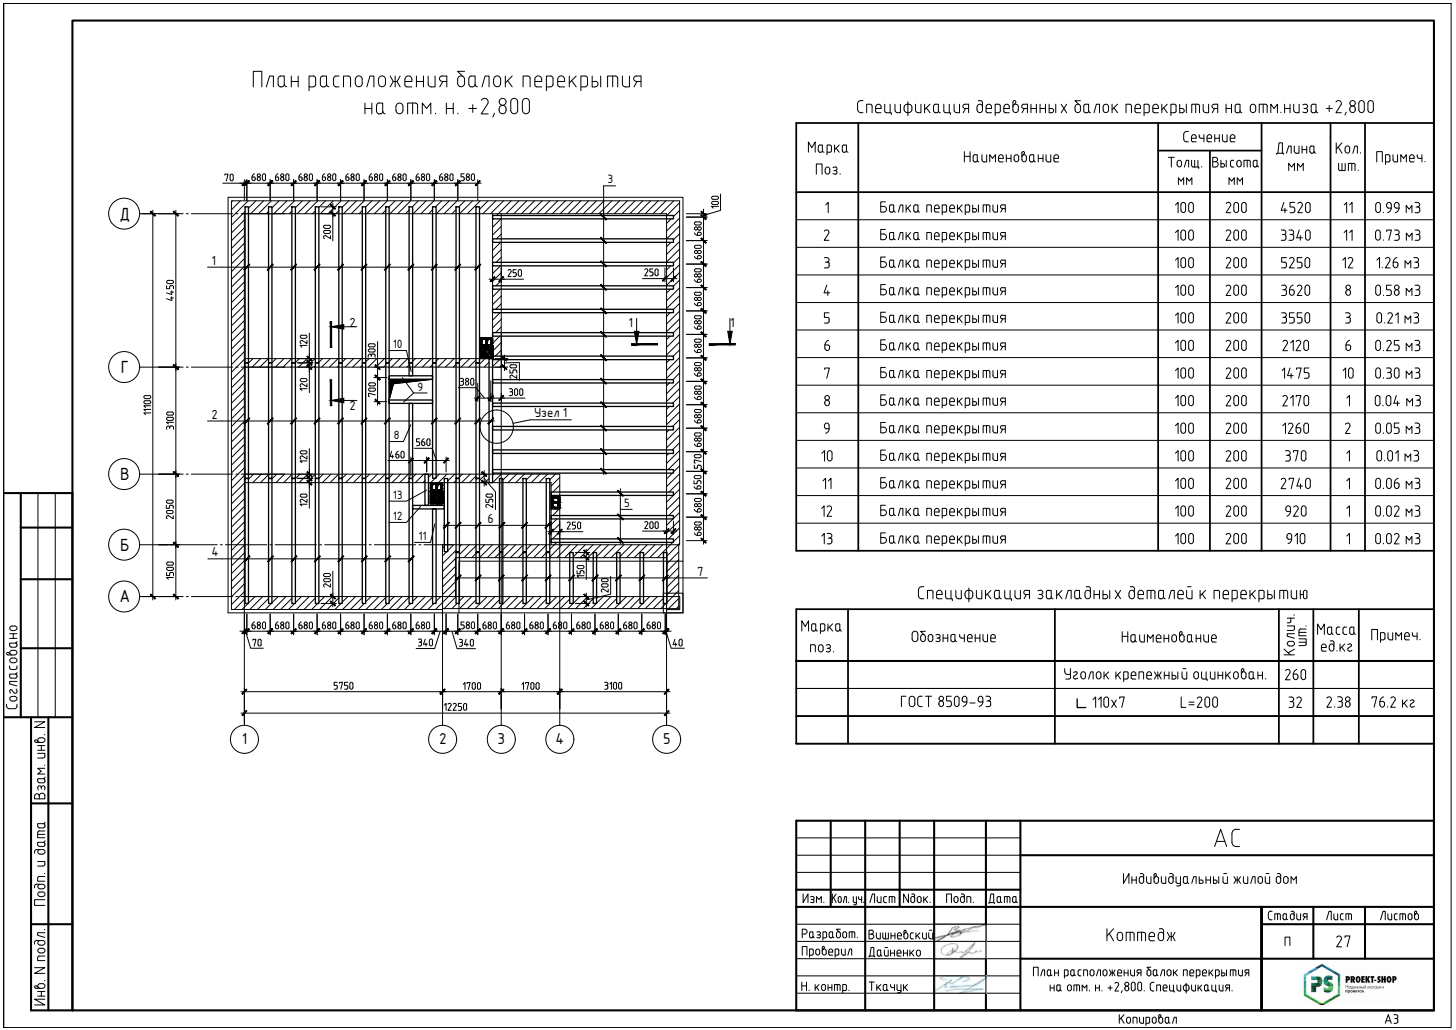
[picture p93: page 29]
Узел 1 1; 5 АБВДГ

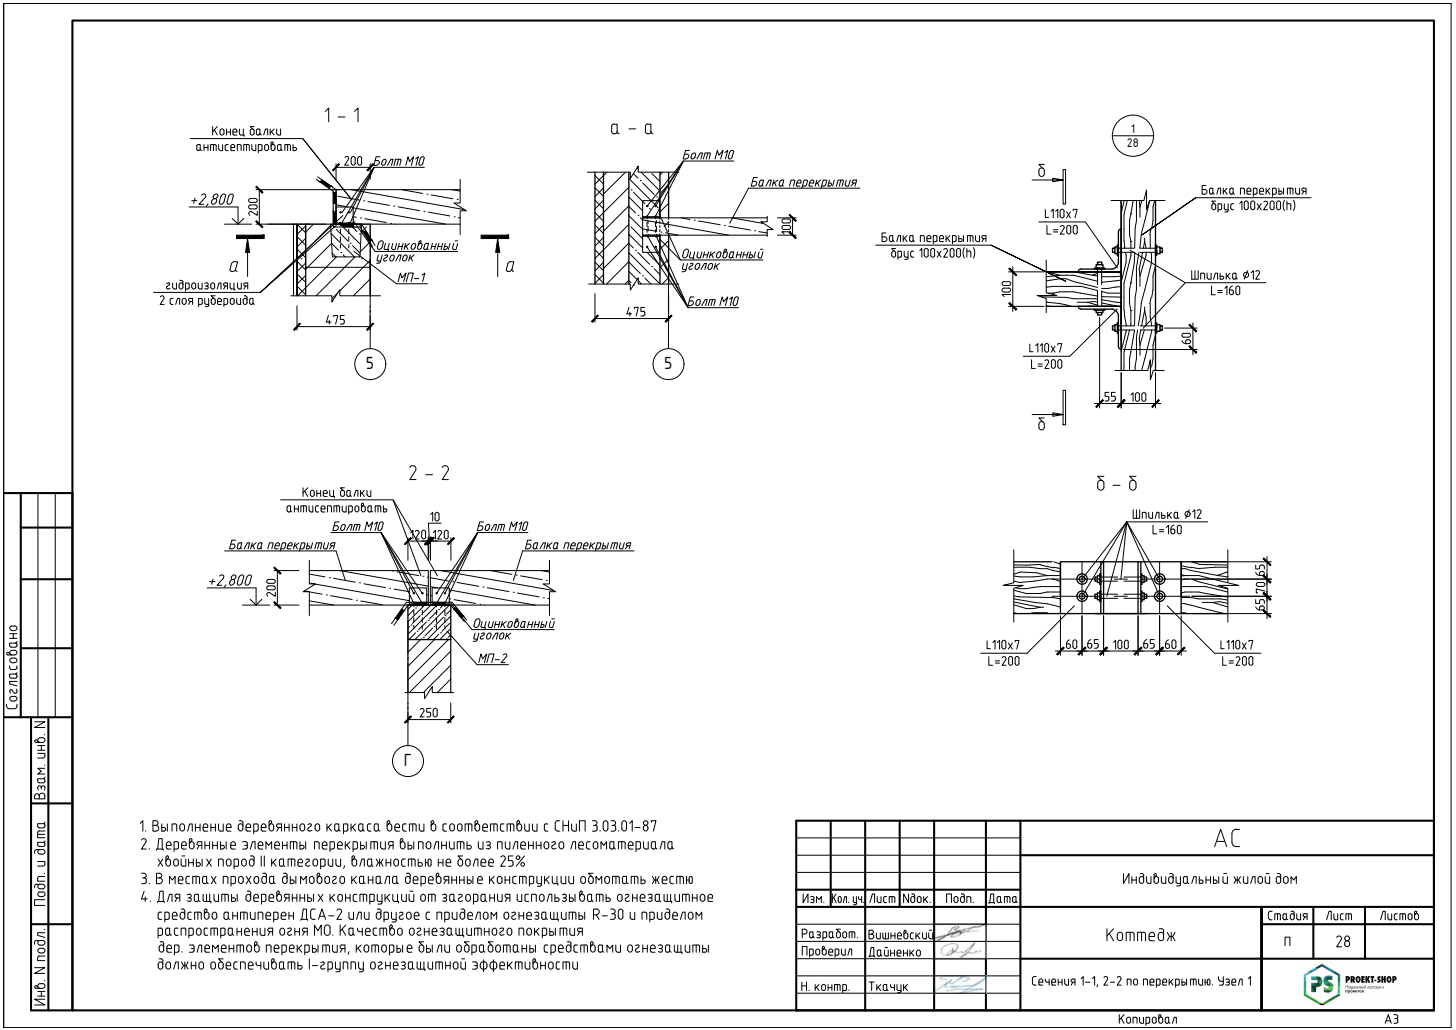
[picture p94: page 30]

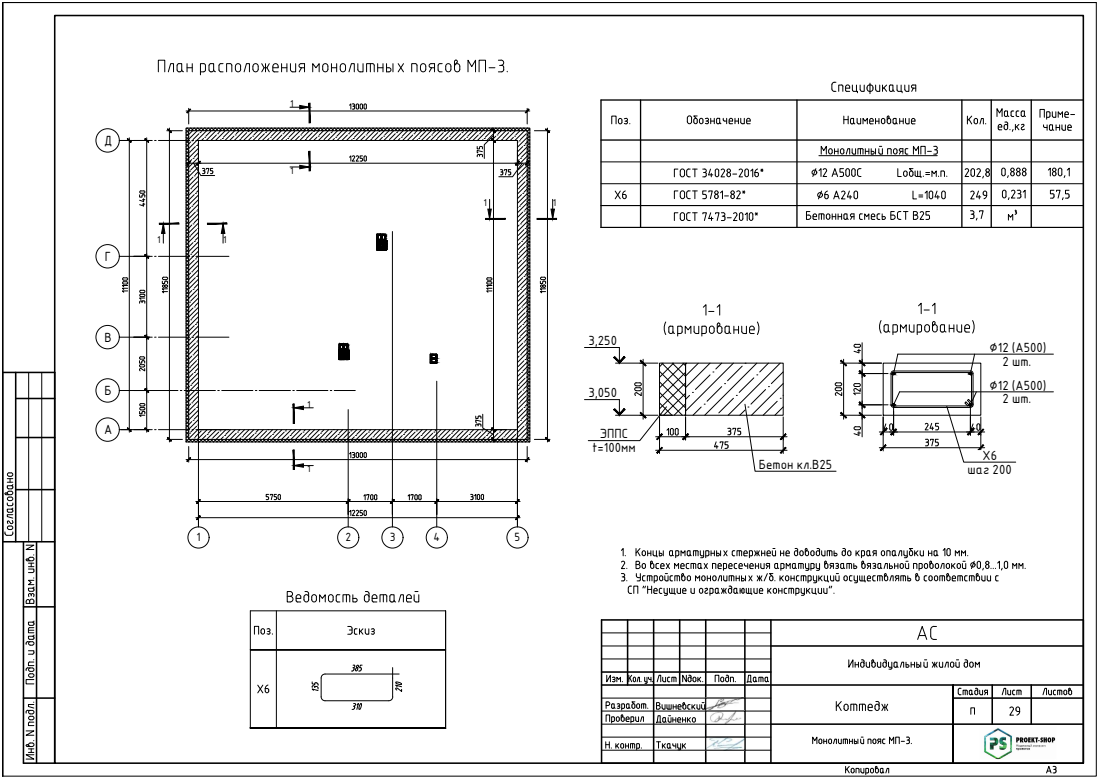
[picture p95: page 31]
5 АБВДГ; ЭППС t=100мм

шаг 200 Бетон кл.В25

Д

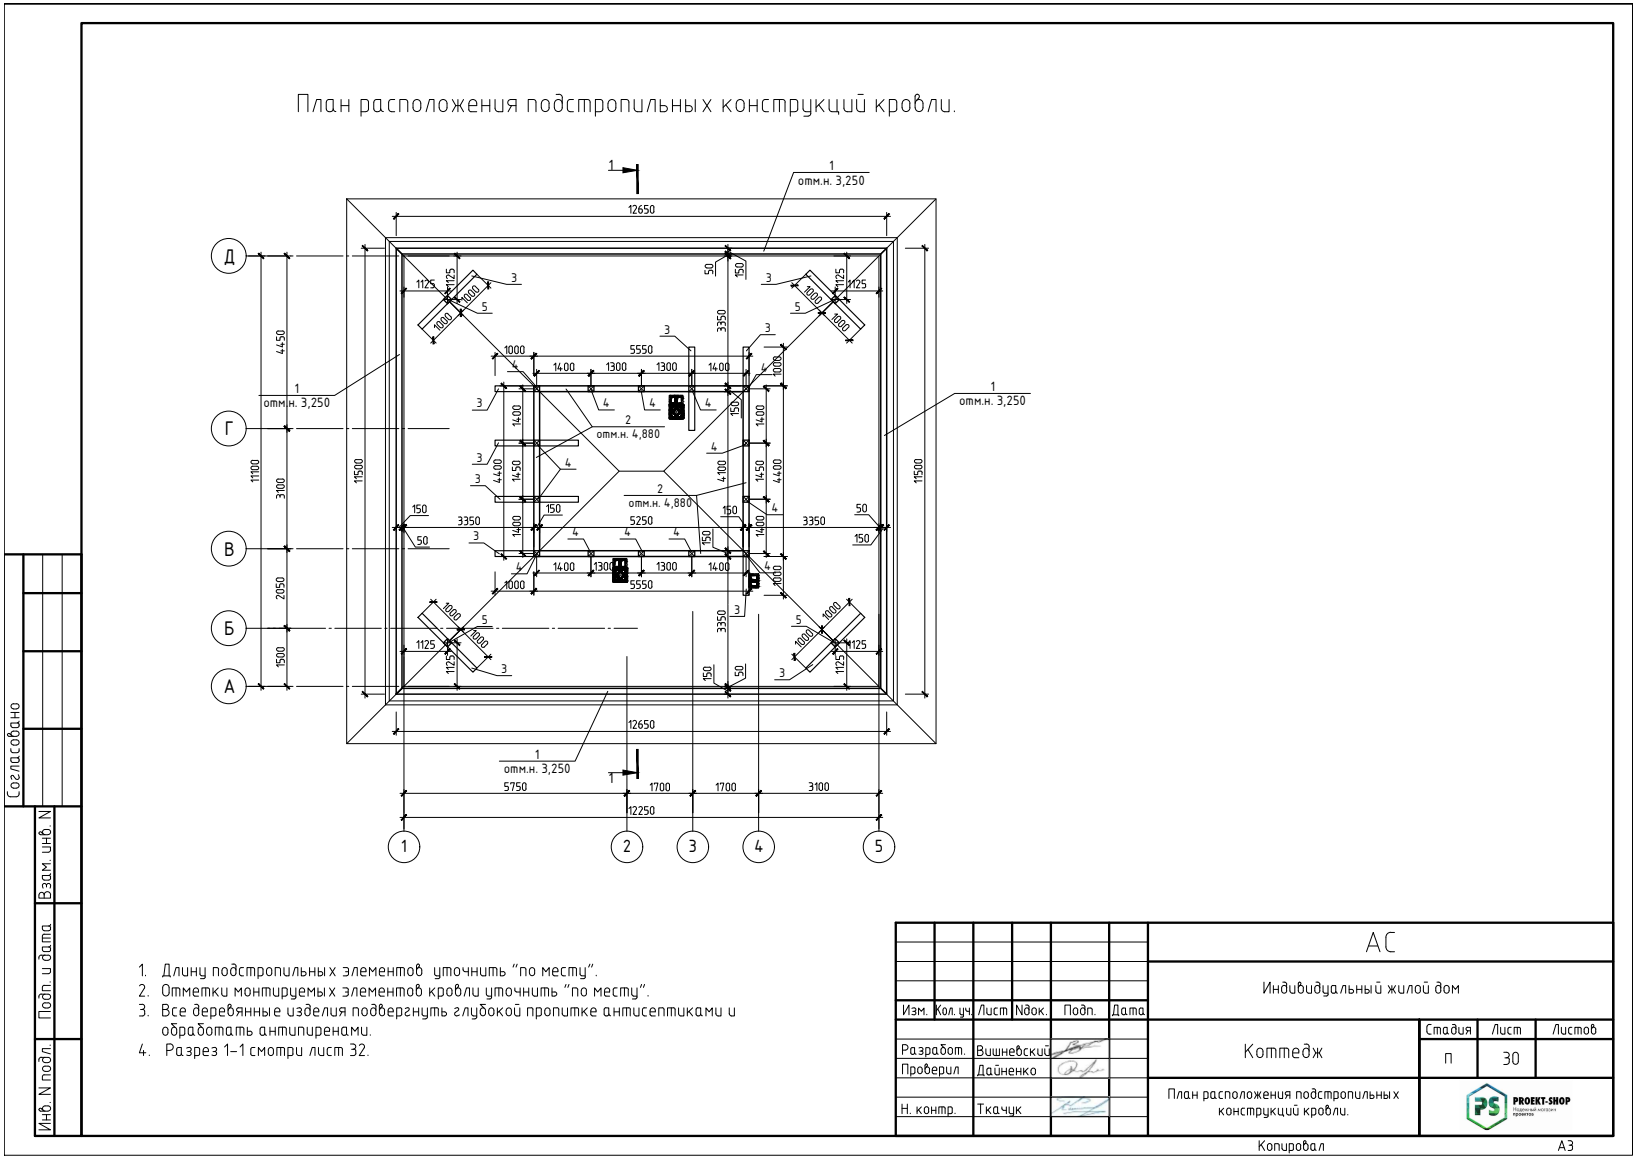
[picture p96: page 32]
1 отм.н. 3,250; 2 отм.н. 4,880

Д

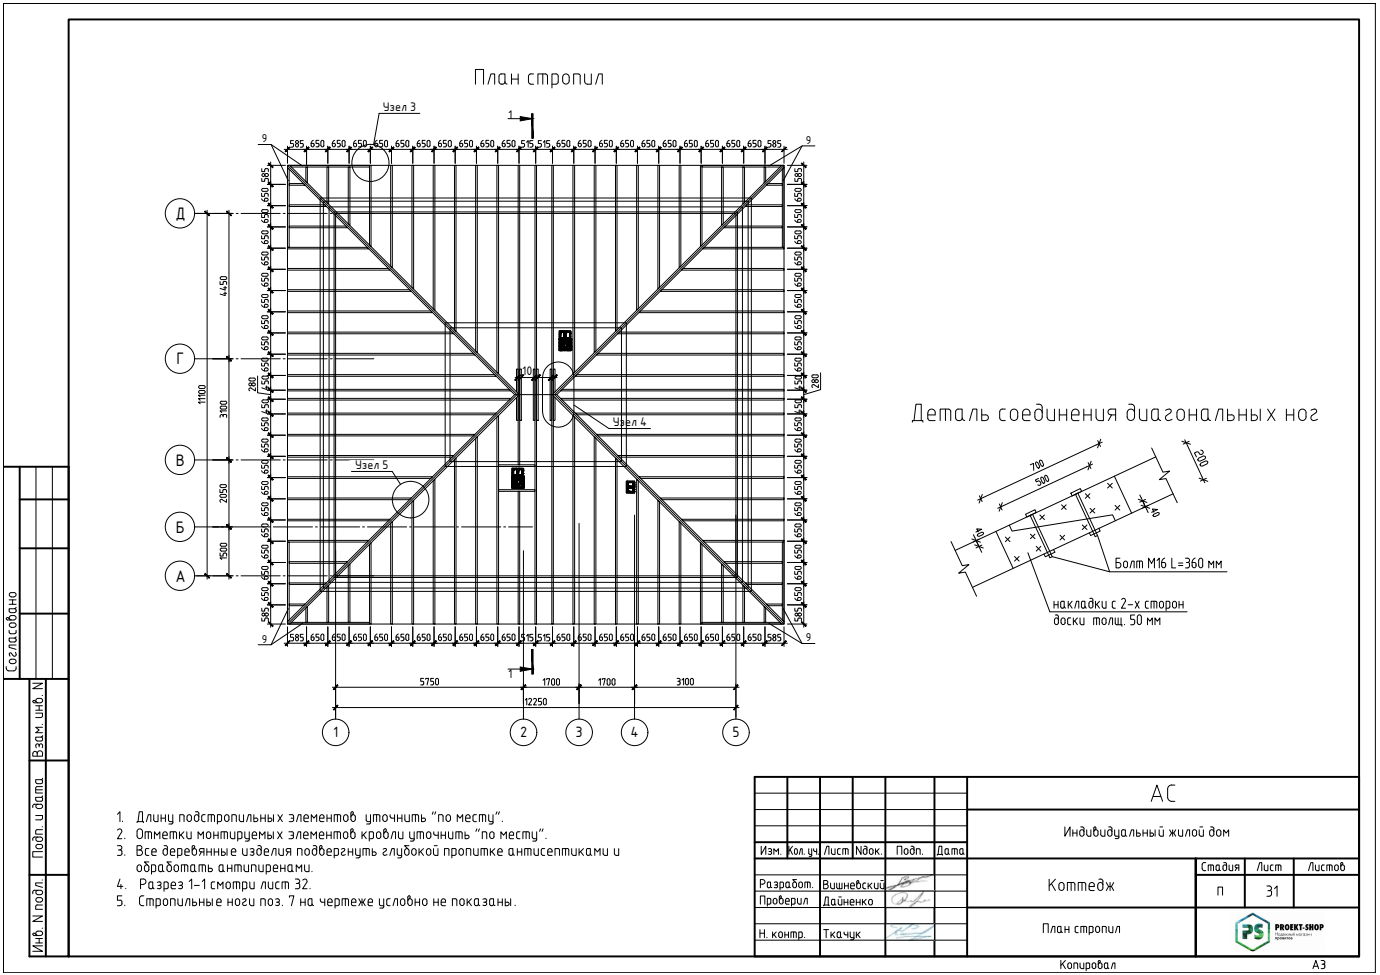
[picture p97: page 33]
Узел 3; Узел 5; Узел 4

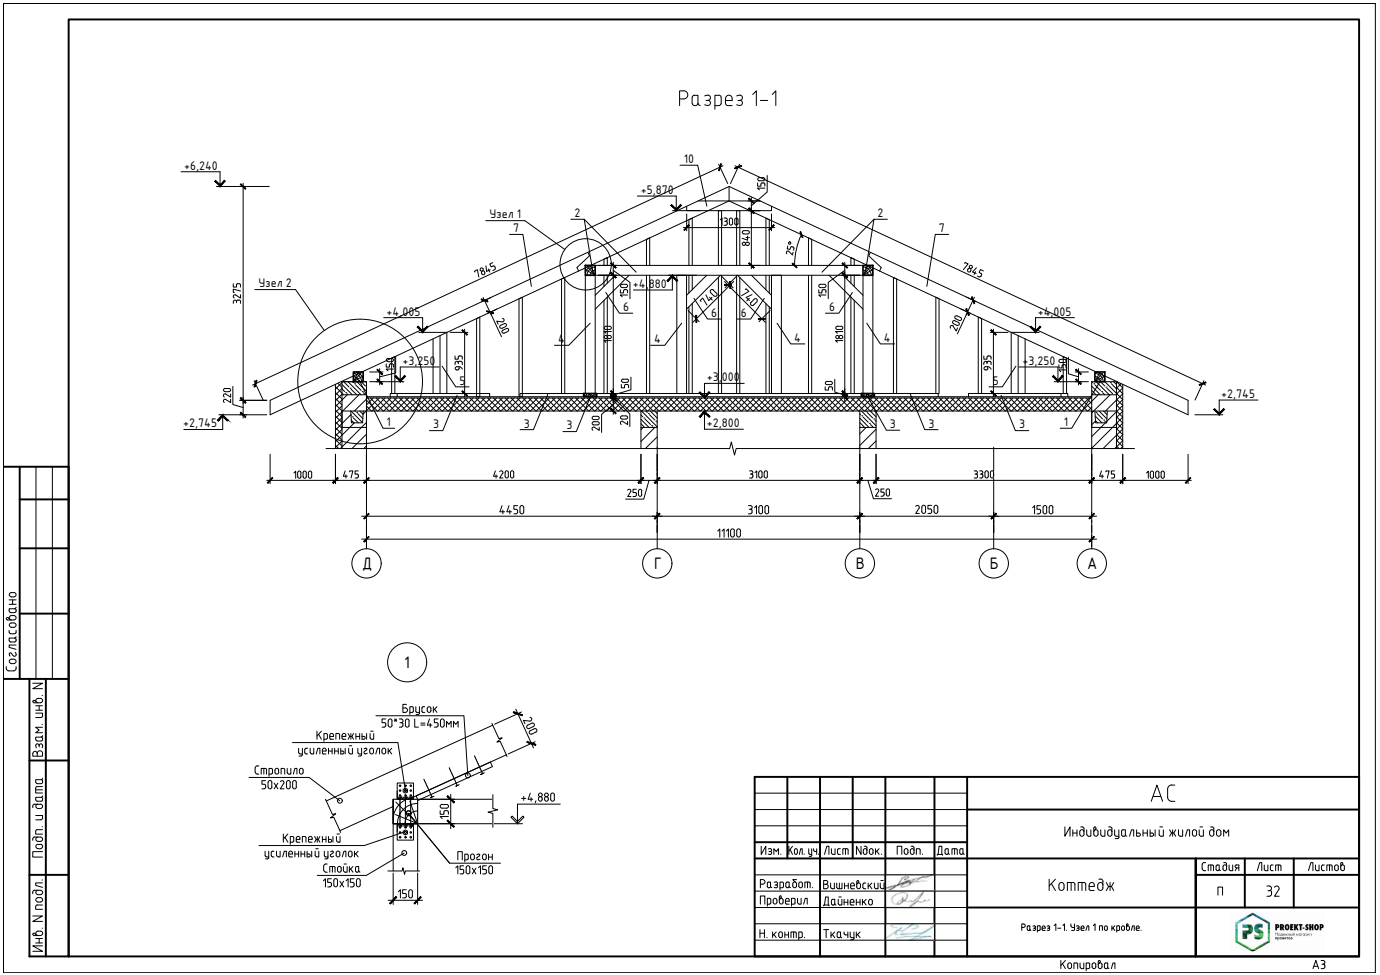
[picture p98: page 34]
Узел 1; Узел 2

## Гвозди К4х100

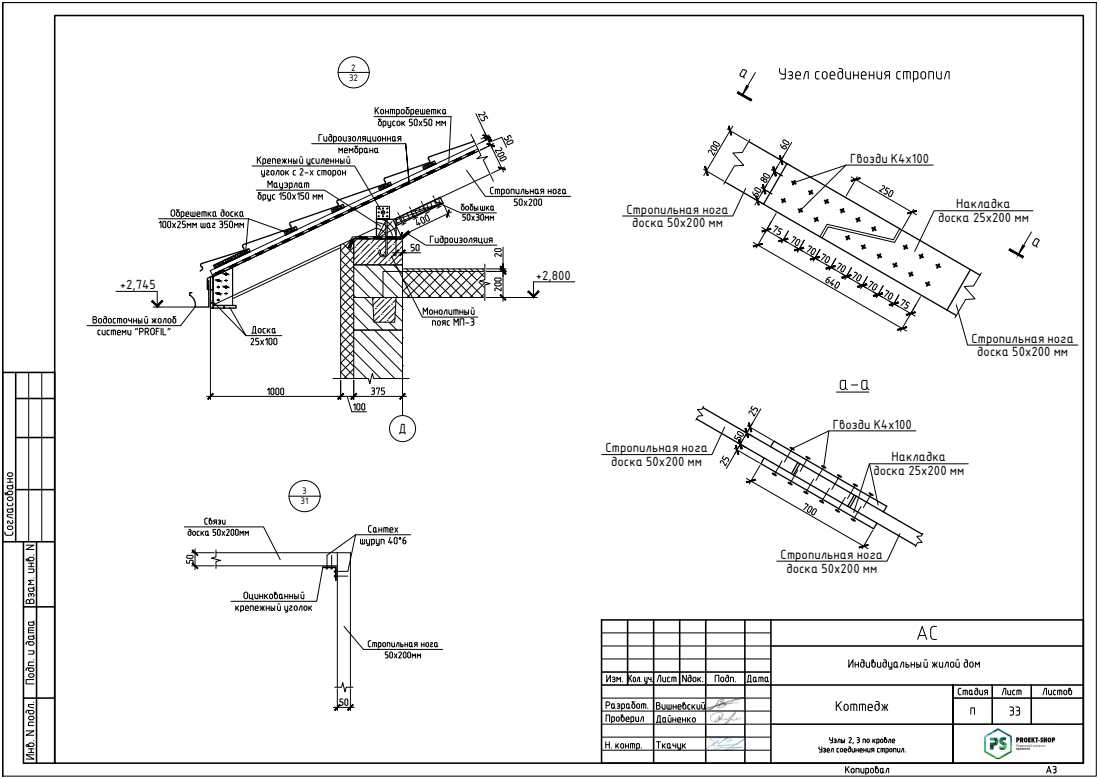
[picture p99: page 35]
Стропильная нога доска 50х200 мм; Накладка доска 25х200 мм; Гвозди К4х100

315 | г | г бб

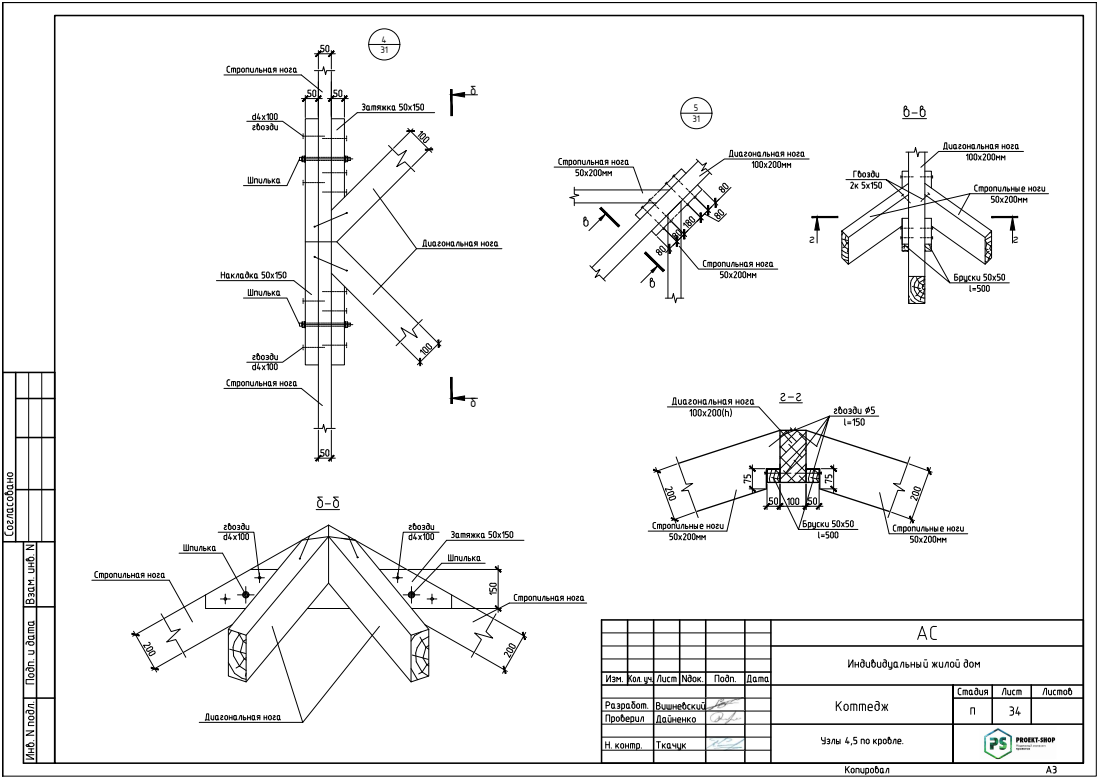
[picture p100: page 36]

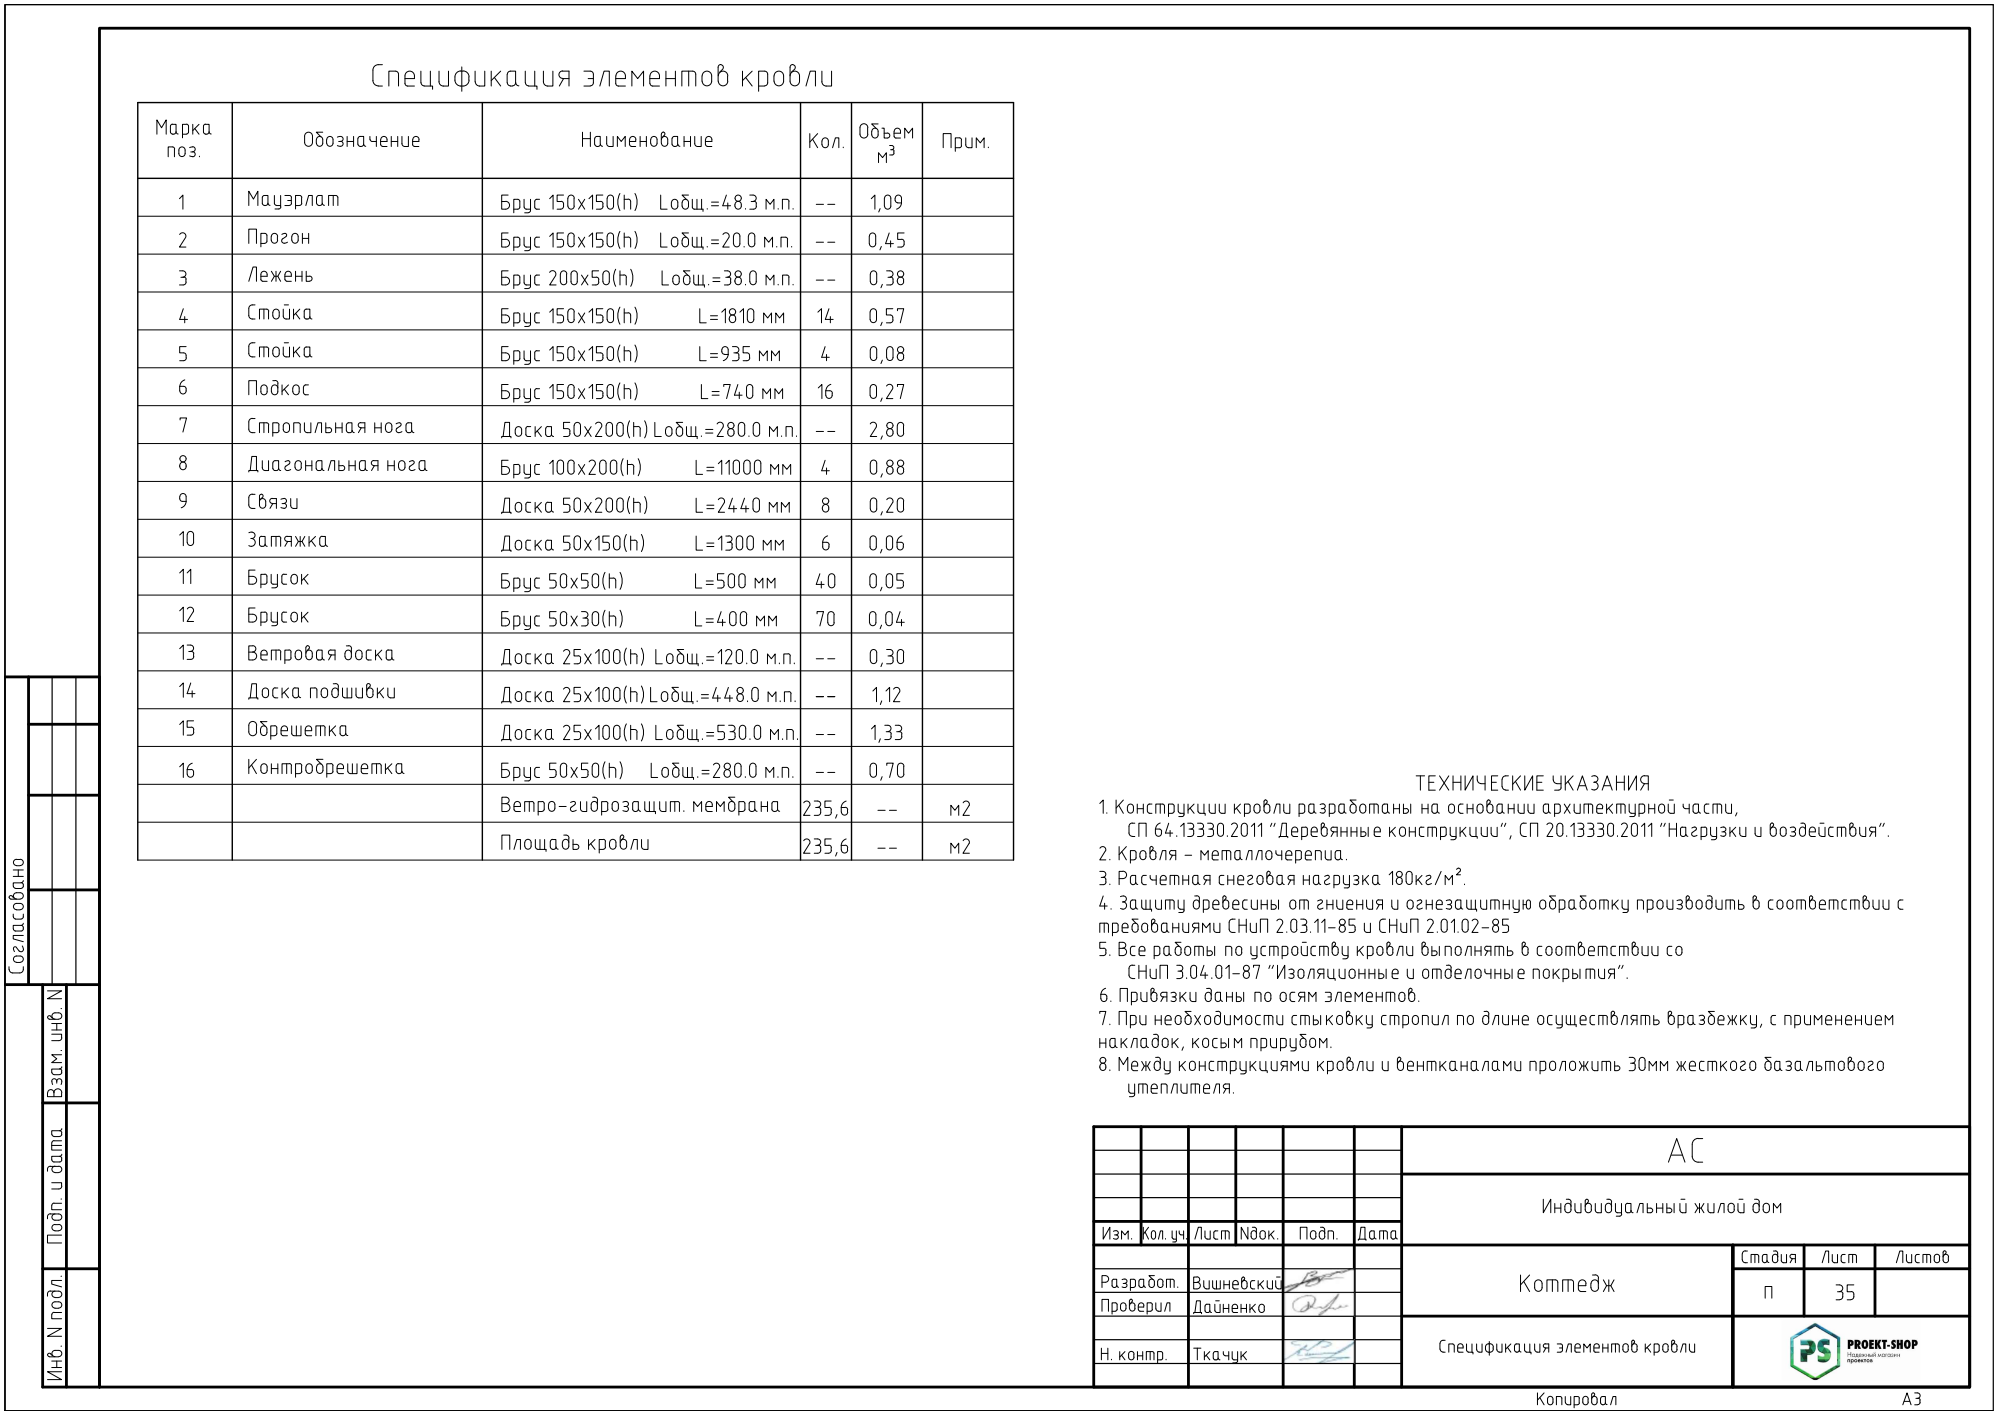
[picture p101: page 37]
