zip1982b/my_home/pdf/Фундамент ленточный АС 6-131.pdf

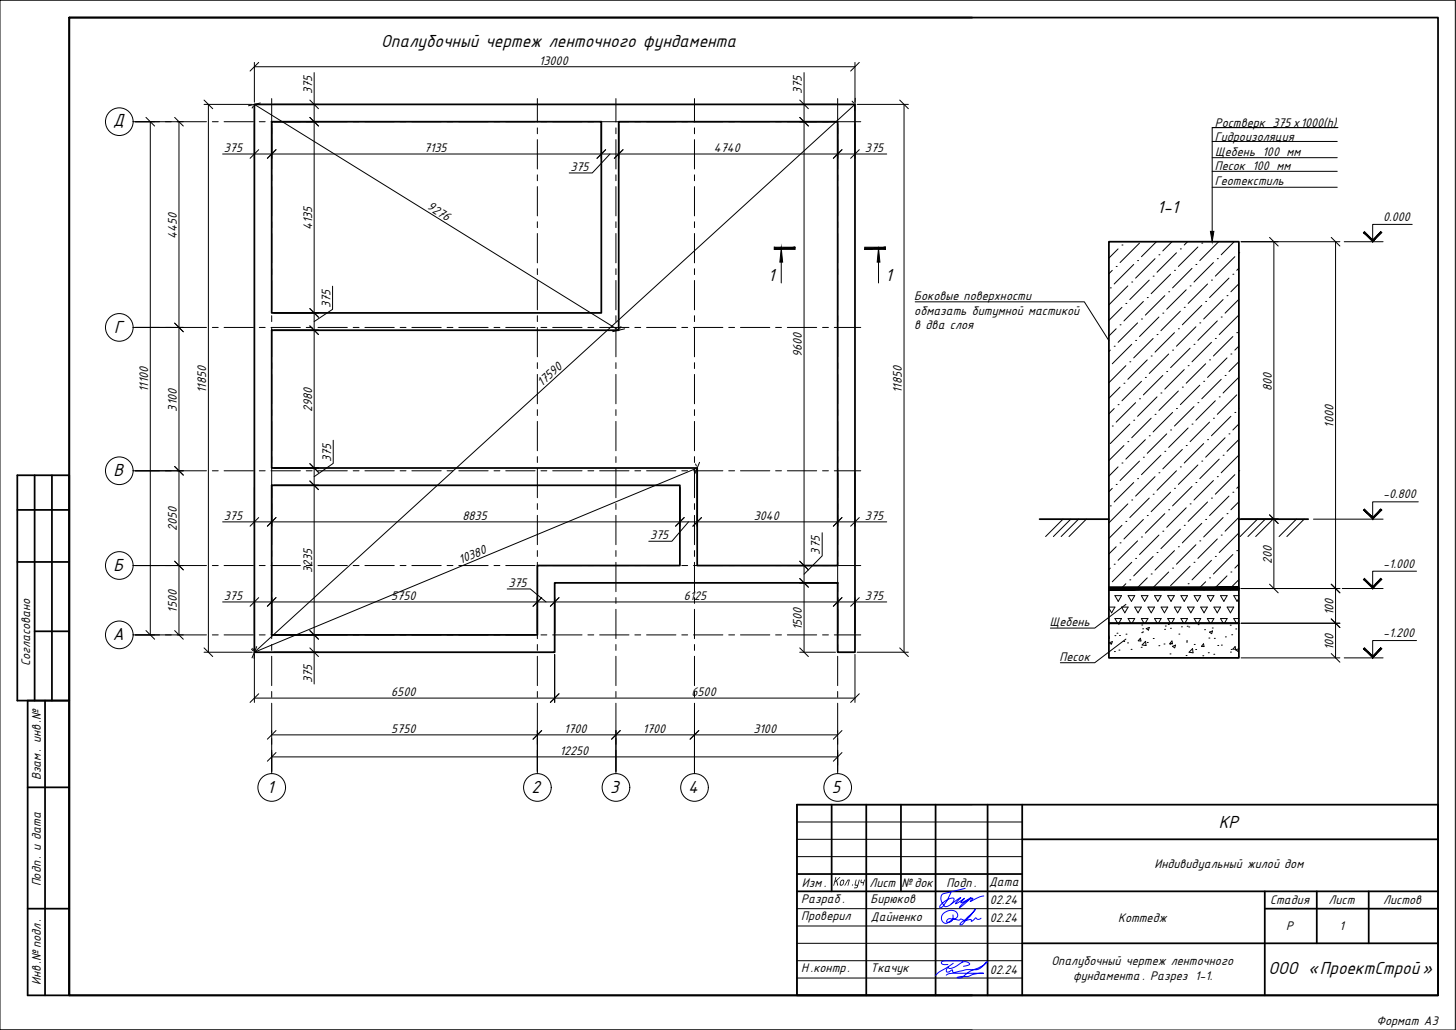
[picture p102: page 1]
Ростверк 375 х 1000(h); Щебень 100 мм Песок 100 мм; Н .контр .; Ткачук; ООО «ПроектСтрой »

Опалубочный чертеж ленточного фундамента

Боковые поверхности
обмазать битумной мастикой
в два слоя

Формат А3 Инв .№ подл . Подп . и дата Взам . инв .№ Согласовано

Индивидуальный жилой дом

Изм . Кол .уч | | Лист № док | Подп . | | Дата
Разраб . | Бирюков | | 02.24 | Коттедж | Стадия | Лист | Листов
Проверил | Дайненко | | 02.24 | | Р | 1

Опалубочный чертеж ленточного
фундамента . Разрез 1-1.

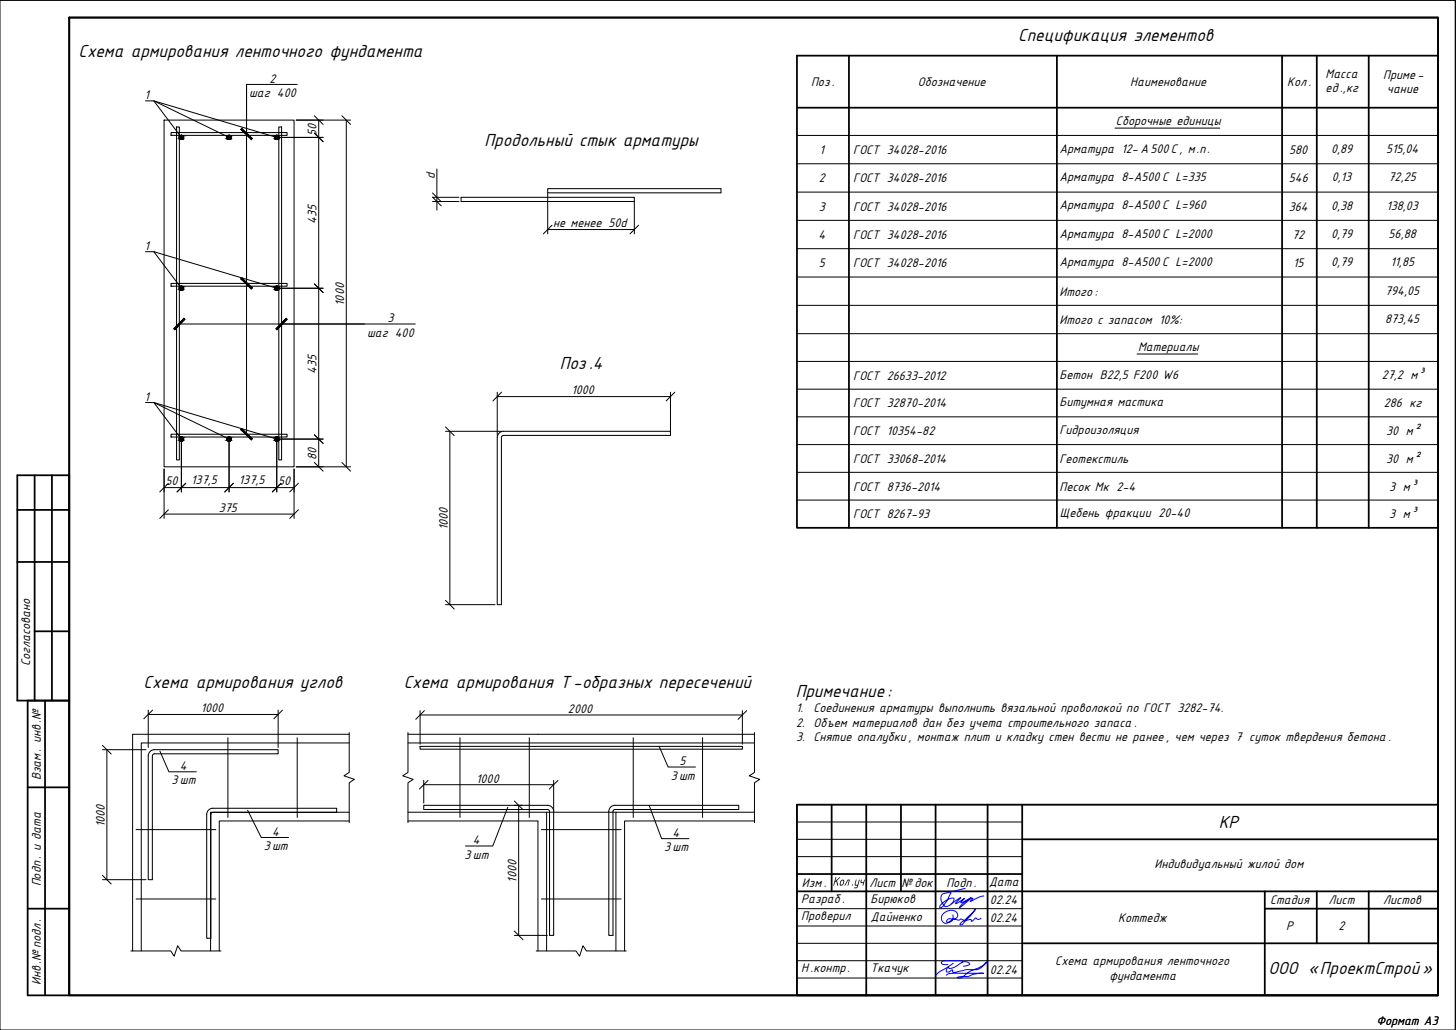
[picture p103: page 2]
Спецификация элементов; ГОСТ 10354-82; Гидроизоляция; 30 м² ГОСТ 33068-2014; Геотекстиль; 30 м² ГОСТ 8736-2014; Песок Мк 2-4; 3 м³ ГОСТ 8267-93; Щебень фракции 20-40; Формат А3; Поз .4; не менее 50d; шаг 400; Н .контр .; Ткачук; ООО «ПроектСтрой »

Схема армирования ленточного фундамента
шаг 400 435

Поз . | Обозначение | Наименование | Кол . | Масса ед .,кг | Приме -чание

Сборочные единицы

Продольный стык арматуры

1 | ГОСТ 34028-2016 | Арматура 12- А 500 С , м.п . | 580 | 0,89 | 515,04

2 | ГОСТ 34028-2016 | Арматура 8-A500 С L=335 | 546 | 0,13 | 72,25

3 | ГОСТ 34028-2016 | Арматура 8-A500 С L=960 | 364 | 0,38 | 138,03

4 | ГОСТ 34028-2016 | Арматура 8-A500 С L=2000 | 72 | 0,79 | 56,88

5 | ГОСТ 34028-2016 | Арматура 8-A500 С L=2000 | 15 | 0,79 | 11,85

Итого : | | | 794,05

Итого с запасом 10%: | | | 873,45

Материалы

ГОСТ 26633-2012 | Бетон B22,5 F200 W6 Битумная мастика | | | 27,2 м³ ГОСТ 32870-2014 286 кг

Формат А3 Инв .№ подл . Подп . и дата Взам . инв .№ Согласовано

Схема армирования углов 1000

Схема армирования Т -образных пересечений

Примечание :
1. Соединения арматуры выполнить вязальной проволокой по ГОСТ 3282-74.
2. Объем материалов дан без учета строительного запаса . 3. Снятие опалубки , монтаж плит и кладку стен вести не ранее , чем через 7 суток твердения бетона .

Индивидуальный жилой дом

Изм . Кол .уч | | Лист № док | | Подп . | Дата
Разраб . | Бирюков | | 02.24 | Коттедж | Стадия | Лист | Листов
Проверил | Дайненко | | 02.24 | | Р | 2

Схема армирования ленточного
