zip1982b/my_home/(list of files, drawings)

Other design files:
img/Backup_of_высоты.spl8
img/высоты.spl8
pdf/Backup_of_участок-дом.spl8
pdf/Backup_of_электричество.spl8
pdf/участок-дом.spl8
pdf/электричество.spl8
