zip1982b/my_home/(commit log)

2024-02-29 добавил файл ЖБИ заказ
    [ЖБИ заказ.xlsx, фундамент_дома.FCStd]
2024-03-09 добавил в эксель файл раздел Покупки, также добавил договор с Росссети Янтарь на техническое присоединение
    [6-131.FCStd, 6-131.xlsx, фундамент_дома.FCStd]
2024-03-10 добавил покупки в exel файл
    [6-131.xlsx]
2024-03-11 добавил freecad файл - держатель кнопки для линейки
    [держатель кнопки на линейки.FCStd]
2024-03-12 добавил рисунок Уровни пятна застройки
2024-03-16 добавил к покупкам бочку и трубы
    [6-131.xlsx]
2024-03-16 добавил держатель кнопки v2
    [держатель кнопки на линейки v2.FCStd]
2024-03-17 добавил файл - крепление для светильника
    [крепление_для_светильника.FCStd]
2024-03-21 добавил файл для расчёта арматуры
    [арматура.FCStd, держатель кнопки на линейки-Тело.stl, держатель кнопки на линейки-Тело2.stl]
2024-03-21 добавил Структуру001
    [арматура.FCStd]
2024-03-22 редактировал арматурный файлЭ
    [арматура.FCStd]
2024-03-24 edit арматура file
    [арматура.FCStd]
2024-03-26 edit арматура
    [6-131.xlsx, арматура.FCStd, держатель кнопки для линейкиPLA.3mf, держатель кнопки на линейки v2_PLA-Тело.3mf, держатель кнопки на линейки v3-Тело.3mf, держатель кнопки на линейки v3.FCStd, держатель кнопки на линейкиPLA.3mf, крепление_для_светильника-Тело.3mf]
2024-03-27 Арматурный расчёт
    [арматура.FCStd]
2024-04-06 пересчитал арматуру
    [6-131.xlsx, арматура.FCStd]
2024-04-07 добавил геотекстиль в покупки
    [6-131.xlsx]
2024-04-13 добавил покупки вёдра, доски, шурупы, доставка, гвозди
    [6-131.xlsx]
2024-04-19 добавили осб и гвози со свёрлами в закупки
    [6-131.xlsx]
2024-04-22 добавил садовую тачку + геотекстиль + петли + замок накидной в покупки
    [6-131.xlsx]
2024-04-29 добавил стоимость арматуры, фиксаторов и доставку до участка
    [6-131.xlsx]
2024-04-29 удалили ненужные файлы
    [ЖБИ заказ.xlsx, держатель кнопки для линейкиPLA.3mf, держатель кнопки на линейки v2.FCStd, держатель кнопки на линейки v2_PLA-Тело.3mf, держатель кнопки на линейки v3-Тело.3mf, держатель кнопки на линейки v3.FCStd, держатель кнопки на линейки-Тело.stl, держатель кнопки на линейки-Тело2.stl]
2024-05-02 добавил покупки
    [6-131.xlsx]
2024-05-06 добавил в покупки - доски и доставку
    [6-131.xlsx]
2024-05-08 добавил в покупки ОСБ 9мм и доставка
    [6-131.xlsx]
2024-05-09 добавил в покупки перчатки + шурупы
    [6-131.xlsx]
2024-05-11 добавил покупку досок 25х100х6000, гвозди 120 мм, шурупы по дереву 65 мм итд
    [6-131.xlsx]
2024-05-15 добавил расчёт колличества бетона
    [6-131.xlsx]
2024-05-23 добавил покупки - шуруповёрт
    [6-131.xlsx]
2024-06-02 добавил в покупки бензогенератор + масло моторное 1 литр
    [6-131.xlsx]
2024-06-09 добавил в покупки закладные в фундамент, шпильки и гайки)
    [6-131.xlsx]
2024-06-16 добавил в покупки, шпильки, трубы канализационные для закладных в ленту
    [6-131.xlsx, геометрия опалубки фундамента 11_06_24.FCStd]
2024-06-21 добавил в покупки песок, шпильки, удлинитель итд
    [6-131.xlsx]
2024-06-30 добавил в покупки - заливка бетона
    [6-131.xlsx]
2024-07-03 заказ для канализации и кровля времянки
2024-07-09 Добавил в покупки трубы канализационные и ПНД, однулин, биты, гвозди для ондулина
    [6-131.xlsx]
2024-07-31 добавил фото
2024-08-08 добавил покупку гравия, кельмы, фибры, кладочной сетки
    [6-131.xlsx]
2024-08-14 добавили гравий для бетона
    [6-131.xlsx]
2024-08-24 добавил в покупки отсечную гидроизоляцию
    [6-131.xlsx]
2024-08-24 добавил доставку с бауцентра
    [6-131.xlsx]
2024-08-31 добавил в покупки известь, диск, перчатки
    [6-131.xlsx]
2024-09-13 купил 10 мешков цемента
    [6-131.xlsx]
2024-09-21 добавил в покупки песок 4 машины + уголки и тройники канализационные
    [6-131.xlsx]
2024-09-29 добавил аренду трактора + трамбоки
    [6-131.xlsx]
2024-10-03 покупка песка - добавил в покупки
    [6-131.xlsx]
2024-10-10 плита
    [плита.FCStd]
2024-10-17 добавил в покупки плёнку полиэтиленовую 2х50 2 рулона...
    [6-131.xlsx]
2024-10-19 бетон для плиты
    [6-131.xlsx]
2024-11-03 add дом freecad file
    [дом.FCStd]
2024-11-03 добавил в покупки 4 ведра мастики
    [6-131.xlsx]
2024-11-10 house base model
    [6-131.xlsx, дом.FCStd, крыша времянки.FCStd]
2024-11-11 add ok3 in home project
    [дом.FCStd]
2024-11-12 add OK1 in home project (FreeCAD)
    [дом.FCStd]
2024-11-12 add OK2 in home proj (freecad)
    [дом.FCStd]
2024-11-12 add Door2 in home project (freecad)
    [дом.FCStd]
2024-11-12 add door3-1 (freecad)
    [дом.FCStd]
2024-11-12 add door3-2 (freecad)
    [дом.FCStd]
2024-11-12 add ok2-1 (freecad)
    [дом.FCStd]
2024-11-12 windows and doors
    [дом.FCStd]
2024-11-13 уровень крыши - 6585 мм
    [дом.FCStd]
2024-11-13 resize window OK-3
    [дом.FCStd]
2024-11-13 del freecad file 6-131
    [6-131.FCStd, дом.FCStd]
2024-11-19 fcad1 - добавил в таблицу data размеры проёмов дверей и окон, для удобства корректировки
    [дом.FCStd]
2024-11-19 внутр несущие стены
    [дом.FCStd]
2024-11-20 (freecad1) add lb wall d4
    [дом.FCStd]
2024-11-20 изменил таблицу размеров проёмов во freecad1
    [дом.FCStd]
2024-11-20 Дверь 4
    [дом.FCStd]
2024-11-20 (fcad1) добавил меж комнатные двери и сечение
    [дом.FCStd]
2024-11-21 добавил стены 150 мм
    [дом.FCStd]
2024-11-22 добавил межкомнатные стены и проёмы
    [дом.FCStd]
2024-11-25 добавил ось
    [дом.FCStd]
2024-11-26 добавил внутренние перегородочные стены
    [дом.FCStd]
2024-11-28 добавил окно на юг
    [дом.FCStd]
2024-11-28 testing windows
    [дом.FCStd]
2024-11-29 Ferrcad проём - каркас sketcher
    [дом.FCStd]
2024-11-29 окно
    [дом.FCStd]
2024-11-29 окно юг
    [дом.FCStd]
2024-11-29 Дверь входная
    [дом.FCStd]
2024-11-29 проверил стены на 375 блоке...стены выдвинулись за контур строения - вернул ширину внешних стен на 300 мм
    [дом.FCStd]
2024-12-02 freecad окно запад кухня
    [дом.FCStd]
2024-12-04 freecad - добавил окно заподное комната бабушки
    [дом.FCStd]
2024-12-05 freecad1 добавил в проект окна в детскую и родительскую
    [дом.FCStd]
2024-12-05 добавил окна в сан узле и тех помещении
    [дом.FCStd]
2024-12-06 create and edit door-window
    [дом.FCStd]
2024-12-06 fcad1 добавил окно-дверь в кухню гостинную
    [дом.FCStd]
2024-12-06 fcad1 - добавил ifc файл
    [дом.FCStd]
2024-12-11 добавил мп-1 и колону - поправил уровни
    [дом.FCStd]
2024-12-11 fcad1 - мп-1, мп-2, бм-1, колонна
    [дом.FCStd]
2024-12-12 добавил Beam 1 - балки перекоытия
    [дом.FCStd]
2024-12-13 fcad1 - добавил балки перекрытия 2
    [дом.FCStd]
2024-12-16 fcad1 - балка перекрытия 3
    [дом.FCStd]
2024-12-17 fcad1 - Добавил beam4
    [дом.FCStd]
2024-12-17 подсчёт объёма блоков - дома
    [6-131.xlsx, дом.FCStd]
2024-12-18 fcad1 - балки перекрытия 5,6,7
    [дом.FCStd]
2024-12-23 добавил арматуру в бм-1, 2
    [дом.FCStd]
2025-01-01 доработал МП-1 и МП-2 - добавил арматуру
    [дом.FCStd]
2025-01-02 добавил вент каналы на кухню и тамбур
    [дом.FCStd]
2025-01-03 fcad1 - добавил один ряд блоков в уровень крыши и МП-3
    [дом.FCStd]
2025-01-08 МП-3 прозрачность - 0
    [дом.FCStd]
2025-01-09 установка мауэрлата 1 и 2
    [дом.FCStd]
2025-01-10 добавил мауэрлаты
    [дом.FCStd]
2025-01-12 мауэрлат готов
    [дом.FCStd]
2025-01-13 поправил мауэрлат вровень со стеной
    [дом.FCStd]
2025-01-13 табурет
    [дом.FCStd]
2025-01-14 лежень
    [дом.FCStd]
2025-01-14 собрал табурет
    [дом.FCStd]
2025-01-20 установка боковых подпорок для стропильных ног
    [дом.FCStd]
2025-01-21 добавил на крышу стойки5 и лежени под них
    [дом.FCStd]
2025-01-22 сместил выход на чердак и добавил 100 блок-опалубку
    [дом.FCStd]
2025-01-26 уменьшил ширну дв2 (кухня), добавил ещё одно окно на юг
    [дом.FCStd]
2025-01-28 добавил окна на ЮГ
    [дом.FCStd]
2025-02-02 основа под вент блок
    [6-131.xlsx, вент блок.FCStd, дом.FCStd]
2025-02-06 начал привязку высот всех элементов дома
    [6-131.xlsx, дом.FCStd]
2025-02-09 привязываю выстоы, остался уровень крыши
    [6-131.xlsx, дом.FCStd]
2025-02-10 высоты
    [6-131.xlsx, дом.FCStd]
2025-02-10 высоты стен и элементов крыши согласованны, осталось согласовать высоты проёмов окон и дверей
    [6-131.xlsx, дом.FCStd]
2025-02-11 выставил высоты окон и дверей
    [6-131.xlsx, дом.FCStd]
2025-02-13 добавил разрез
    [дом.FCStd]
2025-02-13 вопрос на форум
2025-02-14 сфорулированны вопросы по поводу утепления крыльца
2025-02-21 подготовка к стропильной системе
    [6-131.xlsx, дом.FCStd]
2025-02-24 добавил 4 диагональных ноги на крышу
    [дом.FCStd]
2025-03-04 добавил проект уличного туалета
    [Туалет.FCStd]
2025-03-04 изменил размеры туалета
    [Туалет.FCStd]
2025-03-05 каркас низ
    [Туалет.FCStd]
2025-03-06 туалет каркас
    [Туалет.FCStd]
2025-03-07 добавил 2D чертежи
    [Туалет.FCStd]
2025-03-10 добавил покупки в таблицу, сформировал 2d план туалета
    [6-131.xlsx, Туалет.FCStd]
2025-03-13 добавил bim проект участка для расчёта столбов забора
    [участок - забор.FCStd]
2025-03-14 добавил столбы на восточную сторону
    [участок - забор.FCStd]
2025-03-17 добавил покупки в таблицу
    [6-131.xlsx]
2025-03-18 добавил 2d вид - план 1 этажа
    [дом.FCStd]
2025-03-19 экспортировал план 1 этажа в pdf
2025-03-19 вид Юг, вид Восток
    [дом.FCStd]
2025-03-20 Добавил вид Север и Запад - pdf
    [дом.FCStd]
2025-03-23 проверил размеры нашего проекта и покупного. Занёс измерения в таблицу
    [6-131.xlsx, дом.FCStd]
2025-03-24 изменил высоты 180 на 230 мм - толщина прирога пола
    [дом.FCStd]
2025-03-26 исправил файлы 2D размеров
    [6-131.xlsx, дом.FCStd]
2025-03-28 расчёт арматуры
    [6-131.xlsx, дом.FCStd]
2025-03-28 покупки - уровень и шнурка
    [6-131.xlsx]
2025-04-02 дбваил покупки - мастика, кельма, ковш
    [6-131.xlsx]
2025-04-05 добавил покупки - 15 мешков цемента с Леманапро, арматура, шнур и шпатель гребёнчатый 25 см
    [6-131.xlsx]
2025-04-06 добавил в покупки угольник Свенсона
    [6-131.xlsx]
2025-04-09 добавил конёк на крышу
    [6-131.xlsx, дом.FCStd]
2025-04-17 добавил одну стропильную ногу на крышу
    [дом.FCStd]
2025-04-19 редактировал файл план первого этажа
    [дом.FCStd]
2025-04-20 добавил 3 стропильные ноги
    [дом.FCStd]
2025-04-26 добавил покупки - колесо,перфолента, канализационные уголки
    [6-131.xlsx]
2025-04-27 добавил размеры в план 1 этажа
    [дом.FCStd]
2025-05-04 покупки - рубанок для газобетонна
    [6-131.xlsx]
2025-05-08 добавил в покупки проволоку вязальную и карандаши строительные
    [6-131.xlsx]
2025-05-13 добавил в покупки клей для газобетона 16 мешков
    [6-131.xlsx, дом.FCStd]
2025-05-17 добавил в покупки доставку газоблоков 300 - 8 паллет, съехали размеры в проекте - надо исправить
    [6-131.xlsx, дом.FCStd]
2025-05-19 добавилв покупки пилу макита 5008мг
    [6-131.xlsx]
2025-06-10 высоты стропил
    [дом.FCStd]
2025-06-18 добавил покупки в таблицу (триммер ... итд)
    [6-131.xlsx]
2025-06-22 добавил новый файл - шагающие леса
    [шагающие леса.FCStd]
2025-06-25 изменение высоты проёма окон
    [6-131.xlsx]
2025-06-27 изменение высот
    [6-131.xlsx, высоты.spl8, дом.FCStd]
2025-06-30 изменил высоту стяжки в проекте
    [6-131.xlsx, дом.FCStd]
2025-07-09 edit pdf
    [дом.FCStd]
2025-07-24 покупки и высоты
    [6-131.xlsx, высоты.spl8]
2025-07-24 изменил высоту стены и проемов
    [Backup_of_высоты.spl8, высоты.spl8, дом.FCStd]
2025-07-25 изменил высоту двери-окна на террасу в уровень с окнами
    [дом.FCStd]
2025-08-07 добавил вентканалы в комнатах
    [дом.FCStd]
2025-08-18 правка монолитного пояса (его размеры) и бм-1
    [дом.FCStd]
2025-08-23 добавил колону
    [дом.FCStd]
2025-09-08 расчёт бетона для мп1 и расчёт балок перекрытия
    [6-131.xlsx, дом.FCStd]
2025-09-14 бетон м300 5м3 с доставкой
    [6-131.xlsx]
2025-09-15 покупка + доставка бруса 100-200-6000
    [6-131.xlsx]
2025-09-16 добавил покупки в бауцентре и доставку грунта котлованного
    [6-131.xlsx]
2025-09-17 аренда трактора + доставка
    [6-131.xlsx]
2025-09-21 добавил покупки гвозди
    [6-131.xlsx]
2025-09-27 добавил покупки - гвозди 200 мм
    [6-131.xlsx, дом.FCStd]
2025-10-12 сохранил
    [дом.FCStd]
2025-10-19 добавил в покупкм - шпилька м16, гайки м16, проволока вяз
    [6-131.xlsx]
2025-10-19 покупка гайк и шайб М16
    [6-131.xlsx]
2025-10-25 добавил в покупки бетон для мп2, осб 15 мм итд
    [6-131.xlsx]
2025-11-07 добавил в покупки покупку дерева для строп системы крыши дома
    [6-131.xlsx]
2025-11-11 добавил покупки - рубероид 2 рул + отрезные диски + рулетка 5 м + кисть покрасочная
    [6-131.xlsx]
2025-11-14 добавил покупку сверла в таблицу
    [6-131.xlsx]
2025-11-23 добавил покупку - шайбы м16 -12 шт
    [6-131.xlsx]
2025-11-24 установил маузрлат (факт расположение на стройке)
    [дом_стропильная_система.FCStd]
2025-11-26 добавил стойки и лежни в стропильной системе
    [дом_стропильная_система.FCStd]
2025-11-27 добавил диагональные ноги в проект
    [дом_стропильная_система.FCStd]
2025-11-27 стропильные ноги + диагональные ноги
    [дом_стропильная_система.FCStd]
2025-11-29 сделал выстоу стоек 187 см для того чтобы угол ската крыши был 25 градусов
    [дом_стропильная_система.FCStd]
2025-11-29 не получилось с диагональными ногами
    [дом_стропильная_система.FCStd]
2025-11-30 поправил диагональные стопила
    [дом_стропильная_система.FCStd]
2025-11-30 добавил стропильных ног
    [дом_стропильная_система.FCStd]
2025-12-02 добавил виды 2D
    [дом_стропильная_система.FCStd]
2025-12-04 добавил в покупки гвозди 100, 90, уголки монтажные усил
    [6-131.xlsx]
2025-12-11 поправил виды 2D
    [дом_стропильная_система.FCStd]
2025-12-14 исправил запил на коньке на стропильных ногах
    [дом_стропильная_система.FCStd]
2025-12-15 исправил запил на диагональных стропилах
    [дом_стропильная_система.FCStd]
2025-12-16 добавил в папку pdf вид сверху стропила
    [дом_стропильная_система.FCStd]
2025-12-20 добавил южную сторону
    [дом_стропильная_система.FCStd]
2025-12-25 добавил в покупки саморезы конструкционные
    [6-131.xlsx]
2026-02-01 добавил проект навеса для машины в проект дома
    [car_port.FCStd]
2026-02-02 выдавливание
    [car_port.FCStd]
2026-02-08 добавил электрическую схему ВРУ, добавил таблицу в excel файл - розетки в доме
    [6-131.xlsx, Backup_of_электричество.spl8, электричество.spl8]
2026-02-11 добавил клонов но не переместил их
    [car_port.FCStd]
2026-02-14 добавил сравнительную инфу, по ценам на электротовары
    [6-131.xlsx]
2026-02-18 modif car_port project
    [car_port.FCStd]
2026-02-21 project car port is complite
    [car_port.FCStd]
2026-02-23 доработал электрическую схему для вру уличного шкафа
    [Backup_of_электричество.spl8, электричество.spl8]
2026-02-23 добавил в таблицу покупки
    [6-131.xlsx]
2026-02-26 добавил стропило диагональное 6 м для масштаба
    [дом_стропильная_система.FCStd]
2026-03-03 добавил в таблицу покупку фена строительного
    [6-131.xlsx]
2026-03-05 диагональное стропило одно
    [дом_стропильная_система.FCStd]
2026-03-11 расчёт вентиляции и дымохода
    [6-131.xlsx, дом_стропильная_система.FCStd]
2026-03-21 добавил в проект freecad вентканалы - вытяжка и приточка для горения и выхлопная трубка для отвода дымовых газов
    [дом_стропильная_система.FCStd]
2026-03-22 стропила на восточной стороне
    [дом_стропильная_система.FCStd]
2026-03-28 freecad11 - добавил стропила на юг
    [дом_стропильная_система.FCStd]
2026-03-31 измерил стропила 655
    [дом_стропильная_система.FCStd]
2026-04-02 добавил вынос границ зем участака
    [6-131.xlsx]
2026-04-06 добавил фото материалов к покупке
2026-04-08 добавил в таблицу покупок покаупку кабелей и изоспан d
    [6-131.xlsx]
2026-04-13 внёс в таблицу покупок данные
    [6-131.xlsx]
2026-04-17 сделал расчёт дерева на крышу - обрешётка итд
    [6-131.xlsx, дом_стропильная_система.FCStd]
2026-04-17 добавил расчёт дерева на крышу
    [6-131.xlsx]
2026-04-21 добавил в покупки доски на обрешётку
    [6-131.xlsx]
2026-05-03 покупка гвоздей на стройку в бауцентре
    [6-131.xlsx]
2026-05-06 добавил в покупки - покупку досок
    [6-131.xlsx]
2026-05-08 добавил в таблицу, покупки
    [6-131.xlsx]
2026-05-21 добавил план этажа перегородки
    [дом_стропильная_система.FCStd]
2026-05-28 в таблицу внёс покупки (металочерепица)
    [6-131.xlsx]
2026-06-01 внёс в таблицу покупку металлочерепицы
    [6-131.xlsx]
2026-06-03 покупки
    [6-131.xlsx]
2026-06-06 добавил в покупки трубу из нерж стали 0.25м
    [6-131.xlsx]
2026-06-07 двери и окна
2026-06-10 дверной проём и стандартная дверь входная
    [6-131.xlsx, дом_стропильная_система.FCStd]
2026-06-11 входная дверь и перемычка
    [дом_стропильная_система.FCStd]
2026-06-14 L уголок для двери
    [дом_стропильная_система.FCStd]
2026-06-20 осб листы раскладка и покупки
    [6-131.xlsx, дом_стропильная_система.FCStd]
2026-06-22 доставка ОСБ
    [6-131.xlsx]
2026-06-23 раскладка осб - поперёк
    [дом_стропильная_система.FCStd]
2026-07-09 редактирование эл схемы
    [Backup_of_электричество.spl8, электричество.spl8]
2026-07-10 редактировал электросхемы
    [Backup_of_электричество.spl8, электричество.spl8]
2026-07-14 покупки материалов для утепления цоколя, покупка окон, кадастровые работы
    [6-131.xlsx]
2026-07-19 цоколь работы в таблицу
    [6-131.xlsx]
2026-07-20 добавил в электросхему РКН, добавил покупки
    [6-131.xlsx, Backup_of_электричество.spl8, электричество.spl8]
2026-07-21 add file дом-участок spl
    [Backup_of_участок-дом.spl8, участок-дом.spl8]
2026-07-24 расчёт пенопласта
    [6-131.xlsx, дом_стропильная_система.FCStd]
2026-07-25 регистрация дома - изменение размеров
2026-07-27 покупки - пенопласт
    [6-131.xlsx]
2026-08-02 покупки и электрика автоматы
    [6-131.xlsx, Backup_of_участок-дом.spl8, Backup_of_электричество.spl8, электричество.spl8]
2026-08-03 электрика и покупки
    [6-131.xlsx, Backup_of_электричество.spl8, электричество.spl8]
2026-08-05 электрические схемы
    [Backup_of_электричество.spl8, дом_стропильная_система.FCStd, электричество.spl8]
2026-08-08 расчёт электрики и отопления
    [6-131.xlsx, Backup_of_электричество.spl8, дом_стропильная_система.FCStd, электричество.spl8]
2026-08-10 покупка фасадной штукатурки
    [6-131.xlsx]
2026-08-12 покупка водоотлива
    [6-131.xlsx]
2026-08-16 утепление тубы
    [Утепление трубы дома.FCStd, труба_вентиляция.FCStd, утеплитель Технониколь Роклайт 50 боковая часть добор.FCStd, утеплитель Технониколь Роклайт 50 фронтальная часть добор.FCStd, утеплитель Технониколь Роклайт 50 фронтальная часть.FCStd, утеплитель Технониколь Роклайт 50.FCStd]
2026-08-21 утепление фасада в таблицу
    [6-131.xlsx]
2026-08-31 дымник
    [Утепление трубы дома.FCStd, дымник для тубы.FCStd, каркас.FCStd, стройка для дымника.FCStd, труба_вентиляция.FCStd]
2026-09-04 расчёт
    [6-131.xlsx]
2026-09-07 покупка кабелей
    [6-131.xlsx, Backup_of_электричество.spl8]
2026-09-10 покупка трубы для отопления
    [6-131.xlsx]
2026-09-16 двери межкомнатные
    [6-131.xlsx, дом_стропильная_система.FCStd]
2026-09-24 add 2D file
    [floor_plan.dxf, дом_стропильная_система.FCStd, план2D.FCStd]
2026-09-25 plan 2D
    [план2D.FCStd]
2026-09-25 мебель на плане этажа
    [план2D.FCStd]
2026-09-27 2D Plan
    [план2D.FCStd]
2026-10-02 покупки (болгарка)
    [6-131.xlsx]
2026-10-03 метал для трубы
    [6-131.xlsx, Безымянный.FCStd, Утепление трубы дома.FCStd, дымник для тубы.FCStd, каркас.FCStd]
2026-10-09 покупка металопластиковой трубы
2026-10-11 план 2D - кухня и санузел; покупка котла
2026-10-17 покупки и дымник
2026-10-21 выравнивание участка
2026-10-23 профиль на утепление труба
